guiwushengzhe-prog/gun-mouse/README.md

# 枪型飞鼠 · 第二代工程样机

当前配套交付为 `release/2026-10-18-最终版`。主板已迁移到嘉立创EDA专业版，后续统一在嘉立创中编辑、铺铜、检查和导出。

- 当前主板源工程：[嘉立创最终版](pcb/嘉立创最终版/枪型飞鼠最终版.eprj3)，打开时保留整个同名文件夹。
- 当前打板文件：[最终版上传打板压缩包](release/2026-10-18-最终版/枪型飞鼠_最终版_上传打板.zip)，由嘉立创原生工程导出。
- 当前打印件：[主体底座](release/2026-10-18-最终版/三维打印/主体底座.stl) 和 [摇杆支座](release/2026-10-18-最终版/三维打印/摇杆支座.stl)，各一件。
- 详细步骤：[下单与装配说明](release/2026-10-18-最终版/下单与装配说明.md)。原生工程、制板文件和打印件一并保存在最终交付目录。

下面保留早期第二代样机的设计说明；其中旧源文件和旧下单链接不再代表当前交付。

ESP32-S3 SuperMini、手焊载板和一件开放固定底座。使用手头的 SS-01GL 金属摆杆作左键，右键直接按微动本体，摇杆使用原生杆并保留中键。手指接触摆杆上的绝缘铜箔时启用体感移动，松开即停止。

第二代修正 SW1 的整组非对称孔位，保持摇杆轴心；增加直接焊在载板上的电源拨动开关，电池两根线也直接焊载板。取消塑料扳机、外置复位弹簧、调节螺丝、摇杆帽、外壳摇杆限位和粗握把。握持形状先用纸壳试，不额外打印握把。

| 目录 | 当前交付 |
|---|---|
| [pcb/](pcb/README.md) | 第二代载板：52×82 毫米、1.6 毫米厚、双面、全直插手焊；制板包、源工程、物料与接线表、1:1 套孔图、[三维预览](pcb/3d/gun-mouse-gen2.obj) |
| [shell/](shell/README.md) | 一件开放固定底座，电池与模块允许外露；手头右键帽原尺寸保留为可选件 |
| [firmware/](firmware/README.md) | 原固件与已编译镜像，鼠标按键、触摸许可和体感逻辑不变 |

## 下单与装配

1. 先将 [1:1 装配图](pcb/carrier-assembly-map-1to1.pdf) 按实际尺寸打印，用手头 SW1 从标示的安装面套孔。此次修正依据原厂孔图与第一代实物反馈，尚未进行第二代实物插装。
2. 上传 [第二代嘉立创制板包](pcb/gun-mouse-supermini-carrier-JLC-Gerber.zip)。常规 FR-4、双面、1.6 毫米、1 盎司铜；只做裸板，不做贴片装配。板框有缺口，以文件轮廓为准。
3. 只需新增打印 [开放底座](shell/stl/engineering_mount.stl)，毫米、100% 比例。手头旧小件不用重新打印；右键帽可留作后续手感试验。
4. 按 [载板说明](pcb/README.md) 焊元件与模块线，电池开关置关后通过 USB 烧录并检查，再固定到底座。SS-01GL 的公共端、常开端仍用两根软线接载板。
5. 金属摆杆上依次贴薄绝缘胶带、铜箔、表面绝缘胶带。铜箔只连接触摸焊盘，导线不牵拉摆杆；贴好后实测触摸和回弹。电池、模块固定及供电限制见 [底座装配说明](shell/README.md)。

## 版本与验收范围

当前目录只列第二代交付，第一代保存在 Git 提交 `9e3d071` 中。电路设计检查、名义几何检查与实物试装、通电验收分别记录，不能用软件检查代替摇杆实物插装、触摸灵敏度、充电和握持验收。
