guiwushengzhe-prog/gun-mouse/器件资料/README.md

# 器件资料索引

整理日期：2026-10-05。用户提供的两个资料包已完整解压，根目录原压缩包保留。

## 保存位置

| 目录 | 内容 |
| --- | --- |
| `原始资料/YD-ESP32-S3资料` | ESP32-S3 资料包原始目录，包含尺寸图、电路图、介绍和下载工具 |
| `原始资料/GY-601N1` | 模块说明、电路图、多个芯片手册及示例代码，保留包内原目录 |
| `参考图纸/ESP32-S3` | 公制及英制尺寸图、V1.4 电路图、三张厂家介绍/照片 |
| `参考图纸/GY-601N1` | 模块说明书、电路图及本版 LSM6DSV16X 芯片手册 |

原始解压资料共 564 个文件，约 118.5 百万字节。压缩包和原始解压目录留在本机，常用图纸、此索引、来源清单和设计配置纳入 Git（版本控制系统）。`资料来源.json` 记录原包及参考副本的 SHA-256（文件内容校验值），便于辨别来源和后续变更。整理只读取资料，未运行包中下载工具或向设备写入。

## 查尺寸先看这些文件

| 文件 | 可直接采用的资料尺寸 | 当前边界 |
| --- | --- | --- |
| `参考图纸/ESP32-S3/ESP32-S3-公制尺寸图.pdf`，第1页 | 主板57.15×27.94毫米；含伸出天线总长63.39毫米；排针行距25.40毫米 | 未给高度、独立安装孔或完整修订号；与手上板版本待匹配 |
| `参考图纸/ESP32-S3/ESP32-S3-英制尺寸图.pdf`，第1页 | 与公制图换算一致 | 英制标注不能当毫米直接读；孔径仍未给出 |
| `参考图纸/ESP32-S3/YD-ESP32-S3-电路图-V1.4.pdf` | 供电、接口及各元件连接 | 不能用电路符号位置推导机械位置；旧尺寸图局部封装与V1.4有差异 |
| `参考图纸/GY-601N1/GY-601N1-模块说明书.pdf`，第1～2页 | 标称17.8×20.6×2.8毫米；整板3～5V；模式与引脚 | 没有机械孔位和焊好排针后的总高；200次/秒描述板上角度输出 |
| `参考图纸/GY-601N1/GY-601N1-电路图.png` | 稳压及多个传感器版本的接口 | 不是尺寸图，不能从图上推算孔或板边 |
| `参考图纸/GY-601N1/LSM6DSV16X-芯片手册.pdf` | 当前惯性芯片参数与封装 | 芯片尺寸不等于整板尺寸；包内其他传感器不是本版选型 |

正式建模轴方向已确认：X 向前、Y 向左、Z 向上，单位毫米；原点在整体布局时统一确定。名义尺寸和实物测量分开保存。未知整板高度、接线、插头及孔位不补写猜测数据。

普通 PS2 摇杆、TTP223 模块、700mAh 电池、充电升压板没有仅凭这些名称就能套用的统一整件尺寸；芯片、针距和插口标准不能代替整件资料。SS-01GL 则有完整型号的原厂轮廓图，可以按图做名义候选件，最终支架仍须匹配实物后缀。

当前低成本触摸原型采用 SS-01GL、铜箔电极和 ESP32-S3 内置电容触摸，省去 TTP223；机械左键与触摸是独立输入。本轮内部图先按小打印帽内贴铜箔探索，制造结构尚未冻结。详细来源、待测项和方案判断见 `../docs/器件参数与待实测清单.md`。
