guiwushengzhe-prog/gun-mouse/deliverables/经济型单板自焊版/README.md

# 枪型飞鼠：单板经济型，扳机开关自焊

这是本轮推荐询价版本，替代相邻的 `经济型工厂代焊版`。相对那一版有六处改动：

1. **取消扳机小板，只做一款主板**，省掉第二款的多款板费。扳机开关 SS-01GL 改为你自购，焊两根线后装在打印支架上，支架插进原小板卡槽。
2. **充电灯 LED1/R4 恢复安装。** 充电状态输出只接这颗灯，主控读不到；两套只多约 1.2 元。
3. **充电电阻 R3 改为 5.1k**，与 R1/R2 同料，少一种物料；充电电流从约 176mA 提到约 235mA，700mAh 电池充满从约 4 小时缩短到约 3 小时。首件要测充电温度，见下文。
4. **USB 静电保护 U4 不装。** 免换料的 SRV05-4 国内库存不够，不为它多花 20 元。板上 D+、D− 原本就有铜线把 U4 的 1–6、3–4 脚连通，不装时 USB 充电和下载照常；代价是 USB 口没有静电保护，插线前先摸一下金属物体放掉身上的静电。以后想加，把原设计的 USBLC6-2SC6（C7519）焊到同一位置即可。
5. **扳机调节触点改用市售 M2×10 内六角圆柱头螺钉**（原 M2 外六角螺栓电商难买），用 1.5 毫米内六角扳手调节。扳机的螺钉头槽和导孔已相应修改。全机螺丝统一为 M2×10、M2×20 两种杯头内六角。
6. **三个 PH2.0 插座 J3/J4/J5 不装**，电池、扳机开关、触摸电极的线直接焊到原焊盘上。三个座是同一种扩展料，全部不装才能省掉一种 20 元的换料费。网购电池一般自带两根裸线，直接焊比另接 PH 插头省事，也不会遇到插头正负极与板子相反的问题。

主板铜线、过孔、焊盘和外框与之前的单主板研究版 v2 逐层一致，没有改布线。固件未改。

规则检查和三维配合检查属于文件验证；开关动作、打印公差、模块通信、充电温升和蓝牙效果还要靠首件验证。经济型能否接单、实际价格，以新订单匹配和审核结果为准。

## 上传这三个文件

只用本目录 `制板文件` 中的文件新建订单，不要套用旧订单的生产稿：

1. `gun-mouse-economy-single-v4-Gerber.zip`：制板文件，只有主板一款。
2. `gun-mouse-economy-single-v4-BOM.csv`：物料清单，每套 19 组、36 个工厂安装器件。
3. `gun-mouse-economy-single-v4-坐标文件.csv`：对应安装位置与角度。

两个 CSV 沿用设计软件输出的 UTF-16 制表符格式，直接上传，不要用表格软件重新保存。

| 网页项目 | 怎么填 |
| --- | --- |
| PCB | 2 层、1.6 毫米、普通 FR-4、绿油白字、普通铜厚与表面处理 |
| 款数/拼板 | **单款单板**，铣外形及内部过线槽，**不要 V 割**，不要加扳机小板 |
| 焊接数量 | 其他数量：2 套（此前页面显示最低 2），其余光板随单发货 |
| 焊接层 | 只贴顶层 |
| 应用行业 | 消费电子 |
| 产品类型 | 选经济型；若经济型不可选，不付款、不生产，先按提示查具体器件或工艺原因 |
| 生产时间 | 普通交期，不加急 |
| 确认 DFM | 可保留 3 元可制造性确认 |
| 个性化服务 | 无；不买整盘，不加喷涂、灌胶或程序烧录 |

匹配物料时重点看两处：

- **LED1** 会提示"封装与 0603 不符"：BOM 里的 `LED-SMD_L1.6-W0.8` 就是 1.6×0.8 毫米，即 0603，确认即可；颜色选红色。
- **R3** 应与 R1、R2 同为 5.1kΩ / C25905，三个位号合成一行。

可粘贴到订单中的备注：

> 本单为单款主板，铣外形及内部过线槽，不做V割，不含扳机小板。申请经济型、只焊顶层，按物料和坐标安装每套36个器件。U1、R10、R11、R12、C7、C8、J3、J4、J5、U4不装。J1/J2排母、SW1摇杆、SW2右键及USB1固定脚完整焊接。扳机开关、陀螺仪模块、电池和触摸线由用户自行焊接。如经济型不能接，请注明具体器件或工艺原因，并列出费用明细。

## 费用怎么变

和你此前两套标准型报价逐项对比。本版一栏按 2026-10-07 下单页实际报价（删除 U4 前元件费 41.75、加工费 147.2）减去 U4：

| 报价项目 | 原报价，元 | 本版，元 | 说明 |
| --- | ---: | ---: | --- |
| 工程费 | 150 | 50 | 经济型工程费 |
| 拼板费 | 150 | 0 | 只剩一款主板 |
| 换料费 | 168 | 60 | 原为标准型 8 元/种 × 21 种贴片料；经济型基础库免费，只剩 USB1、U3、SW3 三种扩展料各 20 元；U2 实际免换料 |
| 钢网费 | 50 | 0 | 经济型不收 |
| X 光检查 | 20 | 0 | 原 U1 已不装，实际报价没有这一项 |
| 包装费 | 3.07 | 0 | 经济型不收 |
| 贴片焊盘费 | 2.8 | 1.88 | |
| 插装焊盘费 | 12.8 | 12.2 | 穿孔焊点 0.1 元/点，每套 61 点；扳机开关改自焊，少 6 个焊点 |
| 插装工程费 | 20 | 20 | 有穿孔插件就每单收一次 |
| 确认 DFM | 3 | 3 | |
| **加工费小计** | **579.67** | **147.08** | |
| 元件费 | 172.54 | 约 41 | 实际 41.75，删 U4 后略降 |
| **合计** | **752.21** | **约 188** | 工程费、拼板费、换料费三项从 468 降到 110；另有可选的氮气焊接 5.2 元，不需要 |

以上只是 SMT 订单。光板费在先下的 PCB 订单里另算。

插装焊接工程费和插装焊盘费是给穿孔插件收的：开发板两排 22 针排座、摇杆、右键，以及 Type-C 座的 4 个固定脚。要省这 32.2 元，只能这些全部自己焊、自己买料，对新手不划算，所以保留。

下单前按公开经济型规则做的推算明细（加工费与实际报价一致，元件费实际更低）：

| 项目 | 推算，元 |
| --- | ---: |
| 器件：原两套 172.54 − U1 41.86 − 原 SW4 62.60 − R10/R11 0.33 − J6 2.91 − J3～J5 8.72 | 56.12 |
| 工程费 | 50 |
| 普通扩展贴片料上料：USB1、U3、SW3 三种 × 20 | 60 |
| 插件工程费 | 20 |
| 插件焊点 61 个/套 × 2 × 0.1 | 12.20 |
| 贴片焊点 94 个/套 × 2 × 0.01 | 1.88 |
| 可制造性确认 | 3 |
| 多款板费 | 单款，0 |
| **合计** | **约 203** |

另需自购：SS-01GL 两只约 5～9 元，M2 杯头内六角螺丝与螺母约 10～20 元，细导线一卷。不再需要 PH2.0 线。光板、打印、运费、可能的 X 光检查另计。

和工厂代焊小板版（恢复充电灯后约 314～364 元）比，本版约少 **100～155 元**。主要来自多款板费 50～100 元；J3～J5 和 U4 不装省换料费 40 元和座子约 9 元；另有开关代焊约 9 元、J6 约 3 元；扣掉自购开关约 5～9 元。明细见 `检查报告/费用推算-单板自焊.json`。

下单页实际换料费 60 元，说明 U2（TP4056）免换料。

## 充电电流 235mA 的首件检查

TP4056 是线性充电，芯片发热约等于（5V − 电池电压）× 电流。5.1k 时，电池 3.3V 约 0.40W、3.8V 约 0.28W；6.8k 时分别约 0.30W 和 0.21W。700mAh 电池按 235mA 充约 0.34C，在常规 0.5C 以内。

需要注意的是，主板没有铺铜，充电芯片离电池约 2 毫米，电池温度检测也没有接。所以首件必须按下面的方法测一次温度：

1. 用电量较低的电池（3.5V 左右），合好外壳，插 USB 充电。
2. 充 20～30 分钟后，测电池外表面和充电芯片附近外壳的温度。
3. 电池表面不超过 40℃ 即可正常使用。超过 40℃ 时停止充电，把 R3 换回 6.8k（0402 电阻），或在外壳打开、通风良好的情况下充电。

## 外壳和到手装配

`打印文件` 中的 STL 用于打印，STEP 用于改尺寸。要用本目录的 **左半壳-单板自焊、右半壳-单板自焊、扳机-经济型、扳机开关支架-SS01GL**，以及 GY 模块压框、右键帽、触摸面盖、摇杆帽和三片设定片。不要用工厂代焊版的左右壳：那两件的卡槽前移了 1.9 毫米，插不进支架。

建议用 PETG，0.4 毫米喷嘴、0.2 毫米层高。支架卡板面朝下打印，4 圈壁，凸台附近实心。半壳约 180×139 毫米，平台至少 200×150 毫米。设定片打印后量厚度，误差控制在 ±0.05 毫米以内。

要另备的螺丝已统一成同一种：**M2 杯头内六角（GB70.1 / DIN912）**，只要两种长度，可以在同一家一次买齐（下表是每套用量）：

| 规格 | 每套数量 | 用在哪 |
| --- | ---: | --- |
| M2×10 杯头内六角 | 3 | 扳机调节触点 1、GY 模块压框 2 |
| M2×20 杯头内六角 | 9 | 合壳 7、开关支架 2 |
| M2 六角螺母 | 2 | 开关支架 |
| 1.5 毫米内六角扳手 | 1 | 以上螺丝通用 |

选头径不大于 4 毫米、头厚不大于 2 毫米的，304 不锈钢或碳钢均可。外壳和压框上的螺丝孔是 Ø1.7 导孔，M2 机牙螺丝直接拧进去自攻：第一次会比较紧，拧到贴合、不晃即可，不要用力过猛，以免把塑料螺纹拧滑。

其他要另备：

- 扳机：SS-01GL 1 只；压缩弹簧 1 根（外径 4、线径 0.3、自由长 15 毫米，可搜"压缩弹簧 外径4 线径0.3 长15"）；铜箔胶带一小块（贴在扳机前面的凹槽里做触摸电极）。
- 导线：细硅胶线一卷（外径不大于 0.6 毫米，例如 30AWG，约 1 米）。GY 模块 4 根加 1 根短接线、扳机开关 2 根、触摸电极 1 根，都用这一卷。
- 电池：3.7V 锂电池，**带保护板**，自带两根线即可，不需要 PH 插头。
- 辅料：热缩管、细扎带、绝缘胶带少量。

电池连保护板和线头须小于 31×52.5×8.4 毫米的仓体并留间隙。扳机弹簧工作长度约 13.1～9.0 毫米，压到底不能并圈顶死。

主板上要焊的都在主板放进外壳**之前**焊好，焊接时开发板不插，USB 不插，电源开关 SW3 拨到关。

1. 焊扳机开关：两根细导线焊到 SS-01GL 的 COM 和 NO，NC 不接。用螺钉把开关固定在支架上，注意摆杆自由端朝支架底部。详细步骤和示意图见 `扳机装配与调整.md`。
2. 焊 GY 模块：模块四根线和一根地址短接线，接法见下表和 `GY模块适配说明`。
3. 焊扳机开关线到 **J4**：J4 不装插座，留下两个长条焊盘，两根线各焊一个，不分正负。线长要够，调螺钉时支架还要能提起来。
4. 焊触摸电极线到 **J5**：J5 的两个焊盘是同一个信号，焊任意一个即可。
5. 最后焊电池到 **J3**，按下面的"焊电池"步骤做。
6. 右壳内依次装电池、支架、弹簧、扳机、主板。电池线从主板的电池过线槽穿过。
7. 合壳前按 `扳机装配与调整.md` 用 0.8/1.0/1.2 毫米设定片调整触点。
8. 取出设定片，装右键帽、模块压框、左壳、摇杆帽，合壳后再查一次：按到底导通、松开复位。

**焊电池（J3）**。锂电池两根线一旦碰在一起就会短路，所以每一步只处理一根线：

1. 先分清 J3 的正负极：万用表打到导通档，两个长条焊盘里，和 USB 口金属外壳导通（会响）的是**负极**，另一个是**正极**。用记号笔在板上标出来。
2. 电池通常红线为正、黑线为负。用万用表直流电压档再确认一次：红表笔接红线、黑表笔接黑线时，读数应为正的 3～4.2V。
3. 先给 J3 的两个焊盘各上一点锡。
4. 电池线要剪短时，**一次只剪一根**，不要用剪刀同时剪两根。剪好的线头先用胶带包住，焊哪根再拆哪根。
5. 先焊负极线：剥 2 毫米、上锡，贴在负极焊盘上，烙铁加热 2～3 秒焊好。再用同样方法焊正极线。烙铁不要在焊盘上停太久，以免焊盘翘起。
6. 焊好后电池线用扎带或一点热熔胶固定在过线槽附近，不要让线拉扯焊盘。
7. 把电源开关拨到开：插上开发板后，开发板电源灯应亮。

| 主板 J1 背面通孔 | 模块芯片接口 | 含义 |
| --- | --- | --- |
| 1 脚 | 1 脚 VCC | 3.3V |
| 22 脚 | 2 脚 GND | 地 |
| 15 脚 | 3 脚 SCL | 时钟，IO9 |
| 12 脚 | 4 脚 SDA | 数据，IO8 |
| — | 5 脚 SA0 短接 2 脚 GND | 地址 0x6A |
| — | PS 模式脚悬空；CS 保持模块原上拉 | 使用芯片直接接口 |

模块自带总线上拉和本地滤波，所以主板 U1、R10、R11、R12、C7、C8 都不装，也不需要补焊。

## 使用逻辑保持原样

固件未改：

- 手指轻贴扳机启用体感移动，不触发点击。扣扳机为左键按下，扣住保持，松开释放。
- 松开机械扳机但手指仍贴着时，体感继续；手指离开后体感停止并清除积压。
- 侧键是右键，摇杆按下是中键，推摇杆移动光标，幅度越大越快。摇杆和体感位移相加。
- 插拔充电线不会自动暂停鼠标操作。
- 插 USB 充电时，充电灯亮表示正在充电，灯灭表示已充满。
- U4 没装，USB 口没有静电保护：插线前先摸一下金属物体，干燥季节尤其注意。

首次使用：

1. 单独给开发板烧录 `固件/gun_mouse.ino.merged.bin`，Windows 用原烧录工具写到地址 0x0。
2. 把开发板插回主板。上电时手指离开触摸面、摇杆回中，放稳约 3 秒自动校准。
3. 电脑蓝牙添加 **GunMouse EVT-A**。
4. 方向、速度或触摸门限需要调时，用串口命令 `log`、`jdir/jsave`、`invx/invy`、`sens`、`tp/tr`。

开发板插在主板上时，不要同时从开发板自己的 USB 口供电。

## 已核对和仍需首件确认

`检查报告` 中保存了以下核对结果：

- **电路板**：U1、R10、R11、R12、C7、C8、J3、J4、J5、U4 不装；原理图与电路板的器件身份、通道关联、不装属性、料号逐件一致；46 个器件的引脚网络与正式板逐脚一致；规则检查 0 项；Gerber 与单主板 v2 逐层图形一致。
- **扳机与外壳**：支架、开关、螺钉、尾线与左右壳及主板无实体干涉；扳机全行程和调节螺钉全调节范围无碰撞；支架合壳后六向限位。
- **左壳**：与已通过 GY 模块适配检查的左壳为同一实体。
- **固件**：与原工程样逐文件一致。

文件核对不能代替实物验收。首件重点确认：

- 开关动作和复位、支架入槽与打印配合；
- 模块通信和方向、触摸门限；
- USB 插拔、**充电温度（R3 已改 5.1k）**、蓝牙效果。

主板原有的 USB 长走线、无铺铜、电池温度检测未接等限制仍然存在。
