guiwushengzhe-prog/gun-mouse/deliverables/pcb-shell-v1/README.md

# 枪型飞鼠 PCB 与外壳 V1：交付说明

日期：2026-10-05；装配分工补充：2026-10-06。设计说明和改动理由见 `docs/PCB与外壳-V1.md`；全部尺寸与网络来自 `config/pcb-shell-v1.json`。采购与工厂询价使用 `docs/工厂装配与交付要求-V1.md`，里面逐项覆盖本版 48 个板上器件和板外组件。

本交付用于首轮打样，以完整装配和尽量少手工焊接为目标。文件检查不能保证首轮打印一次装配成功，也不代表可直接量产；开发板、电池、打印公差、扳机动作和工厂装配范围仍需核对。原设计保留在 `claude/pcb-shell-v1`；本轮收尾在独立分支 `codex/pcb-shell-finish`，以基线 `dff2043` 保留原成果。

2026-10-06 预审已确认当前扳机/右键的固定行程缺少覆盖全公差的保证，USB 数据线也需重新布局。下单前先按 `docs/设计预审与优化决策-V1.md` 关闭这些设计问题，不能只因以下软件检查通过就认为整机方案已定稿。局部改件候选单独保存，没有覆盖本目录原六件打印包。

## 目录

| 位置 | 内容 |
| --- | --- |
| `制板文件/gun-mouse-v1-Gerber.zip` | 嘉立创下单用 Gerber（主板与扳机小板拼在一起，邮票孔连接） |
| `制板文件/gun-mouse-v1-BOM.csv` | 贴片/插件器件清单（含立创编号） |
| `制板文件/gun-mouse-v1-坐标文件.csv` | 贴片坐标（CPL） |
| `制板文件/gun-mouse-v1-网表.enet` | 网表（连接关系） |
| `打印文件/STL/` | 6 个打印件，已按推荐打印姿态摆好 |
| `打印文件/STEP/` | 同样 6 个零件的实体文件（整机坐标） |
| `整机装配/枪型飞鼠整机装配.step.zip` | 整机装配实体（解压后约 100MB）：外壳、机构件、主板（含器件模型）、扳机小板、开发板与电池参考体 |
| `检查报告.md` | 规则检查、校验值、干涉与限位检查（自动生成） |
| `验证记录/` | 收尾时的规则检查、网表核对、实体网格、原设计比较和文件校验记录 |
| `预览图/` | 离屏渲染的检查图 |
| 仓库 `pcb/gun-mouse-v1/` | 嘉立创专业版工程（PCB 与同网表原理图），可直接打开 |

## 一、要打印的零件（6 件）

| 零件 | 文件 | 摆放 | 说明 |
| --- | --- | --- | --- |
| 左半壳 | `左半壳.stl` | 外表面朝下 | 摇杆开口、右键开口、压板螺柱 |
| 右半壳 | `右半壳.stl` | 外表面朝下 | 主板螺柱与沉头孔、电池仓、扳机小板卡槽、扳机滑道 |
| 扳机 | `扳机.stl` | 侧面朝下 | 滑杆后部有弹簧孔，前面有铜箔凹槽 |
| 扳机触摸面盖 | `扳机触摸面盖.stl` | 平躺 | 0.9 毫米薄片，盖在铜箔外面 |
| 右键帽 | `右键帽.stl` | 帽面朝下 | 翻边悬垂 1.4 毫米，一般无需支撑 |
| 摇杆帽 | `摇杆帽.stl` | 帽面朝下 | 双削边孔（Ø4.2、对边 3.2，匹配 Ø4/对边 3.0 的轴）竖直朝上，尺寸更准 |

建议 PLA 或 PETG，0.4 毫米喷嘴，层高 0.2，3 圈壁，填充 20%。两半壳打印尺寸约 180×139 毫米，需要 ≥ 200×150 的打印平台。半壳边缘是半径 6 的圆角，贴床的那几层略有悬垂，一般不加支撑也能打印；底部 Type-C 口和开关槽在竖直壁上，顶边是几毫米的小桥接。摇杆帽孔偏紧或偏松时，改 `config/pcb-shell-v1.json` 里的 `joystick.knob.d_hole_clearance` 后重新生成，只需重打帽子。

## 二、要购买的东西

### 1. 嘉立创（PCB + 贴片 + 插件）

- 上传 `gun-mouse-v1-Gerber.zip`：2 层、1.6 毫米、1oz（每平方英尺一盎司铜）、绿油白字。当前文件含主板和扳机小板，两款电路用两处邮票孔拼在一起；如制作 5 个现有拼板，可得到 5 套主板与小板。实际焊接套数另行选择。按工厂确认填写拼板与款数，不能因为连成一块就省报第二款。[嘉立创制造工艺要求](https://www.jlc.com/portal/1/serviceGuide)明确按不同电路、板形等计算款数。
- 选 SMT（表面贴装）及所需插件焊接，全部器件安装在顶层，上传 BOM（物料清单）与坐标文件。现有清单为 24 组物料、48 个器件；可贴库存、基础库/扩展库分类及缺料情况以本次匹配结果为准。请工厂先确认异形拼板的工艺边、定位和焊接工艺，未经确认不把这些文件视为已可下单。
- 本版不铺铜：地线和电源线都用导线连通（电源与地 0.3 毫米，信号 0.15 毫米），嘉立创规则检查无间距和连通错误。若在界面里打开工程后想加铺铜，可自行添加并重铺，再重新导出 Gerber。
- 向工厂确认 J1、J2（22P 排母）、SW1（摇杆）、SW2（右键 D2FC）、SW4（扳机 SS-01GL13，在扳机小板上）的 64 个通孔焊接位置，以及 USB1 的 12 个贴片焊盘和 4 个有铜槽孔固定脚。SW3（电源拨动开关 MSK12C02-HB）也必须装好：现库的 3 个电气焊盘与 4 个外壳固定焊盘均为顶层贴片，不能因封装名称含 `TH` 就误当直插或漏掉固定焊盘。全部 48 个器件及固定脚均由工厂确认承接、完成后，才按免焊装配准备。
- 同时询价分板、毛刺处理和分套包装，优先收取已分开的主板与扳机小板，避免自己掰板、磨板边。官方有[分板出货服务](https://www.jlc.com/portal/q7i40512.html)，本版邮票孔及去毛刺能否一起承接仍须确认；预制线束、触摸电极、烧录及整机装配也需要单独询价，不能视为普通贴片订单已包含。
- 如果某个器件缺货：先要求工厂返回缺料位号、可供型号及差异。排母须核对针距、22P 位置、8.5 毫米高度、外形、插针匹配及孔径；不能只凭针距和高度任意替换。U1 暂不贴、改接 GY-601N1 是非免焊的临时调试分支（见第七节），不能把少贴的板当作完整交付。摇杆 RKJXV1224005 已被原厂列为新设计不推荐型号，首样保留，批量前需确认供应与替代方案，不能直接换普通 PS2 模块。[Alps 原厂产品页](https://tech.alpsalpine.com/e/products/detail/RKJXV1224005/)

### 2. 淘宝 / 京东

| 物品 | 数量 | 用途 |
| --- | --- | --- |
| 3.7V 700mAh 锂电池，603048 型，带保护板和 PH2.0 插头 | 1 | 电池参考；连保护板、线头实际尺寸需核对。8×31×52.5 毫米是占位上限，31 毫米宽电池与 31 毫米仓名义上没有侧向间隙，实际选型要留侧向余量；8 毫米厚度仅余约 0.4 毫米，不能另加 1～2 毫米泡棉 |
| PH2.0 2P 双头端子线，10 厘米为首样备选 | 1 | 扳机小板 J6 ↔ 主板 J4；两根线只接机械开关，同向或反向均可。实际长度须结合走线确认，不能把该结论用于电池线 |
| PH2.0 2P 单头触摸线，优先购买预制铜箔电极线组件 | 1 | 扳机铜箔 ↔ 主板 J5；10 厘米为首样备选，最终线长、线径、铜箔尺寸和端接位置须确认；J5 两脚都是触摸信号，闲置线端须绝缘 |
| M2×20 盘头自攻螺丝（PA2×20） | 7（建议买 20） | 合壳并夹紧主板 |
| 压缩弹簧：外径 4、线径 0.3、自由长 15 毫米为首样参考 | 1 | 扳机复位；需供应商确认工作长度约 13.1/9.0 毫米时的载荷及并圈高度（弹簧压实后的高度），首件确认后购买同规格成品；圈数、材料和刚度尚未确定 |
| 导电铜箔胶带，宽 5～10 毫米 | 1 卷 | 扳机触摸电极 |
| EVA 双面泡棉胶，厚 1～2 毫米 | 少量 | 仅用于约 6 毫米厚电池的固定，核对装配总厚度不超过 8.4 毫米；不用在触摸面盖下 |
| 薄胶层或薄型双面胶 | 少量 | 固定触摸面盖；铜箔、胶层及线头叠层需核对，面盖以外余量约 0.15 毫米 |

已有、继续使用：YD-ESP32-S3 开发板（焊好排针）。原 DZYJ 摇杆模块、GY-601N1、SS-01GL 单件、充电升压板本版都不再需要，可留作备件。

## 三、要焊接的东西

- 工厂确认并完成全部 48 个器件、SW3 的固定焊盘及 USB1 混合封装的焊接，且已采购带插头的电池和预制触摸线时，到手只需插接和机械装配；工厂未承接的部分必须提前写入交付差异，不能发货后才让用户补焊。
- 不选插件服务时，J1/J2 排母（共 44 点）、SW1 摇杆（14 点）、SW2（3 点）、SW4（3 点）合计 64 点需另行焊接；USB1 另有 4 个通孔固定脚需确认。SW3 是 7 个顶层贴片焊盘，不计入上述 64 点；贴片订单也必须覆盖它全部的信号与固定焊盘。优先让工厂完成，不把这些焊接作为用户默认任务。
- 电池若只有裸线：需要压接 PH2.0 端子或焊一个插头，所以建议直接买带插头的电池。
- 触摸电极优先请线束供应商或装配方预制，与扳机和面盖一起试装；端接须有可靠导通和导线固定。裸线夹在两层铜箔之间仅保留为首样实验接法，不作为成品交付工艺；普通线头或焊点可能超过面盖下约 0.15 毫米余量，若移到上沿导线槽仍放不下，需要局部改设计。

## 四、装配顺序

1. 收取已焊好、已分板、已处理毛刺的主板和扳机小板，各一件；核对器件和接口。未购买分板服务时，由承接该工序的装配方按已确认方式处理，避免让新手直接掰已焊器件的板。
2. 先单独上电试板：开发板插到 J1/J2 排母上，天线朝板外；用 Type-C 线连底部 USB1；核对 SW3 开关位置。底部 USB 已按下载接口布线，仍须验证对应固件、烧录步骤和实际 USB 通信；板上有接口不等于已经有可用固件。若购买烧录服务，请在出货记录中注明版本和测试结果。
3. 电池供应商按 J3 的 1 脚 +（丝印 BAT+）、2 脚 - 提供线束并标注极性；插接前用万用表复核。反极性的线束优先换成正确预制件，不让用户默认剪线或挑端子改线。
4. 右半壳平放（内侧朝上）：
   1. 测量电池含保护板、线头的实际长宽厚度，再选固定材料：电池仓宽 31 毫米，电池不能以占位上限作零间隙硬塞。仓深 8.4 毫米，约 6 毫米厚电池可配 1～2 毫米泡棉；接近 8 毫米厚时只剩约 0.4 毫米，不能另加该厚泡棉。放进电池仓，插头一端朝上，从电池仓上方缺口引出；
   2. 扳机小板（元件面朝前，SS-01GL13 杠杆朝扳机方向）顺着两条卡槽插到底；
   3. 弹簧放进扳机滑杆后部的孔里，扳机从外向内放入右半壳的窗口，使滑杆落在导轨上；
   4. 主板元件面朝上放到螺柱上，电池线从主板过线槽穿到正面，插 J3；开发板插上。
5. 接线：PH2.0 双头线连接扳机小板 J6 和主板 J4；预制触摸电极线接 J5，沿滑杆顶面的线槽走。约 5 毫米活动余量只是首样起点，须覆盖扳机全行程，不能拉动电极端接或夹在滑道、壳缝、螺柱中。
6. 优先安装已预装电极与触摸面盖的扳机组件；自行做首样时，铜箔贴在凹槽里，以薄胶层固定面盖。面盖以外叠层余量约 0.15 毫米，要将铜箔、胶层及端接一起试装，不使用 1～2 毫米泡棉。放不下时反馈并调整局部结构，不能强压合盖。
7. 右键帽从左半壳内侧插入开口。
8. 合上左半壳，从右侧拧入 7 颗 M2×20 自攻螺丝；不要拧得太紧，以免螺柱滑丝。
9. 装摇杆帽：对准轴上的削边，从外面压到底。
10. 功能检查：逐项确认扳机触点是否实际闭合、是否由外壳硬限位承受按压、松手是否能回弹；再检查摇杆连续摆动与按下中键、右键动作。当前扳机限位不能保证所有公差下都触发，见第七节；未闭合时停止按压并反馈实测，不强压微动补行程。最终固件下还需检查触摸启停、左键独立释放、蓝牙配对及 IMU（惯性传感器）输出；这些产品功能不由普通贴片或裸板通断检查自动保证。

## 五、引脚（给固件）

| 引脚 | 功能 |
| --- | --- |
| IO4 / IO5 | 摇杆 X / Y（ADC1） |
| IO6 | 摇杆按下（中键，低有效） |
| IO15 | 右键（低有效，3.3k 上拉） |
| IO16 | 扳机机械左键（低有效，2.2k 上拉） |
| IO14 | 扳机铜箔电容触摸（TOUCH14） |
| IO8 / IO9 | I2C SDA / SCL：LSM6DSV16X，地址 0x6A |
| IO10 / IO11 | LSM6DSV16X INT1 / INT2 |
| IO1 | 电池电压 ÷2 |
| IO2 | USB 插入检测（VBUS ÷2；校准后模拟采样，不依赖数字高电平） |
| IO19 / IO20 | 原生 USB D- / D+（底部 Type-C） |

## 六、检查结果

见同目录 `检查报告.md`（脚本自动生成）：嘉立创设计规则检查结果、导出文件校验值、各打印件尺寸、整机干涉检查和限位反向验证。

本轮已修复原理图短引线方向、器件唯一编号及同步属性问题。配置、软件编译原理图和导出 PCB 网表的 48 个器件、160 个已连接引脚及采购身份核对一致；现场嘉立创最终设计规则检查为 0 条错误。详细证据见交付目录 `验证记录/` 与自动生成检查报告。

以上是文件和模型层面的检查。首件 PCB 上电、充电与 USB 通信，实体装配、开关动作、打印配合及握持体验尚需实物验收。

## 七、已知限制

- 工程已有可由软件编译、与 PCB 核对一致的原理图。原开发会话曾遇到原生自动布线挂起和覆铜计算失败；后续兼容入口、覆铜及极短线写回验证见 `docs/正式PCB与外壳程序验证结果.md` 和 `docs/自动布线写回修复结果.md`。专用自动布线接口仍有边界，但不影响保留本目录已完整连通的正式方案；原生自动布线试验的六个漏接没有带入交付。本版保留原无覆铜设计，后续修改电路时须重新同步、核对并导出。
- 惯性芯片轴向：芯片在主板上平放，芯片 Z 轴指向整机左侧（+Y）；X/Y 与整机轴的对应和正负号请在固件首次运行时静置和转动标定。
- GY-601N1 备用接法：嘉立创缺 LSM6DSV16XTR 时，可以不贴 U1，把 GY-601N1 的 VCC、GND、SCL、SDA 用细线焊到 R11/R10 的 3.3V 与信号端、C7 的接地端（需要手工焊接，仅作临时调试）。
- 扳机几何：静止触点距小板面 17.0 毫米，硬限位处 12.9 毫米，行程 4.1 毫米；微动动作位置范围为 12.8～14.4 毫米。晚动作个体可能差 0.1 毫米，早动作个体又超过原厂最小保证余行程，因此不能只加 0.1 毫米当修复。右键固定推杆也存在同类公差边界。具体可调整触点/柔顺传力方案待选定，当前原件保留作比较，见预审决策文件。
- 摇杆帽当前为双削边孔（圆孔径 Ø4.2 毫米、对边距 3.2 毫米），对应 Ø4/对边距 3.0 毫米的轴；打印配合尚需实测，不能保证现有设置一次打印就合适。
- 天线、触摸灵敏度、扳机手感、握持舒适度和重心都需要实物测试；整机模型的干涉检查不能代替这些测试。
- 进一步预审和局部结构候选见 `docs/设计预审与优化决策-V1.md`；摇杆背部支撑、触摸端接避让等候选不代表已替换本目录的正式打印包，仍需首件验证。
- 正式可烧录固件尚未交付；已生成引脚接口和硬件无关交互参考核心，见 `docs/固件接口与交互契约-V1.md`。USB 插拔没有自动暂停/恢复鼠标规则。使用开发板自身 USB 进行单板烧录前，应从主板排母拔出开发板；只关闭 SW3 不会隔离两路稳压输出。
