guiwushengzhe-prog/gun-mouse/docs/V1-Concept-01-设计输入.md

# 枪型飞鼠 V1-Concept-01：当前设计输入

记录日期：2026-10-05。统一单位：毫米。当前阶段：概念外观及器件参数调查，正式器件清单和制造尺寸未冻结。

## 当前交互

右手单手握持、手枪外形、低功耗蓝牙鼠标。IMU（惯性测量单元，即加速度计和陀螺仪）负责精细瞄准，普通 PS2 五针电位器摇杆负责连续大角度转向，摇杆按下为鼠标中键。

| 食指状态 | 体感移动许可 | 机械左键 |
| --- | --- | --- |
| 未接触扳机 | 关闭 | 由微动开关独立决定 |
| 轻触扳机表面，未按压 | 开启 | 释放 |
| 继续按压，微动闭合 | 开启 | 按下 |
| 松开机械按压，但仍接触 | 开启 | 释放 |
| 完全离开扳机 | 关闭 | 由微动开关独立决定 |

触摸与机械点击是两个独立输入。关闭体感时丢弃待发位移；关闭期间不积累位移，重新接触时不集中发送旧位移。实体左、右、中键和摇杆功能不依赖体感许可。此处描述的是软件目标，尚未编写或验证本项目固件；真实抬指响应包含检测器延时，需实测。

独立右键先放在右手拇指可接触的控制区；鼠标“右键”指功能，不要求装在外壳右侧。用户已说明主要单独点击，不要求持续按住右键并同时推动摇杆。最终位置通过握持测试确定。中指、无名指、小指用于稳定握持。

当前不使用握把触摸区、轨迹球、触摸滑动、实体滚轮或新增功能按键。第一版明确使用已购普通 PS2 模块，不采用购物记录中的 PS4/PS5 摇杆或磁阻摇杆。

## 器件状态

| 器件 | 当前状态 |
| --- | --- |
| 优信 ESP32-S3-N16R8 焊排针开发板 | 已有；本轮原型采用，其内置电容触摸检测连接铜箔 |
| nRF52840 | 未来候选；未确定模块、开发板及封装，本轮不装 |
| 广运 GY-601N1-LSM6DSV16X 模块 | 已有；优先保留，厂家说明书尺寸已取得，安装孔及含排针高度待核对 |
| DZYJ 普通 PS2 五针黑板摇杆 | 已购；本版采用，独立安装座 |
| SS-01GL | 用户当前低成本扳机原型采用此型号；完整后缀及到货状态待核对 |
| SS-01GL111 | 保留的长柄备选；当前原型优先使用 SS-01GL |
| 现有 TTP223 蓝色三针模块 | 用户决定本轮省掉，仅保留已有库存记录 |
| AT42QT1011 | 历史触摸检测备选，未采购，本轮不装 |
| 3.7V、700mAh 锂电池 | 已有；原型测试和占位对象，实体尺寸待测 |
| 现有 Type-C 充放电及 5V 升压模块 | 原型资源；完整型号未知，最终充电与稳压架构待验证 |

不把候选器件写成已采购或最终选定。

## 外形与坐标

探索包络初值：长 180、最大厚 40、高 135 毫米。允许探索范围分别为 160～200、35～50、120～150 毫米，以真实电子器件、握持及装配要求为准。普通壳壁厚先探索 2～2.4 毫米；触摸面独立做多种厚度测试件。以上均不是制造定稿。

用户已于 2026-10-05 确认采用右手坐标系：X 向前、Y 向左、Z 向上。PCB（印制电路板）、所有模块、支架和外壳在正式建模时必须共用这些轴方向及同一原点；原点位置在整体布局时确定。

## 结构约束

1. 左右可拆卸半壳，优先螺丝连接；螺丝柱、孔位和公差在实际工艺及样件确认后确定。
2. 触摸扳机帽、电极和微动固定件独立可维护。外壳机械限位承担过行程力，不能由微动开关承受全部手指压力。
3. 本轮按小打印扳机帽内侧贴铜箔探索，电极随帽移动，短柔性引线经转轴附近活动余量直接连接 ESP32-S3 专用电容触摸通道。不装 TTP223 或其他独立触摸检测板。结构与触摸参数仍需实物验证。
4. 惯性传感器设置独立刚性固定区域，避免直接承担扳机或壳缝的连接应力。其具体位置待结构和振动评估。
5. 普通 PS2 摇杆设置独立安装座；以后通过重做局部支架适配其他型号，不保证直接互换。
6. 电池独立绝缘安装，使用可维护连接，预留必要空间；不焊死在电路板上，不把电池尺寸或固定压力凭空定稿。
7. Type-C 口预留实际插头、线材和插拔空间。效果图表示充电口位置，不承诺新增有线鼠标功能。
8. 主控天线周边空间待准确模块和天线规范确认，避免不合理的电池、金属遮挡；不使用任意统一禁布距离。
9. 不根据照片比例臆造板尺寸、安装孔或焊盘。同名模块尺寸不视为通用。未经实测的区域只作概念布局。

## 2026-10-05：尺寸资料与低成本扳机补充

本节记录前一轮建议；用户后续已决定省掉 TTP223，当前方案见下一节。

用户提供的两个压缩包已完整解压到 `器件资料/原始资料`；常用图纸复制到 `器件资料/参考图纸`，保留原始资料和根目录压缩包。

ESP32-S3 资料图给出主板 57.15×27.94 毫米、含伸出天线总长 63.39 毫米；不把总长全画成主板矩形。GY-601N1 说明书标称 17.8×20.6×2.8 毫米。采用这些资料名义尺寸继续布局，同时把实际板版本、含排针及插头的三维占用、安装孔等未给出的数据留空。尺寸图和 ESP32-S3 V1.4 电路图的局部器件位置不能默认一致。

用户提出 SS-01GL 上贴铜箔检测触摸，优先简单、便宜。当前原型复用 SS-01GL、铜箔和已有 TTP223。可以在金属柄上隔一层绝缘胶带再贴电极；更舒适的结构建议是小打印扳机帽内贴铜箔、帽压微动，随外壳一起打印。两种安装方式的选择尚未回复，不将其冻结为最终结构。

铜箔接现有触摸板确认后的感测节点，触摸板状态输出和微动开关分别接主控。不能把模块三针中的输出脚当成电极端。感测线短、柔软、留回弹余量；跟随触摸而不是每次触摸切换保持状态；原型验证按压全过程和抬指响应。不要求为此先购买新的触摸检测器。

## 2026-10-05：当前内部布局原型

用户决定省掉 TTP223，本轮原型以 ESP32-S3 内置电容触摸连接铜箔。外形方向已基本接受，重点转向内部布局、组件装配及线束。三张图共用同一安装建议，不另加功能按钮。

主控纵向放在上壳，天线朝前端塑料区域并预留净空；普通 PS2 摇杆在握把上部左侧部分内嵌，独立安装座，拇指右键在其下方；惯性模块在手上方的独立刚性托台，避开扳机反力；SS-01GL 位于扳机后，由打印帽推动；电池位于握把中下，充电及供电模块位于底部并支撑插拔力。

外壳、本轮位置和未知高度是布局建议。开发板与惯性模块采用用户资料给出的名义平面尺寸；摇杆和电池若使用其他厂商的同类资料，只能标为参考占位，不能冒充已购实物或通用规范。电源与右键未知部分用规划区域表示。现有精确尺寸清单不被这些规划区域覆盖。

统一布局配置为 `config/internal-layout-v1.json`；原点先取上壳与握把交界附近的概念参考点，未来正式零件共用确定后的基准。摇杆外凸与摆动需要计入整机最大厚度；本轮不声明真实全部装得下或重心验证通过。

## 后续正式建模交付

实测与关键候选确认后，交付参数化建模源代码、左半壳、右半壳、双功能扳机帽、微动固定件、电极结构、摇杆安装座、电路板支撑、电池固定结构；导出各零件及整机 STEP（实体三维交换文件）与各零件 STL（三角网格打印文件），附真实占位尺寸、来源和未确定参数。

本轮交付概念图、参数记录和可重新生成的三维占位参考，不是正式制造零件。图中螺丝、分壳线、微动和结构细节用于说明设计方向，不是已验证零件或孔位；本轮没有独立触摸检测板。
