guiwushengzhe-prog/gun-mouse/docs/嘉立创原生重绘交接_2026-10-18.md

# 嘉立创原生重绘交接（2026-10-18）

用户将实现交给聊天 `01a0cea1-6114-79e1-9294-696f3892ec30`，完成后由发起聊天独立核查。不要再问是否开始，继续完成已经授权的工作。

## 用户真实需求与尚未完成的事项

用户要求这次和以后都用纯嘉立创专业版设计主板，并使用其 EDA 专用优惠券。当前交付包 `release/2026-10-18-最终版/枪型飞鼠_最终版_上传打板.zip` 被平台实际拒绝，错误为 `-27（非EDA设计文件）`。现有工程是其他软件整板导入嘉立创后导出，不能把这种迁移称为满足用券要求。原生后缀、设计规则检查通过均不代表优惠券识别通过。

官方规则允许导入第三方封装库后从头绘制，禁止直接导入其他软件的整板：

- https://www.jlc.com/portal/t7i37578.html
- https://www.jlc.com/portal/server_guide_37593.html （页面更新为2026-09-15）

从空白主板开始，在嘉立创内建立器件、网络、布线和铺铜，保留最终机械接口。禁止改来源标记、修改制造文件的来源信息或把旧整板重新包装以绕过资格检查。用户已在18:25左右回复“已登录”领券所用账号，此后客户端重启过，旧后台会话均已失效。新后台会话仍未读到个人库，需核对当前工作区，不能假定登录失败或再次让用户重复登录。

## 项目与保留项

- 正确项目目录：`F:\项目\枪型飞鼠`。
- 当前分支：`codex/gen2-engineering`；交接前实现基准为 `4471360`。
- 当前正式源（属于整板迁移的参考版本）：`pcb/嘉立创最终版/枪型飞鼠最终版.eprj3`，主板文件 `pcb/嘉立创最终版/pcb/枪型飞鼠最终主板.epcb2`。
- 外壳与支座最终版已经确认，不要为重绘而随意改变孔位、板框、器件净空。用户最高个别焊点4毫米，通常2毫米以内；仅有M2×10、M2×20及M2螺母。
- 保留17个用户修改的 `pcb/GunMouseHandSolder.pretty/*.kicad_mod`、用户修改的 `tools/create_labeled_assembly_preview.py`、用户已暂存的 `shell/第二代完整装配_原版.blend` 及其余场景。只提交自己的文件，不能 `git add .`，不能连带提交已暂存模型。
- 工作记录只追加到 `shell/最终装配版/工作记录.md`。命令行临时Git身份可用Codex/codex@local，不改持久配置，不自动推送。

## 电路与机械核对基准

- 连接约定：`pcb/circuit-netlist.json`。14个有效网络、26个器件/机械孔实例。
- 最终83个孔/焊盘的机械坐标和孔径：`release/2026-10-18-最终版/核对记录/迁移前对照/孔位与布线核对.json` 的“实际孔位核对”。其中71个金属化通孔、12个非金属化孔。
- 板框制造坐标（毫米）：`(5,5),(57,5),(57,87),(20,87),(20,35),(5,35)`；板厚1.6毫米，双层。
- 装配坐标转换为制造坐标：`X=-装配X-3，Y=45-装配Z`；编辑器坐标为密耳（0.0254毫米），Y轴朝上。
- 带器件、孔、网络读回的旧版只读参考：`.logs/嘉立创最终版/最终原生几何与连接.json`。只把它当接口/尺寸参考，不能复制其导线、过孔与铺铜来冒充重绘。
- 最终实物布局与尺寸配置：`release/2026-10-18-最终版/工程源文件/模型基准配置.json`、`tools/final_regular_layout.py`、`tools/preview_layout.py`。
- 重绘过孔数量可改变，不可把原先18个过孔、总101钻孔当成不可变验收条件。固定83个孔位与有效网络才是约束。
- 设计规则沿用：常用线宽0.3毫米、最小0.25毫米，铜间距0.25毫米、铜到板边0.5毫米；过孔常用外径0.7/孔径0.3毫米。不要为获得零报错而放松规则。

## 已验证工具链与未成功尝试

- 嘉立创专业版4.1.66：`E:\各种软件\嘉立创专业版4\lceda-pro.exe`。
- 原生命令行封装：已提交的 `tools/jlc_cli.py`。通过官方扩展接口调用，结果保存在 `.logs/嘉立创最终版`。命令行帮助：`doc api --class-name ... --method-name ...`。关闭本轮会话用 `session close --session <编号> --destroy`，不是 `close`。
- Python：`E:\GunMouseCAD\CadQuery\python.exe`（有numpy、scipy、vtk）。PowerShell原生环境，不依赖其他软件进行PCB编辑/布线/导出。
- 原生公开接口说明：https://prodocs.lceda.cn/storage/texts/api/guide/cli-for-ai.md 。`getAllPinsByPrimitiveId` 读回真实焊盘位置后再布线。先创建过孔，再创建线路。完成后重铺铜、保存、重新打开再次检查。
- `pcb_Document.autoRouting` 在本版本有公开接口，参数字段为 `RoutingNets`（不是示例中的nets）、`layers`、`cornerStyle`、`optimization`、`existingPrimitiveMode` 等。尚未在新板实际测试。
- 已成功从空白客户端建立本地工程 `E:\嘉立创文件\枪型飞鼠纯嘉立创重绘版`，但后续封装库和源码解析失败，**没有成功的新主板，更没有新的布线或制造文件**。
- `lib_LibrariesList.getPersonalLibraryUuid()` 离线时无返回，`getProjectLibraryUuid()` 返回字面量 `project`；`lib_Footprint.create('project',...)` 失败。登录后新会话也暂未读到个人库。下一步应读取 `dmt_Workspace.getCurrentWorkspaceInfo/getAllWorkspacesInfo` 并核对工作区，而不是反复重试同一失败调用。
- 从迁移工程读取封装源码曾等待到超时；自行组装含库文档和新器件的源码，经 `sys_FileManager.setDocumentSource` 返回false，磁盘直接打开也出现默认空白板。**不要把输出文件存在当成载入成功。** 编辑器自己的原样源码通过该接口可以回写，说明应区别文档接口和工程库导入。
- 未提交的失败/候选脚本：`tools/jlc_native_redesign.js`、`tools/prepare_jlc_redesign.py`、`tools/build_jlc_native_placement.py`、`tools/jlc_native_draw_board.js`。
- 未提交的候选目录 `pcb/嘉立创原生重绘版` 和 `outputs/嘉立创原生重绘` 包含格式尝试、空白基准和来源记录，均不是交付件。可以替换或清理自己确认无用的本轮产物，不要清理用户文件。
- `jlc_native_draw_board.js` 是备用逐焊盘原生绘制，尚未执行成功；只有散焊盘而没有器件关联不宜直接当作完整可维护版本交付。优先把真正器件封装建立好。
- 登录后本轮创建的后台会话：`4ea34995-e841-40bc-9b8a-6ee792865c97`；移交时将尝试关闭，若已关闭请重新创建。不要关闭用户主窗口或其他聊天的会话。

## 完成标准与交付

1. 新工程在嘉立创中正常载入，器件和网络可维护，实际重新布线；电路连接与最终孔位核对通过。
2. 嘉立创内设计规则检查无短路、无未连接等实质错误；重铺铜、保存、重开后结果仍一致。正确核对1.6毫米物理叠层。本机4.1.66叠层厚度字段实际以密耳存储，不能直接照网上新文档的单位写。
3. 由嘉立创导出原始制板文件，保留原始包；更新正式可编辑工程、最终上传包、配套说明、文件清单及摘要。现有 `tools/package_jlc_final.py` 对应旧工程名和旧计数，必须据新版本修正，不能盲目执行。
4. 优惠券识别需以平台实际接受为准。如果未完成平台校验，清楚写“本地重绘/检查完成，优惠券资格尚未核验”，不能宣称已解决-27。不要自动付款、正式下单、向客服发送资料。
5. 给出准确路径、原生检查结果、尺寸和网络核对结果、版本提交及遗留事项，并产出 `outputs/嘉立创原生重绘/实现完成说明.md`，供发起聊天独立复核。

发起聊天收到实现完成后，会独立打开工程、复查关键网络/机械尺寸/制造输出及优惠券证据。实现聊天不要以“已生成文件”代替以上验证，也不要要求用户自己完成已授权的设计工作。
