guiwushengzhe-prog/gun-mouse/pcb/electrical-independent-review.md

# 手焊载板电气独立复核

日期：2026-10-07。复核对象为当前 `TENSTAR-style ESP32-S3 SuperMini` 手焊载板版本。

结论：**当前逐焊盘网络定义符合本版功能与电源约定，74 个实际通孔焊盘与配置一致。工程样的实板供电、USB 回馈、触摸与触点可靠性仍需验证；软件规则检查不能证明这些功能已经实测。** 最终制造文件的 DRC 状态见文末。

## 复核范围与来源

只读核对 `carrier-config.json`、生成脚本、KiCad PCB 对象、DRC/构建报告、SuperMini 固件接口及本地厂家资料。除本报告外未改写 PCB、配置或固件。采用 `pcbnew.LoadBoard` 独立读取实际 PCB，将每个 PTH 焊盘的器件引用、脚号、网络、位置、孔尺寸和通孔属性与配置比较；没有把生成脚本的自报结果作为唯一依据。

- 最终配置 SHA256：`730ba00d1d0590381b81cf3021c8e8dff3583758a3b714f3035dd419f2aa9f00`。
- 最终实际板 SHA256：`8516f2156d765da2e32b3538fc794eba1a2137169497c32cad32380091ad6bb0`。
- 厂家来源：本地 Alps 图纸（`datasheets/alps-rkjxv1224005-dimensions.gif`）；`datasheets/Omron-D2FC-datasheet.pdf`；GY-601N1 模块说明书/电路图（`datasheets/GY-601N1/`）；`supermini/nologo-s3-schematic.png` 与 TENSTAR 商品针脚图。
- NOLOGO 图是同型家族参考，**不是已取得的 TENSTAR 采购批次受控原理图**；库脚号与参考图不能代替实际采购器件的通断、极性及型号检查。

## 网络与元件检查

检查得到 25 个应装器件组：摇杆 1、右键微动 1、焊线端子组 8、THT 电阻 8、电容 7。配置共有 74 个 PTH 焊盘、16 个非空网络；实际 PCB 74 个 PTH 焊盘，网络、孔位、孔尺寸和属性全部一致，无缺失或额外 PTH 焊盘。安装/定位 NPTH 不计入该 PTH 数量。

|部件|核对结果|
|---|---|
|Alps RKJXV1224005|1=GND、2=JOY_X、3=3V3；4=3V3、5=JOY_Y、6=GND；7–10=GND；a/c=JOY_SW、b/d=GND，符合原库网络与脚位定义。两模拟轴方向由固件校准决定。|
|D2FC-F-7N(20M)|库 1=COM→GND、2=NO→BTN_R、3空网。**官方 D2FC 为 SPST-NO，第三脚是 Dummy terminal（无功能固定脚），不是 NC。** 厂家要求不接第三脚到电路；当前空网正确，仍可焊在独立空网盘上以固定。|
|外置 SS-01GL13|J_TRIG 1=GND→COM、2=TRIG→NO，开关 NC 不接。实际开关需用万用表确认释放断开、按下导通。|
|GY-601N1|J_GY 1=3V3、2=GND、3=SCL、4=SDA，接模块 H2 芯片接口。模块原图已含 SA0 接地、CS 10k 上拉、SDA/SCL 各 2.2k 上拉；载板未重复添加 I²C 上拉。PS 保持默认悬空，不能误接 MCU 接口 RC/DT。|
|按钮上拉与滤波|R_JOY/R_RIGHT/R_TRIG 均为 3.3k，接 3V3→对应按键；C_JOY_SW/C_RIGHT/C_TRIG 各 100nF 到地。闭合电流约 1mA，RC 约 0.33ms；软件去抖仍有必要。|
|摇杆滤波|C_JOY_X/C_JOY_Y 各 100nF 到 GND，模拟电位器两端使用 3V3/GND，不接共享 5V。|
|触摸|J_TOUCH 1=TOUCH_ELECTRODE→R_TOUCH 510Ω→TOUCH→J_MCU 10。TOUCH 与电极侧均无上拉、下拉或并地电容。J_TOUCH 2 为可选 GND/屏蔽焊点，**不能与同一触摸铜箔相连**。|
|电池测量|BAT_SW→R_BAT_H 100k→VBAT_ADC→R_BAT_L 100k→GND；C_BAT 100nF 并在 ADC 对地。|
|供电轨测量|VBUS_SHARED→R_RAIL_H 100k→VBUS_DET→R_RAIL_L 100k→GND；C_RAIL 100nF 并在 ADC 对地。不是数字 USB 检测。|

官方 D2FC 的最低适用负载参考为 5V DC / 1mA。本版 3.3V、约 1mA 只能确认设计的触点电流，不能据此宣称已经满足厂家微负载寿命参考；工程样应检查重复点击、放置后的接触与释放稳定性，不把 20M 型号数字当成本电路已验证寿命。

## MCU 电气角色

|功能|GPIO|电气角色|
|---|---|---|
|JOY_X / JOY_Y|1 / 2|ADC1 模拟输入，最高衰减档；输入端不启用内部拉电阻。|
|JOY_SW / BTN_R|4 / 12|机械低有效输入，可保留内部上拉作未连接载板时的备援。|
|TRIG|8|机械低有效输入及 RTC 深睡唤醒；GPIO8 支持该用途。|
|SDA / SCL|5 / 6|I²C 双向开漏；总线由 GY 模块上拉到模块内部 3.3V。|
|TOUCH|7|ESP32-S3 触摸通道；不作数字按钮输入，不启用上/下拉。|
|VBAT_ADC / VBUS_DET|9 / 10|ADC1，分别读取开关后电池节点与共享供电轨的二分之一电压。|

全部功能 GPIO 不重复。配置保留 GPIO3、43、44，未占用原生 USB GPIO19/20，也未占用启动配置 GPIO0/3/45/46。参考 SuperMini 中 GPIO3 已接板载共享 VBUS 分压，不应作为独立空闲 GPIO。固件头文件与配置对应；代码只对三个机械按键开 `INPUT_PULLUP`，四 ADC 使用 `ADC_11db`；原生 USB CDC 编译条件避免物理 UART0 占用。没有把原 YD 或 XIAO 固件引脚套用到 SuperMini。

## 电源约定与实物边界

电池正极从 J_BAT 1/BAT_RAW，经 J_SWITCH 两焊点接外置 SPST，再从 BAT_SW 到 J_MODULE_BAT 1/模块专属 B+；负极接 GND/B−。BAT_RAW 未直接连接 ADC，电池分压在隔离开关后；该网络能够避免关掉电池、同时拔 USB 后，未隔离的电池继续经该分压向 MCU 注入电流。**不可把 BAT_SW 改接模块 5V 脚。**

开关 OFF 同时断开电池充电和放电；插 USB 时控制器仍能运行。完全断电需 OFF 并拔 USB。OFF+USB 时 BAT_SW/B+ 是空载充电器 BAT 端，可能约 4.2V，不是实际电池端电压；固件及说明已明确这点。

两组 100k/100k 分压具有 50k 等效源阻抗、100nF 电容，时间常数均为 **5ms**，约 25ms 后达到通常可用的稳定程度。定时唤醒的 50ms 等待及多次平均足够覆盖这个 RC，但仍应实板比较万用表与校准 ADC。4.2V 电池对应 2.1V ADC，5.25V USB轨对应 2.625V ADC；正常单节/USB范围内不会把 5V直接送进 MCU。ADC 内部拉电阻必须保持关闭。

参考 SuperMini 电池经 BAT60B 二极管连接共享 VBUS，再经 ME6217 3.3V LDO。板上没有把 USB-C VBUS 与电池供电的共享轨作反向隔离，也没有电芯放电保护 IC。因而有以下实际限制：

1. 连接电脑前关电池；电池 ON 充电只使用已通电的外部 USB 电源；该外电源断电或关闭前也应先关电池。这个使用条件不能写成硬件已经消除 USB 回馈。若需要任意插拔/掉电都无回馈，仍需硬件反向隔离设计。
2. 使用带过充、过放、过流保护的成品 1S 电池。BOOST 保持开放，100mA 是参考卖家默认档，实际芯片及电阻批次需测充电电流和终止行为；没有证明某个未知批次就是精确 100mA。
3. 电池 3.6V、持续 30秒的深睡阈值是二极管+LDO 的初始供电余量约定，不是电池保护阈值，不能保证 BLE 峰值电流下始终有足够 3V3。需测满电、中等电量、接近低压阈值时的 3V3 与复位情况。
4. 共享 VBUS 在电池模式也有电压。GPIO10 分压 ADC 的 4.5V进入/4.3V退出，仅推断外部5V；USB线路压降、ADC误差或不同板型可能影响判断。不能宣称这是 USB物理插入、充电中或充满检测。
5. 铜箔绝缘、线束固定与短触摸线仍有必要。510Ω 串阻不是完整 ESD 防护，未做整机静电或供电切换抗误触实测；载板暴露允许被握持时，仍应避免手直接接触电池/电源焊点。

上述引脚和器件库网络检查不代替实物验收。到货后在无电情况下确认 B+/B−、5V/USB VBUS、二极管方向和保护电池极性；上电测3V3、分压、充电与关断电流。若与家族图不同，应先修改该批次的接线/电源定义，不能仅凭“SuperMini”商品名直接套用。

## DRC 状态

最终只读复核读取 `drc-report.json` 时间为 `2026-10-07T04:51:31+0000`：**0 violations、0 unconnected items**。此前 J_GY pad2 顶层 GND 热焊盘孤岛已由明确接地支路和局部实连接修复。最终 `build-report.json` 的配置/PCB SHA256 与本报告独立计算值一致；最终 PCB 的 74 个 PTH 焊盘再次逐个比较，仍为 0 网络/位置/钻孔/属性差异，且固件引脚头文件与最终配置的功能 GPIO 完全一致。PCB 为 52×82mm、两层、全 THT；构建报告包括定位/安装孔的总盘数为 80。

没有 KiCad 原理图，因此 DRC 的空 `schematic_parity` 不是原理图/PCB ERC 或网表一致性检查通过。本报告给出的逐 PTH 焊盘比较能确认配置与 PCB 对象一致；配置自身的电气正确性由上述来源和功能约定独立核对。
