guiwushengzhe-prog/gun-mouse/docs/工程样A阶段-复审结论与改动.md

# 工程样 A 阶段：复审结论与改动

日期：2026-10-06。针对 `docs/Astra审核提示词-制造与装配.md` 的四项决策给出结论，并按"先做工程样、拿数据后一次改板"的路线落实下单前改动。原始资料：欧姆龙 SS（B032-E1-14）、D2SW、D2FC（B152-E1-02）规格书与《基本开关正确使用》，TP4056、RT9080 原厂手册，YD-ESP32-S3 V1.4 电路图，Alps 官网与立创页面（价格库存为当日快照）。

## 路线

现板电路核对过的部分（电源、USB、排针与开发板电路图）没有接错。需要改板的几项都属于可靠性余量，不阻碍工程样功能；按钮公差只涉及打印件。所以先用现板（只改 R3、R5 阻值）加改过的打印件做工程样，实测后合并成一次改板，避免没有数据就改板、打样后再改一轮。

本项目由个人下单，只能使用嘉立创常规贴片加插件流程，不依赖任何特殊工艺要求；需要逐台做的扳机设定，由用户组装时完成。

## 一、按钮

**扳机（SS-01GL13）**

- 欧姆龙参数：OP 10.7±0.8（以安装孔中心为基准），OT ≥1.2，FP ≤15.5，OF ≤0.49 N。常开用法要求压入额定 OT 的 70%–100%（0.84–1.2），且不得超过总行程位置。
- 规格书注明未注公差为 ±0.4。本设计让壳体底面坐在小板上，基准与原厂不同，再叠加打印和装配，最坏约 ±2 mm，窗口却只有 0.36 mm。所以只能在实物上设定；先台架测开关再分档选尖端盖不住这个叠加，柔顺传力则每次都会把杠杆推到底。
- 采用的做法：触点改为 M2 外六角螺栓的头部，在右半壳上用 1.0 mm 设定片定位，转螺栓到开关刚接通，再用 0.8/1.2 mm 片复查。螺纹在塑料里自锁，不用胶。调节范围为 −1.5～+2.0 mm。
- 硬限位块整块归右半壳，左半壳让开 0.3 mm，保证合壳后设定结果不变。按压力经滑杆下段后端面传到右半壳，螺栓只承受开关反力。
- 型号核对：按欧姆龙型号规则，"SS-01GL13"是焊片端子版（PCB 端子版带 D 后缀），立创页面却标 PC Pin，到货要核对。立创当日现货只有 60 只。若出现助焊剂造成的接触不良，可换成密封型 D2SW-01L3D：原厂允许浸焊，动作位相同，但 OT ≥1.0、机械寿命较低，而且立创无货。

**右键（D2FC-F-7N(20M)）**

- 参数：OP 6.9±0.2，OT ≥0.2，FP ≤7.35。70%–100%OT 的窗口只有 0.06 mm，小于 0.4 mm 的 OP 公差，任何固定或可调硬限位都不可能对全部个体落进窗口。
- 帽沿落到壳面是独立硬限位，按压力经帽沿传给外壳。帽杆静止端面 7.30（原值 7.47 取自三维模型，高于原厂 FP 上限），帽沿行程 0.80，限位处 6.50：比三维模型的开关外壳顶面 6.45 高 0.05，不压到外壳；比 OP 下限 6.7 低 0.2，所有个体都能触发。
- 剩余风险：推杆内部总行程较短的个体，可能在帽沿落壳前先被压到底，此时按压力仍会进入开关。首件用卡尺量推杆按到底时距板的高度，高于 6.50 的话改用带金属弹簧的限力帽。
- SW2 背后加 3 根支撑柱，避开插件脚、过孔和底层走线；它只减少电路板弯曲，不能代替上面的限位。
- 首件再做寿命试验确认。

## 二、电源

- **最该先处理的是热，不是检测分压。** TP4056、RT9080、D1、Q1 和它们的电容全部在电池投影内，离电池约 2 mm，板上没有铺铜。TP4056 要到结温约 145 °C 才降流，而且 TEMP 接地，电池温度检测是关闭的。工程样把 R3 改为 6.8k：电流约 176 mA，芯片功耗从 0.47–0.65 W 降到约 0.23–0.32 W。
- **拔 USB 的切换瞬间有掉电风险。** 拔下后 VSYS 先走 Q1 体二极管，约 VBAT−0.7 V，直到 VBUS 经 R5 放电。工程样把 R5 改为 10k，缩短这段时间；首件实测是否复位。
- **关机时检测分压的注入电流列为待验证。** 按电路估算，关机后电池分压耗电约 2 µA；关机但插着 USB 充电时，IO2 经 50 kΩ 向未供电的主控注入约 40 µA，RT9080 关断时的 80 Ω 主动放电会把 3V3 钳在地附近。乐鑫手册没有给出未供电引脚允许的注入电流，所以不能据此判定安全。首件在关机充电时测 IO2 与 3V3 电压；改板时把 VBUS 检测改为 1M/1M 加 100 nF 或加串阻，把注入降到几 µA。
- **开发板自身 USB 不加硬件。** RT9080 的绝对最大额定要求 VOUT−VIN ≤ +0.3 V，保持"开发板插在主板上时不用它自己的 USB"的流程即可。
- **改板时做**：
  - 充电与稳压电路移到握把前下方的非电池区（约 600 mm²），铺铜并打热过孔。
  - Q1 并联肖特基。
  - TEMP 接 NTC。
  - RT9080 EN 加下拉（原厂要求不可悬空）。
  - VBUS 检测改为 1M/1M 加 100 nF（或加串阻），降低关机注入电流。
  - 只有当首件数据不达标时，才换用 BQ2407x 类路径管理充电芯片（立创快照：BQ24075RGTR $0.56 起，BQ24074RGTR $1.20 起）。

## 三、USB、地、散热铜、天线

- **现板走线实测**：两线中只有约 43 mm 真正成对，约 50 mm 两线相距超过 3 mm，D− 绕过 U2，整对线被底层 17 个网络跨越 42 次。150 mm 已接近这种拓扑的最短长度（约 145 mm），所以要解决的是成对和连续地参考。
- **保留底口下载，固件以后再加 Wi-Fi OTA 作第二通道。** 工程样先直接测现板能否稳定下载，但现板结果不作为改板依据。
- **改板规则**：
  - 底层整面铺地，只在 X≥52 和摇杆禁布区留空。
  - USB 在顶层紧耦合成对，两侧共面地并打过孔，不换层，不被跨越。
  - 走廊沿握把前缘 X≈−30 上行。
  - 按乐鑫要求做 90 Ω ±10% 差分阻抗：改板前向板厂取得两层板的实际叠层参数（介质厚度、介电常数、铜厚），按带参考地的共面差分线计算线宽和线距；两层板做不到这个阻抗时再评估板厚或层数。
- **天线**：模组天线在开发板前端伸出的 X 60–66.24，主板到 X 60.5 结束。C5、C6 是 J1 电源脚的去耦电容，位于模组屏蔽体下方，应保留。改板时 X≥52 两层都不铺铜，首件对比信号强度。
- **触摸**：保留 GPIO14，改板时加 510 Ω 串阻并预留低电容 ESD 焊位。

## 四、摇杆

- RKJXV1224005 的状态是"为现有设计继续生产，不用于新设计"。同系列的 RKJXV122400R 是推荐新设计的标准品：10 kΩ、±23°、中按 7.4 N、方向寿命 200 万次、中按寿命 50 万次、带杆高 18.95 mm 都一致，外形 18.2×21.7 mm（原为 17.8×21.3 mm）。立创 C918854 当日约 5,000 只现货。
- 网页安装孔图上，电位器孔、金属脚孔、定位孔两者一致。中按开关 a–d：400R 标为 Ø1.2、横距 6.5；现封装是 Ø1.6、横距 7.0。改板时用两份正式规格书核对，做成两种都能装的封装。
- 继续直焊，不做独立摇杆组件。Alps 建议收货后 6 个月内用完，按批次采购。

## 本分支落实的内容

- `config/evt-a.json`：全部参数与理由。
- `scripts/evt_a/`：打印件生成与自检、下单文件生成、示意图。
- `deliverables/evt-a/`：下单文件、打印文件、几何检查、示意图和组装说明。

`config/pcb-shell-v1.json` 与 EDA 工程仍是正式基线（R3=3.3k、R5=100k），以免破坏已有校验链；改板时把 `config/evt-a.json` 的物料差异合并进去。
