guiwushengzhe-prog/gun-mouse/pcb/嘉立创最终复绘/打开说明.md

# 当前主板工程

打开同目录的“枪型飞鼠最终原生复绘.eprj2”，选择“枪型飞鼠最终主板”。PCB1及初始原理图是嘉立创新建工程的空白占位，不是要制造的主板。

本次从空白主板建立83个独立原生焊盘和孔，依据最终机械位置和电气网络重新布线、铺铜。没有导入旧整板、旧走线或旧覆铜；临时封装库样本已删除。当前是按焊盘及网络维护的板图，没有关联器件实例和配套原理图。

核对输入目录保留官方工程备份、原始制板压缩包、实际主板预览，以及导出和保存重开的完整读回状态。运行“tools/package_jlc_rebuilt.py”执行孔位、网络、叠层、官方备份和交付完整性核对后更新交付包。运行前应确保新变更已经重新导出并更新核对输入，不能拿历史读回记录代替新板验证。

正式交付在“release/2026-10-18-最终版”。优惠券能否使用由用户自行到平台确认，本工程没有平台通过记录。
