guiwushengzhe-prog/gun-mouse/deliverables/经济型审核候选/生产资料复审说明.txt

本订单尚未生产，希望调整为经济型部分贴装，请先修改生产资料并重新审核。

1. 原始制造文件是主板与扳机小板的邮票孔连接，没有设计 V 割。当前下单页面提示“PCB V 割生产，暂不支持经济型”。请核对工厂生产稿里 V 割的位置和用途，将工艺改为经济型可接的无 V 割单板或邮票孔方式。若需要生产边，请采用经济型可接方式，不添加 V 割。
2. 保持原线路、孔位和装入外壳后的两块板形不变。生产稿调整后，请更新本 PCB 订单的经济型资格。
3. 只让工厂安装主板元件。扳机小板 SW4 与 J6 均不安装，小板仅制光板；客户自行焊开关及线端。
4. 主板 U1、R10、R11 均不安装，客户使用现有同芯片惯性模块补装。不安装位置不印锡膏，其他元件按新的物料与坐标清单装焊。
5. 其余器件只贴顶层，数量两片，普通交期。请核对剩余器件是否全部支持经济型；如有不支持的器件，请列出具体位号和原因。
6. 请按只有主板装焊重新核算多款/拼板费用；光板仍为两款，不要求虚报制板款数。请同时确认剩余器件是否要求射线检查及 U2/R3 的免换料资格。
7. 请提供复审后的生产稿和报价，客户核对后再决定生产。

本说明为已准备的复审文字，尚未由助手发给供应商，也不表示订单已获经济型资格。
