guiwushengzhe-prog/gun-mouse/release/2026-10-18-最终版/电路板/嘉立创原生重绘/打开说明.txt

当前工程：枪型飞鼠最终原生复绘.eprj2
官方工程备份：枪型飞鼠_最终原生复绘.epro2
在嘉立创专业版打开后选择“枪型飞鼠最终主板”；PCB1和原理图是软件新建工程的空白占位。
本次为原生焊盘及网络板图重绘，没有关联器件实例及配套原理图。
优惠券是否可用，由用户自行到平台确认，本交付未核验平台结果。
