guiwushengzhe-prog/gun-mouse/pcb/README.md

# PCB 模块装配预览

当前主板唯一维护源为 [嘉立创最终版/枪型飞鼠最终版.eprj3](嘉立创最终版/枪型飞鼠最终版.eprj3)。后续统一使用嘉立创EDA专业版，不再用本目录下的旧源板重新生成主板。工程索引和同目录的 `pcb` 子文件夹必须一起保留。

当前制板包为 `../release/2026-10-18-最终版/枪型飞鼠_最终版_上传打板.zip`，已切换为嘉立创原生导出。孔位、网络和外形与最终打印件逐项核对。下文是迁移前设计过程的历史说明，其中的旧位置、统计和源文件路径不作为当前制造依据。

当前手焊小元件已从15颗精简到8颗：保留 `R_TRIG、R_TOUCH、R_BAT_H、R_BAT_L、C_TRIG、C_BAT、C_JOY_X、C_JOY_Y`。保留电量显示；取消低电量自动休眠、外部供电识别及其3颗元件，摇杆按下和右键改用芯片内部上拉及软件消抖，省去对应4颗元件。8颗元件改为每行一颗、左右交错，通孔1.1毫米、铜焊盘2.6毫米，每颗两孔均拉开至10.16毫米；模块排针间距保持。8颗之间最小孔中心距约6.17毫米、铜盘边缘间隙约3.57毫米；与邻近开关等其他焊盘最小铜边间隙约3.19毫米。物料清单、源板和铜层三维模型已同步。

完整装配模型和源板现已同步：摇杆在+Y拇指面，开发板、陀螺仪及其他板上元件在−Y面；摇杆帽仍朝+Z。真实孔号随模块实体旋转，摇杆五针由原竖排改为横排，整机X坐标从小到大依次为接地、3.3伏、横轴、纵轴、按下；五孔Z坐标均为5毫米。配置中的 `model_reference_pads` 仅供装配模型构造原始实体，`pads` 才是实际制板坐标，不能再次翻转它们。

另增 `SW1_ALT` 直排针备用位，与现装弯排针摇杆二选一，完整装配中没有装第二个摇杆。备用五孔均在整机Z=8.5毫米，X从小到大为−41.58、−39.04、−36.5、−33.96、−31.42毫米，电气顺序为按下、纵轴、横轴、3.3伏、接地；换成直排针时须按这个顺序插装。四个M2固定孔中心为近侧（−46.25，10.9）、（−26.75，10.9）及远侧（−46.25，37.3）、（−26.75，37.3）毫米，形成19.5×26.4毫米孔阵列。每排左孔直径2.4毫米，右孔为3.6×2.4毫米横向长孔；远侧两孔当前兼作弯针底座的主板穿板固定，M2×10螺钉头在+Y，螺母嵌入−Y打印支座，未来直针换装时改作摇杆另外两角固定。远侧孔的+Y螺钉头下设半径2.3毫米禁铜区，右侧同时覆盖长孔横向调整余量。现有全部焊孔、四个主板安装孔和八颗小元件位置均保持。

孔距19.5×26.4毫米取自DZYJ商品尺寸图，优先于冲突的手量数值，尚未实测该实物孔距；图中没有标排针到近侧固定孔中心线的距离，因此该段采用用户补充的约2.4毫米。旧模型1毫米为估算，不作为厂家尺寸。商品图注明手工测量误差0.5～1毫米，备用长孔提供横向调整余量。以后复核现有实际布线并重导同名文件，可用KiCad的Python运行 `tools/generate_gen2_pcb.py --validate-existing`。

## 当前文件

- 源板：gun-mouse-supermini-carrier.kicad_pcb；物料清单：BOM.csv。
- 裸板三维模型：3d/gun-mouse-gen2.obj，与同目录材质文件配套使用。完整装配模型见 ../shell/README.md。
- 板材为玻璃纤维环氧板，52×82毫米外接尺寸，保留原缺口；板厚1.6毫米、双面铜层。四个M2安装孔直径2.4毫米。
- 当前模块排针孔距保留：SuperMini两排各9孔、GY左8右6孔，排针脚距2.54毫米。SuperMini两排间距15.24毫米仍为暂定值。

## 保留的小元件

| 位号 | 数值与用途 |
|---|---|
| R_TRIG | 3.3千欧，扳机上拉 |
| R_TOUCH | 510欧，触摸电极串联 |
| R_BAT_H、R_BAT_L | 各100千欧，电池电压减半采样 |
| C_TRIG | 100纳法，扳机滤波 |
| C_BAT | 100纳法，电池采样滤波 |
| C_JOY_X、C_JOY_Y | 各100纳法，摇杆两轴滤波 |

电阻本体不超过6.4×2.6毫米；陶瓷电容本体宽不超过6毫米、厚2毫米、焊后高7毫米。可沿用原元件，将引脚向外成形到10.16毫米孔距；电容在离本体一小段距离处弯腿，不能从根部硬掰。模块自带排针间距不改。焊后剪脚伸出板面不超过1毫米。

## 接线与电源

沿用现有SS金属扳机，两根线连接公共端与常开端；右键使用原微动，摇杆保留原生帽。铜箔触摸电极经R_TOUCH连接，铜箔与金属摆杆绝缘。

电池正极接J_BAT，经SS12D10 G5拨动开关后接SuperMini专用B+；负极共地接专用B−。拨动开关相邻脚距4.7毫米，使用1.8毫米孔和3毫米焊盘。电池仍采用带保护板的602060单节锂电池，按20×80×8毫米外形空间试装。

本版保留电压估算电量，取消低电自动休眠及外部供电识别。充电或电池开关关闭而USB供电时，B+节点读数可能偏高，不能作为充满判断。

原有SuperMini供电路径限制继续适用：接电脑前关闭电池开关；电池开关打开时充电使用已通电的USB电源，关闭外部电源前先关闭电池开关。完全断电需要关闭电池开关并拔下USB。

实际双面网络为311段铜线、9个过孔；仅为远侧右长孔局部调整原3段摇杆按下信号与地线，其余实际走线保持。同名KiCad制造压缩包、接线表和检测报告已重新导出。新增备用孔后，实际共有72个金属化焊孔和8个非金属固定孔，制造包中镀铜孔与非金属孔分别导出。带本次实际封装的导出环境检查为0错误、0警告、0未连接；保留的仓库旧封装库与新板上封装不同，本机原工程可能提示库版本不一致或备用封装尚未入库。未覆盖已有封装库，也未更新E盘旧嘉立创原生工程或其旧制造包。尺寸暂定、模块供电、实际焊接及功能仍需样机确认。
