guiwushengzhe-prog/gun-mouse/deliverables/经济型工厂代焊版/README.md

# 枪型飞鼠：便宜扳机开关，由工厂采购并焊好

这是本轮推荐询价版本，**只接受经济型，不能按经济型接单就不生产，不转标准型。** 扳机开关从 SS-01GL13 / C3822088 换为 SS-01GL / C2896769，仍交给嘉立创采购和焊接，不要求你自己买开关或焊开关。主板与扳机小板保留，取消自动 V 割设置；新左右壳、扳机及卡板槽按直摆杆动作位置适配。陀螺仪复用已有的 GY-601N1-LSM6DSV16X 模块；U1/R10/R11/R12/C7/C8及充电灯LED1、限流电阻R4共八件不装，都无需用户补焊。充电功能保留，外部充电灯取消。

本版用于重新匹配和询价。规则检查和三维配合检查属于文件验证；实际开关动作、打印公差、模块通信、供电温升和蓝牙效果还需要首件验证。经济型是否可接这块异形邮票孔拼板、C2896769 的实际代焊供货价，要以新订单匹配与审核结果确认。

经济型公开工艺允许单面贴片及插件、邮票孔拼板，保留扳机小板不代表必然只能标准型。本版已关闭V割设置、只安装顶层器件；仍需国内本次审核全部待装物料，尤其潮敏、温度和特殊结构限制，不能凭海外平台的经济型标签判断国内能接。若任何器件或工艺导致经济型不可选，本包只能用于继续查明原因，不能按标准型付款生产。

## 上传这三个文件

只用本目录 `制板文件` 中的文件重新建立订单，不要套用旧订单的生产稿：

1. `gun-mouse-economy-factory-v3-Gerber.zip`：制板生产文件。
2. `gun-mouse-economy-factory-v3-BOM.csv`：物料清单，含便宜开关，每套 21 组、40 个工厂安装器件。
3. `gun-mouse-economy-factory-v3-坐标文件.csv`：对应工厂安装位置与角度。

两个 CSV（表格文本文件）沿用设计软件输出的 UTF-16 制表符格式，直接上传，不用重新保存。

| 网页项目 | 怎么填 |
| --- | --- |
| PCB（印刷电路板） | 2 层、1.6 毫米厚、普通 FR-4 玻纤板、绿油白字、普通铜厚与表面处理 |
| 款数/拼板 | 如实填写主板和扳机小板两款，按文件邮票孔连接，铣切外形，**不要 V 割** |
| 焊接数量 | 其他数量：2 套；此前页面显示最低 2。其余光板随单发货 |
| 焊接层 | 只贴顶层 |
| 应用行业 | 消费电子 |
| 产品类型 | 只选经济型；若不支持，不付款、不生产，也不改选标准型；按提示核对具体器件/工艺原因 |
| 生产时间 | 普通交期，不加急 |
| 确认 DFM | 可保留 3 元可制造性确认 |
| 确认钢网 | 不需要额外人工确认；不等于取消生产所需钢网 |
| 个性化服务 | 保持无额外要求；不买整盘，不加喷涂、灌胶或程序烧录 |

匹配清单时，重点查看 **SW4**：应为 **SS-01GL、C2896769**，不是 SS-01GL13 / C3822088。封装沿用已核对的三焊片槽，软件库封装名称中可能仍保留旧型号字样；采购看 C2896769 和 SS-01GL，不能因为封装名称旧就换回贵料号。直摆杆的三维机构按新原厂图核对，不能仅看原库旧三维模型判断行程。

如果 C2896769 显示缺料、不能代焊或价格仍高，先保留报价并看具体原因，不自动改为让用户自购，也不直接换另一种柄型。新的廉价型号和原报价贵型号不是相同商品，商城参考价不能当作 SMT（工厂元件安装与焊接）的保证成交价。

可粘贴到订单中的备注：

> 本单仅接受经济型、只焊顶层，不能按经济型接单则不生产，不改标准型。保留主板及扳机小板两款，按文件邮票孔拼接，铣外形，不做V割。按物料和坐标安装每套40个器件。SW4为SS-01GL/C2896769，请由工厂采购并完成三焊片焊接，不使用旧SS-01GL13/C3822088。U1、R10、R11、R12、C7、C8、LED1、R4不装，相应位置不开钢网、不涂锡膏。J1/J2排母、SW1摇杆、SW2右键、J6小板接头、USB1固定脚完整焊接。请说明经济型不支持时的具体器件/工艺原因，并列明多款拼板费、各收费物料种类与开关实际单价。

## 改了哪些，预计省在哪

| 原报价项目 | 本版处理 |
| --- | --- |
| SS-01GL13 31.30 元/只，2 只 62.60 元 | 改 SS-01GL / C2896769，工厂采购和焊好 |
| 裸陀螺芯片 U1 20.93 元/只 | 不安装，使用已有同芯片模块；同时不装 R10/R11/R12/C7/C8 |
| 标准型工程费 150 元、钢网费 50 元 | 申请经济型；官方经济型说明工程费50元、不收钢网费 |
| 标准型拼板费 150 元 | 保留两款板，如获经济型按其多款规则重新计费，**不能宣称已免掉拼板费** |

C2896769 在立创商城查到约 **4.24 元/只参考价**。这是商城页面参考价，尚未取得当前订单的代焊结算价。SS-01GL 也是适合微小电流信号的 0.1A 系列，采用直摆杆；不是只凭“5A型号便宜”就替换。它的脚距、焊片宽厚、安装孔和动作位置已按原厂图对照。

你之前两套标准型总价为 **752.21 元**。按公开经济型规则和旧报价拆分，工厂加工目标约 **240～290 元**，另加匹配后的器件费与包装。**如果**开关代焊单价接近商城4.24元、剩余器件价格及免换料资格不变，则两套部分代焊总额试算约 **315～370 元**。光板、外壳打印、运费和其他工艺收费另计。这是条件试算，不是已获得的系统报价；以 `检查报告/费用推算-工厂代焊.json` 的条件明细和新网页报价为准。

此前“单独主板、开关自买自焊”的方案只保留为研究备选；其约252元试算不能用于本工厂焊好扳机版本。

### 按总成本决定保留哪些零件

扳机小板只负责固定开关，使开关摆杆朝向扳机触点；它没有处理器或重复的陀螺仪。J4是主板的扳机接头、J6是小板接头，两根成品线传递开关通断。当前保留这三个部件，让工厂把开关焊稳，装配时只插线。单纯不装接头不会取消第二款电路的拼板费，还会留下需要焊线的连接；将两款结构改成一款需要另做机构与走线，不能靠清单留空实现。

六件留空分别是：U1原裸传感器；R10/R11原总线上拉；R12原芯片模式选择上拉；C7/C8原芯片局部滤波电容。已有模块具备对应电路。保留主板C4/C5/C6及其他电源、按键、摇杆和检测滤波；本次没有更改供电或操作逻辑。R12/C7/C8所属物料组仍用于其他位置，因此少装三件不会减少整组上料费，材料最低采购量也可能使实付不减少。

原设计只有一个充电灯LED1，其配套限流电阻是R4。两件已直接留空，不需要跳线或补焊；它们仅接充电状态输出，不在充电功率通路内。少两种独立物料，按旧两套备料约少1.14元器件费；目标经济型下它们属于基础库，原本免换料费，所以这次删灯不再减少换料费。充电、触摸、扳机、右键和摇杆逻辑保留，取消的是外部充电指示。

换料费按物料种类收，不按安装颗数收。J3/J4/J5/J6四个接头同为C295747，只算一种物料；R12/C7/C8留空也不消除10k和100nF物料组。按此前匹配分类，经济型仍需重点核对五种普通扩展贴片物料：USB1、U3、U4、SW3和J3～J6；U2及R3此前显示免换料费，新单需确认仍有该资格。官方正常收费口径为经济型基础库免换料费、普通扩展库20元/种；不能将21组总物料直接乘20元，也不能把少装几颗说成少几种换料费。

电源开关SW3、稳压U3、充电U2、供电切换Q1/D1和USB静电保护U4保留。它们承担正常开关机、充电、供电或接口保护。降价优先看能否经济型接单、实际拼板费和收费扩展物料的替换条件；当前没有为省一组费擅自去掉USB静电保护。

参考：[SS-01GL 商城料号](https://item.szlcsc.com/3139927.html)、[欧姆龙 SS 原厂规格书](https://components.omron.com/eu-en/system/files/2024-11/datasheet_pdf/B032-E1.pdf)、[经济型产品说明](https://www.jlc.com/portal/server_guide_30669.html)、[工艺及收费规则](https://www.jlc.com/portal/server_guide_4025.html)、[换料费按物料种类计费说明](https://m.jlc.com/portal/server_guide_38538.html)。

## 外壳和到手装配

`打印文件` 中同名 STL（三角网格打印文件）用于打印，STEP（三维实体交换文件）用于改尺寸。只打印本目录的经济型左右壳和扳机，配本目录右键帽、触摸面盖、摇杆帽、GY模块压框及三厚度扳机设定片。没有要你打印自焊开关支架；扳机开关直接装在工厂焊好的小板上。

建议 PETG（较韧的打印塑料），喷嘴0.4毫米、层高0.2毫米；GY压框4圈壁、壳上压框螺柱附近实心。半壳约180×139毫米，平台至少200×150毫米。设定片打印后量厚度，误差在±0.05毫米以内。

要另备：PA2×20合壳螺丝7颗、PA2×10模块压框螺丝2颗、M2×10外六角螺栓1颗作扳机触点；PH2.0 2P双头成品线1根连接J4与J6，触摸电极线1根、细绝缘线4根加SA0短接线1根，细扎带少量。已有开发板和陀螺模块继续用。电池连保护板/线头须小于31×52.5×8.4毫米仓体并留间隙；扳机弹簧工作长约13.1～9.0毫米，压到底不能并圈顶死。

1. 开关、电阻、摇杆、排母及接口由工厂焊好。收到后将扳机小板沿连接处分离，插入本版左右壳的对应卡槽。若不想自己分板，可在报价时要求分板去毛刺并询其价格。
2. 小板J6与主板J4用成品双头线连接；这是COM（公共端）和NO（常开端）的两线通断，NC（常闭端）未连接。两根机械开关线交换不影响闭合逻辑；电池线不能套用这个结论。
3. 你自己接的是已有GY模块的四线与一根地址短线，不是开关。模块元件面朝整机左侧，与主板元件面同向；模块长边沿枪前后，1脚在枪前下角。支架不依赖未知安装孔，压框箭头朝枪前。
4. 用J1背面大通孔焊盘接线，焊接前拔掉电池、USB及开发板。具体方向见 `GY模块适配说明/GY模块朝向与接线.png`，线沿排母背面向后汇合，再从主板下缘绕到模块，不压滑轨或壳缝。

| 主板J1 | 模块芯片接口 | 含义 |
| --- | --- | --- |
| 1脚 | 1脚VCC | 3.3V |
| 22脚 | 2脚GND | 地 |
| 15脚 | 3脚SCL | 时钟，IO9 |
| 12脚 | 4脚SDA | 数据，IO8 |
| — | 5脚SA0短接2脚GND | 地址0x6A |
| — | PS模式脚悬空；CS保持模块原上拉 | 使用芯片直接接口 |

模块外形按17.8×20.6毫米，板厚支持0.8～1.6毫米，正面排针突出≤6毫米、背面≤4毫米，焊点包络直径≤2毫米；不用杜邦插头。超出支架尺寸时先调支架，不强压合壳。四根线外径每根≤0.6毫米，线束包络≤1.6毫米。使用模块板自身上拉及滤波，所以主板U1/R10/R11/R12/C7/C8均不装。

5. 右壳内装电池、焊好的小板、弹簧、扳机、主板，接触摸线和扳机线。主板J3的1脚BAT+是正极、2脚是地，接电池前量极性。铜箔在扳机薄触摸盖下面，不垫厚泡棉。
6. 合壳前断电并拔开J4连接线，在扳机小板的开关两端用万用表导通档和1.0毫米设定片调整触点：由完全松开开始压到设定片，触点从浅调到刚导通；重新用0.8毫米片应导通、1.2毫米片应断开，撤片后完全松开应断开。若用程序观察触发，则正常连接J4并供电，不同时用导通档测量。具体允许调整范围、测量基准和装配图见 `扳机装配与调整.md`。这是人工校准范围，不能无限向外退出螺栓。
7. 抽出片，接回J4，装右键帽、模块压框、左壳、摇杆帽，合壳后复查按到底导通、松开复位。小板与主板的连接线、外壳及真实焊点都应留出线束余量。

## 使用逻辑保持原样

固件未改。手指轻贴扳机启用体感移动，不触发点击；扣扳机是左键按下，扣住保持，松开释放。松开机械扳机但手指仍贴着时体感继续；手指离开后体感停止并清除积压。侧键是右键，摇杆按下是中键，推摇杆是光标移动，幅度越大越快；摇杆和体感位移相加，充电插拔不自动暂停鼠标操作。

首次使用先单独给开发板烧本目录 `固件/gun_mouse.ino.merged.bin`，再插主板；上电时手指离开触摸面、摇杆回中，放稳约3秒自动校准，电脑蓝牙添加 **GunMouse EVT-A**。模块必须按芯片接口及指定轴向安装，不用模块处理器输出的角度模式。

正常闲置不自动睡眠；低电量且无USB时按原程序休眠。首次可通过串口 `log` 看状态，`jdir/jsave` 标定摇杆，`invx/invy` 调体感方向，`sens 数值` 调速度，`tp/tr` 调触摸门限，设置保存在开发板。

Windows烧录使用原工具，把合并程序写到地址0x0并选择实际开发板端口。开发板插在主板上时不要同时从开发板自己的USB口供电；底部接口的实际下载可靠性仍需首件验证。

## 已核对和仍需首件确认

`检查报告` 保存原理图与PCB、铜线及过孔、元件清单和坐标、开关焊片与机构、模块支架及固件文件的核对结果。本版保持主板原走线、过孔、五个安装孔和内部过线槽，原理图与电路板采购属性同步，没有靠关闭规则放过不一致。

文件层核对不能代替实物验收。首件重点确认开关真实动作和复位、打印配合、模块通信/方向、触摸门限、USB插拔、充电温度与蓝牙效果。原工程样已把充电电阻改为6.8k，约176毫安；本轮沿用该值及R5的10k。原主板USB长线和没有电池温度检测的限制仍在，软件规则通过不表示温升或底口下载已实测通过。
