guiwushengzhe-prog/gun-mouse/deliverables/经济型改版/README.md

# 枪型飞鼠：自焊开关备选方案（本轮不采用）

用户已明确改为由嘉立创采购并焊好便宜开关。本目录只保留此前自焊方案的研究记录，不是本次推荐下单包；请使用相邻的 `经济型工厂代焊版`。以下关于自购开关、单独主板和 250～280 元的试算不适用于工厂焊好扳机的推荐版。

这套文件用于重新下单试价：只生产一款主板，扳机改用自购的欧姆龙 **SS-01GL 直摆杆微动开关**，陀螺仪使用你已有的 **GY-601N1-LSM6DSV16X 模块**。工厂继续焊主板上其余 43 个器件，包括排母、摇杆、右键、充电、供电和接口。新开关有专用打印支架；左壳增加模块定位和压框，右壳与扳机按新开关重新适配。

本版已完成文件和模型核对，用于首件打样。实际打印、开关动作、模块通信、充电温度和无线效果尚未实物验证；“经济型”是否开放及最终价格以新订单审核为准。不要拿旧的主板加扳机小板拼板订单配这套清单。

## 重新下单用哪三个文件

只上传本目录 `制板文件` 中这三个文件：

1. `gun-mouse-economy-v2-Gerber.zip`：制板生产文件，只有主板。
2. `gun-mouse-economy-v2-BOM.csv`：物料清单，每板 22 组、43 个工厂安装器件。
3. `gun-mouse-economy-v2-坐标文件.csv`：对应 43 个器件的位置和角度。

两个 CSV（表格文本文件）沿用设计软件导出的 UTF-16、制表符格式；直接上传，不必用表格软件重新保存。

重新建立 PCB（印刷电路板）订单，选择：2 层、1.6 毫米厚、普通 FR-4 玻纤板、单款单板、绿色阻焊、白色文字、每平方英尺一盎司铜、普通表面处理。外框和内部电池过线槽按文件铣切，**不要 V 割，不要再加扳机小板**。外框约 11.93×13.43 厘米，不要沿用原订单加过工艺边后的 13.43×12.93 厘米来改图。加工方若需要生产工艺边，按实际贴装工艺审核，不手动缩放文件。

接着下 SMT（元件贴装和焊接）订单，按这几处填写：

| 网页项目 | 本版选择 |
| --- | --- |
| 关联 PCB | 新的 `gun-mouse-economy-v2` 订单 |
| 贴片数量 | 其他数量：2 片；这是此前网页显示的最小数量 |
| 剩余光板 | 光板随单发货 |
| 焊接层 | 只贴顶层 |
| 应用行业 | 消费电子 |
| 产品类型 | 经济型；若仍不可选，看提示的具体原因，不直接用旧标准型报价付款 |
| 生产时间 | 普通交期，不加急 |
| 确认 DFM | 可保留 3 元的可制造性确认，便于首件复核 |
| 确认钢网 | 不需要额外人工确认；这不是取消焊接所需钢网 |
| 个性化服务 | 保持无额外要求；不加整盘采购、喷涂、灌胶或烧录服务 |

建议把下面的备注随新订单提交，由你在网页里粘贴：

> 本单为单款独立主板，铣外形及内部过线槽，不做 V 割，不含扳机小板。申请经济型、只焊顶层。按所附物料和坐标安装每板 43 个器件，U1、R10、R11 不装，其焊盘不得开钢网或涂锡膏；SW4、J6 已从新 PCB 删除。J1/J2 排母、SW1 摇杆、SW2 右键及 USB1 固定脚请完整焊接。陀螺仪模块和扳机开关由用户板外安装。如经济型不能接，请注明具体器件或工艺原因，并列出费用明细。

本版不需要分离扳机小板。工厂采用合拼生产仍可能按其规则增加生产边或治具；软件显示可选经济型和审核确认，比静态文件判断更直接。

## 为什么这次能降价

你此前的两片标准型报价是 **752.21 元**，其中元件 172.54 元、加工 579.67 元；拼板费 150 元、工程费 150 元、钢网费 50 元、换料费 168 元是主要费用。

| 改动 | 对费用的影响 |
| --- | --- |
| 删除扳机小板、连接桥和邮票孔，变成单独主板 | 去掉原来的多款拼板原因，争取免去 150 元拼板费 |
| 不贴 U1 裸芯片，复用已有模块；R10/R11 不贴 | 两板少买约 41.86 元裸芯片及原两路上拉；也去掉裸芯片的射线检查需求 |
| 扳机 SS-01GL 自购、装在打印支架上，删除 J6 | 不再支付原报价两只开关 62.60 元及小板接头费 |
| 申请经济型 | 官方说明经济型工程费 50 元、不收钢网费；具体剩余换料费和插件费看新匹配结果 |

根据当前费用规则，**两片部分装配主板争取约 250～280 元**，这是试算目标，不能当作已取得的系统报价。光板费、外壳打印、自购开关/辅料、运费另计；如果扩展库免换料资格、材料价格或工艺要求变化，实际金额会变化。你只有一块陀螺仪模块，本次可先组一把，第二块部分装配板作备件。

SS-01GL 的立创商城参考价查到约 **4.24 元/只**，商城料号 **C2896769**；这是页面参考价，结算价和运费另看。原 SMT 页面给 SS-01GL13 的单价是 31.30 元，二者不是同一杠杆型号。你截图中同型号 SS-01GL13 的两只实付合计 4 元，也说明零售渠道价格可以低得多；截图不能核实其供货质量，原 SMT 的具体采购定价原因未公开，不能把差价都归因于镀金触点。

SS-01GL 属于适合微小电流信号的同系列 0.1A 型，动作高度和杠杆几何已按原厂图更新支架与扳机。不要只看“5A 更便宜”就换普通功率开关；不要购买无柄、滚轮或带 `D` 后缀的插板脚型号来配本支架。

参考：[开关商城页](https://item.szlcsc.com/3139927.html)、[欧姆龙 SS 原厂规格书](https://components.omron.com/eu-en/system/files/2024-11/datasheet_pdf/B032-E1.pdf)、[嘉立创经济型说明](https://www.jlc.com/portal/server_guide_30669.html)、[加工收费与工艺说明](https://www.jlc.com/portal/server_guide_4025.html)。

## 要打印和自购什么

`打印文件` 中的 STL（三角网格打印文件）已按打印姿态摆好；同名 STEP（三维实体交换文件）供改尺寸。不要混用旧版左右壳和旧版扳机。

| 零件 | 数量 | 本版用途 |
| --- | --- | --- |
| 左半壳-经济型、右半壳-经济型、扳机-经济型 | 各 1 | 已适配模块和新开关 |
| 扳机开关支架-SS01GL、GY模块压框 | 各 1 | 不用胶粘固定开关和陀螺仪 |
| 右键帽、扳机触摸面盖、摇杆帽 | 各 1 | 沿用工程样相应零件 |
| 扳机设定片 0.8、1.0、1.2 毫米 | 各 1 | 组装时设定触发点，测后保存作检具 |

建议壳体和支架用 PETG（较韧的打印塑料），0.4 毫米喷嘴、0.2 毫米层高。模块压框 4 圈壁、螺柱附近实心；大半壳平台至少约 200×150 毫米。设定片打印后量实际厚度，误差控制在 ±0.05 毫米。

| 自购/已有物品 | 数量 | 要点 |
| --- | --- | --- |
| 欧姆龙 SS-01GL，焊片脚、直摆杆 | 1；可另买 1 备用 | 本版扳机开关 |
| M2×16 螺栓、M2 螺母和平垫圈 | 各 2 | 夹住开关；不把微动塑料本体压变形 |
| M2×10 外六角螺栓 | 1 | 扳机的可调触点，六角对边 4 毫米 |
| PA2×10 盘头自攻螺丝 | 2 | GY 压框，轻拧固定即可 |
| PA2×20 盘头自攻螺丝 | 7 | 合壳夹主板 |
| PH2.0 2P 单头端子线 | 1 | 插 J4，裸线焊开关；先以 10 厘米作首样长度 |
| 细绝缘线 | 4 根及 1 根短接线 | 模块外径每根不大于 0.6 毫米，四线束包络不大于 1.6 毫米 |
| 热缩管、细扎带 | 少量 | 绝缘开关焊片，固定线束 |
| 已有 GY-601N1-LSM6DSV16X、YD-ESP32-S3 开发板 | 各 1 | 复用；开发板排针与 22P 排母匹配 |
| 带保护板和正确 PH2.0 极性的 3.7V 电池 | 1 | 含保护板/线头需小于仓体 31×52.5×8.4 毫米并留装配间隙 |
| 扳机弹簧、触摸电极线及薄面盖胶 | 各 1 | 沿用工程样装配；弹簧工作长度约 13.1～9.0 毫米，避免压实后顶死 |

## 开关和模块怎样接

所有焊接在拔出电池、断开 USB、开发板未插入主板时完成。你需要焊的是开关两根线、模块四根线与一根短接线；不需要手焊裸陀螺芯片或 0402 小器件。若触摸电极尚未预制，另做其线端连接。

开关只用 **COM（公共端）和 NO（常开端）**：接到主板 J4 的两根线。J4 的 1 脚是扳机信号、2 脚是地；机械开关两根线互换不影响通断。NC（常闭端）不接，焊片包绝缘。先用万用表确认：放开时断开，压杠杆时导通。按开关端子标注识别，不能把“中间脚”一律当公共端。

模块必须接其“芯片接口”，使用下表，不能接成模块处理器输出模式：

| 主板 J1 焊盘 | 模块端 | 功能 |
| --- | --- | --- |
| 1 脚 | 1 脚 VCC | 3.3V 供电 |
| 22 脚 | 2 脚 GND | 地 |
| 15 脚 | 3 脚 SCL | 时钟，接开发板 IO9 |
| 12 脚 | 4 脚 SDA | 数据，接开发板 IO8 |
| — | 模块 5 脚 SA0 短接模块 2 脚 GND | 固定地址 0x6A |
| — | PS 模式脚悬空，6 脚 CS 保持模块原上拉 | 直接使用芯片接口 |

线焊在 J1 **背面的较大通孔焊盘**，不要塞入排母插孔。J1 从 1 脚朝 22 脚数，1 脚在枪前端天线一侧；先数脚并量地线，不凭照片猜方向。GY 模块自身已有数据和时钟上拉，所以主板 R10/R11 留空。

模块芯片元件面朝整机左侧，与主板元件面同向；长边沿枪前后，模块 1 脚在枪的前下角。先在壳外焊好线，再夹入左壳定位轨，压框箭头指向枪前，用两颗 PA2×10 螺丝轻拧固定。不能让模块在壳内晃动。支架按模块 17.8×20.6 毫米外形、板厚 0.8～1.6 毫米设计；正面排针突出不超过 6 毫米、背面不超过 4 毫米，不加杜邦插头。实物超出这些范围需调整支架，不能强压合壳。

四线先在主板背面沿排母下方向后汇合，再从板下缘绕到模块；开关线和触摸线沿各自槽走，给扳机保留活动余量。看 `装配说明图` 的位置图，不把线束压在滑轨、壳缝或螺柱上。

## 装配和首次使用

1. 单独给开发板烧入本目录 `固件/gun_mouse.ino.merged.bin`，再拔下开发板准备装配。它是原工程样的同一份程序，本轮未改固件。
2. 焊好模块和开关线。把 SS-01GL 用两颗螺栓装到专用支架，直摆杆朝扳机；支架滑入原小板位置的卡槽。开关底面、两个安装孔和杠杆端点按支架定位，不能换方向装。
3. 右壳内放电池、支架、弹簧和扳机，主板放到五个定位孔，插好 J4 和触摸线 J5；铜箔位于扳机触摸面盖下面。
4. **合壳前设定扳机触点**：先拔掉 J4，万用表蜂鸣档跨接开关两线。把 1.0 毫米设定片夹在滑杆后端与弹簧座之间，压住扳机；从浅到深调 M2 触点，刚导通即停止。松开后重新压 0.8 毫米片应导通，重新压 1.2 毫米片应断开。每次由完全松开开始，避免开关回差影响判断。具体螺栓边界及测量位置见 `扳机装配与调整.md`。
5. 抽出设定片，确认没有片时扳机按到底导通、放开断开、能回弹，再插回 J4。装右键帽、模块左壳，布好线并合壳，装摇杆帽。合壳后复查一次触发和复位。
6. 插电池前核对 J3 的 1 脚 BAT+ 是正极、2 脚是负极。电池端子线不同店家可能相反，不能只看插头可插就接。
7. 开电源，手指离开扳机、摇杆回中，把飞鼠放稳约 3 秒完成启动校准。电脑蓝牙添加 **GunMouse EVT-A**，然后即可按下表使用。

| 手上的动作 | 鼠标动作 |
| --- | --- |
| 手指轻贴扳机，不压机械开关 | 启用体感移动，不点击 |
| 摸着扳机转枪、抬头低头 | 光标随转动移动 |
| 扣下扳机 / 一直扣住 / 松开 | 左键按下 / 保持按下 / 释放 |
| 松开机械扳机，手指仍轻贴 | 左键释放，体感仍启用 |
| 手指离开触摸面 | 体感停止，清除积压位移 |
| 侧面右键帽 | 右键 |
| 按摇杆 | 中键 |
| 推摇杆 | 移动光标，偏得越多速度越快 |
| 同时推摇杆和转枪 | 两路位移相加 |
| 插拔充电线 | 不自动暂停鼠标操作 |

正常闲置不自动睡眠；低电量且未插 USB 时会按原程序进入休眠。首次确认方向、触摸门限和速度可通过串口设置保存：`log` 看状态，`jdir` 标定摇杆方向，`jsave` 保存范围，`invx/invy` 反转体感方向，`sens 数值` 调速度，`tp/tr` 调触摸门限。

程序烧录路径和原文件校验在 `固件/固件文件校验.json`。Windows 上用原来的烧录工具把合并文件写到地址 `0x0`，先选实际开发板端口；底部充电口兼有下载布线，但其实际下载可靠性尚未验收。开发板插在主板上时，不同时连接开发板自己的 USB 电源口。

## 本次核对到什么程度

`检查报告` 保存设计软件规则、主板生产文件、物料和坐标、开关机构、模块固定和固件校验的结果。主板保留全部原有走线、过孔、五个安装孔和内部过线槽；新外框仅去掉扳机小板及其连接内容。未通过关闭规则来制造“零错误”。

打印件实体和网格检查、规定尺寸内的模块/排针/线束包络、开关支架与调整行程、主板及开发板的静态避让，属于文件层验证。首件仍需确认打印误差、螺栓设定后的真实动作和复位、GY 通信及三轴方向、触摸灵敏度、USB 插拔、充电温度与蓝牙距离。这一轮降本没有重新设计原主板的 USB 长线或增加电池温度检测，所以不能把规则检查通过当作这些问题已实测通过。
