guiwushengzhe-prog/gun-mouse/docs/工作记录.md

# 工作记录

## 2026-10-04：工具选择与环境检查

- 用户要求先选择能全程通过程序配合工作的软件，再安装；不用拖拽界面设计。
- 用户指定项目和工作树都放在 `F:\项目\枪型飞鼠`，软件在 `E:\各种软件` 下新建目录安装。
- 初始项目目录为空，尚未建立版本库。
- 本机已有嘉立创专业版，程序属性与安装记录均为 `3.2.149`，目录为 `E:\各种软件\lceda-pro`。
- 官方文档要求客户端至少 `4.1.60` 才有本地命令行桥接。自动布线的具体接口备注要求 `4.1.66` 或 `3.2.150`。新版安装包实际版本与接口能力须现场验证。
- Miniforge 和 CadQuery 尚未发现安装。官方推荐独立环境，不修改已有 Python 的注册关系。
- 嘉立创官方命令行文档：https://prodocs.easyeda.com/cn/api/guide/cli.html
- CadQuery 官方安装说明：https://cadquery.readthedocs.io/en/stable/installation.html
- Miniforge 官方发行页：https://github.com/conda-forge/miniforge/releases/latest
- GitHub 的发行接口本次返回共享出口请求额度已用完；下载应使用官方发行页面或固定版本地址。

## 2026-10-04：安装完成与真实板壳联动

- 官方实时下载页列出 4.1.60；同一官方域名的 4.1.66 安装包实际可下载。下载后程序属性确认为 4.1.66，数字签名有效，签发给深圳嘉立创科技集团股份有限公司。
- 4.1.66 官方下载：https://image.lceda.cn/files/lceda-pro-windows-x64-4.1.66.exe 。完整安装包 SHA-256 为 `5129b41cf0b0736dc46a4e52d2089b92fa511764ae1e128126a41541dbd62b12`。普通单连接约需 40 分钟，改用服务器支持的分段下载后完成，并与官方存储返回的校验值核对。
- 新版安装至 `E:\各种软件\嘉立创专业版4`，退出码 0，不需重启。原 `E:\各种软件\lceda-pro` 的 3.2.149 程序保留。
- Miniforge 26.7.2-0 下载与官方校验通过；安装器明确拒绝非英文路径。建立 `E:\GunMouseCAD` 到 `E:\各种软件\枪型飞鼠设计工具` 的永久目录联接后，安装成功，退出码 0。
- 用户随后允许 E 盘英文目录，并表示如果取消联接还需额外处理则不用管。本次保留已经在使用的联接，不迁移、不重装。
- CadQuery 2.8.0 与 Python 3.12.14 独立安装在 `E:\GunMouseCAD\CadQuery`，退出码 0。物理文件在 `E:\各种软件\枪型飞鼠设计工具\CadQuery`。可直接运行环境内的 Python，不需改全局环境变量。
- mamba 2.9 曾把索引中存在的 Python、pip、CadQuery 都判定为不存在。改用 conda 的传统解析器和完整官方索引后成功安装。精确环境清单记录 212 个软件包，已放入版本管理。
- CadQuery 实体建模、穿孔、体积核对、实体格式导出并重新导入、三角网格导出均通过。
- 嘉立创本地诊断确认连接、版本匹配与结果通道均有效，实际编辑器版本为 4.1.66。原理图器件、导线、板框、焊盘、自动布线、设计规则和三维导出接口均存在。
- 在 F 盘工作树中通过空工程索引与程序接口创建了独立工具验证工程。程序生成一块配置为 40×24×1.6 毫米的矩形板与四个孔，保存后核对磁盘文件。板框图元为 1、孔图元为 4，示例裸板设计规则检查通过。
- 嘉立创二维图元接口使用密耳（千分之一英寸）和向下的 Y 轴；共享配置是毫米与向上的机械 Y 轴，脚本显式换算。
- 嘉立创导出裸板实体文件 36,117 字节，CadQuery 实际导入后四孔核对通过，装配与外壳导出完成，板壳交集体积为 0。
- 裸板实测为 39.97467994936×23.97464794929×1.600028244856 毫米。四孔中心约（±16.00003302006，±8.00001524003）毫米，孔径 2.40000508001 毫米。导出与配置的尺寸差满足 0.05 毫米公差；模型原点一致，没有搬移或旋转。
- 实际板与按实测尺寸重建实体的对称差体积为 0。与理想配置实体的对称差体积为 2.62147 立方毫米，记录在几何报告中，没有隐去导出精度差。
- 首次启动常驻编辑器时，后台进程会继承标准输出管道，使宿主等待。命令封装改用临时文件重定向后避免这种等待；冷启动脚本还须等待工程加载完成再读当前工程。
- 关闭窗口后，嘉立创的窗口列表仍保留状态为 `closed` 的记录。收尾判断必须只统计 `alive`；只关闭本脚本创建的窗口，避免影响用户其他窗口。
- 此阶段只验收工具与几何联动。真实飞鼠硬件方案、枪形外观、元件空间、布线质量、握持手感与生产均尚未验收。
- 自动联动脚本的完整冷启动实测通过，退出码 0：诊断→后台打开示例→等待工程和板信息就绪→导出真实板→生成外壳和装配→核对孔位与碰撞→关闭自建窗口→停止自建后台服务。收尾进程检查未发现本次测试遗留的嘉立创进程。

## 2026-10-04：可长期复用的原生三维查看

- 用户希望图形化查看现有成果，并关心以后是否每次都要制作预览。选择嘉立创内置板预览与 CadQuery 配套 CQ-editor 完整装配窗口，日常使用不需重新制作展示页面。
- 官方说明嘉立创的“视图→3D预览”能查看板与已绑定模型的器件，“3D外壳预览”针对自身绘制的外壳；未找到把外部 CadQuery 枪形外壳直接导入完整装配的官方支持说明，不能以元件三维模型导入代替此能力。
- CQ-editor 的官方 conda 包要求 CadQuery 的开发版，与已固定的 2.8.0 不兼容。仅做预演后，选择独立 `E:\GunMouseCAD\CQEditor` 环境，复制已有已验证核心并安装界面依赖，不改变原建模环境。
- 查看器固定官方 master 提交 `fd215727b25424df9b69987ece94767b8b327f0f`，版本 `0.8.dev0`，源码保存在 `E:\GunMouseCAD\CQEditorSource`。新增 21 个依赖的精确版本纳入 `config/cq-editor-gui-requirements.txt`。首次依赖清单漏了源码需要的 requests，实际导入失败后补齐，并完成全量依赖核对。
- 依赖检查、组件导入和命令帮助均通过。两个环境核心均为 Python 3.12.14、CadQuery 2.8.0、几何内核 7.9.3.1，核心构建号相同，原 Python 文件 SHA-256 未改变。安装证据位于项目根 `.logs/cadquery-cq-editor-setup.json` 与 `cadquery-cq-editor-core-audit.json`。
- `view_assembly.py` 直接导入实际裸板和外壳实体，分别赋予中文对象名称；绿色板、不透明，蓝色外壳约 65% 透明，原始装配坐标保留。可分别隐藏。
- `open_preview.py` 打开原生软件窗口，提供中文刷新与视角按钮、启动即显示和自动刷新。完成报告需晚于两份模型，读取前后核对文件状态，检查报告与实体完整性后复制到进程私有快照，避免读到半写出的板壳。显示成功后才记录刷新状态，加载失败可重试。
- 原生窗口实测通过，实际显示两个中文对象，自动退出检查退出码 0。随后在窗口开启时实际重新生成外壳与装配，模型有效、交集体积仍为 0；窗口显示次数从 1 增为 2，自动刷新通过，查看证据为 `outputs/toolchain-demo/preview-state.json`。
- `setup_preview_shortcut.ps1` 创建项目根的“查看板和外壳”快捷方式；入口源码纳入 Git，机器相关快捷方式排除提交。
- 静态预览通过已有 CadQuery、VTK 和图片库从实际模型离屏绘制，没有截图用户桌面；显示装配及独立外壳四柱贯穿孔。图位于 `outputs/toolchain-demo/assembly-preview.png`，可以在会话中直接展示。
- 本阶段模型仍是矩形板和开口盒的工具联动示例，不代表正式枪形飞鼠电路、外观、手感、强度或制造验收。

## 2026-10-05：V1-Concept-01、触摸扳机与器件资料

- 用户提供新规范及相关购物截图，并明确本版采用普通 PS2 五针摇杆；较早的握把触摸方案被替换为食指扳机触摸启停，继续按压机械左键。左键与体感许可为独立输入，不使用轨迹球及新增功能键。
- 在项目内部 `concepts-v1` 工作树和 `codex/concepts-v1` 分支继续工作。主目录已有 `pcb/toolchain-demo/panel/Panel1.epan2` 的用户修改，保留，不纳入本次提交。
- 旧三张握把触摸概念图保留于 `concepts/v1`，标明不用于当前方案。新版两种外观与触摸扳机原理图放入 `concepts/v2`，全部取消握把触摸区。
- 查到原厂芯片、模组、微动及触摸检测参数，但不能将芯片或另一厂家的同名板尺寸当作实际整板尺寸。DZYJ 摇杆、广运惯性模块、优信开发板、现有触摸板、电池及电源模块占位尺寸继续留空。
- 订单只写 SS-01GL，截图为打包中；规范的 SS-01GL111 为不同长柄型号。分别记录 14.5/22.6 毫米杆长及 0.49/0.39 牛顿最大动作力，不混写采购状态，不生成最终支架孔。
- TTP223 仅作实验；AT42QT1011 为未采购候选。没有把扫描间隔当作抬指响应，也没有承诺触摸立即无延时释放。移动电极、固定检测板及短柔性引线是待实测的建议结构。
- 用户输入的向前、向右、向上实际组成左手系，与“右手坐标系”称谓冲突。已提出将 Y 改为向左的建议并询问，确认前不创建正式装配坐标。配置保存待确认状态和空原点。
- 第二张外观初稿出现了错误方向的厚度标注及未要求的有线鼠标文字，已通过图像编辑删除，保存修正版本；探索包络仅作文字目标，不作为比例加工图。
- 三张图、设计输入、原厂来源及未确定尺寸记录纳入版本管理。本阶段未创建最终 PCB 焊盘、安装孔、参数化制造零件或打印文件，也未写设备固件。

## 2026-10-05：用户资料包、坐标确认与低成本触摸方案

- 用户明确接受 X 向前、Y 向左、Z 向上的右手坐标系。更新当前设计输入和配置，保留原坐标提议为历史；装配原点由整体布局统一选择。
- 用户提供 `ESP32-S3资料.rar` 和 `GY-601N1_1.rar`，授权解压到项目合适位置。使用本机已安装的 7-Zip 完整解压到 `器件资料/原始资料`，共564个文件、118,525,141字节，保留原包和原目录。包内其他芯片示例保留，但不采用为本版器件。
- 常用公制/英制尺寸图、开发板电路图、厂家介绍、GY模块说明及LSM6DSV16X手册复制到 `器件资料/参考图纸`，共9份。参考图纸、索引和来源校验纳入版本管理；原包、原始解压全量和临时文档解析文件留在本机，避免将软件及编译产物重复纳入仓库。
- 使用已有本机 Python 3.13 文档读取库和原生文档工具，无新增安装。读取文字后实际查看完整尺寸页与GY说明书前两页，没有依据照片像素推算尺寸。未运行包中烧录程序、示例或设备写入。
- ESP32-S3公制图主板57.15×27.94毫米，含伸出天线总长63.39毫米，两排针中心距25.40毫米、每排22针；2.54毫米节距由53.34毫米首末中心距推算。未给厚度、总高或独立安装孔。旧尺寸图与V1.4电路的局部元件并不一致，记录版本待匹配，不把伸出天线画成主板矩形。
- 广运GY-601N1说明书V1.0给出模块17.8×20.6×2.8毫米、整板3～5V，随包电路图显示3.3V稳压。200次/秒是板上角度输出描述，不是LSM6DSV16X本身采样上限。排针总高、安装孔和尺寸轴映射仍待核对。
- 查规范后区分：SS-01GL可依据对应原厂轮廓图；普通PS2摇杆整板、TTP223模块、电池及充电升压板没有由泛称就能确定的统一整件尺寸。插口、芯片封装及针距不能代替模块外形。没有为找图纸擅自换购用户器件。
- 用户提出SS-01GL上贴铜箔检测触摸，要求简单便宜。当前低成本原型复用该开关、铜箔和现有TTP223；铜箔接确认后的感测节点，触摸输出和机械点击独立。建议隔绝缘层贴金属柄，或以小打印帽内贴铜箔再压微动。已询问两种安装方式，未回复前不冻结位置，仍可完成独立的资料整理。
- 工作期间保留用户对 `pcb/toolchain-demo/panel/Panel1.epan2` 的修改，不将其暂存或提交。
- 进一步确认S3具有专用电容触摸通道，可作为省去TTP223模块的对比路线；普通数字输入不能替代触摸配置。旧官方stable路径已迁移，采用当前可打开的 `cap_touch_sens.html` 中文文档；该路线未选针、未实现、未做实物延时验证。

## 2026-10-05：省去触摸板与内部布局原型

- 用户决定省去TTP223，并授权按可查到的资料继续内部原型图。本轮主控固定为已有ESP32-S3，铜箔接其专用电容触摸输入，SS-01GL机械点击独立输入；TTP223、AT42QT1011、nRF52840均不装入本轮。历史采购与候选记录保留并明确当前使用状态。
- 建立项目内`internal-layout-v1`工作树、`codex/internal-layout-v1`分支。主目录的`pcb/toolchain-demo/panel/Panel1.epan2`是既有用户改动，继续保留，不纳入提交。
- 上壳纵向安排主控，天线向前；左上后侧部分内嵌普通PS2摇杆，右键位于其下方。惯性模块设独立刚性固定区，微动在扳机后方，电池中下握把绝缘安装，充电与供电空间留在底部。开发板维护口与底部电池充电口分别说明。
- 本轮图采用打印扳机帽内侧铜箔的结构建议，与金属杠杆绝缘；柔性触摸线留活动余量和固定点，机械限位由壳体承担。帽形、杠杆行程及触摸稳定性尚未实物验证，不把建议作为已定的加工尺寸。
- 主板平面、天线延伸和惯性模块名义轮廓使用用户资料，微动用欧姆龙对应图。普通PS2与700mAh电池没有凭型号泛称就能得到的统一尺寸，引用Joy-IT、DNK具体同类产品仅作参考区；电源板、右键和未知高度是设计预留体积，不是实测。
- 配置`config/internal-layout-v1.json`共用X向前、Y向左、Z向上。新增程序化占位参考生成脚本，导出两张参考图、彩色实体交换文件及规划盒报告。重新导入有效；盒检查不是实物碰撞验收，没有创建最终安装孔、焊盘或打印零件。
- 壳体40毫米的探索厚度下，摇杆参考区使规划总宽达到49毫米；实际杆帽、摆动与安装座仍需核对。微动与扳机帽盒少量重叠是概念按压关系，不声称机械结构已经验证。
- 用户反馈摇杆较大。查到17.5×17.4×12毫米迷你双轴裸件和19×19×9毫米PSP式裸件，但均无按下开关。只留作后续换装对照，本版不替换现有PS2，也不根据海外零售页承诺国内价格及供货。
- 图像生成输入保留于`concepts/v3/生成说明.json`。本轮交付内部透视、分解安装及触摸/线束三张解释图，取消独立触摸检测板；图形用于结构讨论，与参数化占位文件分别保存。
- 图形复核修正了重复摇杆示意、错误的天线净空长度标注和电池插口，并统一惯性模块位于主控下方；进一步将未知板孔固定改为夹边托架，明确分解图中央为支撑骨架、外壳仍只有左右两片。修正使用内置图像编辑工具，保留原图与修改输入，不按效果图制造孔位。

## 2026-10-05：PCB 与外壳 V1

- 用户要求在独立分支 `claude/pcb-shell-v1`、工作树 `.worktrees/pcb-shell-v1` 中完成主板与参数化外壳，优先插接和工厂贴装，以首轮打印可完整装配为目标；随后说明要求只作参考，可做合理决策，并确认立创、淘宝、京东能买到的器件都可以用。主目录 `pcb/toolchain-demo/panel/Panel1.epan2` 的既有修改保留未动。
- 读取开发板公制尺寸图与 V1.4 电路图（J1-21 的 5Vin 经二极管进入板上 5V，板载稳压 CJ6107A33），GY-601N1 说明书第 10 页模块尺寸图与电路图（SA0/SDx/SCx 接地、CS 10k 上拉）。
- DZYJ 摇杆没有任何尺寸资料，改用立创 Alps RKJXV1224005（C146170，原厂图 5KJXV05/KJXV14005：摆角 23°、Ø4 削边轴、板面到轴顶 18.95～19.65）；惯性模块改为主板贴装同型号 LSM6DSV16XTR；未知充电板改为 TP4056 + AO3401A 负载共享 + RT9080-33。理由见 `docs/PCB与外壳-V1.md`。
- 用嘉立创接口按立创编号读取器件、放入探测工程，导出 STEP 后用 CadQuery 统计各器件三维外廓，结果保存为 `config/pcb-parts-geometry.json`。下载并阅读了 SS 系列、D2FC、MSK12C02-HB 规格书：SS-01GL13 是模拟滚轮杠杆焊片版（1=COM 2=NO 3=NC），按压方向垂直于安装板，因而做竖立的扳机小板；SS-01 与 D2FC 为微负载触点，上拉改为 2.2k/3.3k。
- 嘉立创专业版 4.1.66 在后台会话中：`pcb_Document.importChanges` 返回 true 但不导入；`sch_Netlist.getNetlist` 超时；`pcb_Document.autoRouting` 一直挂起且板上无任何走线（进程空闲，确认后关闭会话）。改为：接口放置器件 → 直接改写 `.epcb2` 中 `PAD_NET` 记录写入网络（编辑器自动重载，接口逐一核对）→ 本仓库 `route_grid.py` 网格布线 → 写回嘉立创 → 嘉立创规则检查复核。
- 布局与板框由 CadQuery 从外壳轮廓内缩计算。曾因平面布尔合并未统一面而丢失扳机小板和底部下探块，改为拉成薄实体做布尔后取顶面，已修正并复查。
- 布线器经三次修改：焊盘禁布余量过大导致 Type-C 0.5 毫米间距焊盘无法进入；统一线宽模型下惯性芯片 0.5 毫米间距扇出失败；改为按线宽分类的局部精确膨胀模型（信号 0.15、电源 0.3、间距 0.13），并为惯性芯片电源脚加预连线、CS 改 10k 上拉；电池/USB 分压电阻移到握把内以减少粗线上行。
- 后台会话中覆铜填充无法重建，改为地网络与其他网络一样用导线连通，不铺铜。写回走线时发现导线须在过孔之后创建才会与过孔连通（在探测工程中用 6 组小实验验证）；走线参数超过命令行长度后改为分批写入。
- 最终结果：48 个器件、28 个网络全部连通，导线 564 段、过孔 95 个，电源与地 0.3 毫米；嘉立创规则检查间距与连通错误为 0，仅剩网表关联提示（后台无法从原理图导入，原理图由同一网表生成，唯一编号已对齐）。导出 Gerber、BOM、坐标文件、网表。
- 外壳：两半壳、扳机、扳机触摸面盖、右键帽、摇杆帽 6 个打印件；与嘉立创导出的主板三维模型（含器件）整机装配，干涉检查仅剩设计内的微动杠杆预压与贴合面接触；扳机硬限位、复位限位、摇杆 24° 开口限位、右键帽沿限位的反向验证均成立。摇杆轴按三维模型切片确认为 Ø4 双削边（对边 3.0）。
- 交付件位于 `deliverables/pcb-shell-v1`，检查结果由 `scripts/pcb_shell_v1/report.py` 自动生成 `检查报告.md`。整机装配 STEP 约 100MB，以压缩包形式提交。

## 2026-10-05：保持原设计的副本收尾

- 找到原成果分支 `claude/pcb-shell-v1`，位于项目 `.worktrees/pcb-shell-v1`。收到用户“另建副本提交”的新指令前，已在原分支完成原样保存提交 `dff2043`；没有改动其设计文件。随后在 `.worktrees/pcb-shell-finish` 建立 `codex/pcb-shell-finish`，复制未纳入版本控制的报告与装配参考文件，所有后续修改及提交只在副本中进行，主目录与原工作区不再写入。
- 保留原 AI 的器件、供电、板形、元件位置、全部走线、触摸扳机及滑动机构。配置与器件几何清单逐字节不变；与 `dff2043` 比较，电路板只增加通道关联属性和软件保存元数据，其余记录完全一致。比较脚本为 `verify_design_baseline.py`，记录为 `验证记录/design-baseline-report.json`。
- 修正此前工作记录中的网表结论：并非仅缺少导入关联。原理图引脚朝向被反向解释，短引线跨过阻容两端，产生 33 组冲突网络；修正原理图生成脚本后，补齐新建原理图器件的唯一编号，恢复既有 PCB 的器件名称、阻容值和采购属性，不改变电路板网络。
- 官方原理图制造网表导出接口实际成功，不再使用此前超时的旧网表读取接口。保存文件的实际引脚、软件编译原理图、PCB 焊盘及导出网表逐项核对，48 个器件与 160 个已连接引脚一致，空网络及器件身份也无差异。
- 软件规则检查还比较通道编号与板层偏好。通过官方器件修改接口补原理图的板层偏好、PCB 的通道编号，先验证一个器件，再同步其余器件；没有传递器件位置、旋转、实际板层、封装或网络修改。最终现场规则检查为 0 项错误，没有关闭或豁免检查规则。
- Windows 命令行约 32KB 限制原先通过分批写入绕过。现改进 `eda_cli.py`：较长代码和参数写入副本内载荷文件，再经官方文件接口读取执行。6 项本地检查通过，64,000 字符参数现场完整送达，实际命令长度由 64,329 降至 602。没有改软件全局访问权限；具体证据与使用限制见长参数修复说明。
- 没有重新运行已挂起的原生自动布线，也没有改变不铺铜方案。保留原有网格布线器和完整地线连接；原生自动布线等待原因、覆铜计算内部异常仍未根治，不能宣称原生接口已恢复。
- 灯孔与左右分壳面精确相切使左壳 STL 出现非流形边。仅把灯孔切刀半径增加 0.01 毫米，两半壳共少去材料 0.12153373 立方毫米，其余四打印件体积不变；名义尺寸配置及机构行程未动。清除两半壳共 8 个严格零面积三角面，保留所有非零表面，并将清理纳入导出脚本。
- 六件实体有效，六件打印网格均为单连通体，开放边、非流形边、零面积面全为 0。按到底、两种摇杆轴高及限位核对完成；杠杆和右键柱塞正交集为静态模型接触，千分之几立方毫米贴合薄层单独说明，没有将它们写成精确零交集。刷新预览和整机压缩包，压缩内容与当前实体校验值一致。
- 修正交付说明：USB1 混合贴片/插装也需工厂确认；触摸盖叠层余量约 0.15 毫米，应使用薄胶而非厚泡棉；8.4 毫米电池仓对 8 毫米最大电池只剩 0.4 余量；摇杆帽为 Ø4.2/对边距 3.2 的双削边孔。
- 保留原扳机 4.1 毫米行程，明确其对动作高度下限个体可能差 0.1 毫米，另一公差端的动作后余行程也不能仅凭模型保证。首件开关、电池、开发板、打印配合、线束、触摸、电源及无线尚需实物验收；没有为宣称一次打印到位而擅自改机构，不能将文件收尾称为制造定稿。

## 2026-10-05 原生布线与覆铜独立试验

- 用户授权继续尝试原生自动布线、覆铜问题并配合界面操作，同时要求原成果保留。先提交收尾副本 `2031276`，再创建 `.worktrees/eda-recovery`、分支 `codex/eda-recovery`；本轮只新增隔离小板、探针、证据和说明。
- 用户已登录。专用自动布线调用等待 12 秒仍未返回；安装代码中缺少该方法的接收注册。软件菜单使用另一条路径和本地算法，不能继续把等待归因于未登录或云服务。
- 通过官方文档列出的窗口兼容入口启动本地算法，可见和无窗口会话均产生两条路线。但默认迭代展示把工程设为只读：保存返回 false，磁盘线路仍为零，覆铜创建也会被拒绝；计数和规则检查不足以证明已经保存。
- 只在自有小板捕获原生路线，关闭自有会话再重开原板，通过公共直线接口写回相同坐标、线宽、网络。保存成功，磁盘两条线路；完整重开后连接仍成立且规则检查零错误。适配目前严格限于四焊盘、两条直线、零过孔，原专用接口没有修复。
- 用户卡在可见迭代界面并要求重开；已只关闭并重开对应测试会话，保留磁盘备份和路线快照，没有停止公共后台。用户截图证实本机按钮文案为“确认”，此前按教程称“应用”不准确。
- 覆铜矩形测试坐标最初误判：原生 R 编码从起点向负 Y 展开，旧范围未覆盖地焊盘。改为明确的闭合四角后，纯公开接口成功生成一个铜面和八条热焊线，保存成功、规则检查零错误；全新空白工程首次创建也成功。旧日志保留，更正旧空结果不能用作算法失效证据。
- 最终铜层导出包含真实区域；完整关闭重开后两组连接、九条填充路径和零规则错误保持。原 AI 分支和交付副本均干净；主目录原有拼板变更的 SHA-256 仍为 `068167543DE1B5C10C2AEFEDF00B49D6281639F30212BC978F0C30A630D6762B`。结论、版本风险、适用范围及校验值见 `docs/接口修复试验结果.md`。

## 2026-10-05 将工具验证接到正式PCB与外壳

- 用户指出目的应为程序自动设计并联动实际电路板与外壳，而非仅修小板调用。创建 `.worktrees/formal-validation`、分支 `codex/formal-validation`，复制四个用途明确的正式工程副本，新工程归属编号独立，原AI工作树、收尾工作树及主目录原拼板变更保留。
- 正式软件检查实际48器件、160已连接焊盘、575段直线、95过孔，网络与线宽符合原配置，规则检查零错误。更正原报告564段的旧数量；原理图与电路板实际导出网表的器件、网络及身份一致。
- 元件焊盘在独立焊盘接口中重复返回，父元件字段可能缺失；不能用局部编号误判冲突或宣称433条快照记录都是物理焊盘。独立工程还改变内嵌库归属，只有资源完整身份相等且明确绑定源目标时才映射；真实元件资源身份是对象，不符合接口类型文件中的字符串假设。
- 原575段线、95过孔通过公开接口写回，保存及完整重开后全部几何/属性一致，规则检查零错误。新增无界面的程序复核入口也实际通过；重复打开相同工程时曾遇活动文档未切换，关闭本轮自有重复会话后恢复，没有关闭用户其他工程。
- 正式主板顶底GND覆铜纯接口成功，完整重开保留186填充路径、规则检查零错误。板框返回的闭合起点和绕向不同，规范化等价顶点后严格核对；光绘实几何确认原线/孔/盘及电池线槽保持，新铜不盖槽，但天线边界接触且无余量。
- 原生自动布线在实际板生成500段线、37过孔，遵守电源0.3/信号0.15毫米规则，仍有U1六个未连接引脚。公开接口写回缺失3条极短桥段，回读497线，不是重复或合并，拒绝判等价。脚本未调用显式保存，但关闭自有会话后软件实际存盘497线37孔，因此失败副本必须隔离并标明用途。没有将它替代原合格路线，也没有宣称全部原生接口修复。
- 官方文件写盘返回路径错误对象，修正不能用真值判断它；改用原生生成+分块取回，实际确认约29.6MB电路板实体、铜层和原理图网表等文件落盘。取回数据不改变原生算法或导出内容。
- CadQuery读取新电路板并沿原坐标变换核对主板、小板及原装配，生成四张关系图。五安装孔、44针、USB、扳机到底及八个摇杆离散摆动状态检查完成；板厚的微小导出差、左壳贴合薄层交集量化保留。C5/C6进入原参数天线范围及扳机全公差−0.1毫米作为设计反馈，实物/全行程/打印和无线验收未完成。
- 本轮原设计配置、器件几何及已有交付文件未改。实际结果、复现命令和边界见 `docs/正式PCB与外壳程序验证结果.md`；证据与查看页面位于 `evidence/formal-validation`。

## 2026-10-05 修复自动布线结果写回，准备制造与装配审核

- 用户授权修复极短线写回，并要求 Astra 审核更易落地、收到后少焊接、将来容易批量生产的优化方向。新建 `.worktrees/route-writeback-fix`、分支 `codex/route-writeback-fix`，从 `fce65d9` 开始；原AI、收尾和前轮正式验证工作区不修改。
- 源码与三条真实短线实验确认：连接刷新删除小于0.1密耳（0.00254毫米）的独立导线；直接创建和先长后改短都会丢。公开锁定/保留参数不能稳定保护新建导线。改用同端点、网络、铜层、线宽、锁定的单段折线，不扩大或补长铜线。
- 完整板暴露第二个厂商接口缺陷：折线getAll过滤元数据后仍按旧数组索引取路径，得到短线编号却配板框路径。改为无参数读全部后本地筛层。第一次按创建编号复核也暴露连接刷新可替换编号；最终逐段证明属性/几何相同后更新13处编号映射，没有放行缺段或多段。
- 本机原生文件按0.0001密耳量化坐标和线宽；仅采用半个量化单位的几何容差。原生500段写回、保存重开及实际制造铜层逐段核对均通过，497条普通线加3单段折线、37过孔。原正式575段/95过孔回归通过、软件规则零错误；第二版含折线快照再次回写仍完全一致，制造500段匹配。原生算法原有U1六个漏接仍保留，不将工具成功冒充电路合格。
- 新入口 `verify_route_writeback.py` 自动新建隔离副本、写回、重开核对、软件检查和制造铜层核对。标签目录已存在则拒绝覆盖，只关闭自行创建的会话，原板校验值变化直接报错；诊断副本不可直接下单。只有本机当前48器件两铜层设计经过验证，圆弧及多段折线明确拒绝。
- 保留四次失败诊断和最终三组证据，共26文件，校验值清单在 `evidence/route-writeback-fix/manifest.json`。报告为 `docs/自动布线写回修复结果.md`，旧正式验证报告追加最新状态，不覆盖历史结论。
- Astra 提示词为 `docs/Astra审核提示词-制造与装配.md`，先只读审核原正式基线；重点工厂完成全部直插焊接（含SW3清单遗漏）、预装触摸电极、独立摇杆、插接线束、机构公差、天线、电源、烧录/检查和首件到批量的最小改动。没有使用Astra模型或启动额外审核，没有改变器件与外壳设计。
- 收尾检查确认原AI与收尾工作树仍干净、主目录原拼板校验值保持。前轮仍打开的正式基线工程索引由软件回填了原理图和PCB版本/时间元数据，PCB文件本身与前轮提交完全相同；保留该索引变更，不复位或关闭用户窗口。26份证据校验值全部匹配，三组规则错误分别为原有6、0、原有6。
- Git对新增证据路径禁用换行转换，保留实际导出的原始字节，避免后续检出使校验值失效。提交使用已有Codex署名，只对单次命令指定，不更改用户全局Git配置。
- 2026-10-06跨日收尾：新增属性后普通暂存仍复用了先前转换换行的索引，首个提交中证据字节与清单不符。重新按当前属性暂存本轮证据后，直接读取Git索引逐份核对26个文件的长度及校验值全部通过，以后续修正提交为交付版本。实际软件验证结果不变。

## 2026-10-06：合并正式维护版本，补充 Astra 审核要求

- 用户明确要求合并，并说明试验板的六处漏接不用补。确认正式维护工作区 `.worktrees/pcb-shell-finish` 位于 `codex/pcb-shell-finish` 且干净，从 `2031276` 快进合并到工具修复提交 `9aced8b`；快进只将目标分支移到已有后续提交，没有冲突或改写提交历史。
- 合并前核对原正式电路工程 `pcb/gun-mouse-v1`、两份正式配置、外壳脚本及交付目录与修复分支没有差异。合并的是已验证的工具、独立试验记录和说明，正式设计继续沿用收尾方案；未补试验漏接，也未把试验板改为正式板。
- 原 AI 分支 `claude/pcb-shell-v1` 保持在 `dff2043`、工作区干净。主目录保持在 `2917d96`，原拼板修改的校验值仍为 `068167543DE1B5C10C2AEFEDF00B49D6281639F30212BC978F0C30A630D6762B`；没有写入这些工作区。
- Astra 提示词入口改到正式维护工作区，并补充固件与首次使用、工厂分板去毛刺、机构受力、续航与发热、装壳前工厂检查及最少用户步骤。另要求锁定实际审核版本、列出最小关键实测清单，允许提出有依据的改方案但只读建议，不直接实施。只读辅助审核与现有文件检查提供补充依据，本轮没有启动 Astra 模型。
- 本轮仅合并已有验证结果并修改审核提示词与工作记录，不重跑已通过的软件和模型检查；最终通过版本差异、原工作区状态和校验值确认保护范围。

## 2026-10-06：先完成实质设计预审，再缩小 Astra 审核范围

- 用户要求先完成能够确信的分析与优化，再把难以确定的设计选择交给 Astra。本轮在正式维护工作区 `codex/pcb-shell-finish` 从 `e4325bf` 开始；并行只读核对电气、机构与制造责任。没有启动 Astra 模型、没有向工厂发消息或下单。
- 纠正此前记录和提示词对 SW3 的分类：真实封装为 7 个顶层无孔贴片焊盘，不是直插开关。逐项对应 48 个器件，42 个贴片、5 个纯通孔、1 个混合 USB；纯通孔 64 个焊接位置，加 USB 的 4 个通孔固定脚，共 68 个。要求工厂完整焊接、分板去毛刺、按套包装，并确认电池极性、成品线束、电极预装、烧录与校准的承接范围，避免默认用户手焊和修整。
- 核对原厂资料后确认：开发板厂家允许 3.3V 排针供电；惯性芯片模式 1 接法和电池负载共享拓扑合理。纠正“同芯片固件直接相同”“达到约 1mA 即满足 3.3V 微动最低负载”“稳压器关断电流就是整机待机电流”等未经完整验证的表述。正式配置仅校正三处文字，网络、器件、布局和几何数值没有变化。
- 查清扳机与右键固定行程不能仅凭原厂最小保证余行程覆盖全部动作公差。扳机保证条件要求最终高度同时不小于 13.2、不大于 12.8 毫米，无交集；因此不把加 0.1 毫米叫完整修复。提出保留壳体硬限位、由工厂在真实总成上设定并固定驱动触点的路线，候选余行程 0.95±0.1；调节机制、完整误差预算和真实寿命尚未定稿。
- 已生成两处独立局部打印候选：右半壳在摇杆背面增直径 5 毫米支撑柱；扳机在电极上沿增局部 1.0 毫米深端接腔。原六件打印包不覆盖，外形与按钮硬限位不重设计。两个候选均为有效单实体，打印网格单连通、开放边/非流形边/零面积面均为零。右壳仅增加约 280.19 立方毫米，扳机仅减少约 17.30 立方毫米；与保存的 209 实体主板装配进行支撑柱局部检查，没有正体积干涉。实际打印高度、接头和受力寿命仍需样件。
- 从正式布线快照重算 USB：正线约 149.85 毫米、无过孔，负线约 155.26 毫米、两过孔；有长段不成对且缺连续参考地。提出优先两层板保留底口下载、成对重排并结合散热铜/天线净空的方案；底口仅充电是维护代价较大的备选，没有擅自改正式板。完成充电输入与线性稳压损耗的情景核算，不把假设电流、容量利用率当续航和温升实测。
- 从实际网络与厂家排针生成正式引脚头文件，写入触摸仅控制体感、缓存清除、按键/摇杆独立、重连释放的硬件无关参考核心。Windows 原生编译与关键逻辑检查通过，包含 USB 模拟检测迟滞门限；独立只读复核没有发现实质错误。真实采样、校准、按键边沿保存和蓝牙发送仍待集成，不宣称完整可烧录固件已完成。
- 用户先讨论充电时停用，随后明确撤销；临时加入的限制已从参考核心移除。新增检查证明 USB 检测变化不自动暂停/恢复体感、摇杆或实体按键，文档和 Astra 提示词同步记明；不以限制操作来绕过电源设计。
- 电池最大占位宽度与仓宽相同，名义侧隙为零；修正采购边界。弹簧静止/到底安装长约 13.1/9.0 毫米，缺刚度、圈数、材质和压实高度时不猜载荷、不让用户逐根剪短。真实打印配合、线束、电池尺寸和弹簧参数交给供应商或首件测量。
- 结果见 `docs/设计预审与优化决策-V1.md`、`docs/工厂装配与交付要求-V1.md`、`docs/固件接口与交互契约-V1.md`。Astra 提示词收敛到按钮公差机构、电源最小架构、USB/地/散热/天线共同布局、批量摇杆供货与安装四项。原正式板与原打印件保持，当前候选不构成可直接下单的完整定稿。
- 用户明确授权“这一次工作做完后执行关机，不需再次确认”。本轮完成文件保存、检查和 Git 提交后执行系统关机，不在任务中途关机。

## 2026-10-06：经济型部分贴装与同型号采购降本候选

- 用户授权争取经济型，允许自行焊接部分贵件；确认仍持有 GY-601N1-LSM6DSV16X 模块。保留触摸、扳机、右键、摇杆全部操作逻辑。
- 在 codex/economy-assembly-20261006 独立工作树准备候选，原铜层、坐标和固件不变。工厂清单留空 U1/R10/R11/SW4/J6，22 组、43 个元件每套；开关保留 SS-01GL13 同型号，自购自焊；小板只制光板，用单头成品线接公共端与常开端。
- 生成脚本核对位号分区、数量、坐标全字段一致、顶层和原制造文件哈希；原导出实际为带字节顺序标记的 UTF-16 制表符文件，最初按 UTF-8 解析失败，已改为识别字节顺序标记并保持原格式，不忽略或替换乱码。
- 原文件没有 V 割专层，含 20 个 0.6 毫米邮票孔；工厂生产稿的 V 割位置未取得，复审说明仅准备，尚未发给供应商。经济型资格与只贴主板的多款费用尚未获批准。
- 模块可通过 J1 背面大通孔电源/地/数据/时钟接线，模块地址脚接地、模式脚悬空；固定托架和芯片轴向未实物核对，不称原打印件直接适配。
- 两片部分装配板加用户图示两只开关条件试算约 260～360 元，非系统新报价，光板、外壳、自购运费、可能射线费等另计。用户仅确认一块模块，第二块主板作备件，不宣称两把完成品。
- 用户询问能否操作 Chrome：当前没有浏览器控制工具或有效页面连接，本机未发现 Chrome 调试参数和监听口，不能声称已点击或修改其网页。
- 新工作树未配置提交身份，首次提交被 Git 拒绝；本次使用一次性的 Codex 本地工具身份提交，不修改用户全局或共享仓库身份设置。

## 2026-10-07：便宜扳机开关工厂代焊版及新外壳交付

- 用户允许更改电路板和外壳，要求换掉高报价 SS-01GL13，并明确便宜型号应由嘉立创采购焊接。纠正将“可以自己焊部分元件”误用为默认自购扳机的方案：推荐版保留扳机小板与 J6，SW4 改为 SS-01GL/C2896769，工厂采购并焊好。此前单主板自焊支架仅作为不推荐的研究备选，不复用其约252元试算。
- 仍在独立工作树 economy-assembly-20261006、分支 codex/economy-assembly-20261006 工作。新原生工程 gun-mouse-economy-factory-v3 从原正式板复制，关闭自动 V 割设置，不改原铜线、过孔、器件坐标、五安装孔和过线槽；主板与扳机小板两款邮票孔连接如实保留。经济型是否承接异形两款拼板仍需新订单审核，未声称已经获批或免除拼板费。
- 用户已有 GY-601N1-LSM6DSV16X 模块：U1/R10/R11 不装，复用模块的芯片直接接口、地址0x6A和自身上拉。主板 IO8/IO9 保持原数据/时钟脚。新增左壳板边定位轨和独立压框，模块芯片面朝整机左侧，保持程序轴向；用户仅需连接已有模块，扳机用工厂焊好的小板及成品线。
- 按欧姆龙 SS 系列原厂尺寸图核对焊片、脚距、本体及动作位置。SS-01GL 三焊片能穿原槽孔；两侧小板槽和内肋前移1.9毫米，扳机触点轴下移3.52毫米。旧 +2毫米螺栓调整端点按到底会撞塑料本体，改人工校准范围 -1.5～+1.2毫米，保留右壳独立硬止挡。提供0.8/1.0/1.2毫米设定片，明确螺栓没有物理止退结构。
- 工厂版共23组、45个安装器件每套，三个不装位号在原生属性、物料与坐标中一致。575条铜线、95个过孔、204个引脚网络和48个原生元件的几何与原版一致，重新原生导出规则检查0项。原始顶层锡膏文件仍有三个不装器件的18个图形，订单备注要求按不装清单不开钢网口、不涂锡膏，没有宣称原始锡膏层已删除它们。
- 核对实际保存的壳、小板、连接器和原主板实体；扳机连续4.1毫米行程及螺栓全部调节量、六角全转角包络检查通过。新左壳实际实体差分未删去 GY 支撑，新增材料与模块、压框和规定线束交集为0。新打印件均单连通、无开边或非流形边。开关模型依据原厂名义尺寸，尚无实际打印、首件装配、供电温升、模块通信或蓝牙体验验收。
- 原固件五份源码及四份二进制逐文件校验保持相同；轻触只启用体感、扣扳机左键、侧键右键、摇杆中键和光标移动、摇杆与体感相加及充电插拔不暂停逻辑均未改。未烧录用户硬件。
- 原两套标准型报价752.21元。条件推算加工约238.24～288.24元；仅假设新开关代焊价等于商城曾查到的4.24元参考价时，器件加加工约314.47～364.47元，仍需另算未确定的工艺、包装、光板、运费和打印。没有得到新版实际代焊报价，C2896769库存/代焊承接也待匹配；用户只有一个旧模块，因此当前一套完整样机加一套电路备用。
- 原生工具注意项：打开工程使用 --path，误用 --project 会建空工程；关闭自行创建的会话使用 session close --destroy。PCB采购编号需单独 modify，和其他属性同次修改会被覆盖；原理图采购字段在 otherProperty 内。新原生文件保留LF，不能通过默认Windows文本写入造成CRLF后使工程解析失效。已关闭本轮三个自建无界面会话，不关闭用户网页或其他工程。
- 推荐交付目录为 deliverables/经济型工厂代焊版，包含新版制板文件、物料、坐标、十件打印模型、固件、说明与证据。保存原生导出及逐文件校验清单，交付和原生文件在 Git 中禁用换行转换，暂存后核对实际索引字节。没有下单付款、没有向供应商发消息，Chrome尚无可用控制连接。

## 2026-10-07：按整机总成本补查可以完全不装的器件

- 从本机实际引脚网络复核：R12仅给原U1的IMU_CS上拉；C7/C8是原U1局部电源滤波，与供电铜线并联。已有GY模块自带片选上拉和本地滤波，因此这三件也可完全不装，无需用户补焊或替代接线；主板其余供电与滤波保留。原生原理图及PCB不加入物料属性、重新导出的安装清单统一为六件不装，最终每套42个器件、23物料组。
- R12/C7/C8同组仍被其他位置使用，不会因少装三件消除整组上料费；最低采购量也可能使材料实付不变。条件加工估算仅减少两套共12个贴片焊点，不能把零件数量下降说成大额降价。
- 扳机小板用于转向并固定微动开关，J4/J6用于成品插接线连接。保留能减少装配焊接；只不装接头不会免掉两款拼板费。LED1/R4可直接留空但原两套器件费仅约1.14元并失去充电灯，推荐保留。电源开关、充电、稳压、供电切换和静电保护也保留，避免把删元件数量置于总装便利、供电稳定与原操作功能之上。
- 本轮只调整三项不安装属性及交付说明，未改铜线、外壳或固件。规则与生产资料重新导出核对，完整交付包随后重新生成；所有费用仍以新订单实际匹配为准。

### 同日继续：按收费物料种类精简，限定仅经济型

- 纠正前段仅按充电灯材料费决定保留的口径：原板只有一颗LED1，其限流电阻R4是另一个独立物料组。标准型基础库与扩展库正常各8元/种，经济型基础库免费、普通扩展库20元/种；不能因行内未显示金额就认为标准型基础库免费。规则来源为嘉立创官方 `https://m.jlc.com/portal/server_guide_38538.html`，2026-10-07重新查阅。
- LED1/R4仅处于充电状态输出支路，不在充电功率路径内，追加为不安装件；无需补焊或跳线，取消外部充电提示，充电和各控制逻辑保留。总共八件留空，工厂清单21组、40件每套。只按经济型核算时，删灯只少旧报价约1.144元备料及两套四个焊点，不能宣称再省16元经济型换料费。
- 接单条件更新为仅接受经济型，不能以经济型接单则不生产、不转标准型。两款邮票孔拼板和C2896769的实际承接资格尚未获新订单确认，不将文件通过检查写成工厂已接受。J3～J6共用C295747，只是一种物料；五种普通扩展贴片料及U2/R3免换料资格须以新订单明细核对。
- 原生接口修改器件属性会更新记录ticket，编译原理图自动通道编号因此改变，首次规则检查出现一条原理图/电路板网表关联不一致。两侧48件的唯一身份和所有引脚网络一致；通过官方接口按最新编译原理图同步电路板通道关联，保留完整其他属性并单独恢复采购字段，再重新检查为0项。没有关闭规则、没有导入改变铜线的布局变更。追加保存新原理图网表并逐件核对身份、通道、采购料号、不装属性和引脚网络。
- 官方工艺表接受单板、邮票孔拼板及单面贴片加插件，因此两款和保留扳机小板并非经济型必拒项。官方公开经济型限制仍包括潮敏、特殊焊接温度和沉板/夹板结构，剩余物料必须通过国内本次订单审核；海外经济型标签不作为国内接单证据。生产文件、48个器件位置和原铜网核对通过，物料21组/40件，重新汇总完整包；未得到经济型实际新报价，也未生产或下单。

## 2026-10-07：取消扳机小板，改单板自焊开关；恢复充电灯，R3/U4 降本

- 复审 1045fe1：U1/R10/R11/R12/C7/C8 不装在电路上成立（R12 只接 IMU_CS，IMU_CS 只到 U1；C7/C8 为 U1 局部去耦）。删除 LED1/R4 不成立：CHRG 只接 LED1，主控无充电状态输入，固件只在未插 USB 时上报电量；经济型下两件为基础库，删除仅省两套约1.2元，且 v1 外壳专设1.6毫米透光孔。本版恢复 LED1/R4。
- 用户确认这次去掉扳机小板以省多款板费。扳机开关需与扳机直线运动方向垂直安装，不能直接贴到主板平面上，所以采用此前研究过的打印支架：支架卡板进入原小板槽位（不移槽），2毫米托条把开关底面垫到与工厂版相同的 X=-17.1，扳机、调节螺栓和设定片沿用。用户焊 COM/NO 两根线，PH2.0 单头线插 J4。
- 新原生工程 gun-mouse-economy-single-v4 从单主板 v2 复制，只改属性：R12/C7/C8 不装；R3 改用 R1 的 5.1k 采购属性（与 R1/R2 合为一行）；U4 改为 SRV05-4/C7420376（R+O 宏嘉诚，JLC 海外库优选扩展）。核对 SRV05-4 规格书：1/3/4/6 为 I/O、2 地、5 VCC，VRWM 5V、VBR≥6V、1pF，焊盘尺寸与板上 SOT-23-6 一致；从原生铜线确认 U4 的 1–6、3–4 脚之间已有铜线直连，四路独立通道替换不会断开 D+/D−。U3、USB1、SW3、J3–J5 在 JLC 库中查无同封装基础/优选替代，保留。
- 自建无界面会话写入属性后同步 44 个通道关联，规则检查 0 项，导出后关闭自建会话。物料 21 组/每套 40 件；46 器件身份、通道、不装属性、料号与原理图一致，引脚网络与正式板 v1 逐脚一致；Gerber 各层按光圈定义解析后与 v2 图形完全一致，钻孔一致。
- R3=5.1k 约 235mA：TP4056 在 3.3V/3.8V 电池时约 0.40/0.28W（6.8k 为 0.30/0.21W），700mAh 约 0.34C。板上无铺铜、芯片距电池约2毫米且无电池测温，README 写入首件充电测温方法和超 40℃ 的退回办法。
- 支架原研究参数有两处问题：焊片窗与出线口之间 0.4 毫米细桥挡住尾线；焊片窗 3.8 毫米对 3.2 毫米焊片过窄，焊点难以穿过。只在 scripts/economy_holder.py 内覆盖为连通、4.6 毫米，不改工厂版共享配置。支架、开关、M2 螺钉螺母、外径1.0毫米尾线与左右壳、主板零干涉；扳机全行程与螺栓 -1.5～+1.2 毫米全范围零干涉；支架合壳六向限位；硬止挡与设定片检查通过。开关两安装孔近乎对称，说明和示意图强调摆杆自由端朝出线口。
- 左壳与已通过 GY 适配检查的不移槽左壳为同一实体（双向差集 0）。固件未改。条件费用推算两块部分装配主板约 232～252 元，比工厂代焊小板版（恢复充电灯后约 314～364 元）约少 50～125 元，以新订单报价为准。没有下单、付款或对外发送任何内容。
- 按用户报价截图拆三大项：原标准型工程费150、拼板费150（主板+扳机小板两款）、换料费168（标准型8元/种×21种贴片料，插件料不计）共468元；本版经济型工程费50、单款无拼板费、换料费80～100（基础库免，余USB1/U3/SW3/J3–J5四种扩展各20元，U4国内不免时再加20），三项约130～150元。钢网50、包装3.07在经济型不收；原U1不装后X光费可能免除，以新报价为准。
- 用户反馈 M2 外六角螺栓电商难买，可买到 M3 外六角和 M2×10 内六角。M3 外六角头外接圆约6.35毫米，会碰右壳硬止挡、弹簧座和设定片，故改用 M2×10 内六角圆柱头螺钉（ISO 4762/DIN 912）：头径3.8毫米小于原六角外接圆4.62毫米，原避让都够；头高2.0毫米比原1.4毫米高，扳机头槽内端由X=0.9加深到1.7、导孔由11.2加长到11.8，加长段外1毫米壁实体检查通过，最大退出时螺钉尖不到孔底，调节范围仍为-1.5～+1.2毫米。修改只在 scripts/economy_holder.py 内覆盖，不改 config/evt-a.json。调节时提起开关支架用1.5毫米内六角扳手转，或用尖嘴钳从侧面开口夹圆柱头。
- 用户希望少买几种螺丝。全机统一为 M2 杯头内六角（GB70.1/DIN912）两种长度：M2×10 每套3颗（扳机调节1、GY压框2，原压框为PA2×10自攻），M2×20 每套9颗（合壳7，原为PA2×20自攻；开关支架2，原为M2×16），另 M2 螺母2颗、1.5毫米扳手一把。外壳与压框导孔均为 Ø1.7，与扳机 M2 机牙自攻导孔相同，打印件不改。scripts/check_unified_screws.py 按头径4.0、头厚2.1保守核对：合壳杯头全部落在 Ø4.4 沉孔内、头顶低于外表面约3.8～3.9毫米；GY压框在0.8/1.6毫米板厚下螺丝头不碰左壳、开发板、主板元件和±20度摇杆帽；支架 M2×20 加长段不碰壳体、主板、尾线和扳机全行程，螺尖距壳2.2毫米。economy_holder.py 主检查也改按 M2×20 杯头建模重跑。
- 用户为新手，要求"麻烦就不省"。评估剩余扩展料：SW3（MSK12C02 贴片侧拨，0.6毫米焊盘、1.5毫米脚距，需对准外壳拨杆槽）对新手麻烦，保留工厂焊；若要省只能改板换插件开关并改外壳，为20元不改。USB1、U3 在 JLC 库中查无基础/优选替代，保留。J3/J4/J5 同为 C295747，三者全不装才免一种换料费；焊盘为 1.0×3.8 毫米长条，直接焊线难度低于已有的 GY 模块接线，且网购电池多为两根裸线，直接焊可免 PH 插头正负极与板子相反的风险，故设为不装。原生属性写入、通道同步后规则检查0项，物料20组/每套37件。README 写入电池逐线焊接、用 USB 外壳导通判定负极、线束固定的步骤；扳机开关两线直接焊 J4，设定时在开关焊片上测导通。导线统一为一卷外径≤0.6毫米细线。条件推算两块部分装配主板约203～223元。
- 下单页实际报价：元件费41.75、加工费147.2（工程50、贴片焊盘2、插装焊盘12.2、插装工程20、换料60、DFM 3），与推算加工费一致，无X光与钢网费；个性化服务5.2为可选氮气焊接。SMT与PCB光板为两张订单，光板费另计。U4 的 SRV05-4 国内库存仅2个，C20615829、C85364 用户查得库存不足；在嘉立创公开元件页查得 C558418 为扩展库、库存0，继续查询时出现滑动验证码，停止查询。用户决定不装 U4：板上1–6、3–4脚有铜线直连，不装不影响USB充电与下载，失去USB口静电保护；属性恢复原USBLC6-2SC6/C7519以便以后补焊。规则检查0项，物料19组/每套36件，加工费推算147.08。
