guiwushengzhe-prog/gun-mouse/docs/正式PCB与外壳程序验证结果.md

# 2026-10-05 正式PCB与外壳程序验证结果

修复工具的目的，是建立“统一参数 → 电路板设计与检查 → 实际三维电路板导出 → 外壳装配核对 → 制板和打印文件”的程序流程，使后续修改能同时反馈到电路板和外壳。不能以小板成功推断正式工程或全部软件功能已成功。

本轮使用嘉立创专业版4.1.66及CadQuery三维建模工具，工作树为 `F:\项目\枪型飞鼠\.worktrees\formal-validation`，分支为 `codex/formal-validation`。原AI分支 `claude/pcb-shell-v1` 的 `dff2043`、收尾分支 `codex/pcb-shell-finish` 的 `2031276` 均保持干净。主目录原有拼板文件校验值仍为 `068167543DE1B5C10C2AEFEDF00B49D6281639F30212BC978F0C30A630D6762B`。

## 已在真实工程验证

| 环节 | 结果 |
| --- | --- |
| 原正式板读取 | 48器件、160已连接焊盘、575段铜层直线、95过孔；网络及线宽符合原配置，规则检查零错误 |
| 原理图与电路板网表 | 实际调用软件编译并导出，器件编号、封装、采购身份和160个引脚网络一致 |
| 原路线公开接口写回 | 全部过孔先建、再建直线；保存后完整关闭重开，575段线、95过孔的几何、网络、线宽、锁定及过孔属性与来源一致；规则检查零错误 |
| 主板原生双面覆铜 | 两铜层共186条填充路径；保存、完整重开及光绘导出通过；原器件、路线、过孔、含过线槽的板框保持一致 |
| 制板铜层实际几何 | 新增铜不覆盖电池过线槽；原焊盘、过孔和走线绘图记录未改变。新增铜接触X=52边界，间距为零，不能称有天线余量 |
| 实际三维电路板与原外壳 | 已重新导出带真实器件模型的电路板，按原坐标拆分主板和扳机小板，并核对原装配、五个安装孔、排母针位及USB开口；生成四张关系图 |

接口返回的433条焊盘快照记录包含元件焊盘在两个读取接口中的重复，不能说成433个物理焊盘。软件实测575段路线更正了旧布线报告中的564段；没有为了匹配旧数量删除路线。

## 仍未跑通的原生自动布线

自动布线算法仍由嘉立创原生执行，启动改用官方窗口菜单兼容入口；覆铜及图元读写使用公开程序接口。专用自动布线接口的接收缺口未修改，菜单名称也存在版本兼容边界，不能称全部软件功能都可调用。

正式板原生算法生成500段线、37过孔，实际采用电源约0.300227毫米、信号约0.149860毫米线宽，符合本轮设置。但惯性芯片U1仍有6个未连接引脚：3V3的5、8脚，以及GND的1、2、3、6脚。

捕获该原生结果并重开自有试验会话后，公开直线接口写回只读到497段线。缺失3条极短桥段：3V3约0.000180毫米，SCL两条各约0.002155毫米。离线无向几何比较确认不是重复线，也不是相邻线合并。可能存在极短线过滤，但原因尚未证明，不能将其写成等价成功或无功能影响。

脚本因此报错且未调用显式保存。不过关闭自有会话后，软件实际已把497段线、37过孔写入试验副本。失败隔离依靠独立工程，不依靠“没调用保存”。该副本附有明确诊断用途说明，未替代原交付。

## 外壳核对与设计反馈

六打印件的实体模型均有效，打印网格均单连通、封闭，无非流形边或零面积三角。保存电路板的48器件位置符合配置，44排母针位最大误差约0.00000330毫米；USB前端约8.94×3.20毫米，位于9.4×3.7毫米开口内。

新导出板与冻结装配的严格体积比较并非全同：板厚相差约0.000022555毫米，平面边界及面积相同的量化结果解释了板体体积差。新主板与左壳有0.005947971立方毫米交集，厚度仅0.000050800毫米，属于名义贴合处的微小导出差；没有把它伪称成精确零交集。右壳、电池没有交集，小板与两半壳没有交集。

扳机按到底不碰壳，但原4.1毫米行程在微动开关极端公差下可能少0.1毫米触发行程。摇杆两档轴高各检查四个轴向±20°，八个状态不碰壳；这不能代替连续运动、按下行程及实际弹簧的检查。

原C5/C6分别位于X=57、54毫米，已有焊盘及11条顶层线路进入当前定义的X≥52区域。它是原设计的铺铜限制参数，不是已验证的完整天线净空。应结合实物开发板天线及无线测试回头确认这一布局，不能仅凭本轮新铜面不越界宣布无线性能合格。

电池最厚8毫米时只有0.4毫米固定材料空间；触摸铜箔与胶层余量约0.15毫米；开发板高度、插头包胶、线束、实际重心与打印公差仍需实测。原器件选型、名义尺寸、孔位与机构保持，没有为宣称一次打印成功更改原设计。

## 可继续使用的程序入口

从本工作树运行，`validate_saved.py` 会先只读查询活动会话。已有一个同名工程就复用，尚未打开就自行打开指定副本；只关闭自己创建的会话。同名多个会话会明确停止，不自动关闭任何窗口。本次确实遇到重复打开时活动文档归属未切换，程序入口因此补上复用流程。

```powershell
Set-Location 'F:\项目\枪型飞鼠\.worktrees\formal-validation'
$env:PYTHONUTF8='1'
& 'E:\GunMouseCAD\Miniforge3\python.exe' scripts\formal_validation\validate_saved.py gun-mouse-formal-roundtrip
```

其他入口：`runtime.py` 调用原生导出并实际取回文件；`snapshot_routes.js`/`apply_routes.js`读取和写回两铜层直线、过孔；`formal_router_rules.js`设置独立试验线宽；`formal_pour.js`创建主板双面地铜；`audit_assembly_interfaces.py`/`compare_export_and_render.py`核对原装配及实际新导出板并生成关系图。它们都有工程用途限制，不是通用任意工程改写工具。

三维审查与渲染使用 `E:\GunMouseCAD\CadQuery\python.exe`。光绘几何审查实际使用 `C:\Python313\python.exe scripts\formal_validation\audit_copper_gerber.py`，依赖已安装的几何计算库和绘图库；本轮未记录其精确版本，不把目录名当作版本证据。

本轮也发现官方直接存盘接口会返回 `{error:'路径不允许'}`，其值不能当作成功布尔值。导出入口改为严格判断 `===true`；路径受限时将原生生成的文件分块取回，本地校验长度与校验值后存盘。算法和导出内容没有由自制算法代替。

主要记录和四张图集中在 `evidence/formal-validation`，可打开其中的 `查看结果.html`。约29.6MB的新电路板实体模型留在 `outputs/formal-validation/baseline-pcb-with-parts.step`，不重复提交大文件；它的SHA-256为 `32f1c17ce42f627991ed1dd63ff8bdd7291a04da056506165f18ca9021318158`。

下一步设计反馈应优先确认天线附近布局与扳机公差，再考虑是否修改局部零件；本次结果是软件、文件和名义模型验证，不是实物制造验收。

## 2026-10-05 后续：极短线写回已修复

后续在独立 `codex/route-writeback-fix` 分支查明0.1密耳以下独立导线的自动清理，以及折线按层读取的路径索引错误。采用公开单段折线保存短连接、无参数读全部再筛层和逐段几何核对后，完整保存重开保持500段、37过孔，全部500段实际制造铜层匹配；新格式再次回写也通过。原正式板575段、95过孔的复测仍为零规则错误且几何完全一致。上文关于497段和短线丢失是修复前状态，最新结果见《自动布线写回修复结果》。原生算法的六个漏接仍然存在，专用启动接口未改，原交付设计和外壳保持原样。
