guiwushengzhe-prog/gun-mouse/docs/自动布线写回修复结果.md

# 2026-10-05 自动布线写回修复结果

已修复本机嘉立创专业版 4.1.66 的极短线写回丢失问题：采用公开折线接口保存短连接，完整保存重开及实际制造铜层核对通过。原 AI 的正式板和外壳设计未改。修复分支为 `codex/route-writeback-fix`，工作树为 `F:\项目\枪型飞鼠\.worktrees\route-writeback-fix`。

本轮只修程序读写流程，不替换嘉立创自动布线算法，不重画原电路板，也不修补算法结果原有的六个漏接。那些漏接仍需另行处理，自动布线试验板不能直接下单。

## 实际验证

| 验证对象 | 保存重开 | 制造铜层核对 | 软件规则检查 |
| --- | --- | --- | --- |
| 原生算法的旧格式快照 | 497条普通线＋3条单段折线，共500段；37个过孔 | 全部500段一一匹配，三条短连接实际存在 | 仍为U1原有6个电源/地漏接，没有新增错误 |
| 原正式板的旧格式快照 | 575段普通线、95个过孔；几何及属性完全一致 | 全部575段一一匹配 | 零错误 |
| 修复后含折线的新格式快照再次写回 | 仍为500段、37个过孔；几何及属性完全一致 | 全部500段一一匹配 | 仍为上述6个漏接 |

核对包括每段的端点、网络、图层、线宽与锁定属性，以及过孔坐标、尺寸、类型、规则和阻焊属性，不只比较数量。元件和焊盘写入前必须匹配，重开后再次核对160个引脚网络。接口返回的433条焊盘快照含重复读取记录，不代表433个物理焊盘。

## 根因及修法

1. 软件连接刷新会删除长度小于0.1密耳的独立导线，即约0.00254毫米。三条丢失线正好全部低于此门槛。直接创建后马上回读已不存在，先创建较长线再改短同样被删除。
2. 将短段用公开接口创建为单段折线，保持相同端点、网络、铜层、线宽和锁定属性。软件把它作为完整路径保存，不受独立短导线清理影响。快照增加第二版格式，将普通线与单段折线统一展开为实际线段后核对；旧格式仍支持。多段折线、曲线和圆弧不在本轮支持范围，遇到会明确拒绝。
3. 另发现厂商折线“按图层读取全部对象”接口的索引错误：元数据筛选后，路径却仍从筛选前数组按原位置取，导致短线编号搭配板框路径。改为无参数读全部对象，再在本地筛层；没有修改厂商安装文件。
4. 连接刷新可能重新分配导线编号。本轮13段确实换了编号，已逐段证明几何及网络属性匹配后更新映射；不能把编号变化或数量相同直接当成成功。

软件内部长度单位为密耳，1密耳等于0.0254毫米。原生文件以0.0001密耳量化坐标和线宽，核对仅允许半个量化单位加浮点余量，即0.000051密耳；本轮最大偏差约0.00000127毫米。网络、层、锁定与类型等属性保持严格相同。原正式板回写和新格式再次回写的最大偏差均为零。

制造铜层采用毫米坐标、五位小数，即0.00001毫米的格式分辨率；与源快照核对容许原生文件和制造格式的合计量化误差。全部500段匹配，三条短段的圆形线宽描画命令和约0.15/0.3毫米实际线宽都存在。这里“短”说的是连接被切分后的线段长度，不是极细线宽；这些段是整体铜图形的一部分，软件清理门槛不能当作工厂制造极限。

## 程序入口

从本工作树运行以下命令，会新建一个独立工程副本，写回、保存、关闭重开、核对全部线路与属性、运行软件检查、导出并核对制造铜层。已有同名输出目录会拒绝覆盖，重新运行应换一个标签。只关闭自行创建的会话，不关闭用户原有窗口。

```powershell
Set-Location 'F:\项目\枪型飞鼠\.worktrees\route-writeback-fix'
$env:PYTHONUTF8='1'
& 'E:\GunMouseCAD\Miniforge3\python.exe' scripts\formal_validation\verify_route_writeback.py evidence\formal-validation\native-routes.json --label native-new-check
```

这是当前48器件、两铜层正式设计的隔离验证入口，不是任意工程的通用改写工具。写回通过与电路设计合格分别记录；报告的“可以制造”标志固定为否，不能仅因软件规则通过就批准制造。输出目录 `outputs/route-writeback-fix` 中的副本都有诊断说明。

## 证据及保护

26个证据文件及校验值位于 `evidence/route-writeback-fix/manifest.json`，包括实际创建/回读、保存重开、软件规则检查、原生制造压缩包和逐段几何核对。失败的四次诊断记录也保留；它们分别暴露编号变化、折线路径读取错误、坐标量化问题，不代表最后的修复状态。

源电路板 SHA-256 仍为 `8d538cc85073aae0a9ad1b6faade6a6fb19591e9a2f63300c848f39ded3f4faa`。程序将原板校验值变化视为失败，不会只记录警告后宣布成功。

本机 PCB 程序文件校验值为 `a2cde99d2872ac6f8d80212b8c1fcd644ed1c64b0b6514060dd82a7331a45d13`，接口文件校验值为 `455a96bbeb7222884b1bcd4e89bed9d02450b97e4673dc110098574477cb96d2`。源码根因定位：短线清理字符偏移10113277、折线筛选路径错配11273122。这些为当前版本的字符位置，版本升级后须重新验证。

先前《正式PCB与外壳程序验证结果》及旧试验板说明中“497段、短线丢失”描述的是修复前状态，本报告记录本轮新状态。原生专用自动布线入口缺少接收器的问题未修改，启动仍依靠先前的菜单兼容入口；不能称厂商全部接口已经修好。

## 交给 Astra 的工作

独立设计审核提示词已保存为 `docs/Astra审核提示词-制造与装配.md`。重点是收到后少焊接、少理线、容易装壳，同时考虑工厂全装配、预装触摸扳机、独立摇杆组件、成品线束、装配防错、烧录与功能检查，以及首件和批量方案的成本取舍。审核原正式设计，不把自动布线试验副本当作制造方案；先提建议，不修改原 AI 工作区。
