guiwushengzhe-prog/gun-mouse/pcb/嘉立创最终复绘/实现完成说明.md

# 最终主板重绘交付

用户要将原最终版主板用嘉立创重新设计，自己到平台验证优惠券。当前成果不是此前的整板导入版本；现工程从嘉立创空白主板创建83个原生焊盘和孔，按原最终版的机械位置和电气约定重新计算路径，通过嘉立创原生接口绘制走线和过孔，再由软件铺铜、检查、保存和导出。

## 当前文件

- 编辑源：`F:\项目\枪型飞鼠\pcb\嘉立创最终复绘\枪型飞鼠最终原生复绘.eprj2`。
- 正式制板包：`F:\项目\枪型飞鼠\release\2026-10-18-最终版\枪型飞鼠_最终版_上传打板.zip`。
- 交付工程：`F:\项目\枪型飞鼠\release\2026-10-18-最终版\电路板\嘉立创原生重绘`，含单文件工程及官方工程备份。
- 全套文件：`F:\项目\枪型飞鼠\release\枪型飞鼠_最终版_完整文件.zip`。

在嘉立创专业版打开工程后，选择“枪型飞鼠最终主板”。默认PCB1和初始原理图是软件新建工程的空白占位。

## 核对结果

- 嘉立创专业版4.1.66保存后重新打开：设计规则检查0错误、0未连接。
- 83个焊盘及固定孔与最终机械基准逐一对应；14个网络、55个连接引脚与电气约定一致。
- 71个金属化焊孔、12个非金属化孔和原板框匹配；制造孔位或孔径最大数值差0.00126毫米，来自毫英寸数值舍入。
- 当前835段原生走线、32个过孔；双面地线铺铜由嘉立创计算。过孔属于新布线，不要求保持原18个过孔。
- 板外形52×82毫米、双层、名义板厚1.6毫米、双面铜厚约35微米。
- 原始制造压缩包完整保留，交付上传包与软件原包的文件校验值完全相同。
- 官方工程备份的主板焊盘、走线、过孔、有效铺铜区与保存重开读回状态一致。已删除铺铜区的历史缓存只存在于官方备份历史记录，未计入当前有效铜区。
- 两件STL（打印模型文件）沿用原最终版，文件校验值不变。

这是按独立原生焊盘及网络维护的板图，没有关联器件实例和配套原理图。软件库关联接口在本机版本不稳定，最终使用公开原生焊盘接口完成实际板图；不将独立焊盘误报为已关联器件。没有导入旧整板、旧走线或旧覆铜。临时封装样本已从工程移除，剩余库文档不参与当前板图制造。

## 维护与证据

`tools/jlc_rebuild_final.js`记录原生创建、焊盘、规则、禁布区、走线、铺铜和导出流程；`tools/plan_jlc_native_routes.py`及三个补连脚本记录独立路径规划。`核对输入`保留新板焊盘基准、最终新走线路径、官方制造包、工程备份、原生预览、导出状态和保存重开状态。

`tools/package_jlc_rebuilt.py`先核对这些数据与原最终机械基准、网络约定及打印件校验值，再更新交付包。后续修改设计后，需要重新读取软件状态、保存重开和重新导出，不能复用本次检查记录代替新验证。

旧整板迁移交付归档于`release/2026-10-18-最终版/电路板/迁移前对照/旧整板迁移版`。原其他聊天的候选工程、未提交封装和装配场景保留，不作为本次当前编辑源。

优惠券能否使用由用户自行到平台确认，本次没有平台优惠资格通过记录。上述核对属于软件设计和制造文件核对，未进行实物试装或通电。
