guiwushengzhe-prog/gun-mouse/pcb/嘉立创最终版/维护说明.md

# 枪型飞鼠嘉立创原生工程

打开本目录的“枪型飞鼠最终版.eprj3”。它是嘉立创专业版的文件夹工程索引，同目录的“pcb”子文件夹存放实际板文件，复制或备份时要保留整个目录。

本次以已配套外壳的最终布局为迁移基准，经软件导入后，在嘉立创中同步设计规则、重建双面铺铜、补齐物理叠层，并重新打开核对保存结果。后续直接在这个原生工程上编辑，不再回到迁移前的软件源文件生成主板。

板外形52×82毫米、双层、标称板厚1.6毫米、双面35微米铜。原生软件检查无设计规则错误、无未连接；全部83个焊盘及固定孔的孔位和网络已比对，制造文件包含89个金属化孔和12个非金属孔，合计101孔，其中6个为槽孔。

使用优惠券时，从原生工程进入嘉立创软件内的PCB下单入口。下单板厚、铜厚与裸板手焊设置按最终交付目录的说明选择。

原生制板压缩包只保留七个制造层及两份钻孔文件。软件另外导出的过孔专用钻孔表与金属化总钻孔表重复，不重复提交。

装配查看模型继续用于已核对的孔位和结构空间；当前铜面以嘉立创工程重新铺铜的结果为准。软件检查及文件核对不代替实物试装、焊接和通电。
