guiwushengzhe-prog/gun-mouse/shell/长方条正式预览/工作记录.md

# 长方条正式预览工作记录

## 2026-10-18

用户认可长方条布局，提出主板焊点通常在2毫米内、个别可达4毫米。先按主板4.5毫米净空检查，发现仅加深凹腔会削掉摇杆竖螺丝约半边承力座；因此保留两处完整承力柱，并把右键、扳机接线孔挪到支座下方。

电源开关第三脚虽为空网，但如果也焊高，会接近摇杆螺母；开关整体再上移4毫米。惯性小板位置保留，实体间仍有2.5毫米间隙。

摇杆小板五针槽若按4.5毫米深挖，会把主板固定孔上方壁削薄到0.5毫米。结合用户先前说明小板脚已焊好且很短，改留3毫米净空；孔上方保有2毫米厚壁。槽底与内侧凹腔相连，消除原本可能残留的0.2毫米薄层。

主体/支座单体、66处主板焊点高度包络及四处螺丝工具入口已核对。PCB（主板）以既有KiCad工具链同步布线，不覆盖旧交付；本机SSH别名不可连时才复用已有WSL环境。

用户补充要求完整装配与两个单独壳件的多角度截图，并从整体评估重排。已生成19张实际模型截图、4张总览以及独立标注“未实施”的分区草案，并逐组查看。新增正反面132个主板焊点包络检查，发现电池正极背焊点与H5柱侧面的少量交叠，将柱侧面收平0.2毫米后解除。扩展到10处工具入口、按键螺母入口、名义摇杆运动包络和USB插头通道，均无结构阻挡。两件网格封闭，导线与主体及线间均无交叠。

主板新接点丝印由0.6毫米增至0.8毫米，消除两条字高提示；最终规则检查0错误、0未连接，余22条外部封装库未配置提示。实际板三维、完整装配、几何记录和截图已按此同步。

整体检查发现：局部支座孔后方没有直接通到主体的柱，部分摇杆力经主板传递；内移3.2毫米只解决横向板边投影，轴心到主板面的18.67毫米距离未缩短。建议后续将八颗小元件排到机械安装带外，并在局部孔后方建立第二个主体支柱。建议只形成图示与坐标草案，未替换正式预览或旧交付。
