guiwushengzhe-prog/gun-mouse/shell/长方条正式预览/整体检视与重排建议.md

# 正式预览的整体检视与重排建议

2026-10-18。以本目录完整装配模型、已布线主板和两个壳件为依据。

当前长方条方案已完成正式装配预览，静态几何没有发现实体干涉。整体上仍有值得改进的受力和分区问题；建议下一轮先确定机械安装区，再调整小元件布局，之后简化支座。下面的重排建议没有替换本目录模型。

## 已完成的检查

| 检查对象 | 结果 | 证据范围 |
| --- | --- | --- |
| 完整装配 | 141组实体，包含实际主板铜层、器件、9根软线及五金 | 名义装配外形；不是实物扫描 |
| 主体与摇杆支座 | 各为一个有效实体，单件三角网格封闭 | 均与其他已建模零件没有大于0.001立方毫米的交叠 |
| 主板焊点 | 66处焊孔的正反两面，共132个高度包络，无结构或五金交叠 | 4毫米高度加0.5毫米余量；同时给横向留余量，未验证所有相邻器件间任意形状的大锡团 |
| 原生摇杆小板五处短脚 | 3毫米包络没有结构或五金交叠 | 用户先前说明这些脚已焊好且较短；不能把这项说成任意4毫米小板焊点都兼容 |
| 螺丝工具入口 | 10处名义直径1.8毫米工具通道无阻挡 | 不代表任何粗手柄工具都能伸入 |
| 螺母入口 | 共用螺母及四处按键螺母的侧向入口无结构遮挡 | 支座另一个主板背面螺母应在主体合装前预放 |
| 摇杆与接口 | 名义摇杆运动包络和USB（通用串行接口）插头通道无其他实体干涉 | 未验证手掌、手指尺寸和实际操作手感 |
| 主板孔位与布线 | 8组孔位与装配坐标一致，0规则错误、0未连接 | 22条提示来自本机没有配置相应外部封装库；本版未进行实物通电 |

几何记录见“模型核对.json”，主板记录见“pcb/孔位与布线核对.json”。

## 多角度查看的发现

已生成并逐组查看19张模型截图：完整装配6张；两壳件与真实主板2张；隐藏主体的上部装配1张；主体单件4张；摇杆支座单件4张；透明检视和分解图各1张。4张总览图便于对照，网页图册可以打开单张原图。

1. 长方条外观已经规整。内侧的两根竖向承力柱、横向固定柱和深凹腔仍然有作用，不能因为看着复杂就全部拉平填满。填满会重新挡住高焊点；直接挖掉则会削弱螺丝承压面。
2. 两颗扳机电阻焊点仍在支座投影内，当前依靠4.5毫米净空解决。右键和扳机接线孔已挪出主要覆盖区，但仍是已有布局下的局部处理。
3. 两个横向支座固定点中，共用点穿到主体，另一个局部点只夹住主板。该局部点位于装配坐标(-36.5,-4)，螺母后方至主体护板之间没有直接支柱。因此摇杆受力仍有一部分要由主板传递，截图中没有穿模不能证明板不会弯。
4. 本次内移3.2毫米解决的是板边投影。摇杆轴心到主板操作面的名义距离仍为18.67毫米，悬伸没有随这次平移减少。小板最靠外的一边只比主板边界内收约0.4毫米，商品尺寸误差可能大于这个余量，不能承诺实物投影完全落在边界内。
5. 电池托约83毫米长，托根两侧的连续筋与主体过渡比删除几个窗口更值得关注。保留绑带功能孔和连续侧梁；目前没有实测承载力，不能断言承压合格。

## 推荐的整体调整

优先保留摇杆当前朝向、按键可操作方向和电池区域，以免改变已接受的使用方式。在此基础上做两项配套调整：

**一、给摇杆留独立机械安装带。** 在当前长方条所在区域保留无元件、无高焊点的安装带。将八颗电阻、电容继续按每行一颗、左右交错的方式排在下方。分区草案采用3.5毫米行距和交错两组横向孔位，保留原来的10.16毫米两脚间距；具体坐标在“多角度检视/分区建议坐标_未实施.json”。这里只检查了空间分区，没有布线，也没有把所有元件本体与新后柱逐一装配验证。

**二、把局部固定点接到主体。** 在(-36.5,-4)后方增加通到主体的固定柱，并把该点改成现有M2×20穿过主体、主板和支座的固定方式。长方条两处横向孔仍在同一直线上，两个模块原生孔保持原孔距。这个方案让摇杆的受力更直接传入主体；它需要同时移动当前电阻并核对长螺丝、内螺母座和导线，不能只在当前模型里直接加一根柱子。

完成这两项后，支座可改用规则腹板与螺丝柱组织内侧。外侧继续保持厚长方条和小圆角；不用为每个焊点单独挖碎小槽。主板背面保留约定的焊接净空。

## 其他路线与代价

| 路线 | 能改善什么 | 需要接受的变化 |
| --- | --- | --- |
| 保留当前朝向，机械带与小元件分区，并补第二个主体固定柱 | 减少焊点覆盖、让孔位规整、改善受力路径；推荐先做 | 小元件和受影响铜线需重排，主体多一个柱；仍可使用两件打印壳和已有螺丝规格 |
| 缩短摇杆离主板的悬伸 | 从源头减小同等手指作用力带来的弯矩 | 受原弯排针与模块外形限制，需实测或更改接线方式，不能只平移塑料件 |
| 摇杆小板改为平贴主板 | 支撑可能更简单，厚度方向的布局可重组 | 轴向和拇指操作方向会改变，备用孔也不代表当前帽体、握持与所有器件均已验证 |
| 把所有槽填满、把两个壳件合成一件 | 表面可能更整齐 | 可能挡焊点、螺母或限制已焊模块装入；目前两件结构更方便分步装配和焊接检修 |

## 关于打印和强度的纠正

“拐角少、全做直线就一定更强、更好打印”并不成立。需要同时考虑完整受力路径、孔边剩余厚度、打印层方向、悬空面和支撑去除。接近打印底面的圆角可能形成难打印的悬空，局部倒角反而更合适；外露手接触边和受力根部则可以保留合适圆角。打印方向和拆件也会影响支撑量。参考[Prusa建模指南](https://help.prusa3d.com/article/modeling-with-3d-printing-in-mind_164135)与[支撑说明](https://help.prusa3d.com/article/support-material_1698)。

当前主体的平整外侧可作为打印摆放的起点；独立支座应比较大平面朝下时的凹腔和横向孔支撑需求。还没有针对实际打印服务的材料、设备和摆放完成切片，因此不声称免支撑或强度已通过。

本目录为已同步主板的正式预览。右侧分区草案是后续建议，尚未用于主板制造文件或打印交付。旧交付目录保持原样。
