guiwushengzhe-prog/gun-mouse/shell/长方条正式预览/方案说明.txt

长方条支座正式预览
2026-10-18；承接 f29b667 长方条布局方案。

摇杆与小板沿主板平面内移3.2毫米。支座保持连续、齐平的厚长方条，边缘小圆角。四处螺丝分成两组：原生摇杆孔保持19.5毫米孔距，支座连接主板的两孔在同一直线上，间距14.5毫米。

手焊空间：用户说明主板焊点通常不超过2毫米，个别最高4毫米。本版按主板表面以上4毫米、再加0.5毫米高度余量核对塑料与五金。支座内侧采用共用凹腔，两处摇杆螺丝的承力柱和主板固定柱完整保留。
摇杆小板原有已焊短脚另留3毫米净空；不把所有模块出厂焊点一律当成4毫米高。
共用螺丝头外侧壁增至1.5毫米，杆孔旁的内壁增至1.2毫米。普通M2螺母从侧面装入。

为减少支座覆盖，右键两接线孔改在支座下方，竖列间距2.54毫米；扳机两接线孔下移3毫米；电源开关再上移4毫米，避免空脚附近的高焊点靠到摇杆螺母，开关壳与惯性模块小板之间仍有2.5毫米间隙。
对应孔位、铜线、禁铜区、导线和焊点模型同步更新。只使用已有M2×10、M2×20及普通M2螺母。

查看完整装配：第二代完整装配.obj，保留同目录的同名.mtl材质文件。
查看主体或支座：step目录；stl目录的单件采用装配坐标，仅供预览。
主板源文件与实际铜层三维模型：pcb目录。
几何核对记录：模型核对.json。主板规则核对记录在pcb目录。
多角度截图：多角度检视.html，包含19张截图；多角度检视目录另含4张总览。
整体分析：整体检视与重排建议.md。分区草案单独标为“未实施”，不是当前制造文件。

本目录为正式装配预览版本。整机装配模型不能整体打印；尚未完成实物试装、承压及通电。旧“2026-10-18-结构简化版”打板与打印交付保留原样，不与本预览混用。
