guiwushengzhe-prog/gun-mouse/deliverables/经济型审核候选/先读说明.md

# 经济型审核候选：工厂贴主板，用户补装已有模块与扳机开关

日期：2026-10-06。基线：`7725ea4` 工程样 EVT-A。独立分支：`codex/economy-assembly-20261006`。

**这些文件用于重新审核和试算，尚未获工厂批准经济型，不能直接付款生产。** 原程序、铜层、板形和打印文件没有修改。经济型生产稿、模块固定托架及轴向、实物连接仍待确认。

## 这版具体改变什么

| 位号 | 处理 | 原因 |
| --- | --- | --- |
| U1 | 不让工厂装，主板留空 | 改接用户确认仍在手边的 GY-601N1-LSM6DSV16X 模块，芯片型号保持一致 |
| R10、R11 | 不装 | 模块已有两条 2.2 千欧总线上拉，避免与主板 4.7 千欧并联 |
| SW4 | 自购同型号 SS-01GL13，自己焊到原扳机小板 | 同型号淘宝截图两只实付 4 元，工厂当前两只 62.60 元 |
| J6 | 不装 | 用成品 PH2.0 单头线的裸端直接焊到小板开关公共端和常开端，另一头仍插主板 J4 |
| 其他器件 | 保留工厂装焊 | 摇杆、排母、右键由工厂焊，减少用户需要焊的大量引脚 |

原 25 组、每套 48 个元件，候选变为工厂 22 组、每套 43 个元件。J3/J4/J5 同一组保留，J6 只是从该组去掉，不能将整组连接器删除。R5/R12/R15 保留，充电限流 R3 仍为 6.8 千欧。C7/C8 可保留作电源去耦，R12 接未安装 U1 的芯片选择网络，不需要接到模块。

小板仍在光板生产文件内，但不含任何工厂装焊器件。它仍属于第二款制板，不能假称制板款数费已经取消。只贴主板的贴装多款费用能否免除，需工厂按实际装焊范围重算。

## 先解除页面的 V 割限制

V 割是沿直线预切、便于折断电路板的加工方式。用户此前页面明确以该工艺拒绝经济型。

本地工程样压缩包有 15 个制造文件，没有 V 割专层；板框和非金属化钻孔为主板、扳机小板及邮票孔连接桥，共 20 个 0.6 毫米分板孔。审核尺寸由 13.43×11.93 厘米变为 13.43×12.93 厘米，可能增加了生产边，**但本地源文件不能证明工厂生产稿中 V 割的位置或来源**。

先让工厂核对生产稿，将该单调整为经济型可接的无 V 割工艺。使用本目录的 `生产资料复审说明.txt` 提交修改要求。此说明尚未对外发送。

官方说明：经济型支持单板或邮票孔拼板，普通 1.6 毫米双层玻纤板符合板材范围；标准型会自行增加 5 毫米工艺边，经济型原本无工艺边时不默认添加。仍需审核剩余选中器件，不能将“取消 V 割”等同于“已批准经济型”。

来源：[产品类型与经济型限制](https://www.jlc.com/portal/server_guide_30669.html)、[最新工艺与收费](https://www.jlc.com/portal/server_guide_4025.html)、[工艺边添加规则](https://www.jlc.com/portal/server_guide_89.html)。

## 上传和匹配顺序

1. 先完成电路板生产资料复审，确认该单不再带 V 割限制。
2. 物料清单上传 `gun-mouse-economy-candidate-BOM.csv`，坐标上传 `gun-mouse-economy-candidate-坐标文件.csv`。它们沿用原导出的制表符格式及 UTF-16 编码。
3. 数量选其他数量 2，剩余光板随单发货；焊接层选只贴顶层；经济型可选时选经济型；生产时间选普通 3～4 天。
4. 核对不代焊位号 U1/R10/R11/SW4/J6，其他料号与基线一致。不能误删 J3/J4/J5、R5/R12/R15 等同一组仍要安装的位号。
5. 可制造性确认保留用于查看生产稿，其他可选增值服务保持无要求。小板不安装元件、不印锡膏，用户自己加锡焊开关和两根线。
6. 重新查看费用：经济型工程费、钢网费、五种扩展上料、只贴主板是否还收多款费用、优惠料 U2/R3 身份、是否仍有射线费。系统最终报价优先于下列试算。

官方允许只提交需要工厂焊接的元件，并可在匹配页面删除不用代焊的物料：[部分贴装常见问题](https://m.jlc.com/portal/server_guide_19327.html)。不代焊位置不印锡膏：[官方工艺问答](https://m.jlc.com/portal/server_guide_4026.html)。

## 已有模块如何接：只作为接线候选

模块保持直接读取传感器芯片的模式，不改为板上单片机的角度输出。因此不把说明书中的角度输出 200 次/秒当成当前芯片采样上限，也不改交互逻辑。

| 主板排母 J1 大通孔焊点 | 对应信号 | 模块说明书插针 |
| --- | --- | --- |
| 第 1 脚 | 3.3 伏 | 第 1 脚电源 |
| 第 22 脚 | 地 | 第 2 脚地 |
| 第 12 脚 | 数据线，处理器引脚 8 | 第 4 脚芯片数据 |
| 第 15 脚 | 时钟线，处理器引脚 9 | 第 3 脚芯片时钟 |
| 模块本地短接 | 地址选择接地，地址为 `0x6A` | 第 5 脚接第 2 脚 |
| 模块模式脚 | 保持悬空，直接芯片接口 | 模式选择脚悬空 |

模块芯片选择脚已有 10 千欧上拉，数据、时钟已有 2.2 千欧上拉。当前程序轮询读取，不需要连接两条中断线。模式脚接地会切换到板上单片机接口，本方案不能这样接。先按本项目保存的同型号模块说明书和电路图确认插针的 1 脚方向，不依赖照片中“从左往右”的猜测。

接线在排母背面大焊点，开发板从正面插入；不能接到裸芯片的小焊盘。电源线迅速朝后引出，避开天线，焊点绝缘并固定拉力。模块必须有刚性托架，核对芯片轴向；不能随意粘在活动盖上。模块标称 17.8×20.6×2.8 毫米，带插针、焊锡后的高度未实测，**尚无适配它的新打印件**。现有程序与模块芯片接口相符，但尚未在实物上验证连接和枪身轴向。

操作逻辑保留：轻触扳机启用体感、机械扣扳机为左键、拇指按键为右键、摇杆移动鼠标、摇杆按下为中键、摇杆和体感位移相加。若模块方向与原芯片安装方向不同，后续只处理轴向映射，不能私自改变上述动作关系。

## 两块部分装配主板的条件试算

用户只需要先做出一把；工厂页面当前两片起焊，第二块作备件。用户仅确认已有一块模块，所以不把两块部分装配板宣传为两把完成品。

原当前报价：元件 172.54 元，加工 579.67 元，合计 752.21 元。下列只比较装焊和开关，未加光板制造、外壳、物流和其他已有器件。

| 项目 | 试算，元 |
| --- | ---: |
| 材料：172.54−41.86（U1）−62.60（SW4）−0.326（R10/R11）−2.908（J6） | 64.85 |
| 经济型工程 | 50 |
| 五种普通扩展料上料 | 100 |
| 插件工程 | 20 |
| 插件焊盘，61 个/套×2×0.1 | 12.20 |
| 贴片焊盘，118 个/套×2×0.01 | 2.36 |
| 可制造性确认 | 3 |
| 包装沿用原报价作为暂估 | 3.07 |
| 小计，尚未计多款板及可能射线等额外费用 | 255.48 |
| 多款板待核，若只按主板装焊可不收，否则暂保留 50～100 | 0～100 |
| 用户截图同型号两只开关 | 4 |
| **合计条件范围** | **约 260～360** |

五种普通扩展料为 USB1、U3、U4、SW3、J3/J4/J5，按经济型 20 元/种。U2 和 R3 免换料标签继续有效是试算条件；优惠失效时每种可能另增 20 元。材料减少后最低采购量和损耗可能重算。删除 U1 后仍需看是否有其他器件被要求射线检查；不保证该项一定为零。多款费用的解释和仅贴主板如何计价未获工厂确认。

经济型工程 50 元、钢网不收费有公开规则依据；上料优惠依据：[基础库与扩展库规则](https://m.jlc.com/portal/server_guide_38538.html)。此范围是目标试算，**没有在用户订单页面得到新报价**。

## SS-01GL13 和相近件的价格

| 型号 | 价格证据 | 更换边界 |
| --- | --- | --- |
| 欧姆龙 SS-01GL13 | 用户本次工厂订单 31.30 元/只；淘宝截图标价 2.50，两只实付 4 元；国内商城公开参考 23.94，未核数量档 | 本方案优先同型号自购，保留现有杠杆与触点设定 |
| 欧姆龙 SS-01GL | 淘宝截图 2.35；国内商城推荐表参考 4.24，未核数量档 | 直摆杆，动作高度和原件不同，不能直接替换 |
| 欧姆龙 SS-01GL2 | 淘宝截图 3.10；国内商城公开参考 6.72，未核数量档 | 有真实滚轮，高度不同，需要改结构 |
| 星坤 SM5-180UP-1，C2885372 | 国内商城公开参考 1.80，未核数量档 | 弧形柄，尺寸接近，但为 5 安型，低电流信号触点和脚位未核实 |
| 星坤 DM1-16UP-1，C405950 | 国内商城公开参考 0.6212，未核数量档 | 本体明显更小，必须改板和安装结构 |

商城参考价未查到两只采购的数量阶梯，不能当作用户登录后的结算价。来源：[原件](https://item.szlcsc.com/4389762.html)、[直摆杆参考](https://item.szlcsc.com/95179.html)、[滚轮型](https://item.szlcsc.com/7180434.html)、[国产弧形柄](https://item.szlcsc.com/3095864.html)、[国产小本体](https://item.szlcsc.com/393875.html)。

欧姆龙规格中“01”是 0.1 安微小负载型，采用金合金交叉触点；“GL13”是末端弯成圆弧的摆杆。5 安额定电流更大并不证明微小按键信号更适用。原厂规格说明：[欧姆龙当前系列手册](https://components.omron.com/eu-en/system/files/2024-11/datasheet_pdf/B032-E1.pdf)。

规格能解释不同触点和机械型号，**不能解释同一个型号必须卖 31.30 元**。现能确认的是渠道报价不同；进货批次、定价、库存、货况或销售保障是否造成价差，没有商家内部证据，不能定论，也不能凭便宜就认定淘宝为假货。
