guiwushengzhe-prog/gun-mouse/pcb/gun-mouse-formal-route/验证用途说明.md

这是未通过的自动布线诊断副本，不是交付版本。

嘉立创原生算法生成500段线、37个过孔，但惯性芯片仍有6处未连接。公开直线接口写回后少了3段极短线，脚本拒绝认定等价并没有调用显式保存；关闭时软件仍将497段线和37个过孔写入磁盘。

原设计575段线、95个过孔保留在原分支及 gun-mouse-formal-baseline，完整写回与重开验证位于 gun-mouse-formal-roundtrip。双面覆铜对照位于 gun-mouse-formal-copper。
