guiwushengzhe-prog/gun-mouse/deliverables/pcb-shell-v1/检查报告.md

# 检查报告（自动生成）

配置版本：PCB-Shell-V1。由 `scripts/pcb_shell_v1/report.py` 根据各脚本输出生成，请勿手改。
这是文件检查报告；软件检查与模型核对结果分别列出，不代表制造或实物验收完成。

## 电路板

- 拼板外形 119.3 × 134.3 毫米（主板 + 扳机小板），2 层，1.6 毫米。
- 原建板记录：器件 48 个；焊盘网络写入 160/160，原流程进行了编辑器载入核对。
- 布线器记录：28 个网络，未连通列表 无；导线段 564，过孔 95。
- 规则（毫米）：{"grid": 0.1, "signal": 0.15, "power": 0.3, "clearance_track": 0.13, "clearance_pad_via": 0.165, "slot": 0.32, "via": [0.6, 0.3], "edge": 0.3}；电源网络线宽 {"3V3": [0.3], "VSYS": [0.3], "VBUS": [0.3], "VBAT": [0.3], "GND": [0.3]}。
- 本版保留导线连接地网络的设计，没有铺铜；原后台流程未完成覆铜填充，不据此推断所有软件环境均不支持。

### 嘉立创设计规则检查（两层板工艺规则）

读取 `drc-report.json`：软件报告总数 0；逐项解析数 0。

该份软件记录为 0 项错误。

### 网表核对证据

- 离线核对：通过其声明的核对范围；器件 48 个，已配置连线引脚 160 个。
- 证据：`验证记录/netlist-handoff-report.json`（生成输入为同名 outputs 文件）。

| 离线核对项目 | 差异数量 |
| --- | --- |
| 配置与导出 PCB 网表 | 0 |
| 配置与保存的 PCB 焊盘网络 | 0 |
| PCB 与原理图器件唯一编号 | 0 |
| 导出网表唯一编号是否陈旧 | 0 |
| 原理图真实引线与引脚网络 | 0 |
| 同一引线组内冲突网络标记 | 0 |
| 未能核对的镜像器件 | 0 |

离线核对使用保存文件中的符号引脚和导线几何；不代替软件编译网表、设计规则检查或实物电气验收。

- 嘉立创软件编译网表比较：通过其声明的核对范围。
- 编译报告器件 48 个，引脚 160 个；是否完成 PCB 比较：是。
- 证据：`验证记录/schematic-netlist-handoff-report.json`；软件网表生成成功本身不代表与 PCB 一致。
- 软件网表比较差异：0 项。
- 报告范围：核对软件编译原理图与配置、导出电路板的已连接引脚、空网络、器件集合、唯一编号、封装及采购身份；passed 不代表软件全部元数据同步或设计规则检查为零，不代表电气性能验收

### 导出文件

| 文件 | 字节 | SHA-256 |
| --- | --- | --- |
| `制板文件/gun-mouse-v1-Gerber.zip` | 103032 | `9b7b8f5c869aa374b3863cac7eda0633c30185e3ce005cb56dfb697d77c9188f` |
| `制板文件/gun-mouse-v1-BOM.csv` | 4124 | `c868210f1ea83002a37fdeb752aab4dfb3919983b66d7dfd4ace513d8ecbd856` |
| `制板文件/gun-mouse-v1-坐标文件.csv` | 19732 | `231b88c558c9ce0a593e810f6b4215ea20cc2a691154eb469157158b22eb96d8` |
| `制板文件/gun-mouse-v1-网表.enet` | 115123 | `19a182f2054efe3e6c2d3908385ff6960c4b69358d9d8e76340a911381a4b467` |

## 外壳与机构

### 打印件

| 零件 | 打印外形（毫米） | 体积（立方厘米） |
| --- | --- | --- |
| 左半壳 | 180.0 × 139.0 × 21.6 | 57.36 |
| 右半壳 | 180.0 × 139.0 × 18.4 | 56.79 |
| 扳机 | 21.4 × 29.2 × 10.0 | 3.15 |
| 扳机触摸面盖 | 24.4 × 7.3 × 0.9 | 0.16 |
| 右键帽 | 16.8 × 11.8 × 16.2 | 1.12 |
| 摇杆帽 | 16.0 × 16.0 × 14.6 | 0.91 |

扳机行程 4.1 毫米（触点静止 x=-2.0，按到底 x=-6.1）；摇杆开口半径 内 8.18 / 外 9.05 毫米。

### 原模型干涉记录（重叠体积，立方毫米；0 含舍入到零或仅面接触的情况）

| 对象 | 检查对象 | 重叠 |
| --- | --- | --- |
| 扳机(静止) | 左半壳 | 0.0 |
| 扳机(静止) | 右半壳 | 0.0 |
| 扳机(静止) | 扳机小板及器件 | 1.486 |
| 扳机(按到底) | 左半壳 | 0.0 |
| 扳机(按到底) | 右半壳 | 0.0 |
| 扳机(按到底) | 扳机小板及器件 | 8.267 |
| 右键帽(静止) | 左半壳 | 0.0 |
| 右键帽(静止) | 右半壳 | 0.0 |
| 右键帽(静止) | 主板及器件 | 0.0 |
| 右键帽(按到底) | 左半壳 | 0.0 |
| 右键帽(按到底) | 右半壳 | 0.0 |
| 摇杆帽(居中) | 左半壳 | 0.0 |
| 摇杆帽(居中) | 右半壳 | 0.0 |
| 摇杆帽(居中) | 主板及器件 | 0.0 |
| 开发板参考体 | 左半壳 | 0.0 |
| 开发板参考体 | 右半壳 | 0.0 |
| 开发板参考体 | 主板及器件 | 0.004 |
| 电池最大外形 | 左半壳 | 0.0 |
| 电池最大外形 | 右半壳 | 0.0 |
| 电池最大外形 | 主板及器件 | 0.0 |
| 摇杆帽(倾斜20°X1) | 左半壳 | 0.0 |
| 摇杆帽(倾斜20°X1) | 右半壳 | 0.0 |
| 摇杆帽(倾斜20°X-1) | 左半壳 | 0.0 |
| 摇杆帽(倾斜20°X-1) | 右半壳 | 0.0 |
| 摇杆帽(倾斜20°Z1) | 左半壳 | 0.0 |
| 摇杆帽(倾斜20°Z1) | 右半壳 | 0.0 |
| 摇杆帽(倾斜20°Z-1) | 左半壳 | 0.0 |
| 摇杆帽(倾斜20°Z-1) | 右半壳 | 0.0 |
| 主板及器件 | 左半壳 | 0.003 |
| 主板及器件 | 右半壳 | 0.0 |
| 扳机小板及器件 | 左半壳 | 0.0 |
| 扳机小板及器件 | 右半壳 | 0.0 |
| 左右半壳 | 互相 | 0.0 |

微动模型没有随动杠杆和柱塞；按压后的正交集必须按接触对象解释。扳机能否实际触发、微动会否过压不能由该表单独确定。

### 限位反向验证（模型超过设计限位时应与外壳重叠）

| 情况 | 重叠 |
| --- | --- |
| 扳机多压0.5毫米(应>0，硬限位) | 25.69 |
| 扳机向前0.5毫米(应>0，复位限位) | 5.75 |
| 摇杆帽倾斜24°(应>0，开口限位) | 10.138 |
| 右键帽多压0.3毫米(应>0，帽沿限位) | 7.56 |

正交集说明模型设置了对应限位；不代表打印件强度或实际开关余行程已经验收。

### 独立实体与打印网格核对

配置及六件交付文件与核对记录的校验值：一致。
证据：`验证记录/mechanical-handoff-report.json`。实体有效、网格封闭只说明保存文件的几何状态，不代表已经打印装配。

| 零件 | STEP 实体有效 | 实体数 | 网格连通体 | 开放边 | 非流形边 | 零面积面 |
| --- | --- | --- | --- | --- | --- | --- |
| 左半壳 | 是 | 1 | 1 | 0 | 0 | 0 |
| 右半壳 | 是 | 1 | 1 | 0 | 0 | 0 |
| 扳机 | 是 | 1 | 1 | 0 | 0 | 0 |
| 扳机触摸面盖 | 是 | 1 | 1 | 0 | 0 | 0 |
| 右键帽 | 是 | 1 | 1 | 0 | 0 | 0 |
| 摇杆帽 | 是 | 1 | 1 | 0 | 0 | 0 |

仅灯孔切刀径向余量增加0.01毫米；名义孔径1.6、孔轴、机构和配置保持；实切孔径1.62毫米

| 相对原交付实体 | 体积变化（立方毫米） |
| --- | --- |
| 左半壳 | -0.117404480 |
| 右半壳 | -0.004129250 |
| 扳机 | 0.000000000 |
| 扳机触摸面盖 | 0.000000000 |
| 右键帽 | 0.000000000 |
| 摇杆帽 | 0.000000000 |

4 件体积不变：扳机、扳机触摸面盖、右键帽、摇杆帽。

网格清理删除 8 个严格零面积三角面；非零面积面记录保持不变。清理脚本为 `clean_stl_zero_area.py`，它不修改 STEP 实体外形。

### 操作状态的实际接触记录

正交集保留为接触记录，不笼统写作所有实体干涉通过。开关杠杆和柱塞在参考模型中不会随按压变形或移动。

| 操作状态 | 与不随动开关模型的交集（立方毫米） | 接触实体索引 |
| --- | --- | --- |
| 扳机静止与扳机小板 | 1.485511987 | 4 |
| 扳机按到底与扳机小板 | 8.266682052 | 4 |
| 右键帽按到底与主板 | 1.987499049 | 96 |

本次逐实体交集位置对应扳机微动杠杆和右键微动柱塞；扳机未与小板板体、开关壳体或插座出现体积交集。这是已保存模型的接触位置核对，不是实际微动运动和触发点验收。

| 数值贴合薄层 | 交集体积（立方毫米） | Y 向交集厚度（毫米） |
| --- | --- | --- |
| 主板与左壳 | 0.003307072 | 0.000028245 |
| 主板与开发板 | 0.003644483 | 0.000028293 |

主板与左壳约 0.003 立方毫米、开发板与排母约 0.004 立方毫米的正交集对应约 0.000028 毫米厚的导出贴合薄层。它们不是检查得到的零交集；该数值薄层解释也不等于实际装配公差已经验证。

### 摇杆轴高范围核对

| 保存模型操作状态 | 左壳交集 | 右壳交集 |
| --- | --- | --- |
| 轴高18.95，X-1，20度 | 0.000000000 | 0.000000000 |
| 轴高18.95，X+1，20度 | 0.000000000 | 0.000000000 |
| 轴高18.95，Z-1，20度 | 0.000000000 | 0.000000000 |
| 轴高18.95，Z+1，20度 | 0.000000000 | 0.000000000 |
| 轴高19.65，X-1，20度 | 0.000000000 | 0.000000000 |
| 轴高19.65，X+1，20度 | 0.000000000 | 0.000000000 |
| 轴高19.65，Z-1，20度 | 0.000000000 | 0.000000000 |
| 轴高19.65，Z+1，20度 | 0.000000000 | 0.000000000 |

整机压缩包内 STEP 与当前未压缩 STEP 的校验值：一致。

## 实物未验收与尺寸边界

本报告完成的是文件、连接记录及模型核对，不能作为制造定稿或首轮打印必然装好的保证。本轮尚未进行实际打印、完整装配、电气上电、无线、触摸稳定性和真实开关动作验收。

- 扳机触点静止高度 17.0、动作高度 12.8～14.4；所需行程 2.6～4.2，现行行程 4.1。动作高度下限的个体还差 0.1 毫米，不能保证整个动作公差范围触发。
- 按配置引用的 SS 规格，余行程至少 1.2 毫米；动作高度上限的个体到现行限位会再压 1.5 毫米，超过上述保证量。实际触发与剩余可压行程须核对，可能需要局部调整扳机或限位；本轮未擅自改变该机构。
- 触摸盖凹槽比盖厚仅多约 0.15 毫米，铜箔和胶层的叠加厚度要核对。使用薄胶层，不能照原清单给触摸盖贴 1～2 毫米泡棉。
- 电池仓厚 8.4 毫米；最大厚 8.0 的电池只剩 0.4 毫米名义余量。只有较薄电池才可配厚泡棉，电池与垫片总厚还须预留打印误差；保护板、插头和线头也需要实测。
- 开发板厚度 1.6、元件高度 3.5、摇杆转动中心高 7.0 毫米仍为假定或参考。线束弯曲、插拔空间、弹簧和打印收缩未完成实物验收。
