guiwushengzhe-prog/gun-mouse/shell/长方条支座方案/方案说明.txt

长方条摇杆支座方案——仅供布局预览

2026-10-18，基于 4ff7405 版本。

摇杆与小板沿主板平面向内移动 3.2 毫米，小板投影的外侧边收至主板边界内约 0.4 毫米。
独立支座改为连续厚长方条，外包络约 30.75×9.07×12.1 毫米，外缘做 0.5 毫米小圆角。焊点避让留在内侧。
四处螺丝分为两组：摇杆小板的两个原生孔保持 19.5 毫米孔距；支座连接主板的两个孔对齐，中心间距 14.5 毫米。
使用已有的 M2×10、M2×20 螺丝及普通 M2 螺母。共用的 M2×20 改由支座外侧装入，螺母藏在主体柱的侧面入口。

查看整体：第二代完整装配.obj，保留同目录的同名 .mtl 材质文件。
单独查看支座：step/长方条支座_预览.step 或 stl/长方条支座_仅供预览.stl。
主体配合件：step/engineering_mount.step。

本方案已检查支座与主体均为有效单体，以及支座和主体与装配零件的几何交叠。
四处螺丝的直径 1.8 毫米工具通道未发现遮挡；四颗螺丝互相无实体交叠，共用螺母的侧向入口无实体交叠。这些为模型检查，尚未进行实物装配。
这是布局模型，主板只表示孔位，尚未重新布线；不能据此打板，也不要把整机装配模型当打印单件。
原“2026-10-18-结构简化版”交付文件保留原样。本方案确认后，需要再同步主板布线和正式打印文件。
