guiwushengzhe-prog/gun-mouse/concepts/v2/README.md

# V1-Concept-01 新版概念图

生成日期：2026-10-05。用于比较外观和说明交互，不是按真实模块尺寸生成的机械模型。

后续用户已决定省掉 TTP223，改用 S3 内置触摸。这里保留旧图：A/B外形可继续参考，C的独立触摸检测板不再装入当前原型；新版内部布局见 `../v3`。

- `A-圆润短顶罩.png`：沿用旧图的圆润短顶罩，移除握把触摸区，触摸面移到扳机。
- `B-较长顶罩与饱满握把.png`：较长上壳和饱满握把的另一方向；包络文字为探索目标，未验证装配。
- `C-触摸与机械点击分开检测.png`：独立电极、固定检测板、柔性引线、机械微动和壳体限位的原理，以及四种食指状态。

第一版用普通 PS2 五针模块，独立安装座。图中的摇杆帽、孔、螺丝、微动、检测板、转轴、引线和多视图只是概念表达，不代表用户实物型号、尺寸或可直接打印的结构。蓝色只表示触摸面，也不意味着最终需要蓝色材料。

第三张的铜箔位置、柔性连接和硬限位需在正式机械模型中重新落实。现有 TTP223 接外部电极要先检查模块并实测，效果图没有验证电气可行性或抬指停止时间。

`../v1` 的旧握把触摸图仅作历史留存，当前交互以 `../../docs/V1-Concept-01-设计输入.md` 为准。后续正式三维模型仍用已有 CadQuery 程序建模与 CQ-editor 原生查看，不需要为每轮模型重做展示程序。
