guiwushengzhe-prog/gun-mouse/concepts/v3/A-内部布局透视.png

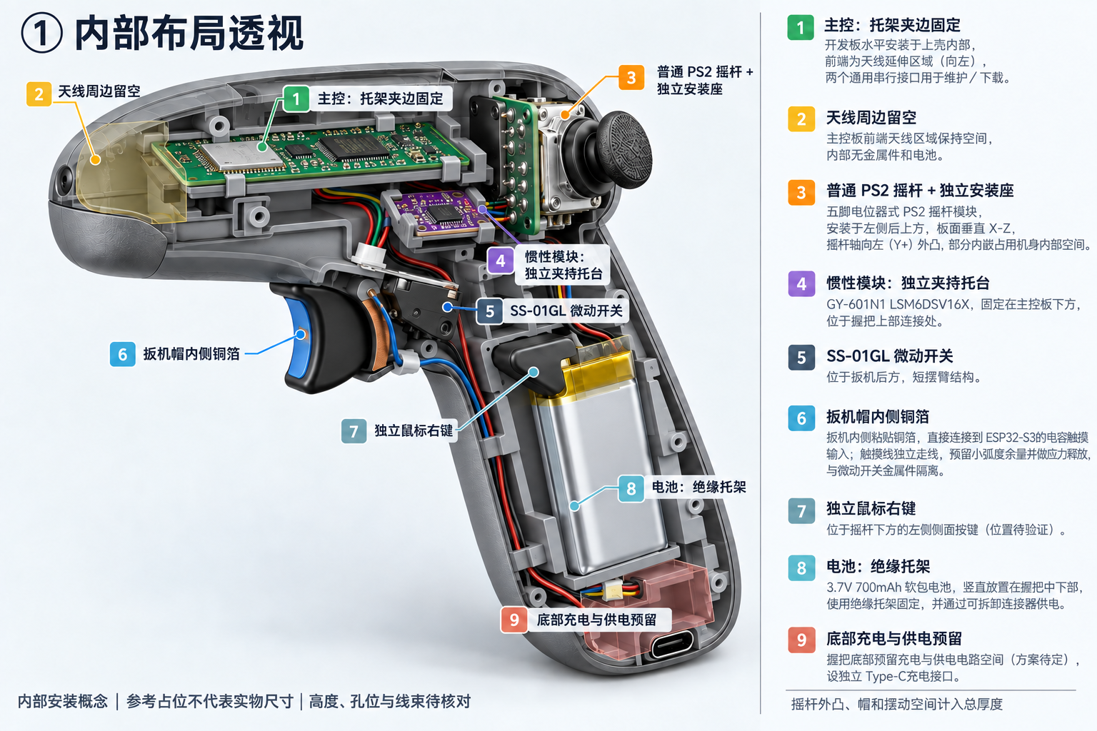
concepts/v3/A-内部布局透视.png
