guiwushengzhe-prog/gun-mouse/concepts/v3/B-分解安装关系.png

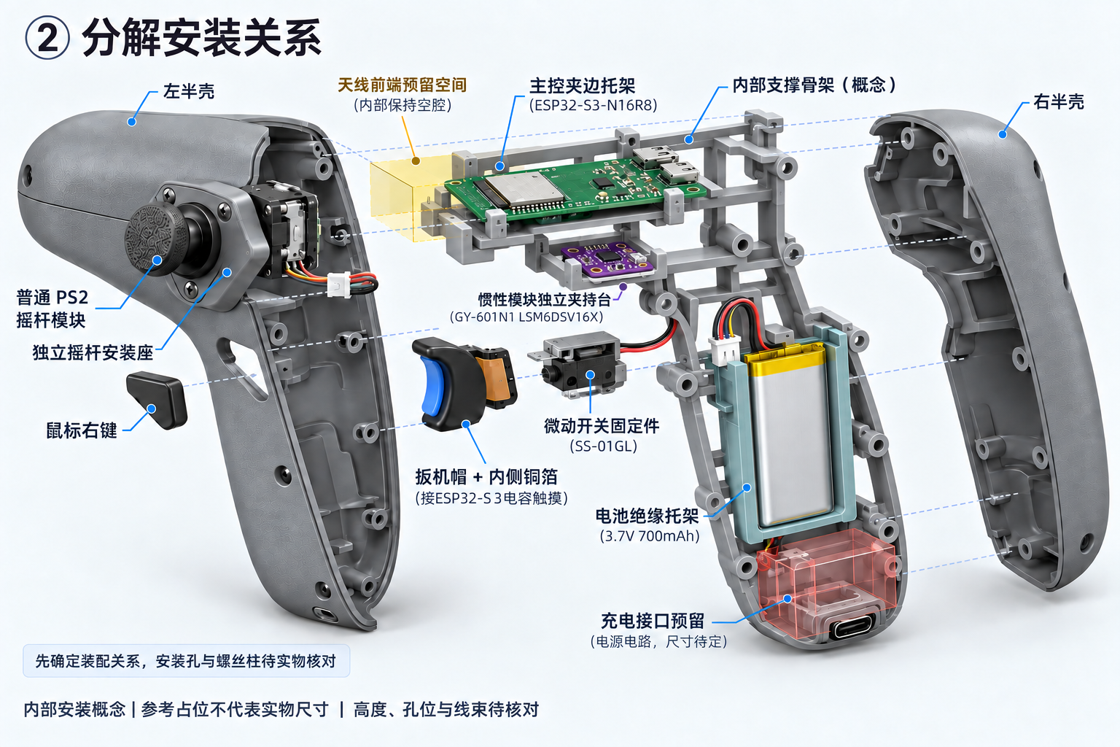
concepts/v3/B-分解安装关系.png
