guiwushengzhe-prog/gun-mouse/concepts/v3/C-触摸扳机与线束.png

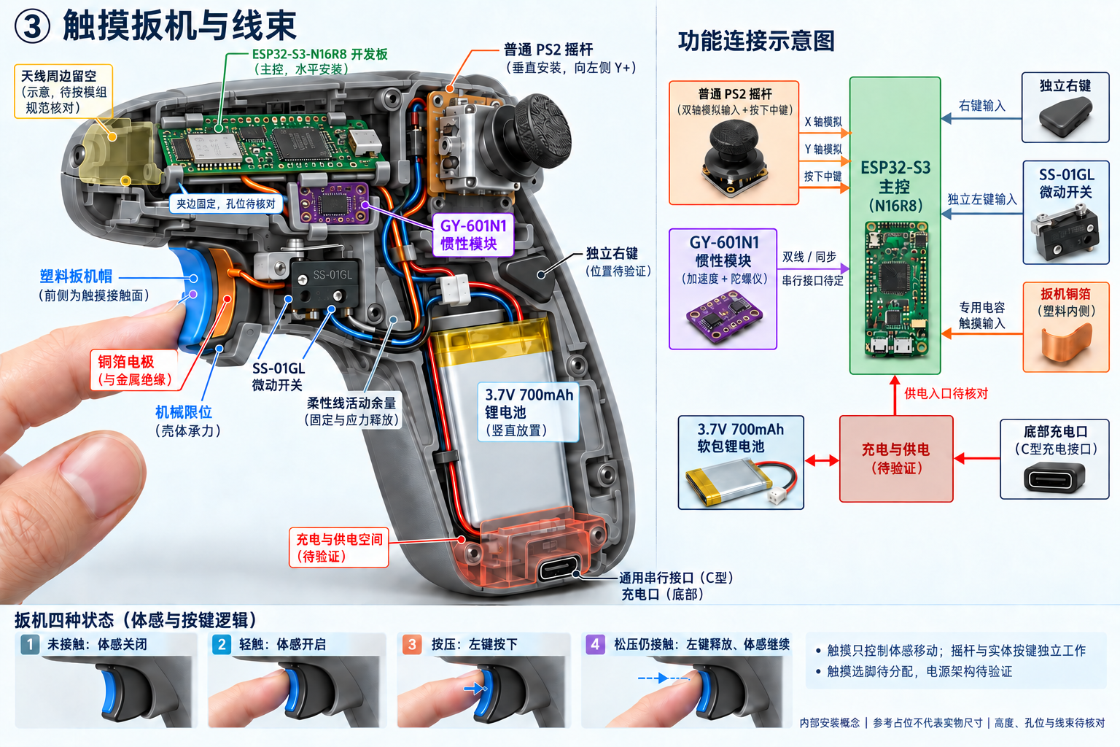
concepts/v3/C-触摸扳机与线束.png
