guiwushengzhe-prog/gun-mouse/concepts/v3/参考-三维占位.png

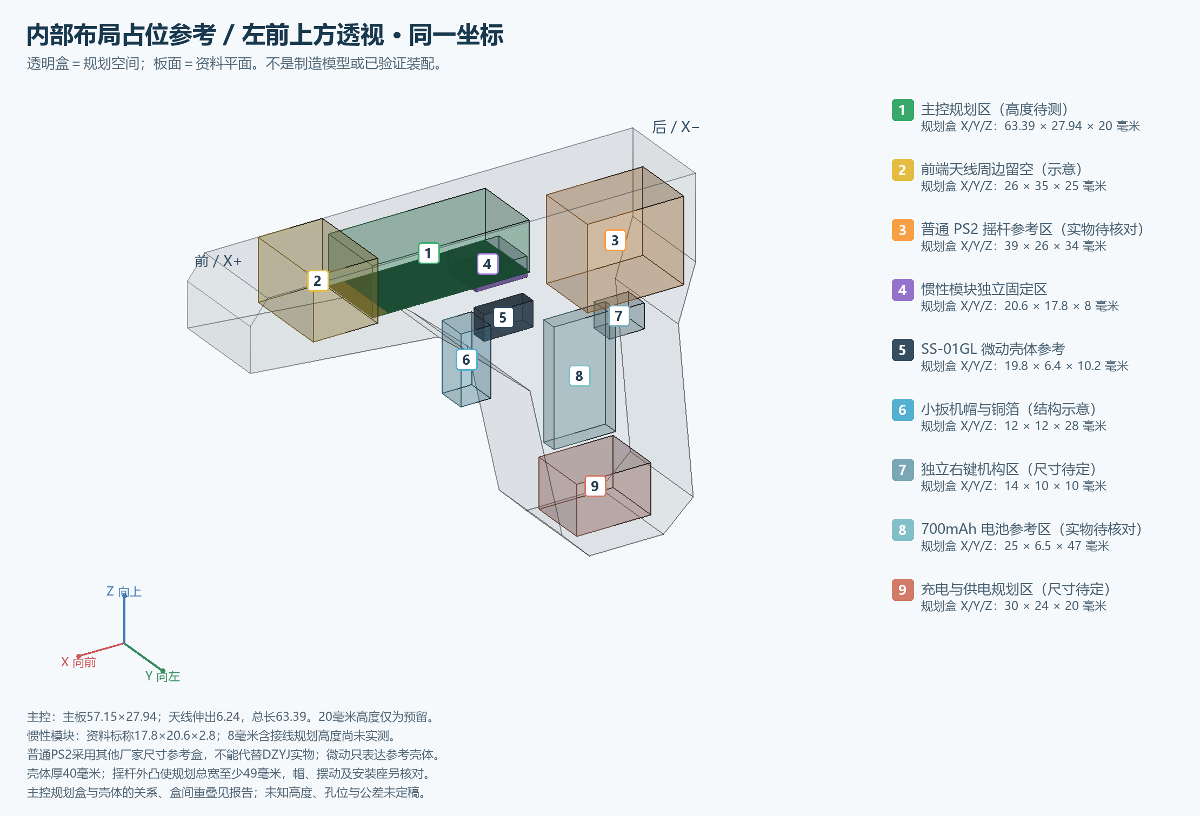
concepts/v3/参考-三维占位.png
