guiwushengzhe-prog/gun-mouse/deliverables/evt-a/预览图/02-扳机尾部螺栓.png

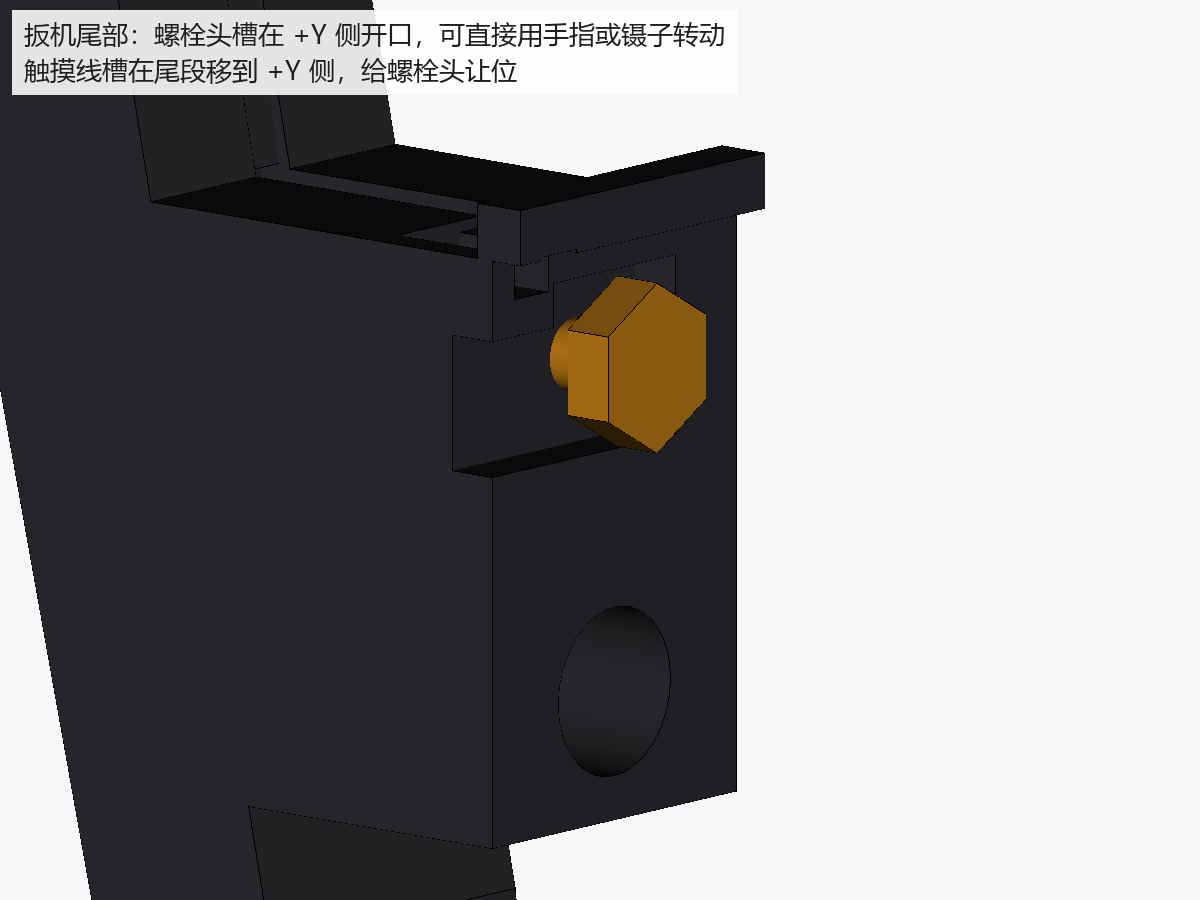
deliverables/evt-a/预览图/02-扳机尾部螺栓.png
