guiwushengzhe-prog/gun-mouse/deliverables/pcb-shell-v1/预览图/01-整机左前视.png

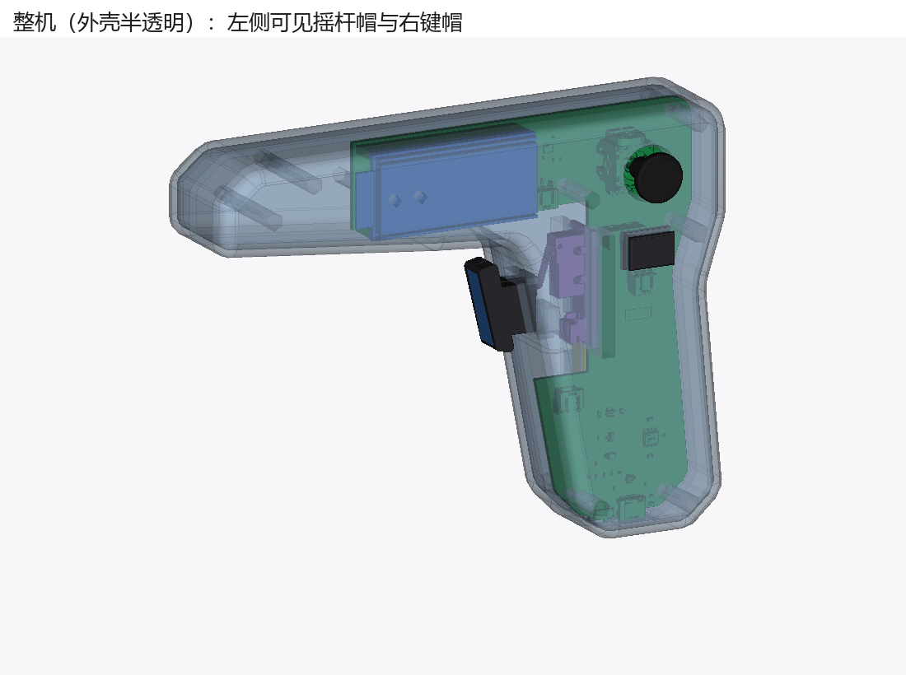
deliverables/pcb-shell-v1/预览图/01-整机左前视.png
