guiwushengzhe-prog/gun-mouse/deliverables/pcb-shell-v1/预览图/02-右半壳内部.png

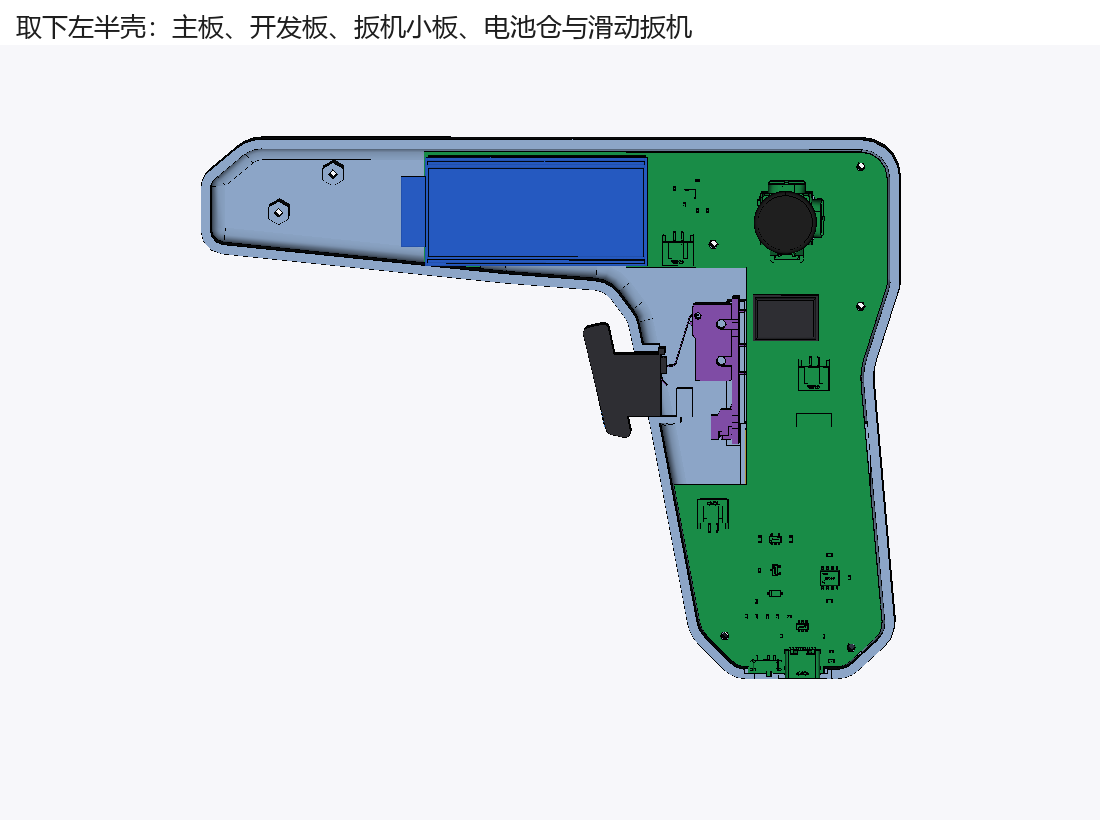
deliverables/pcb-shell-v1/预览图/02-右半壳内部.png
