guiwushengzhe-prog/gun-mouse/deliverables/pcb-shell-v1/预览图/03-右半壳空壳.png

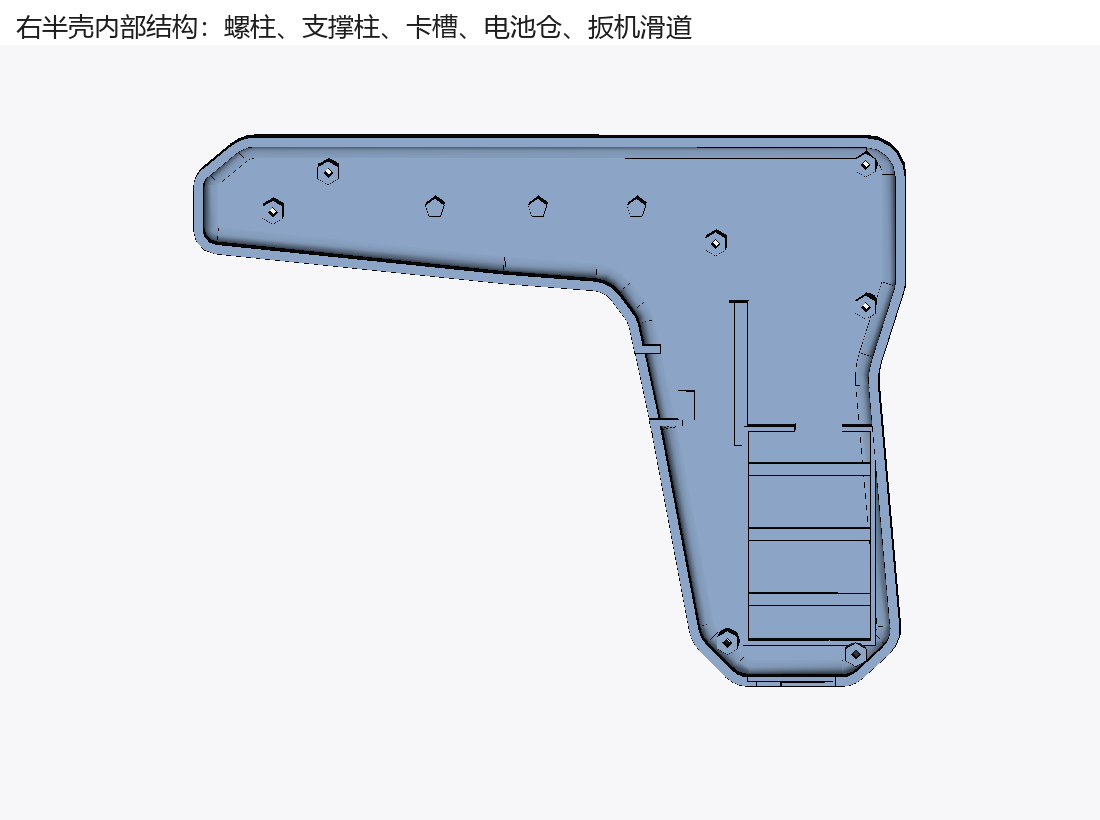
deliverables/pcb-shell-v1/预览图/03-右半壳空壳.png
