guiwushengzhe-prog/gun-mouse/deliverables/pcb-shell-v1/预览图/05-内部器件.png

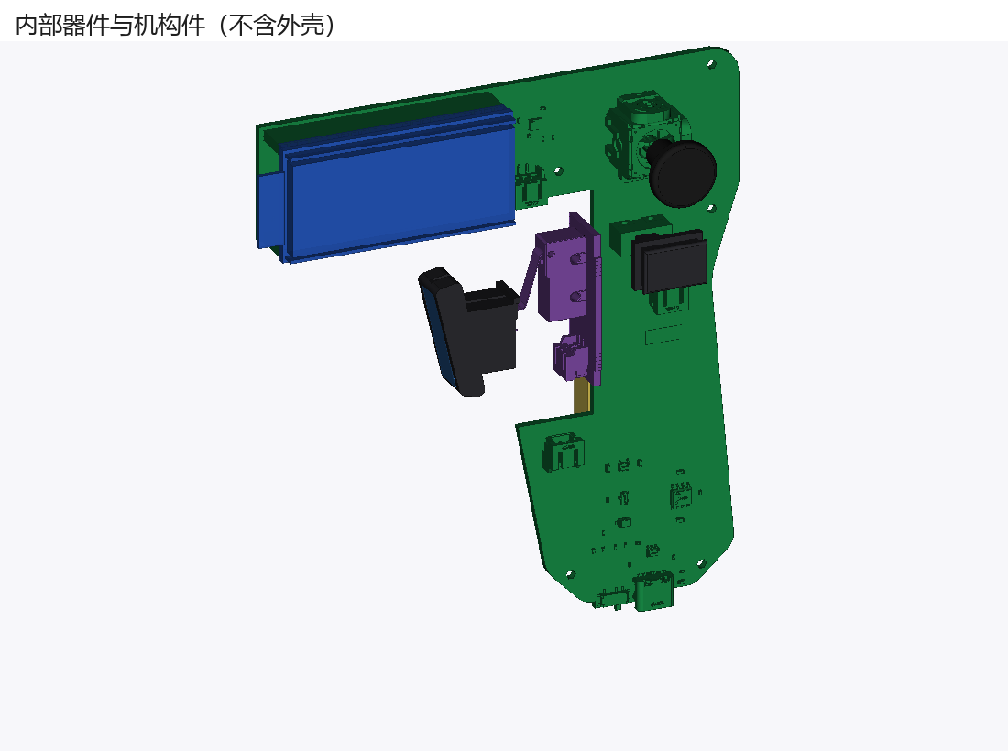
deliverables/pcb-shell-v1/预览图/05-内部器件.png
