guiwushengzhe-prog/gun-mouse/deliverables/pcb-shell-v1/预览图/06-主板布局侧视.png

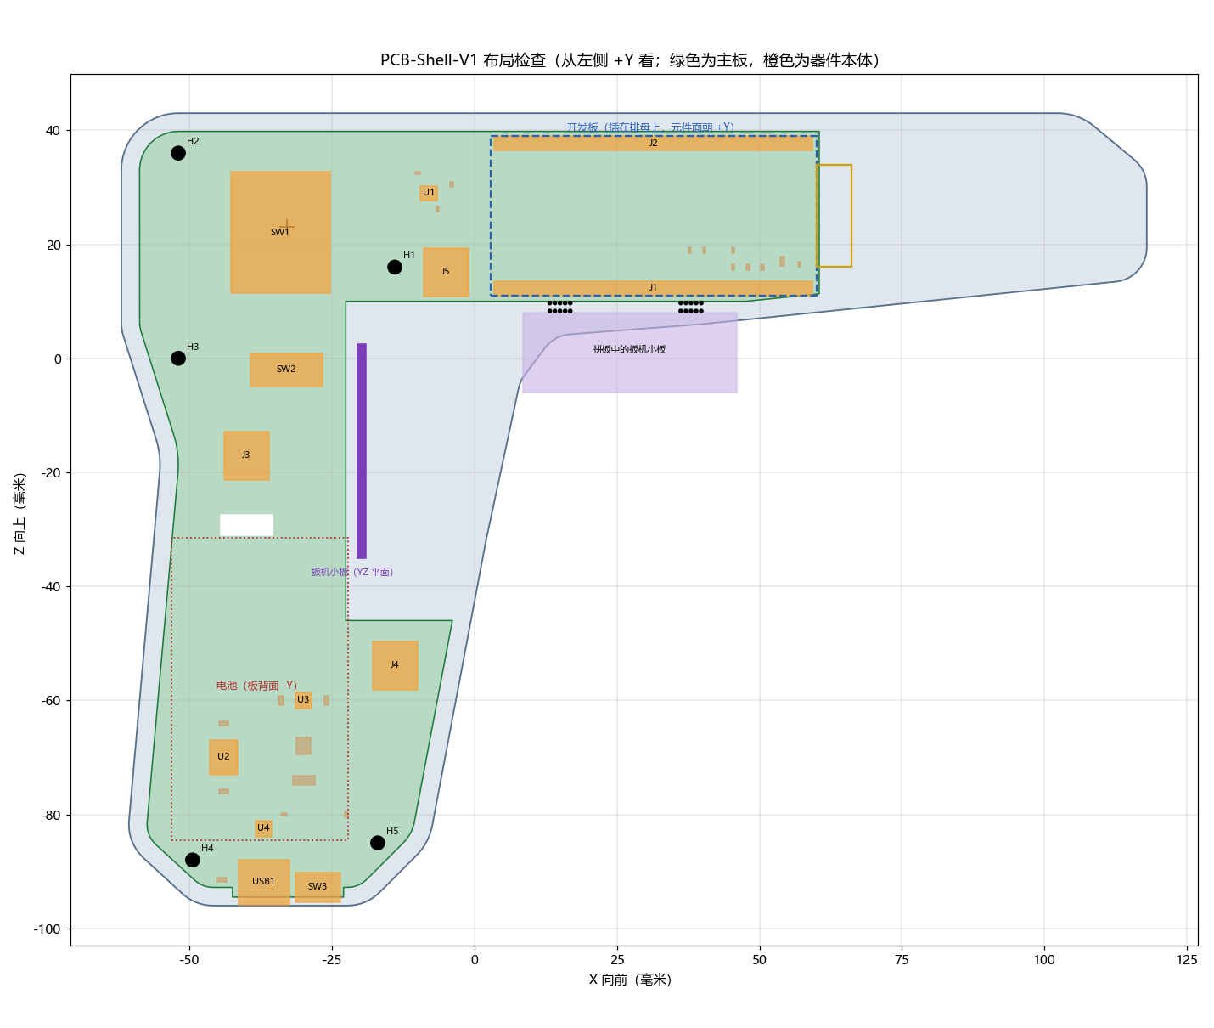
deliverables/pcb-shell-v1/预览图/06-主板布局侧视.png
