guiwushengzhe-prog/gun-mouse/deliverables/pcb-shell-v1/预览图/07-布线检查（元件面视角，红顶层蓝底层）.png

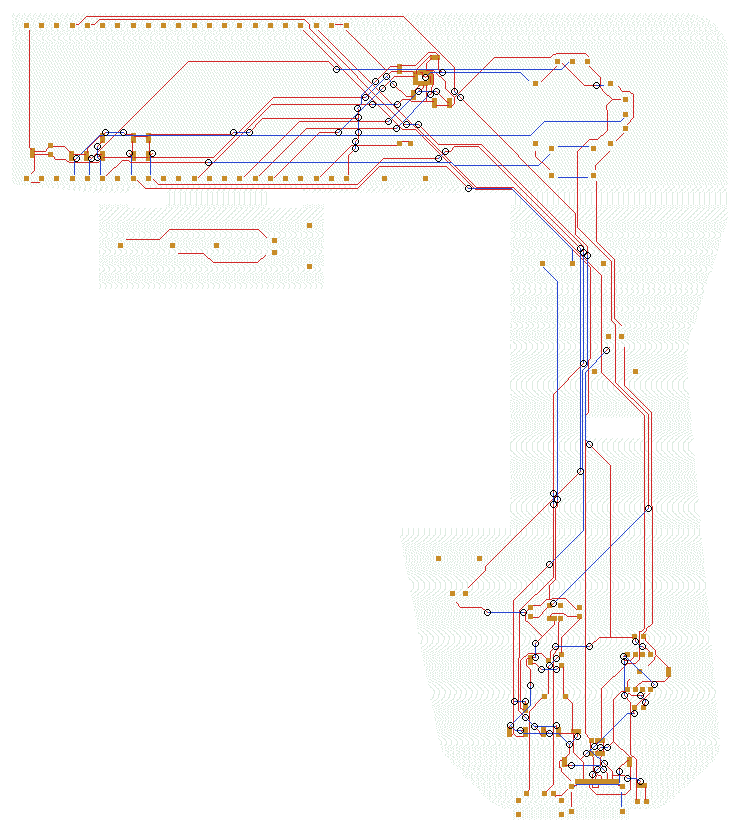
deliverables/pcb-shell-v1/预览图/07-布线检查（元件面视角，红顶层蓝底层）.png
