guiwushengzhe-prog/gun-mouse/deliverables/经济型工厂代焊版/GY模块适配说明/GY模块压框与左壳.png

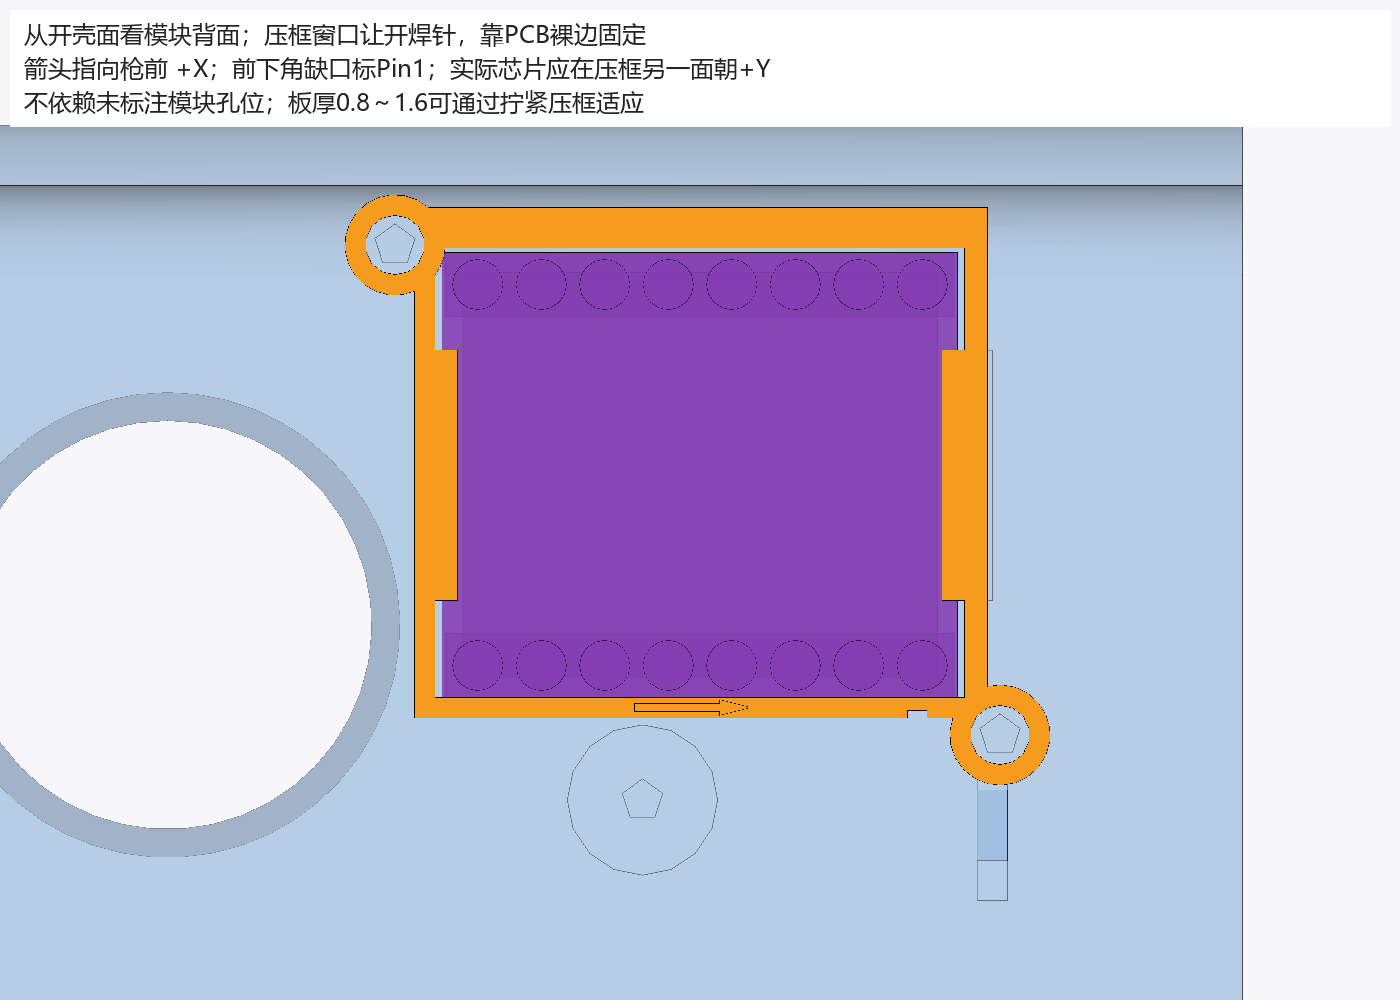
deliverables/经济型工厂代焊版/GY模块适配说明/GY模块压框与左壳.png
