guiwushengzhe-prog/gun-mouse/deliverables/经济型工厂代焊版/GY模块适配说明/GY模块朝向与接线.png

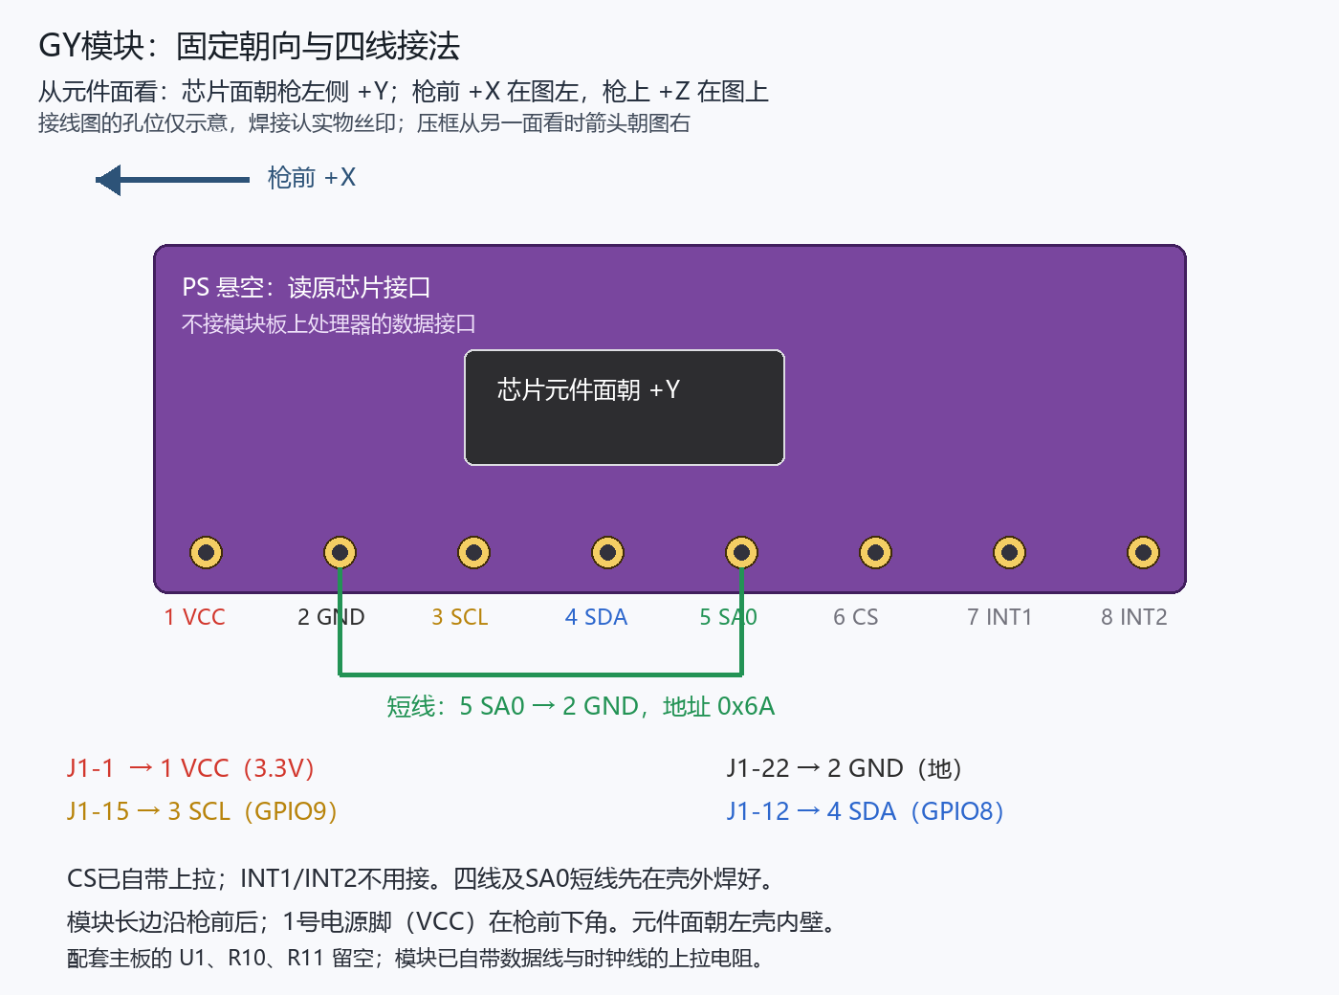
deliverables/经济型工厂代焊版/GY模块适配说明/GY模块朝向与接线.png
