guiwushengzhe-prog/gun-mouse/experiments/30g-onepiece-test-shell/research/supermini/esphome-pinouts.webp

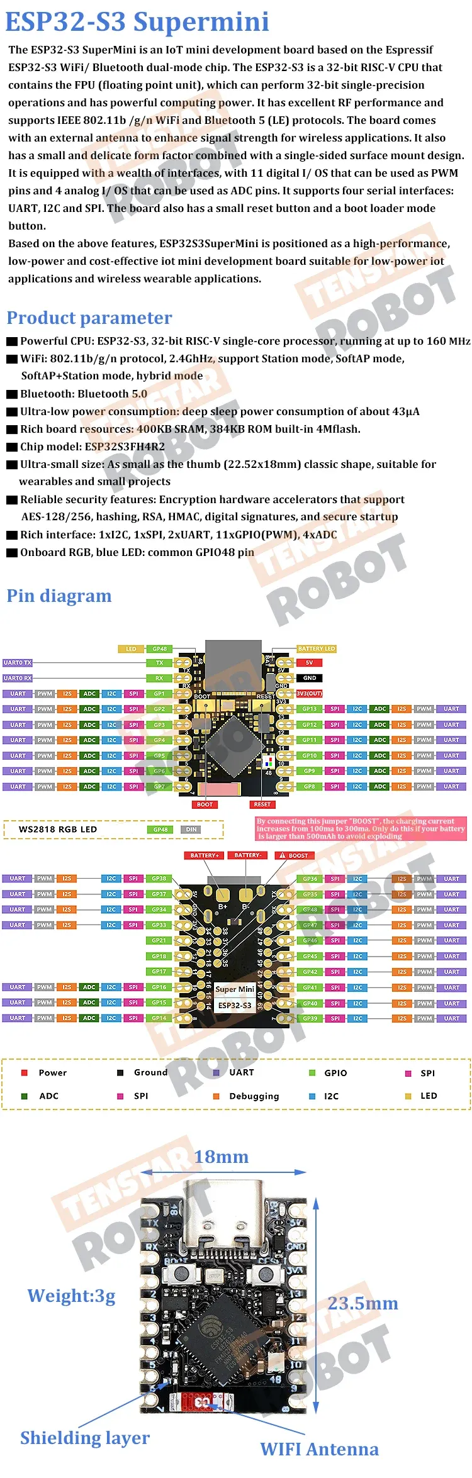
experiments/30g-onepiece-test-shell/research/supermini/esphome-pinouts.webp
