guiwushengzhe-prog/gun-mouse/pcb/carrier-copper-preview.png

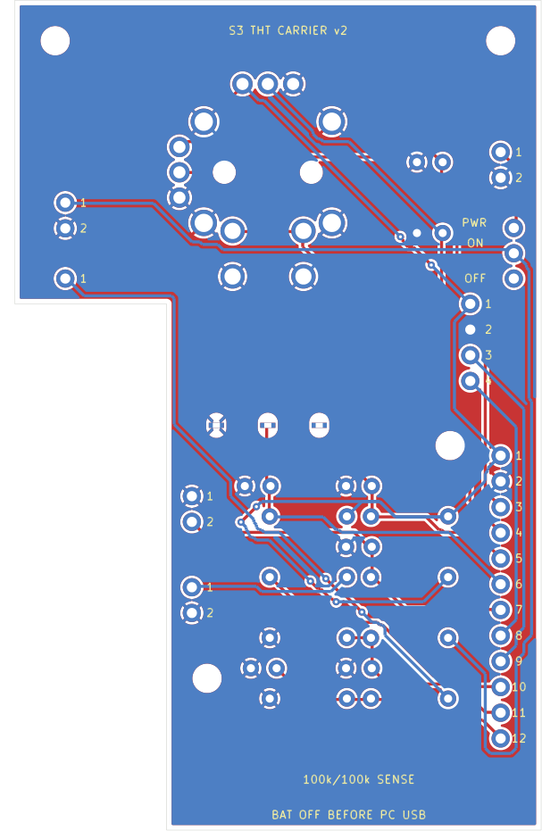
pcb/carrier-copper-preview.png
