guiwushengzhe-prog/gun-mouse/pcb/datasheets/GY-601N1/GY-601N1-电路图.png

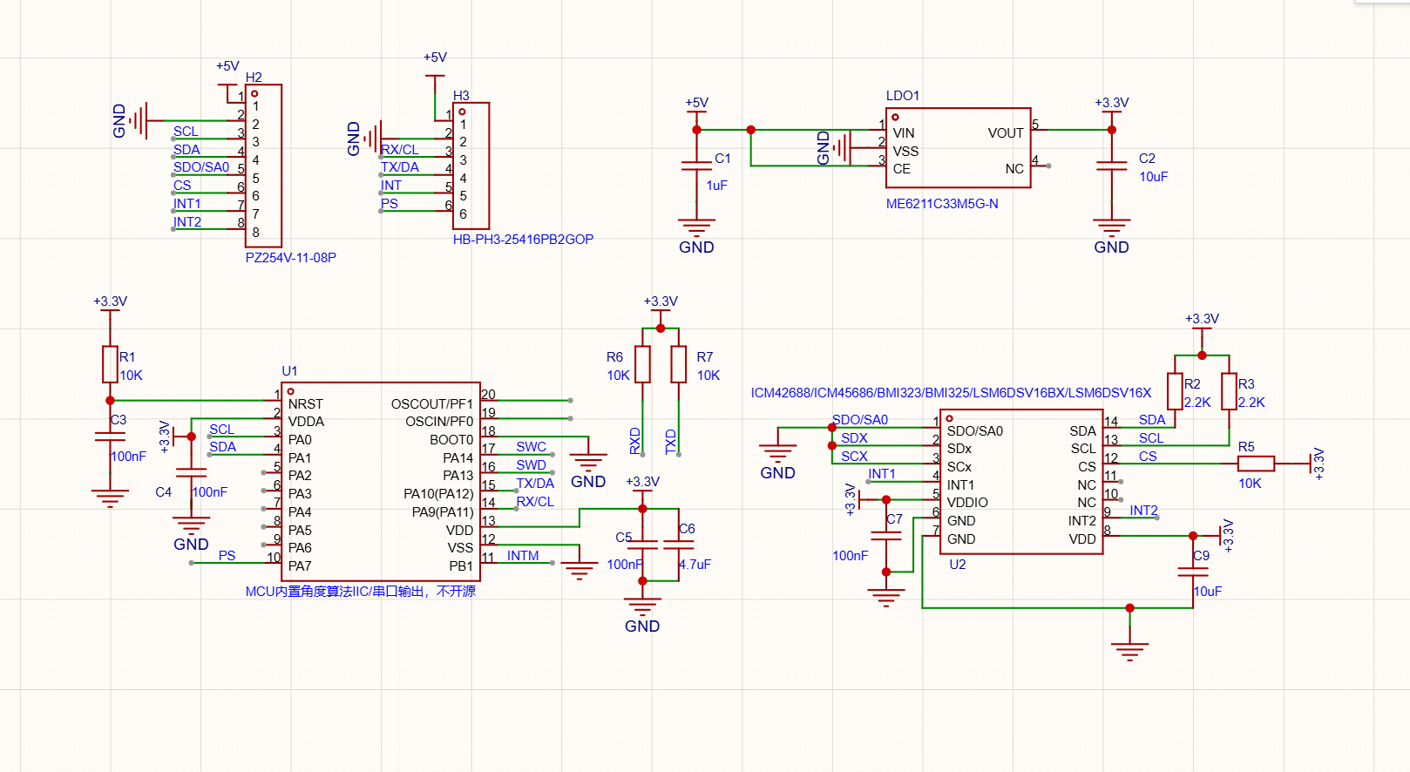
pcb/datasheets/GY-601N1/GY-601N1-电路图.png
