guiwushengzhe-prog/gun-mouse/pcb/supermini/nzn-angled.png

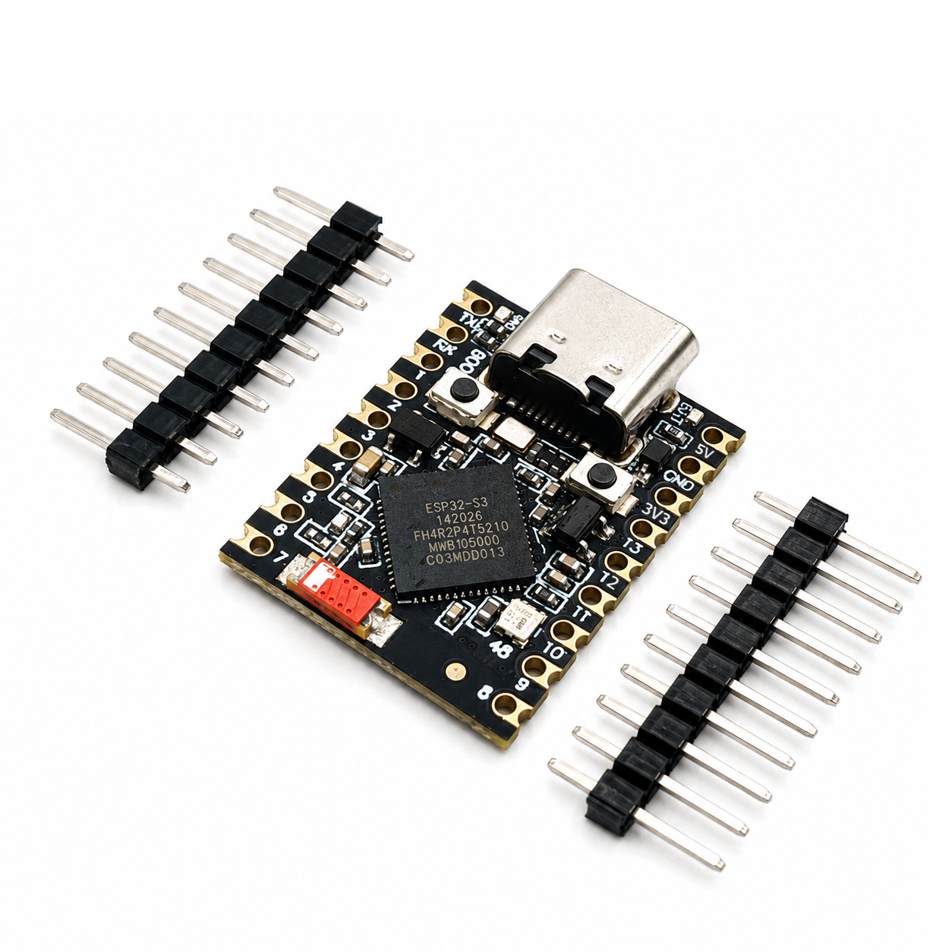
pcb/supermini/nzn-angled.png
