guiwushengzhe-prog/gun-mouse/pcb/supermini/nzn-dimensions.png

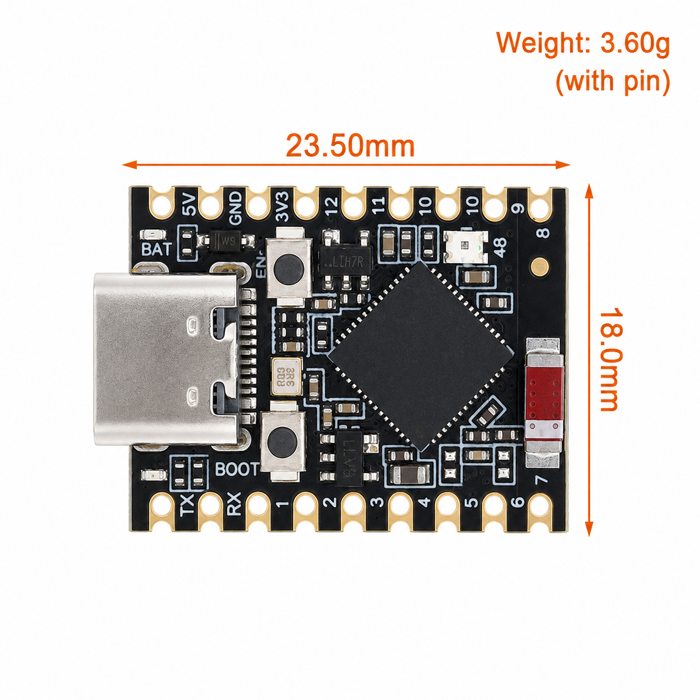
pcb/supermini/nzn-dimensions.png
