guiwushengzhe-prog/gun-mouse/release/2026-10-18-最终版/电路板/嘉立创主板预览.png

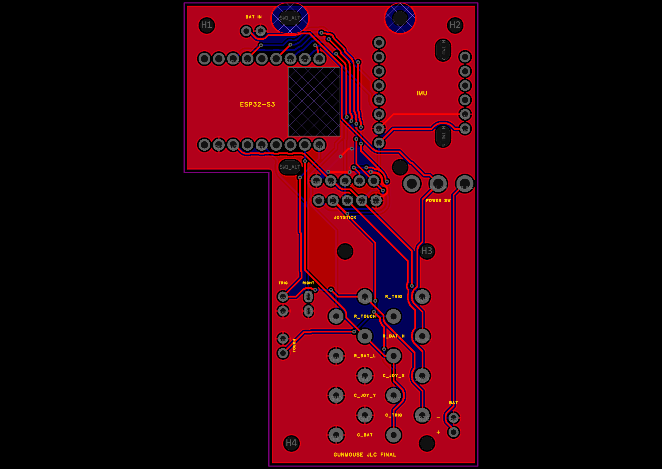
release/2026-10-18-最终版/电路板/嘉立创主板预览.png
