guiwushengzhe-prog/gun-mouse/shell/renders/exploded.png

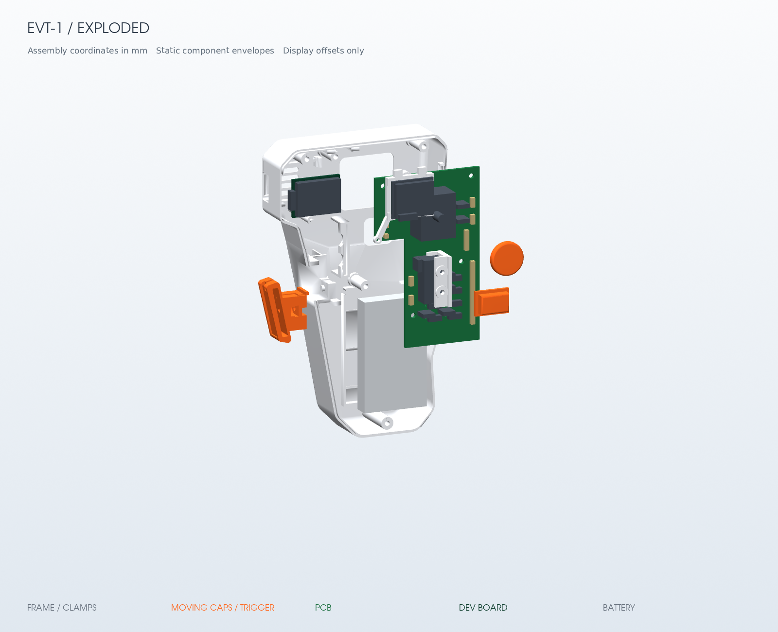
shell/renders/exploded.png
