guiwushengzhe-prog/gun-mouse/shell/renders/outside-left.png

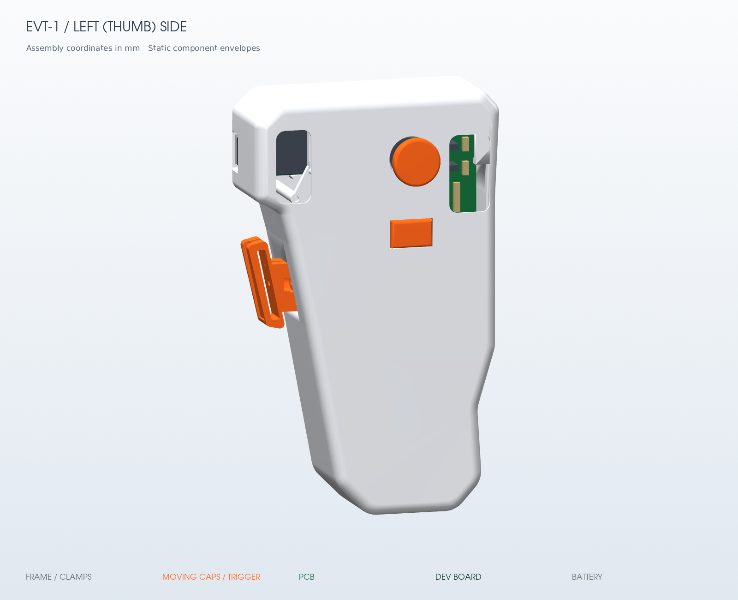
shell/renders/outside-left.png
