guiwushengzhe-prog/gun-mouse/shell/快速结构预览/renders/右键与独立支座.png

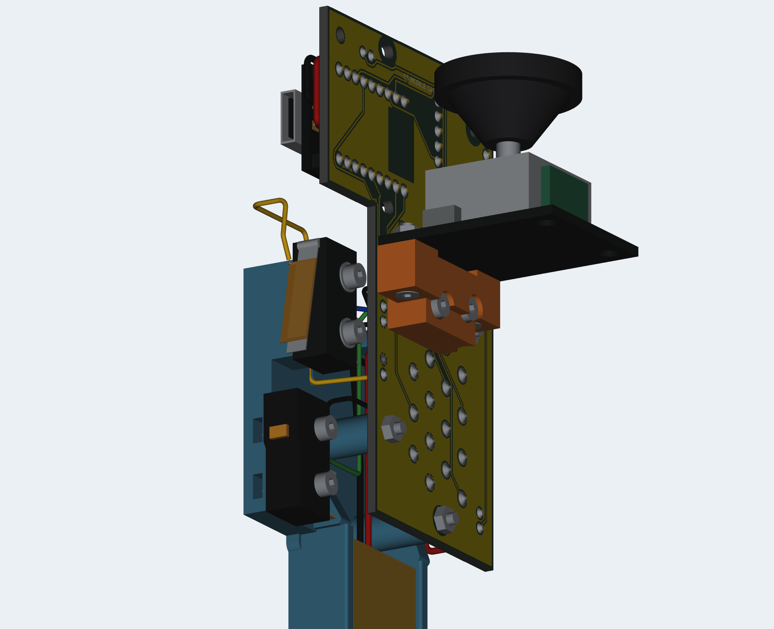
shell/快速结构预览/renders/右键与独立支座.png
