guiwushengzhe-prog/gun-mouse/shell/快速结构预览/renders/摇杆底座优化.png

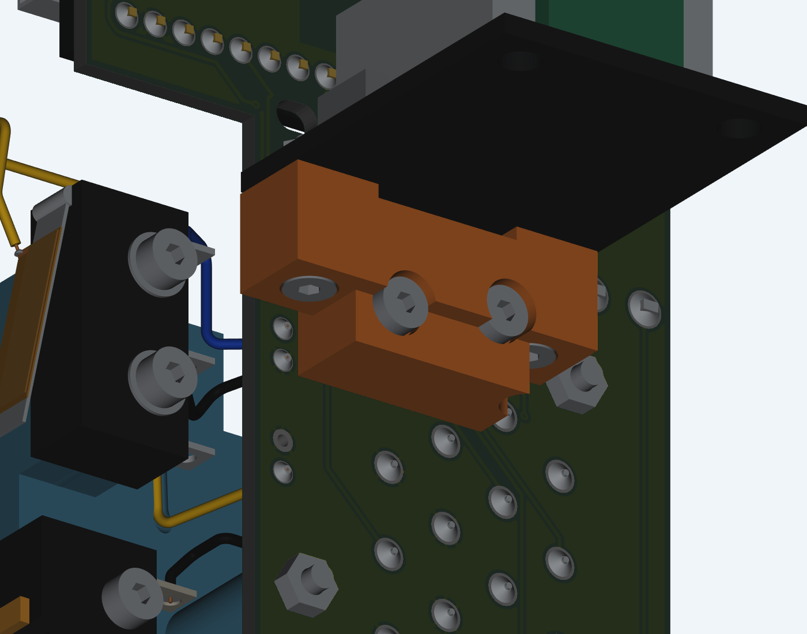
shell/快速结构预览/renders/摇杆底座优化.png
