guiwushengzhe-prog/gun-mouse/shell/快速结构预览/renders/框架整板改版.png

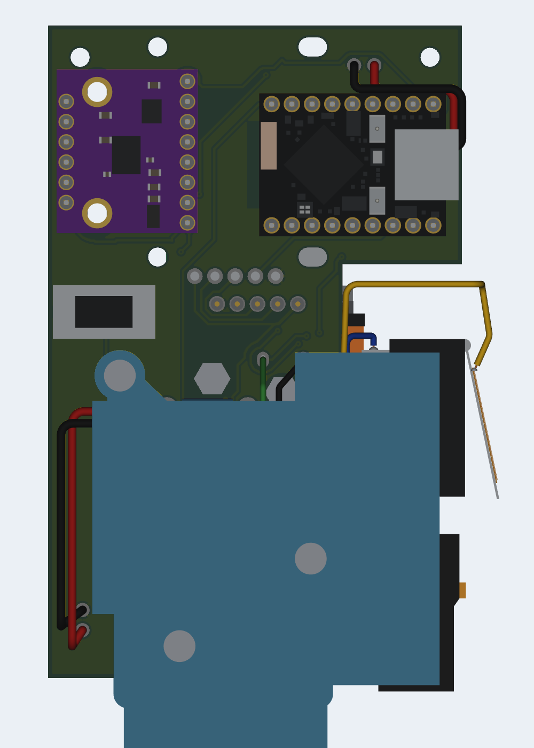
shell/快速结构预览/renders/框架整板改版.png
