guiwushengzhe-prog/gun-mouse/shell/长方条正式预览/多角度检视/07_壳体与主板_操作面.png

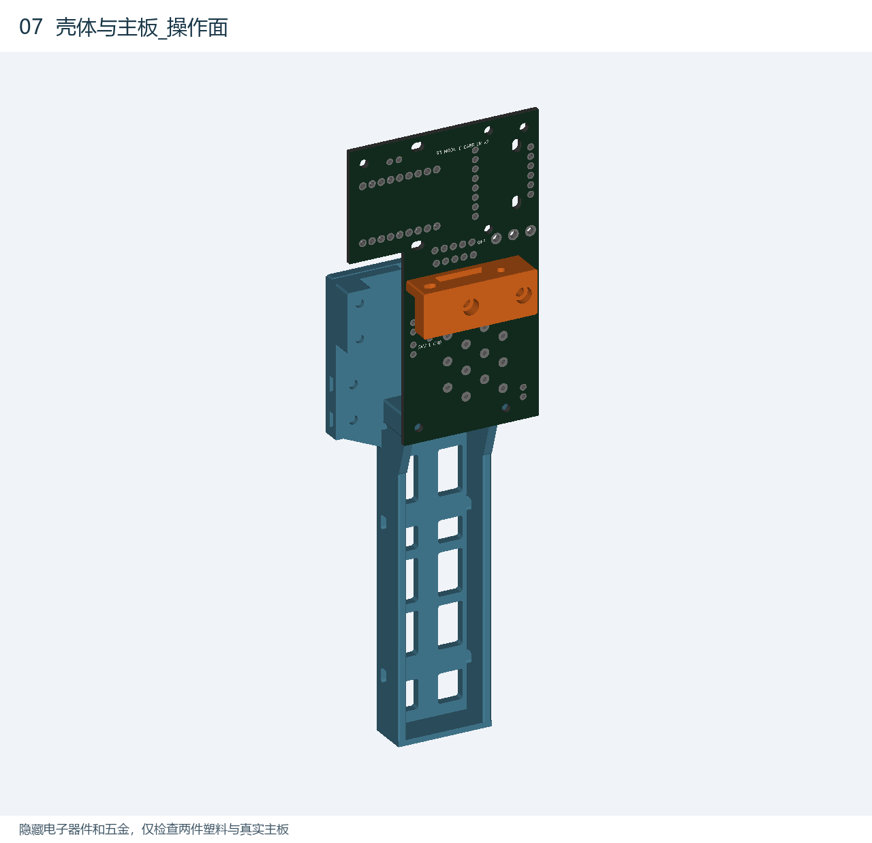
shell/长方条正式预览/多角度检视/07_壳体与主板_操作面.png
