guiwushengzhe-prog/gun-mouse/shell/长方条正式预览/多角度检视/08_壳体与主板_元件面.png

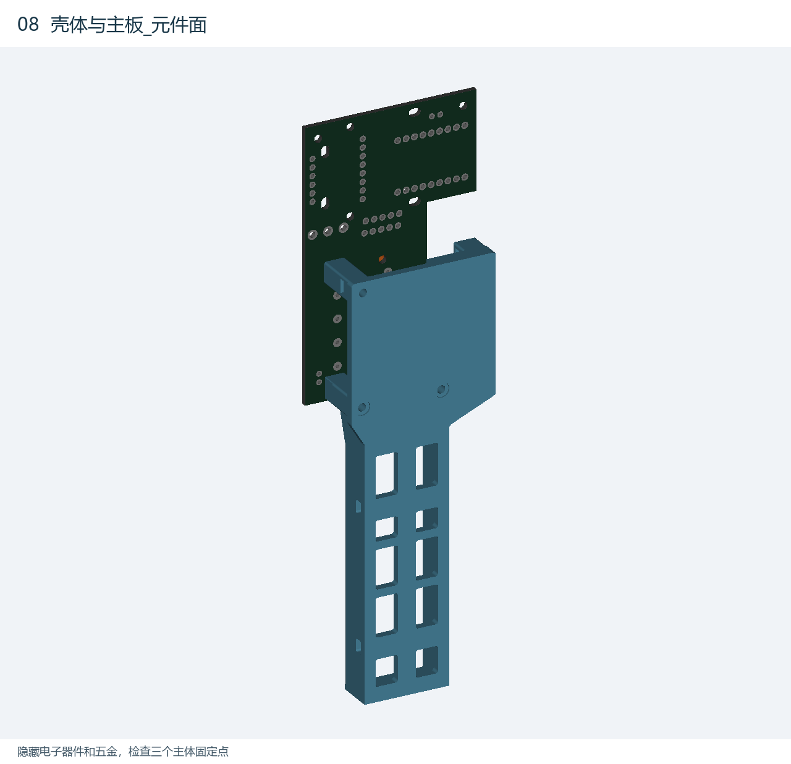
shell/长方条正式预览/多角度检视/08_壳体与主板_元件面.png
