guiwushengzhe-prog/gun-mouse/shell/长方条正式预览/多角度检视/12_主体底座_侧面.png

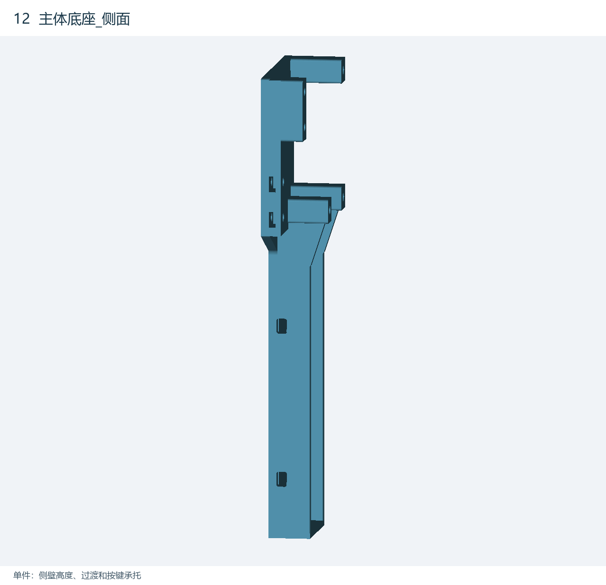
shell/长方条正式预览/多角度检视/12_主体底座_侧面.png
