guiwushengzhe-prog/gun-mouse/shell/长方条正式预览/多角度检视/13_主体底座_内侧正视.png

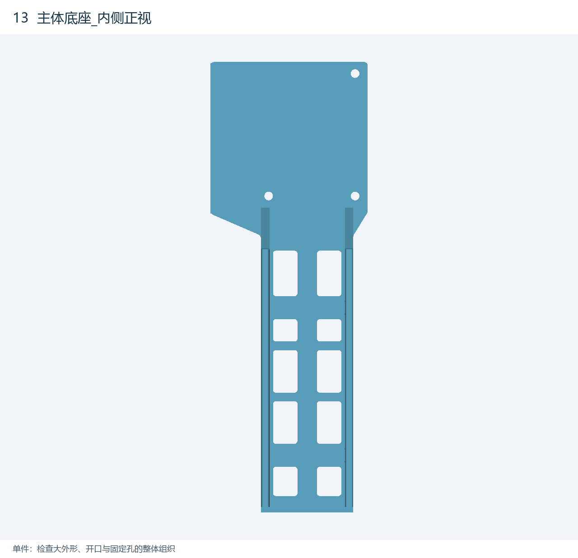
shell/长方条正式预览/多角度检视/13_主体底座_内侧正视.png
