guiwushengzhe-prog/gun-mouse/shell/长方条正式预览/多角度检视/14_摇杆支座_外侧.png

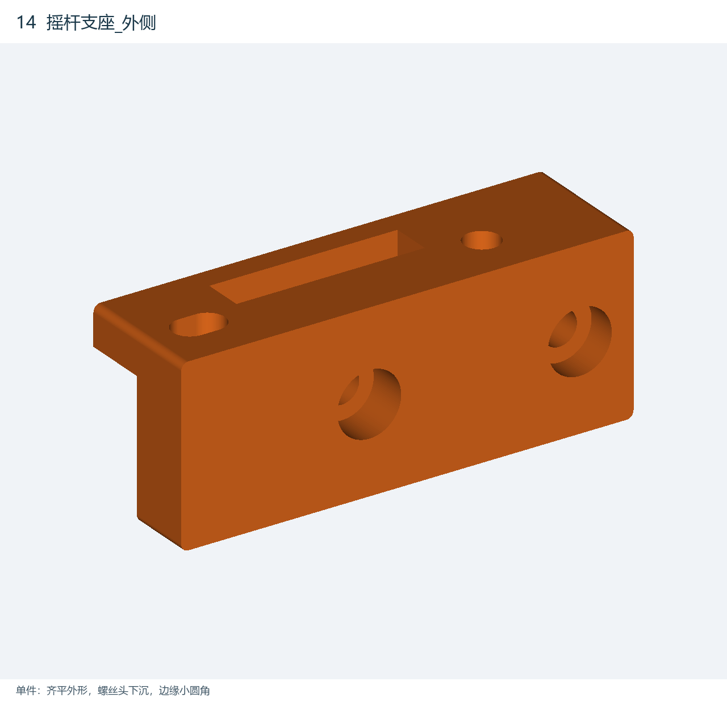
shell/长方条正式预览/多角度检视/14_摇杆支座_外侧.png
