guiwushengzhe-prog/gun-mouse/shell/长方条正式预览/多角度检视/15_摇杆支座_主板内侧.png

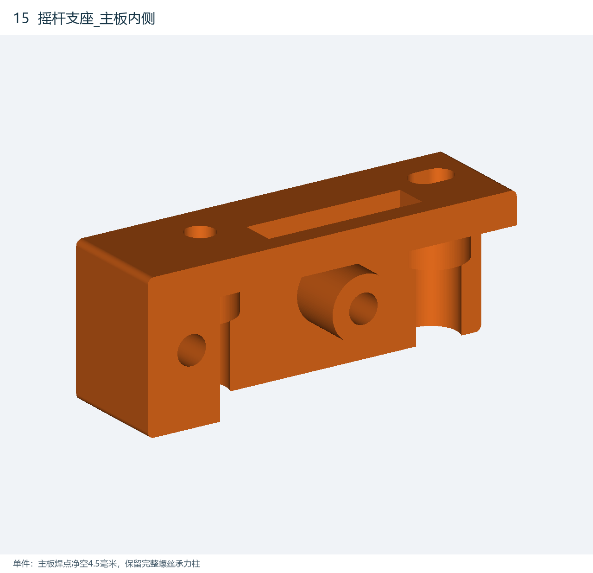
shell/长方条正式预览/多角度检视/15_摇杆支座_主板内侧.png
