guiwushengzhe-prog/gun-mouse/shell/长方条正式预览/多角度检视/16_摇杆支座_底面.png

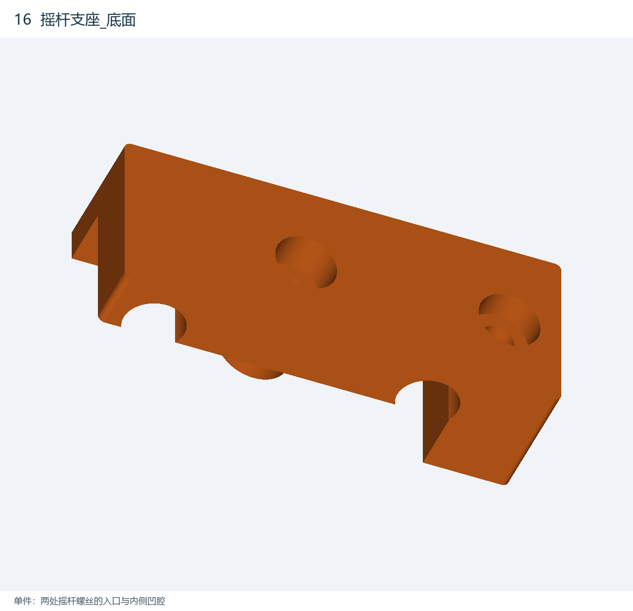
shell/长方条正式预览/多角度检视/16_摇杆支座_底面.png
