guiwushengzhe-prog/gun-mouse/shell/长方条正式预览/多角度检视/17_摇杆支座_端面.png

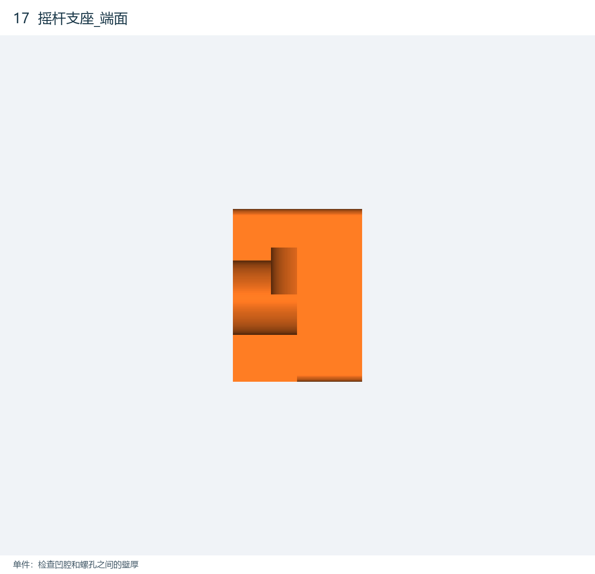
shell/长方条正式预览/多角度检视/17_摇杆支座_端面.png
