guiwushengzhe-prog/gun-mouse/shell/长方条正式预览/多角度检视/18_支座与高焊点_透明检视.png

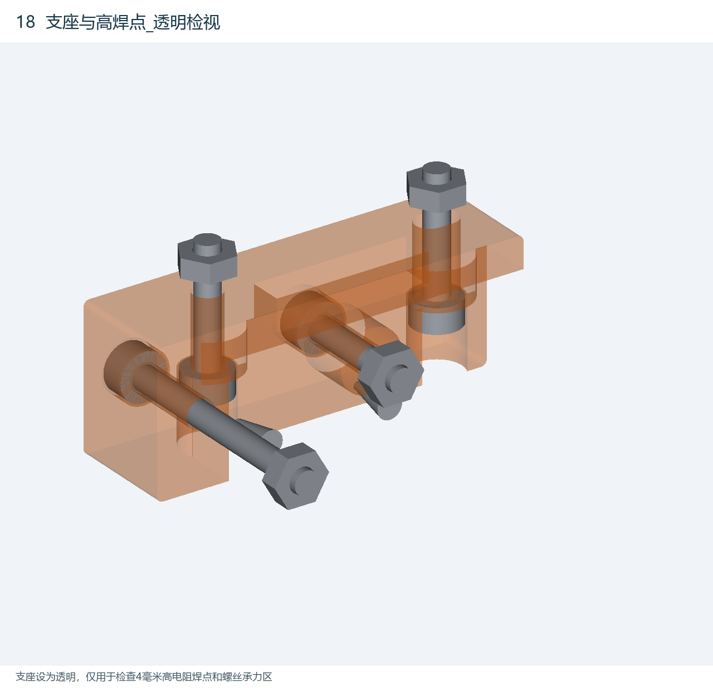
shell/长方条正式预览/多角度检视/18_支座与高焊点_透明检视.png
