guiwushengzhe-prog/gun-mouse/shell/长方条正式预览/多角度检视/19_主板与两壳件_分解图.png

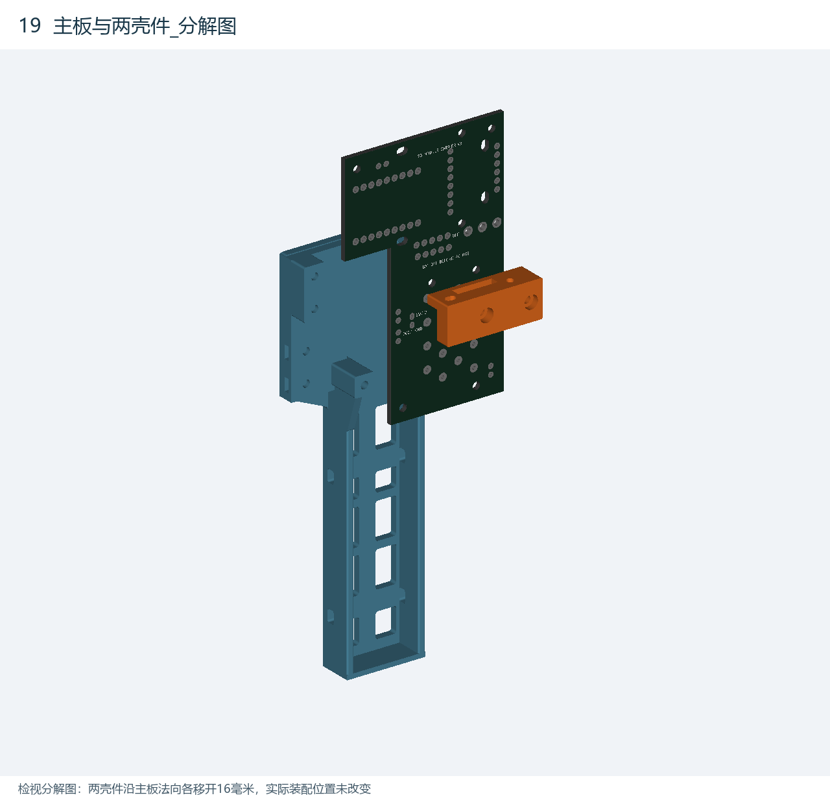
shell/长方条正式预览/多角度检视/19_主板与两壳件_分解图.png
