guiwushengzhe-prog/gun-mouse/shell/长方条正式预览/多角度检视/总览_主板与结构关系.png

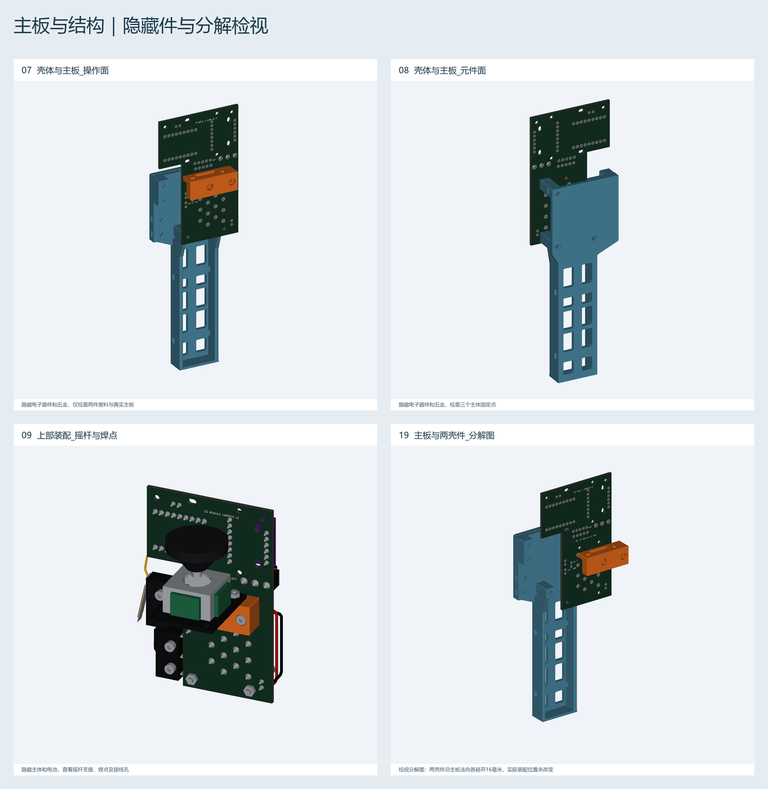
shell/长方条正式预览/多角度检视/总览_主板与结构关系.png
