guiwushengzhe-prog/gun-mouse/shell/长方条正式预览/多角度检视/总览_摇杆支座.png

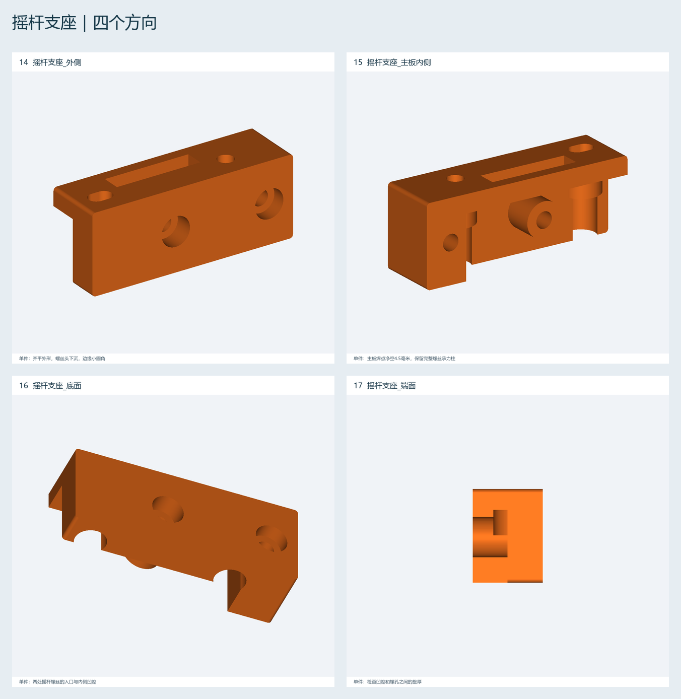
shell/长方条正式预览/多角度检视/总览_摇杆支座.png
