guiwushengzhe-prog/gun-mouse/shell/长方条正式预览/多角度检视/整体分区建议_未实施.png

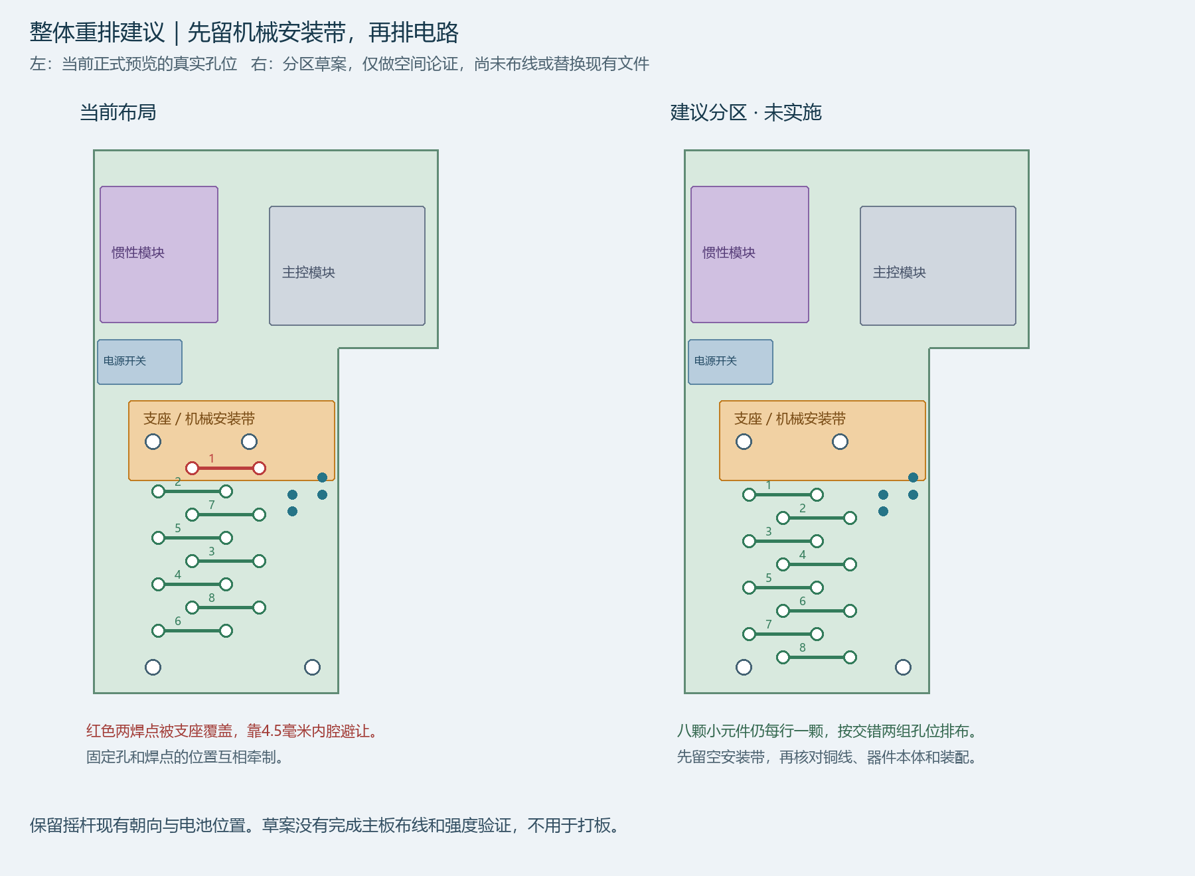
shell/长方条正式预览/多角度检视/整体分区建议_未实施.png
