guiwushengzhe-prog/gun-mouse/器件资料/原始资料/HW-504双轴摇杆模块_DZYJ尺寸图.jpg

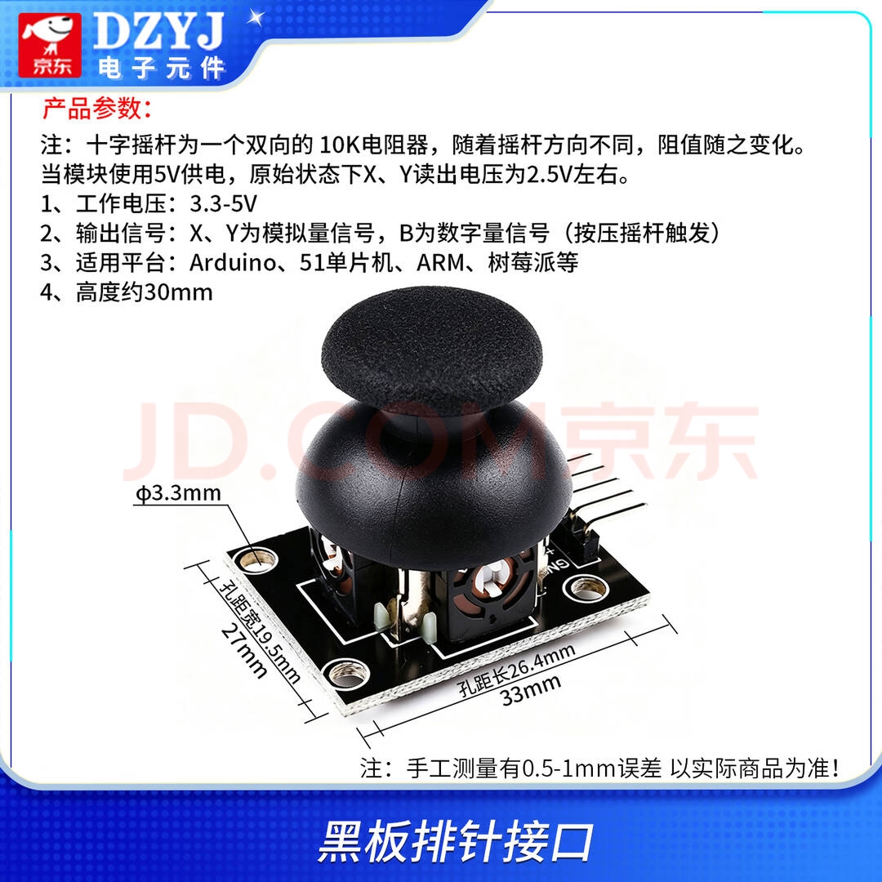
器件资料/原始资料/HW-504双轴摇杆模块_DZYJ尺寸图.jpg
