guiwushengzhe-prog/gun-mouse/docs/器件参数与待实测清单.md

# 器件参数与待实测清单

核查日期：2026-10-05。尺寸单位：毫米。尺寸证据分为：本人实测、对应完整型号的原厂资料、其他厂家同类型参考、未知。本轮没有新增实物测量。

当前原型已按用户要求省去 TTP223，采用 ESP32-S3 内置电容触摸连接铜箔。下文保留库存及历史候选参数，不代表全部装入；当前安装对象以配置中的 `included_in_current_prototype` 为准。内部图使用资料名义尺寸和明确标注的规划空间，不能当作实物尺寸测量。

芯片尺寸、无线模组尺寸、商家整板尺寸分别记录，不能互相代替。用户随后提供两个资料包，现已取得 ESP32-S3 开发板平面尺寸图与 GY-601N1 模块标称尺寸。相关实物版本、含排针和插头的三维占用仍未测量；没有给出的安装孔继续留空。DZYJ 黑板摇杆仍缺本型号尺寸图。

## 普通 PS2 摇杆

本版对象为订单中的“DZYJ 双轴按键摇杆传感器 PS2／黑板排针接口”，不是另一笔 PS4/PS5 订单。该类模块有两路模拟位置输出及按压开关，原型优先在 3.3V 电平体系内核对使用。

[Joy-IT 厂家同类产品](https://www.joy-it.net/en/products/COM-KY023JM)公布其 KY-023 为 34×39×26 毫米；这是它自己的产品，不是 DZYJ 机械证据。其页面供电与输出范围的文字不完全一致，应结合[厂家手册](https://www.joy-it.net/files/files/Produkte/COM-KY023JM/COM-KY023JM_Manual_2024-05-07.pdf)和实物核对。不能将另一厂家尺寸、孔位、电阻值或引脚顺序作为用户板件的已确认参数。

待测：板长宽厚、排针及插头后的总高、两轴中心与板边关系、摇杆帽外形、最大摆动空间、孔径与孔中心、五针丝印及顺序、中心输出与实际电阻值。效果图的安装座只表示可更换结构。

## GY-601N1-LSM6DSV16X

[ST 原厂芯片手册](https://www.st.com/resource/en/datasheet/lsm6dsv16x.pdf)确认六轴惯性传感器、芯片供电 1.71～3.6V、输入输出供电 1.08～3.6V、芯片封装 2.5×3.0×0.83 毫米。该尺寸不是广运模块板外形，供电范围也不能证明商家模块带有可接 5V 的稳压电路。

**用户资料新增证据：**`器件资料/参考图纸/GY-601N1/GY-601N1-模块说明书.pdf` 第1页，版本 V1.0、2025.03.01，列模块标称 **17.8×20.6×2.8 毫米**、整板供电 **3～5V**。这是模块资料，而不是芯片规格；该供电描述得到随包电路图中 3.3V 稳压器的支持。资料未明确 2.8 毫米是否包含全部焊锡及接插件，不把它当成焊好排针后的总高度。

第2页说明默认 PS 悬空为直接芯片读取模式，可使用两线串行总线或串行外围接口；将 PS 接电源或地分别选择板上单片机的串口或两线串行总线模式。第1页标称最快 200 次/秒更新属于板上角度输出描述，不能据此限制 LSM6DSV16X 芯片本身的采样频率。体感原型优先保留直接读取惯性芯片的路径，尚未编写固件。

待测：整板外形、厚度及含针总高、孔位、接线出口、实物轴向、稳压器及电平电路、实际引脚定义。主控与惯性传感器的方向变换以后按共同坐标明确记录。

## ESP32-S3-N16R8 与 nRF52840

此前优信整块焊排针开发板外形未知。[乐鑫无线模组原厂手册](https://www.espressif.com/sites/default/files/documentation/esp32-s3-wroom-1_wroom-1u_datasheet_en.pdf)中 N16R8 表示 16MB 闪存及 8MB 伪静态存储器，ESP32-S3-WROOM-1 模组为 18×25.5×3.1 毫米、模组供电 3.0～3.6V。这不是整块开发板尺寸；实物丝印仍需核对。[乐鑫芯片手册](https://www.espressif.com/sites/default/files/documentation/esp32-s3_datasheet_en.pdf)确认支持低功耗蓝牙，不支持传统蓝牙。

**用户资料新增证据：**`器件资料/参考图纸/ESP32-S3/ESP32-S3-公制尺寸图.pdf` 第1页给出该 YD 开发板主板 **57.15×27.94 毫米**、含天线伸出的整体平面长 **63.39 毫米**，两排针中心距 **25.40 毫米**、每排 **22针**、首末中心距 **53.34 毫米**。相邻针中心距由 53.34÷21 推得 **2.54 毫米**；英制图换算一致。天线伸出约 6.24 毫米，不能将其全作主板矩形。尺寸图没有板厚、器件高、针高、孔径或独立螺丝孔尺寸。

尺寸图未写板修订号，文件日期为 2022-03-04；电路图标题为 YD-ESP32-S3-COREBOARD V1.4、2022-09-23，局部器件已有变化。按提供资料的平面名义尺寸布局，但实物背面板号、模组丝印、每侧22针和双插口布局还需匹配，不把旧图所有元件坐标套到 V1.4。

V1.4 电路图中两个 Type-C 供电入口经二极管接板上 5V，再由稳压器生成 3.3V；一个接口直连主控，另一个经过 CH343P 串口转换器。图中没有锂电池充电电路，不能把开发板插口直接当作内置电池充电器。正式外壳还需给选用接口及插头留空间。

待测优信板：整板长宽、两排针中心距和针高、器件最高点、USB 口伸出、接线与插头占用、实际模块型号及天线端。整板供电口按其电路核对，不能只套用模组供电值。

[Nordic 原厂 nRF52840](https://www.nordicsemi.com/products/nrf52840)支持低功耗蓝牙，有 1MB 闪存和 256KB 内存；不同芯片封装与供电模式不能当作未知开发板的外形或接线条件。目前没有选定模块、开发板或封装，整板占位及孔位均为空。

## 微动：必须区分短柄与长柄

订单变体只有 SS-01GL，截图状态为打包中。正式候选 SS-01GL111 具有不同杠杆，不能据订单认定已购或已收到这个完整型号。

| 原厂规格 | SS-01GL，订单短柄标注 | SS-01GL111，长柄候选 |
| --- | --- | --- |
| 杠杆长度 | 14.5 | 22.6 |
| 最大动作力 | 0.49 牛顿 | 0.39 牛顿 |
| 最小复位力 | 0.06 牛顿 | 0.03 牛顿 |
| 自由位置最大值 | 13.6 | 16.8 |
| 动作位置 | 8.8±0.8 | 8.8±1.5 |
| 动作后行程最小值 | 1.2 | 1.2 |
| 动作与复位位差最大值 | 0.8 | 1.2 |

共同壳体最大 19.8×6.4×10.2；安装孔中心距 9.5±0.1；杠杆厚 0.3。这些不含完整杠杆、端子与导线占用，力和行程指原厂规定受力位置，不等于食指扳机参数。详见 [Omron 原厂 SS 手册第4～5页](https://omronfs.omron.com/en_US/ecb/products/pdf/en-ss.pdf)。

[具体型号页面](https://www.fa.omron.co.jp/product/item/SS-01GL111/)列额定直流 30V、0.1A，最小适用负载参考 5V、1mA；仅凭额定值不能保证 3.3V、微安级弱上拉的触点可靠性。电路设计时需核对低电流输入，而不是给本项目接 30V。机械限位遵循[原厂正确使用说明](https://www.ia.omron.com/product/cautions/28/precautions_for_correct_use.html)。

待测：到货完整丝印、杆长、外壳、端子方向、固定孔、实际按压力与回弹；正式支架孔位在型号和实物核对后确定。

## TTP223 与 AT42QT1011

现有 TTP223 为实验模块，板外形、完整后缀及配置尚未核对。[通泰 TTP223-BA6 原厂手册](https://www.tontek.com.tw/uploads/product/243/TTP223-BA6_V2.1_EN.pdf)给出 2.0～5.5V 供电，可设置直接跟随或翻转保持输出。本项目要跟随触摸，不采用每次触摸切换的保持模式；模块焊桥与芯片选项的关系须检查实物。

手册在 3V 条件下列快速模式 60 毫秒、低功耗模式 220 毫秒响应。它们不能当作实物 3.3V 下保证的抬指停止上限。释放后的约 12 秒指维持快速扫描模式，不是触摸输出保持 12 秒。电极大小、塑料厚度、引线电容与电源稳定性都影响结果；外接电极须检查模块传感端和布局，不能直接接输出脚代替电极。

AT42QT1011 仍是候选。[Microchip 原厂手册](https://ww1.microchip.com/downloads/en/DeviceDoc/40001947A.pdf)确认 1.8～5.5V、没有持续触摸超时。手册最大 100 毫秒响应带有 3V、4.7nF 采样电容、5pF 电极负载条件，未单列松手时间；快速模式典型 1.2 毫秒测量间隔不是完整检测延迟。

候选六脚封装本体标称 2.90×1.60、含引脚宽 2.80、高最大 1.45；八脚封装本体标称 2×2、高最大 0.60。这都是芯片，不是触摸板。每次测量前输出有 15 微秒高阻状态用于健康指示，输入处理需识别，不能将短脉冲直接当作触摸变化。

建议试验随扳机移动的铜箔电极、固定检测板、短柔性引线。这个结构是工程推论；[原厂触摸设计说明](https://ww1.microchip.com/downloads/en/AppNotes/an-kd02_103-touch_secrets.pdf)支持对电极、引线及周边导体影响进行评估，不能据此承诺一个通用最大线长。

待测：TTP223 板长宽总高、丝印与焊桥、外接电极方式；轻触和按压回弹全程的触摸状态；抬指到输出释放时间；邻近开关金属和线材对误触的影响；多种触摸面壁厚样件。铜箔只是感应电极，仍需触摸检测电路。

## 电池、电源与制造

用户给出的现有电池为 3.7V、700mAh，标称能量按两者相乘约 2.59Wh；这不确定实际容量、续航或长宽厚。待测实体含保护板和导线尺寸、插头、极性、保护状态与允许充电参数。电源模块完整型号及整板尺寸未知，待核对充电、升压、保护、边充边用能力及静态耗电。

当前普通壳壁厚 2～2.4 是探索初值，触摸面厚度、公差、打印材质和工艺未冻结。获取对应商家机械图或实测后才能建立真实板件占位；安装孔、焊盘、螺丝柱和最终打印文件随后确定。

## 没有资料的器件：尺寸规范能用到哪里

| 对象 | 可采用的尺寸依据 | 不能据此确定的内容 |
| --- | --- | --- |
| SS-01GL 与长柄备选 | 完整型号对应的 Omron 原厂轮廓图，可作为各自候选件的名义尺寸 | 订单完整后缀、实际安装高度、端子接线余量与手指扳机行程 |
| 普通 PS2 五针模块 | 确定厂家型号后的整板图；针距必须有该板证据 | “PS2”或“五针”不定义通用板边、孔位、杆高和摆动空间 |
| TTP223 三针模块 | 芯片封装有原厂图；完整模块需自身板图 | 六脚芯片封装不能定义三针蓝色模块尺寸 |
| 700mAh 软包电池 | 具体电芯型号及完整电池包尺寸资料 | 同容量不能推算长宽厚；保护板、包覆、接头和导线也占空间 |
| Type-C 充电升压板 | 插头和插座界面有规范；完整板需对应厂家图 | 接口标准不能定义整板外形、元件高、插座在板上的位置 |

例如 [SparkFun 官方五针摇杆转接板](https://www.sparkfun.com/sparkfun-thumb-joystick-breakout.html)有自己的板尺寸和[板图](https://github.com/sparkfun/Thumb_Joystick_Breakout)，它与已购 DZYJ 不是同一件。[Type-C 官方连接器规范](https://www.usb.org/document-library/usb-type-cr-cable-and-connector-specification-release-25)也不提供任意充电升压板的尺寸。本版继续使用已有件，不为获得一张尺寸图而擅自换购其他型号。

有对应器件图就按图的名义尺寸做占位；没有通用整件标准的区域，采用独立安装座的设计方向并保留未知数据，不能伪装成按规范确定的最终尺寸。

## SS-01GL＋铜箔的低成本触摸扳机：前轮建议记录

这个方案可以用于原型：铜箔为感应电极，TTP223 为触摸检测器，SS-01GL 为机械左键。现有物料可复用，不需先购买 AT42QT1011。

铜箔接 TTP223 板上核实后的感测节点（原触摸电极或正确引出点），三针中的状态输出接主控数字输入；微动单独接另一输入。跟随触摸模式满足轻触、按压、松压仍触摸、离开的状态逻辑。模块具体焊桥和引出方式待检查，不能仅根据通用芯片引脚去假定模块走线。

直接贴金属柄时建议隔绝缘层、贴牢电极边缘，并以短细软线留活动余量；这是工程建议，避免把周边金属结构一起当电极或让线材影响回弹。更适合长期握持的建议是小打印帽内贴电极，帽压微动，同时由外壳硬限位限制过行程。铜箔安装方式目前待用户选择。

原厂对电极、引线电容、覆层及机械过行程的依据分别见上方 TTP223 手册和 Omron 正确使用说明。实际需验证轻触能开启、按压回弹全程不丢触摸、离开后及时停止；目前没有实物验收结果。

另一个零件更少的路线是使用 [ESP32-S3 内置电容触摸](https://docs.espressif.com/projects/esp-idf/zh_CN/stable/esp32s3/api-reference/peripherals/cap_touch_sens.html)：铜箔接专用触摸通道，经相应配置、基线和阈值处理检测接触，不需要外接 TTP223。它不是普通数字按钮读取，尚未配置、选针或实测；是否适合移动电极要比较误触、稳定性和抬指延时。该路线依赖 S3 的触摸硬件，不能默认套到尚未确定的 nRF52840 主控。

原型先保留 TTP223 与 S3 内置触摸两条路线，复用已有材料；前者接线和状态读取直观，后者可省去一个检测模块。没有实测前不宣称内置方案一定更快或更稳定，也不为此立即采购新检测芯片。

## 当前内部原型：S3 内置触摸

用户已选定省去 TTP223。本轮原型主控为已有 ESP32-S3，铜箔直接接其专用电容触摸通道，微动为独立数字输入。触摸引脚、基线、阈值和按压误触尚未配置或验证；没有把普通数字读取作为触摸检测。

内部布局中，主控在上壳纵向、天线朝前；普通 PS2 摇杆在左侧独立安装座部分内嵌；惯性模块在手掌上方独立固定；SS-01GL 在扳机后；电池在握把中下，电源在底部。该布局是工程建议，不是已验收的装配。

摇杆参考区沿用 Joy-IT 同类模块34×39×26毫米，电池参考区采用 [DNK LP652545 同容量电池包](https://www.dnkpower.com/wp-content/uploads/2023/11/DNK652545-3.7V-700mAh-Lipo-Battery-Specification.pdf)的47×25×6.5毫米。两者均不是已购实物，也不是通用标准，不据此生成固定孔。电源、右键、扳机帽形状和主控接线高度属于设计预留，其数据不覆盖真实尺寸清单。

摇杆部分嵌入且向左外凸，图中参考区域跨越40毫米壳体厚度；整体厚度必须同时计入外侧座、杆帽与摆动，真实总厚仍待核对。主控天线和触摸走线的布置参照[乐鑫硬件布局指南](https://docs.espressif.com/projects/esp-hardware-design-guidelines/zh_CN/latest/esp32s3/pcb-layout-design.html)，避免将电池、铜箔、其他板和线束挤入天线区域，触摸线与底部升压供电线分开。
