guiwushengzhe-prog/gun-mouse/deliverables/经济型审核候选/gun-mouse-economy-candidate-BOM.csv

No. | Quantity | Comment | Designator | Footprint | Value | Manufacturer Part | Manufacturer | Supplier Part | Supplier
1 | 5 | 10uF | C1,C2,C3,C4,C6 | C0603 | 10uF | CL10A106KP8NNNC | SAMSUNG(三星) | C19702 | LCSC
2 | 10 | 100nF | C5,C7,C8,C9,C10,C11,C12,C13,C14,C15 | C0402 | 100nF | CL05B104KO5NNNC | SAMSUNG(三星) | C1525 | LCSC
3 | 1 | B5819W SL | D1 | SOD-123_L2.7-W1.6-LS3.7-RD-1 |  | B5819W SL | CJ(江苏长电/长晶) | C8598 | LCSC
4 | 2 | XY-PM254-1-22P-Z-8.5 | J1,J2 | HDR-TH_22P-P2.54-V-F |  | XY-PM254-1-22P-Z-8.5 | XYECONN(辛译) | C53200741 | LCSC
5 | 3 | S2B-PH-SM4-TB(LF)(SN) | J3,J4,J5 | CONN-SMD_P2.00_S2B-PH-SM4-TB-LF-SN |  | S2B-PH-SM4-TB(LF)(SN) | JST | C295747 | LCSC
6 | 1 | KT-0603R | LED1 | LED-SMD_L1.6-W0.8-R-RD |  | KT-0603R | KENTO | C2286 | LCSC
7 | 1 | AO3401A | Q1 | SOT-23_L2.9-W1.3-P1.90-LS2.4-BR |  | AO3401A | AOS | C15127 | LCSC
8 | 2 | 5.1kΩ | R1,R2 | R0402 | 5.1kΩ | 0402WGF5101TCE | UNI-ROYAL(厚声) | C25905 | LCSC
9 | 1 | 3.3kΩ | R14 | R0402 | 3.3kΩ | 0402WGF3301TCE | UNI-ROYAL(厚声) | C25890 | LCSC
10 | 1 | 1kΩ | R4 | R0402 | 1kΩ | 0402WGF1001TCE | UNI-ROYAL(厚声) | C11702 | LCSC
11 | 2 | 100kΩ | R8,R9 | R0402 | 100kΩ | 0402WGF1003TCE | UNI-ROYAL(厚声) | C25741 | LCSC
12 | 2 | 1MΩ | R6,R7 | R0402 | 1MΩ | 0402WGF1004TCE | UNI-ROYAL(厚声) | C26083 | LCSC
13 | 3 | 10kΩ | R5,R12,R15 | R0402 | 10kΩ | 0402WGF1002TCE | UNI-ROYAL(厚声) | C25744 | LCSC
14 | 1 | 2.2kΩ | R13 | R0402 | 2.2kΩ | 0402WGF2201TCE | UNI-ROYAL(厚声) | C25879 | LCSC
15 | 1 | RKJXV1224005 | SW1 | SW-TH_RKJXV1224005 |  | RKJXV1224005 | ALPSALPINE(阿尔卑斯阿尔派) | C146170 | LCSC
16 | 1 | D2FC-F-7N(20M) | SW2 | SW-TH_3P-L12.8-W5.8-P5.08_DM3CQF1004L04 |  | D2FC-F-7N(20M) | OMRON(欧姆龙) | C5157566 | LCSC
17 | 1 | MSK12C02-HB | SW3 | SW-TH_MSK12C02-HB-1 |  | MSK12C02-HB | SHOU HAN(首韩) | C431541 | LCSC
18 | 1 | TP4056-42-ESOP8 | U2 | ESOP-8_L4.9-W3.9-P1.27-LS6.0-BL-EP |  | TP4056-42-ESOP8 | TOPPOWER(南京拓微) | C16581 | LCSC
19 | 1 | RT9080-33GJ5 | U3 | TSOT-23-5_L2.9-W1.6-P0.95-LS2.8-BL |  | RT9080-33GJ5 | RICHTEK(立锜) | C841192 | LCSC
20 | 1 | USBLC6-2SC6 | U4 | SOT-23-6_L2.9-W1.6-P0.95-LS2.8-BL |  | USBLC6-2SC6 | ST(意法半导体) | C7519 | LCSC
21 | 1 | TYPE-C-31-M-12 | USB1 | USB-C_SMD-TYPE-C-31-M-12_1 |  | TYPE-C-31-M-12 | 韩国韩荣 | C165948 | LCSC
22 | 1 | 6.8kΩ | R3 | R0402 | 6.8kΩ | 0402WGF6801TCE | UNI-ROYAL(厚声) | C25917 | LCSC
