guiwushengzhe-prog/gun-mouse/experiments/30g-onepiece-test-shell/generated/assembly-original.step

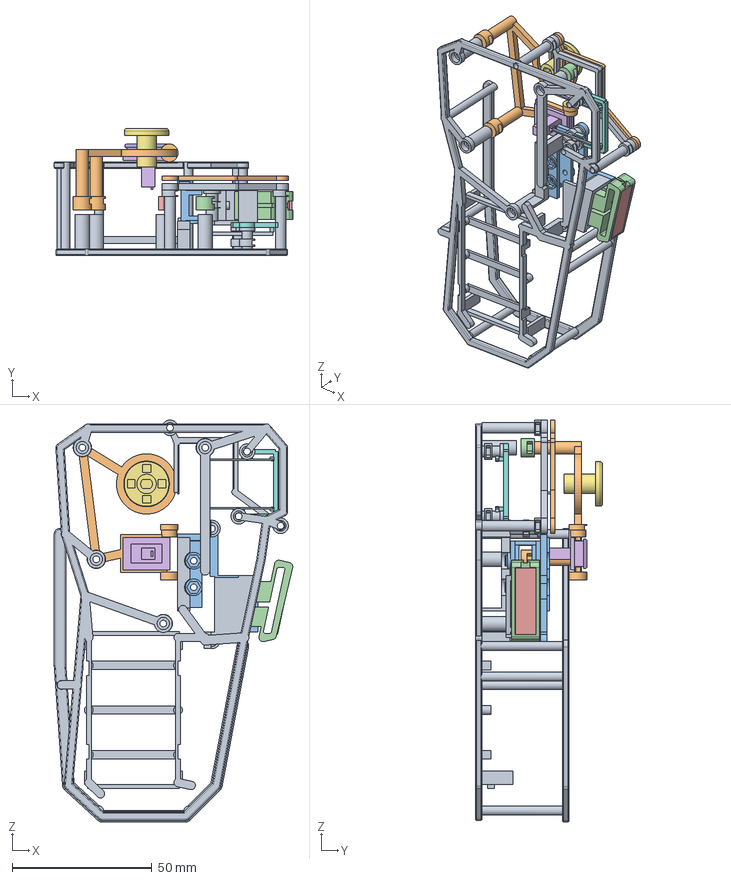
[picture p42: CAD file, 2026-10-07]
experiments/30g-onepiece-test-shell/generated/assembly-original.step
85.5 x 45.6 x 144.0 mm
