guiwushengzhe-prog/gun-mouse/concepts/v3/内部布局占位.step

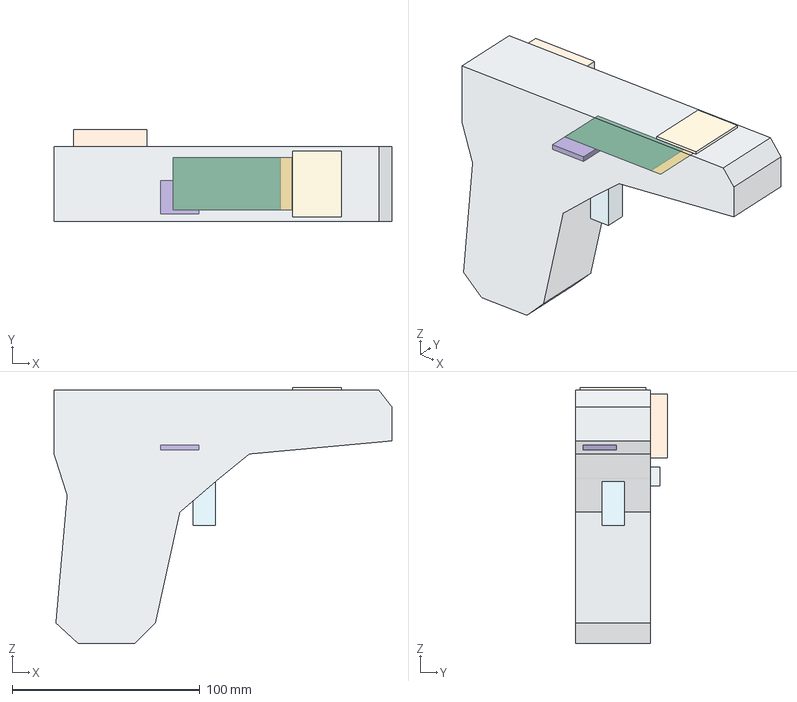
[picture p43: CAD file, 2026-10-05]
concepts/v3/内部布局占位.step
180.0 x 49.0 x 136.5 mm
00_å¤å£³è½®å»è§åä½
01_ä¸»æ§è§ååºï¼é«åº¦å¾ æµï¼
02_ ä¸»æ§ä¸»æ¿èµæå¹³é¢ï¼é¶ååº¦ ï¼
03_ å¤©çº¿ä¼¸åºèµæå¹³é¢ï¼é¶ååº¦ ï¼
04_ åç«¯å¤©çº¿å¨è¾¹çç©ºï¼ç¤ºæï¼
05_æ®é PS2 ææåèåºï¼å®ç©å¾ æ ¸å¯¹ï¼
06_æ¯æ§æ¨¡åç¬ç«åºå®åº
07_ æ¯æ§æ¨¡åèµææ ç§°ä½ï¼ä¸å« æéæ»é«ï¼
08_SS-01GL å¾®å¨å£³ä½åè
09_ å°æ³æºå¸½ä¸éç®ï¼ç»æç¤ºæ ï¼
10_ ç¬ç«å³é®æºæåºï¼å°ºå¯¸å¾ å® ï¼
11_700mAh çµæ± åèåºï¼å®ç©å¾ æ ¸å¯¹ï¼
12_ å çµä¸ä¾çµè§ååºï¼å°ºå¯¸å¾ å®ï¼
