guiwushengzhe-prog/gun-mouse/deliverables/design-precheck/局部打印候选/右半壳-摇杆支撑候选.step

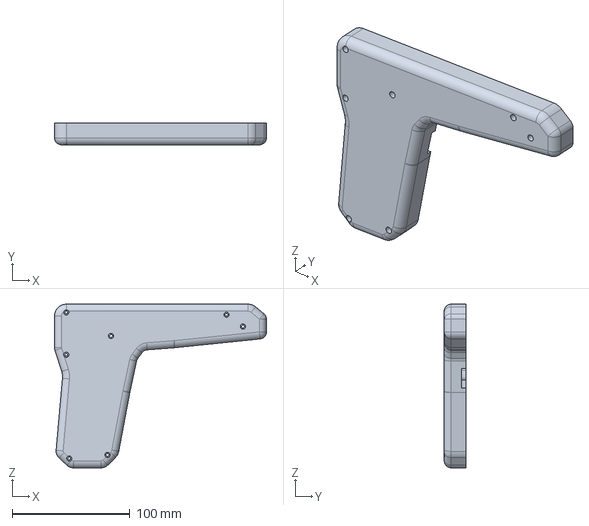
[picture p44: CAD file, 2026-10-05]
deliverables/design-precheck/局部打印候选/右半壳-摇杆支撑候选.step
180.0 x 18.4 x 139.0 mm
