guiwushengzhe-prog/gun-mouse/deliverables/evt-a/打印文件/扳机设定片-1.0mm.step

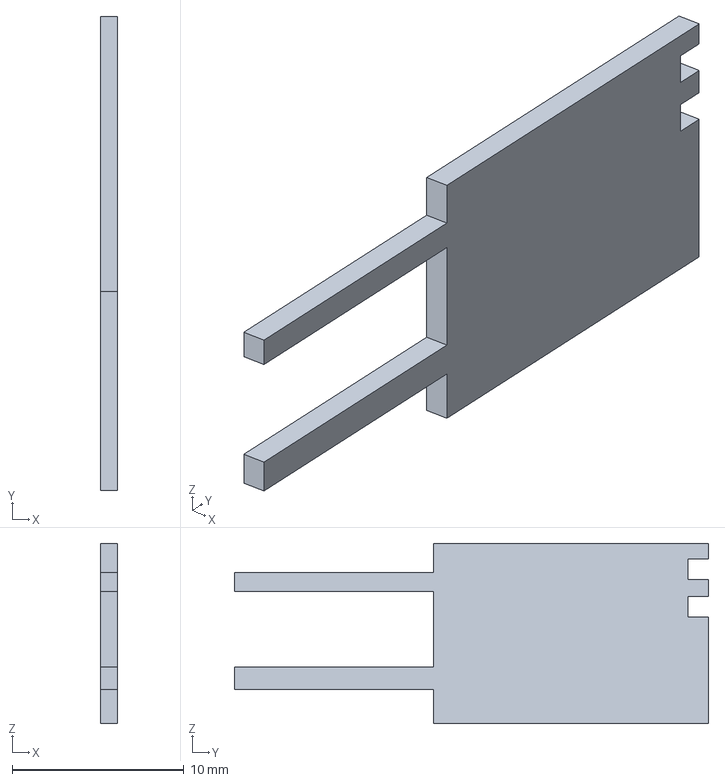
[picture p45: CAD file, 2026-10-06]
deliverables/evt-a/打印文件/扳机设定片-1.0mm.step
1 x 27.6 x 10.5 mm
