guiwushengzhe-prog/gun-mouse/deliverables/pcb-shell-v1/打印文件/STEP/右半壳.step

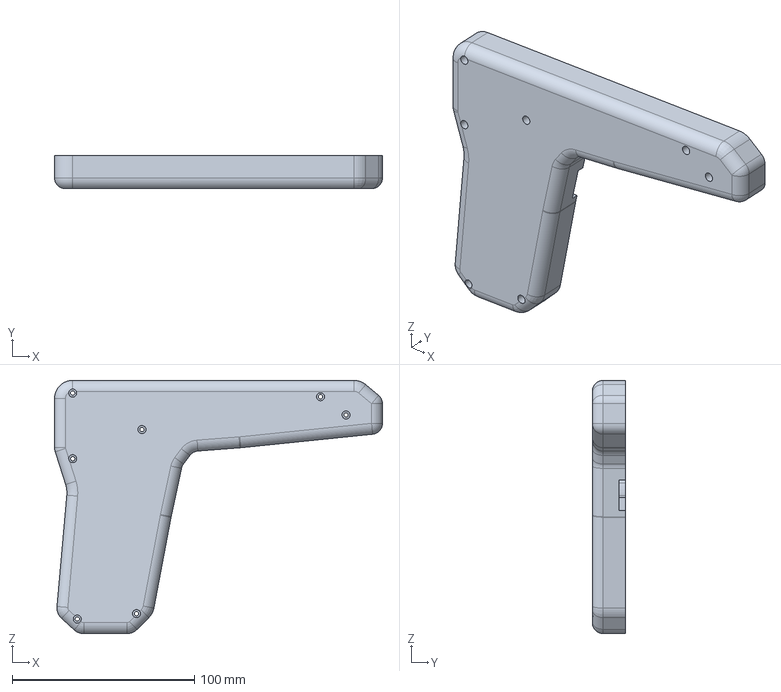
[picture p46: CAD file, 2026-10-05]
deliverables/pcb-shell-v1/打印文件/STEP/右半壳.step
180.0 x 18.4 x 139.0 mm
