guiwushengzhe-prog/gun-mouse/deliverables/经济型单板自焊版/打印文件/左半壳-单板自焊.step

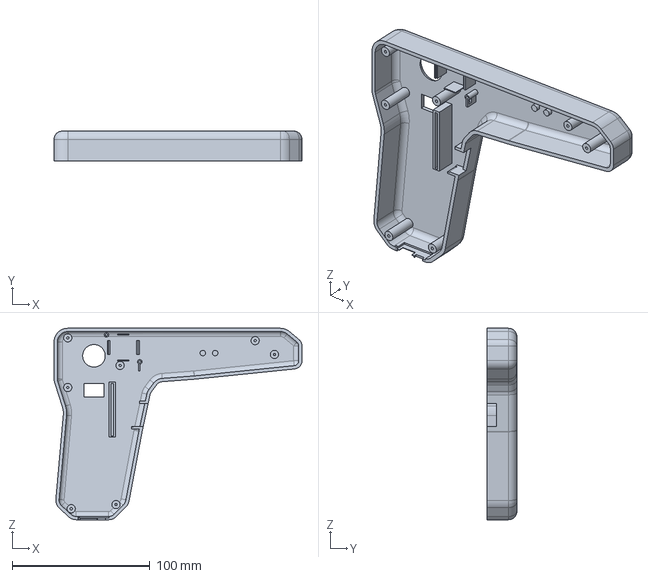
[picture p47: CAD file, 2026-10-06]
deliverables/经济型单板自焊版/打印文件/左半壳-单板自焊.step
180.0 x 21.6 x 139.0 mm
