guiwushengzhe-prog/gun-mouse/deliverables/经济型工厂代焊版/打印文件/扳机设定片-经济型-0.8mm.step

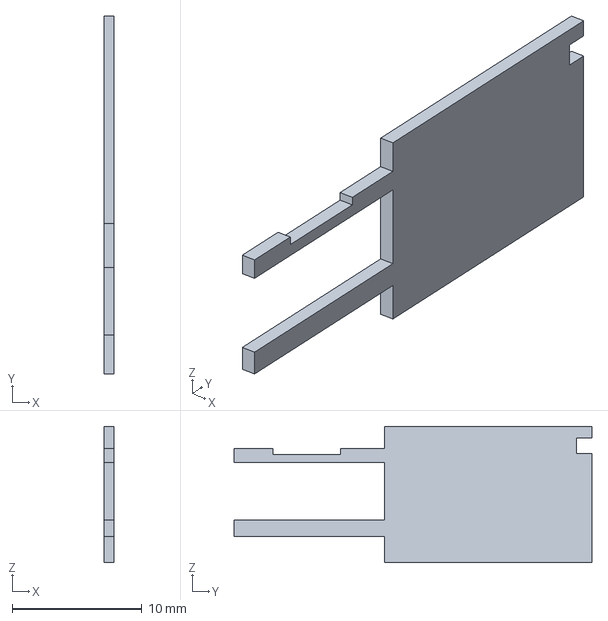
[picture p48: CAD file, 2026-10-06]
deliverables/经济型工厂代焊版/打印文件/扳机设定片-经济型-0.8mm.step
0.8 x 27.6 x 10.5 mm
