guiwushengzhe-prog/gun-mouse/experiments/30g-onepiece-test-shell/generated/trigger.step

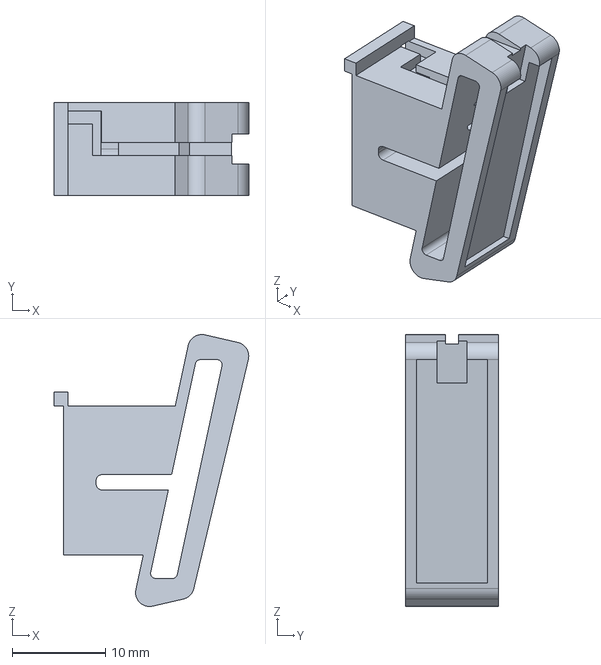
[picture p49: CAD file, 2026-10-07]
experiments/30g-onepiece-test-shell/generated/trigger.step
20.9 x 10.0 x 29.2 mm
