guiwushengzhe-prog/gun-mouse/experiments/30g-onepiece-test-shell/sources/packing-protection/gunmouse-control_bridge-bore-2-guard.step

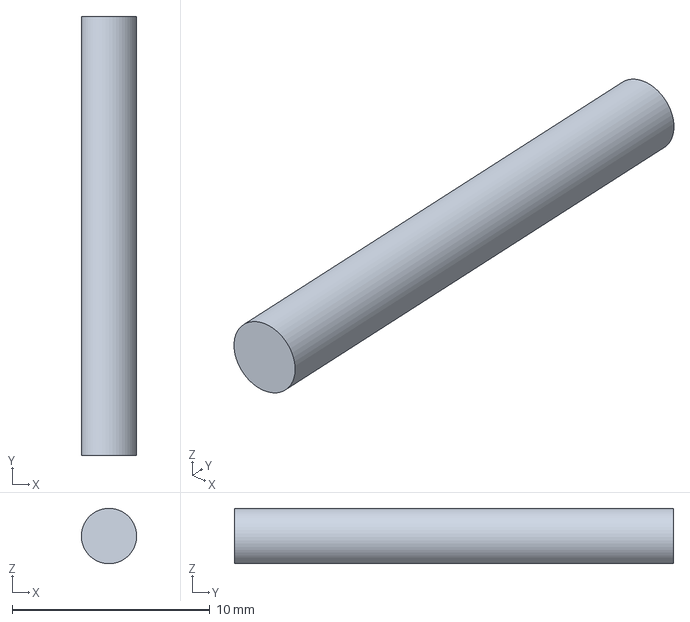
[picture p50: CAD file, 2026-10-07]
experiments/30g-onepiece-test-shell/sources/packing-protection/gunmouse-control_bridge-bore-2-guard.step
2.80 x 22.2 x 2.80 mm
