guiwushengzhe-prog/gun-mouse/experiments/evt1-light-shell/generated/joystick_cap.step

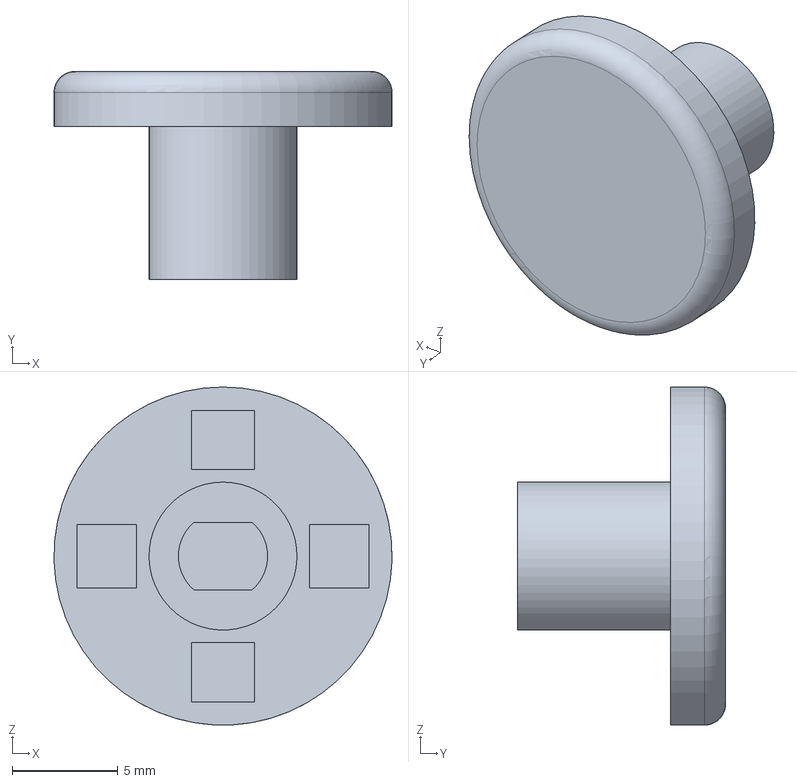
[picture p51: CAD file, 2026-10-07]
experiments/evt1-light-shell/generated/joystick_cap.step
16.0 x 9.85 x 16.0 mm
