guiwushengzhe-prog/gun-mouse/pcb/3d/gun-mouse-gen2.obj

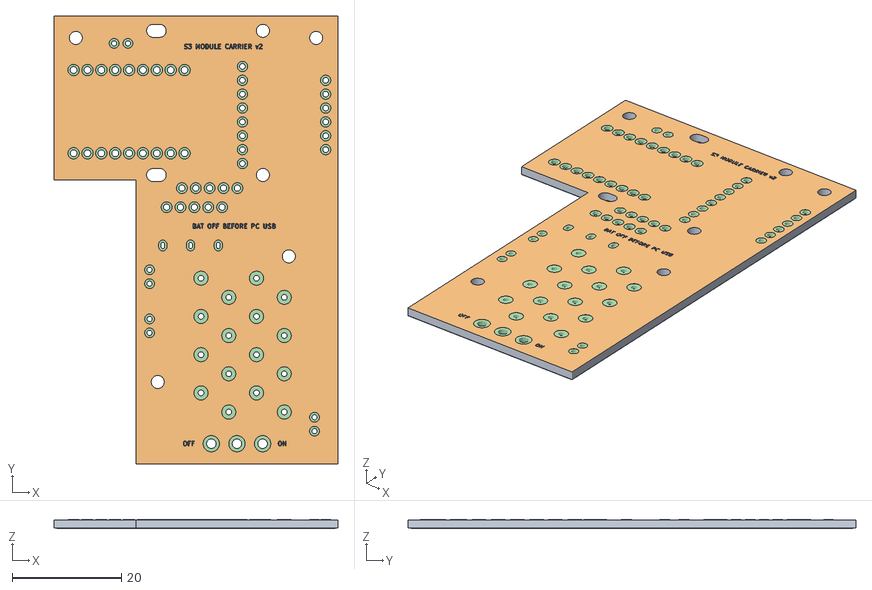
[picture p52: CAD file, 2026-10-17]
pcb/3d/gun-mouse-gen2.obj
52.0 x 82.0 x 1.63
grp1
grp8829
grp12721
grp14777
