guiwushengzhe-prog/gun-mouse/release/2026-10-18-最终版/三维打印/摇杆支座.step

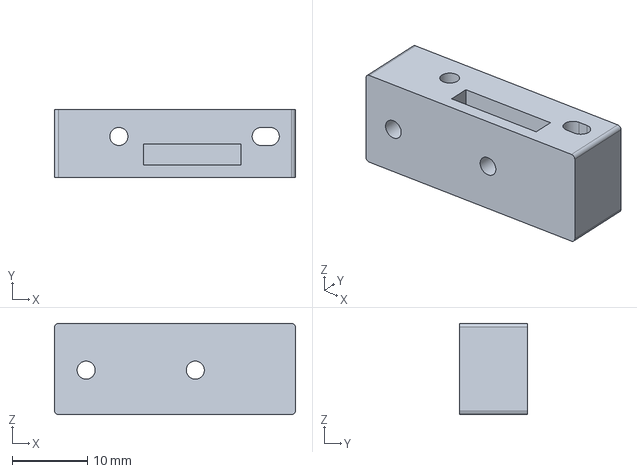
[picture p53: CAD file, 2026-10-18]
release/2026-10-18-最终版/三维打印/摇杆支座.step
32.0 x 9.07 x 12.1 mm
