guiwushengzhe-prog/gun-mouse/release/2026-10-18-结构简化版/三维打印/独立摇杆支座.stl

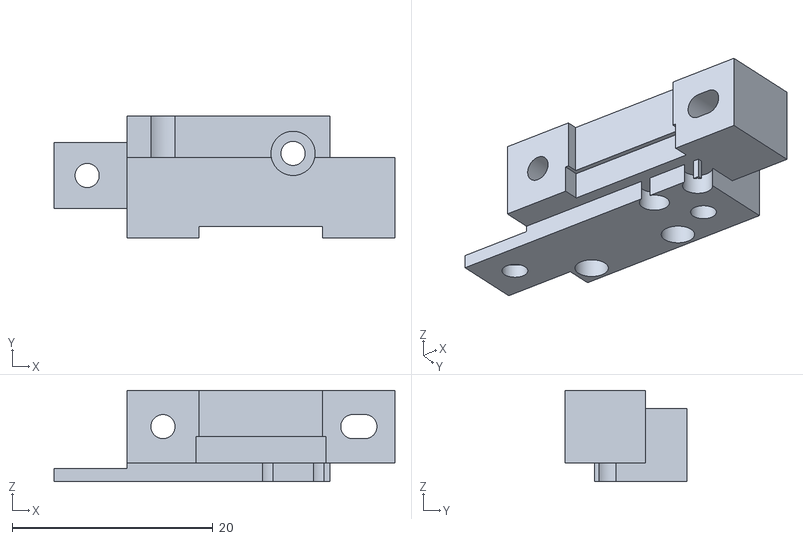
[picture p54: CAD file, 2026-10-18]
release/2026-10-18-结构简化版/三维打印/独立摇杆支座.stl
34.0 x 12.1 x 9.07
