guiwushengzhe-prog/gun-mouse/release/2026-10-18/三维打印/独立摇杆支座.stl

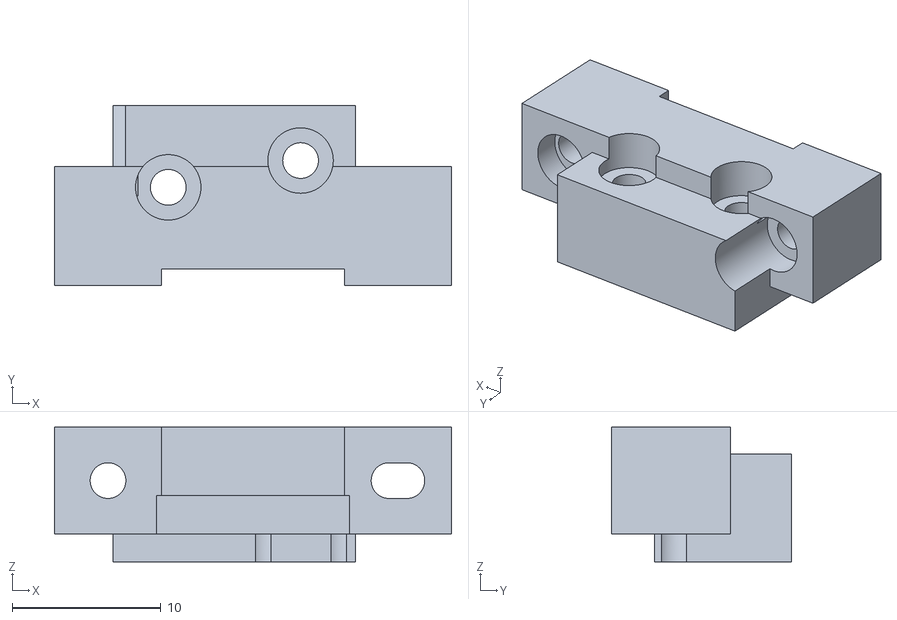
[picture p55: CAD file, 2026-10-18]
release/2026-10-18/三维打印/独立摇杆支座.stl
26.7 x 12.1 x 9.07
