guiwushengzhe-prog/gun-mouse/shell/step/engineering_mount.step

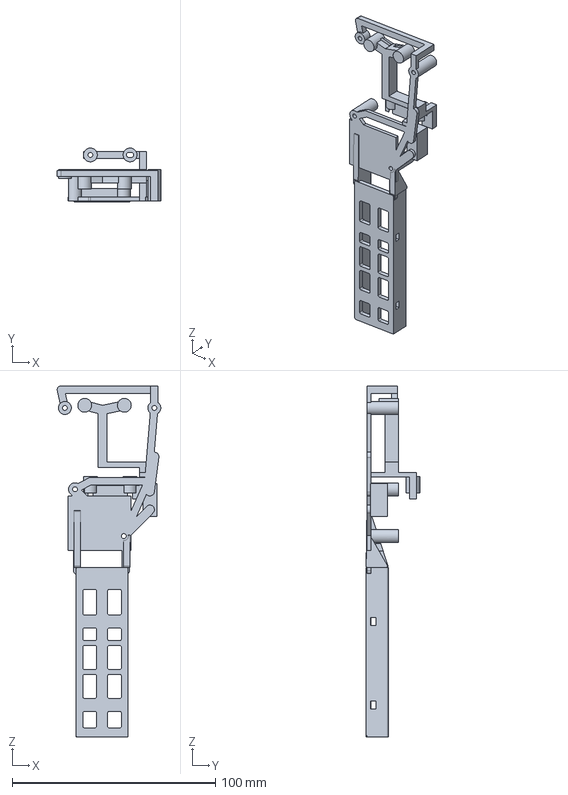
[picture p56: CAD file, 2026-10-17]
shell/step/engineering_mount.step
51.0 x 26.5 x 172.6 mm
