guiwushengzhe-prog/gun-mouse/shell/快速结构预览/pcb/preview-regular-mount.obj

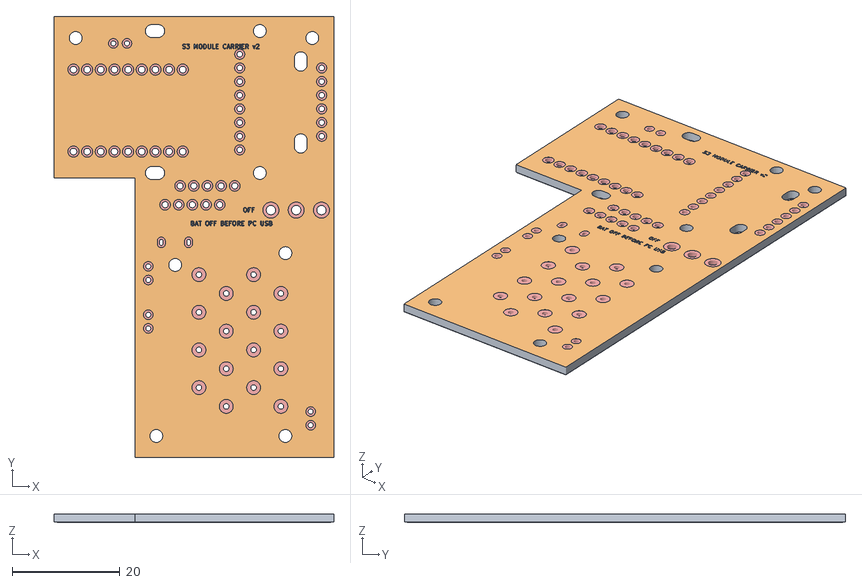
[picture p57: CAD file, 2026-10-18]
shell/快速结构预览/pcb/preview-regular-mount.obj
52.0 x 82.0 x 1.63
grp1
grp8255
grp12295
grp14259
grp64551
