guiwushengzhe-prog/gun-mouse/shell/最终装配版/step/engineering_mount.step

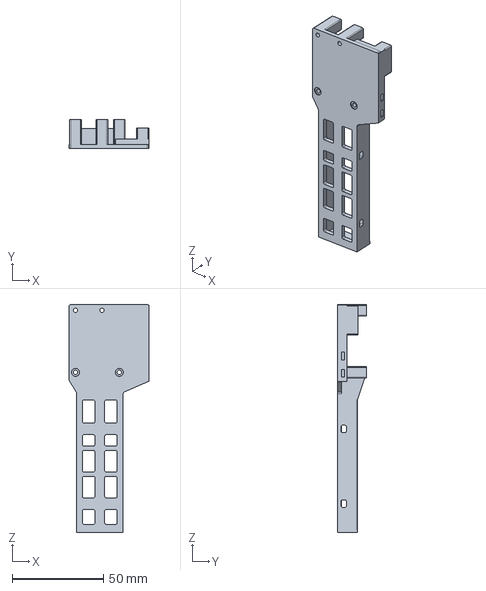
[picture p58: CAD file, 2026-10-18]
shell/最终装配版/step/engineering_mount.step
43.7 x 16.1 x 125.0 mm
