guiwushengzhe-prog/gun-mouse/shell/长方条支座方案/step/长方条支座_预览.step

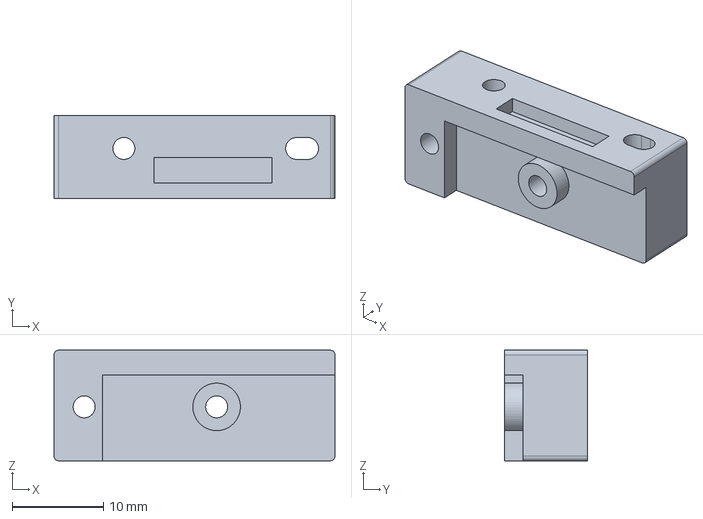
[picture p59: CAD file, 2026-10-18]
shell/长方条支座方案/step/长方条支座_预览.step
30.7 x 9.07 x 12.1 mm
