guiwushengzhe-prog/gun-mouse/shell/长方条正式预览/step/独立摇杆支座.step

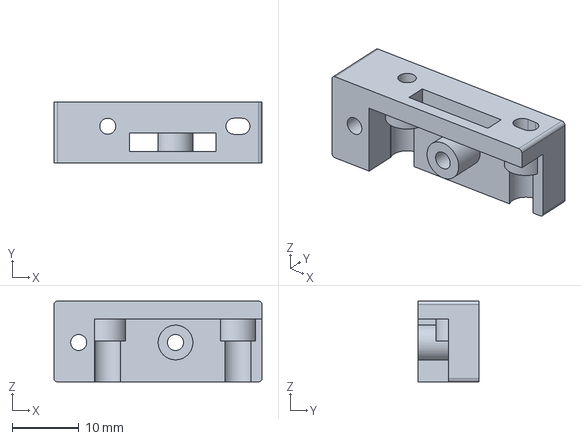
[picture p60: CAD file, 2026-10-18]
shell/长方条正式预览/step/独立摇杆支座.step
31.2 x 9.07 x 12.1 mm
