guiwushengzhe-prog/gun-mouse/deliverables/design-precheck/局部打印候选/扳机-端接避让候选.stl

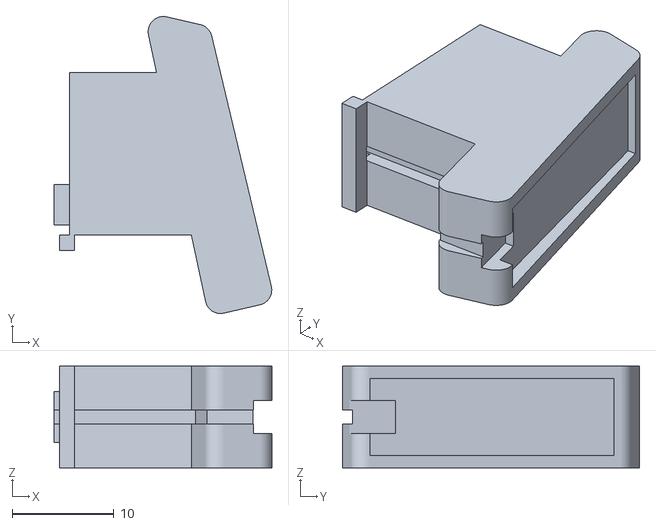
[picture p61: CAD file, 2026-10-05]
deliverables/design-precheck/局部打印候选/扳机-端接避让候选.stl
21.4 x 29.2 x 10.0
