guiwushengzhe-prog/gun-mouse/deliverables/evt-a/打印文件/右键帽-EVT-A.step

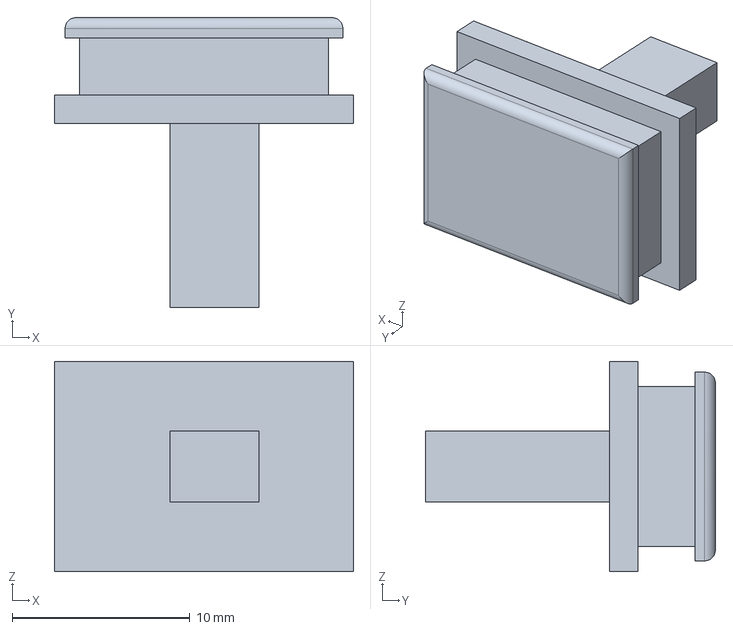
[picture p62: CAD file, 2026-10-06]
deliverables/evt-a/打印文件/右键帽-EVT-A.step
16.8 x 16.3 x 11.8 mm
