guiwushengzhe-prog/gun-mouse/deliverables/经济型单板自焊版/打印文件/右半壳-单板自焊.step

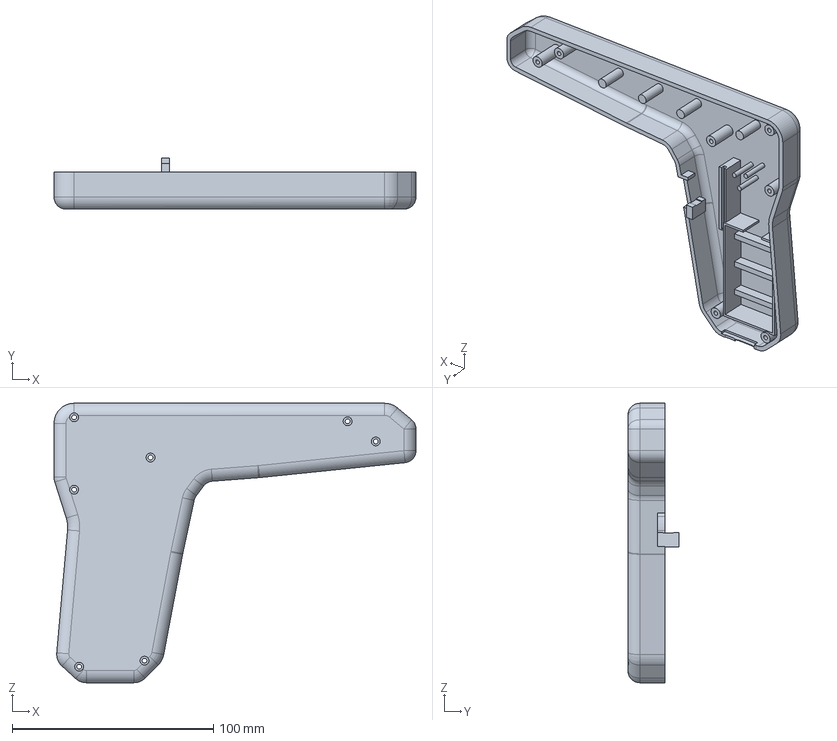
[picture p63: CAD file, 2026-10-06]
deliverables/经济型单板自焊版/打印文件/右半壳-单板自焊.step
180.0 x 25.5 x 139.0 mm
