guiwushengzhe-prog/gun-mouse/deliverables/经济型工厂代焊版/打印文件/扳机-经济型.step

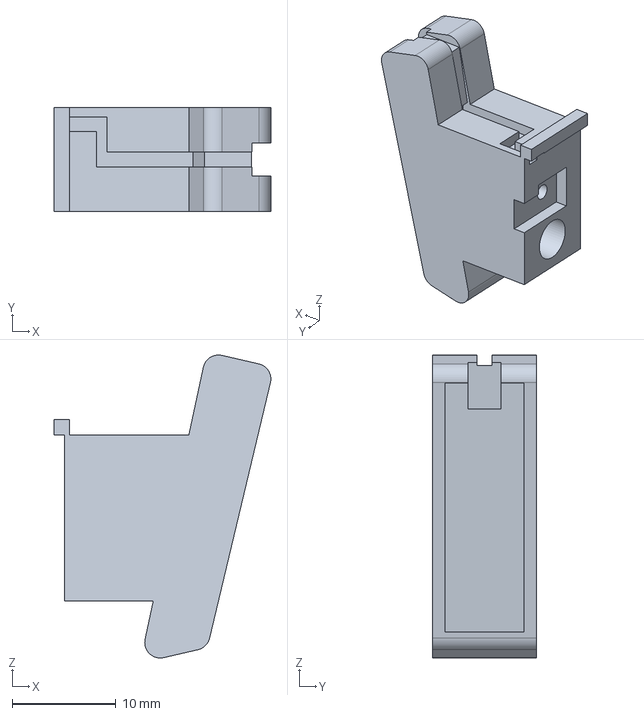
[picture p64: CAD file, 2026-10-06]
deliverables/经济型工厂代焊版/打印文件/扳机-经济型.step
20.9 x 10.0 x 29.2 mm
