guiwushengzhe-prog/gun-mouse/experiments/30g-onepiece-test-shell/generated/pcb_clamp_H1.step

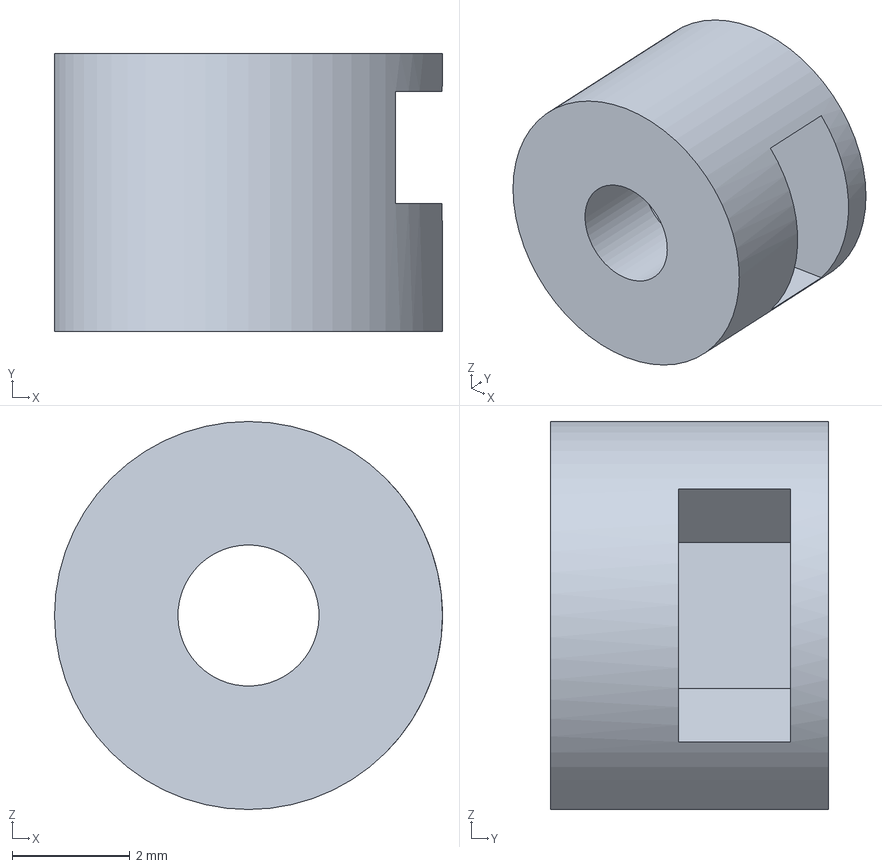
[picture p65: CAD file, 2026-10-07]
experiments/30g-onepiece-test-shell/generated/pcb_clamp_H1.step
6.60 x 4.73 x 6.60 mm
