guiwushengzhe-prog/gun-mouse/experiments/30g-onepiece-test-shell/sources/packing-protection/gunmouse-supermini_clamp-bore-2-guard.step

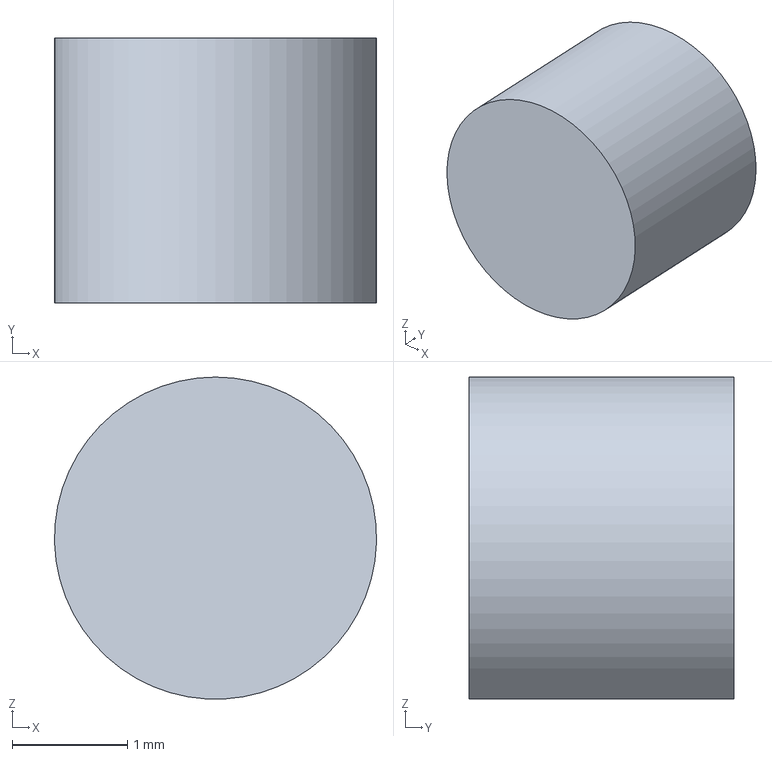
[picture p66: CAD file, 2026-10-07]
experiments/30g-onepiece-test-shell/sources/packing-protection/gunmouse-supermini_clamp-bore-2-guard.step
2.80 x 2.30 x 2.80 mm
