guiwushengzhe-prog/gun-mouse/experiments/evt1-light-shell/generated/trigger.step

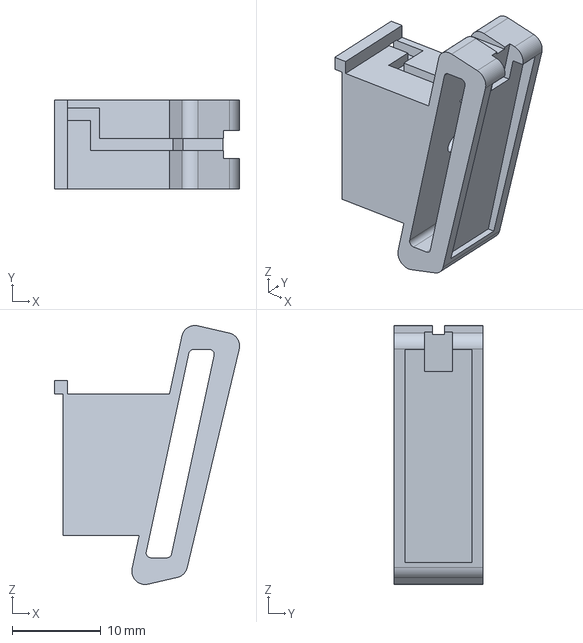
[picture p67: CAD file, 2026-10-07]
experiments/evt1-light-shell/generated/trigger.step
20.9 x 10.0 x 29.2 mm
