guiwushengzhe-prog/gun-mouse/pcb/3d/SuperMini器件外形.step

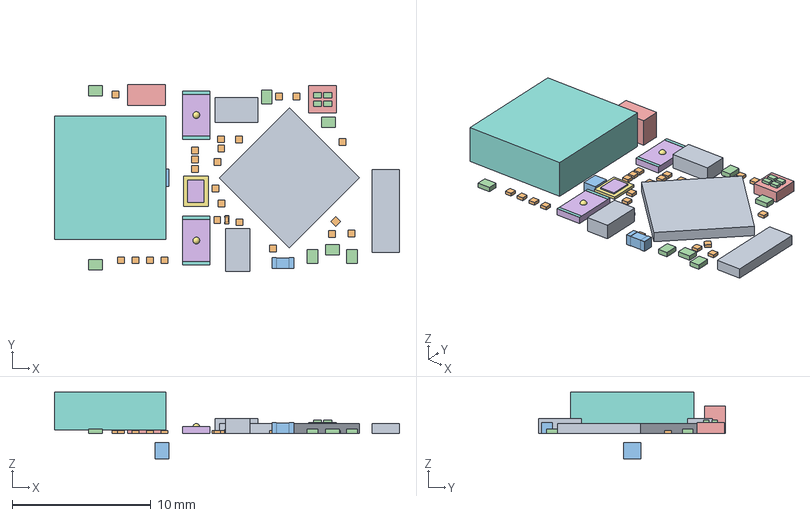
[picture p68: CAD file, 2026-10-16]
pcb/3d/SuperMini器件外形.step
24.9 x 13.5 x 4.82 mm
