guiwushengzhe-prog/gun-mouse/shell/step/right_cap.step

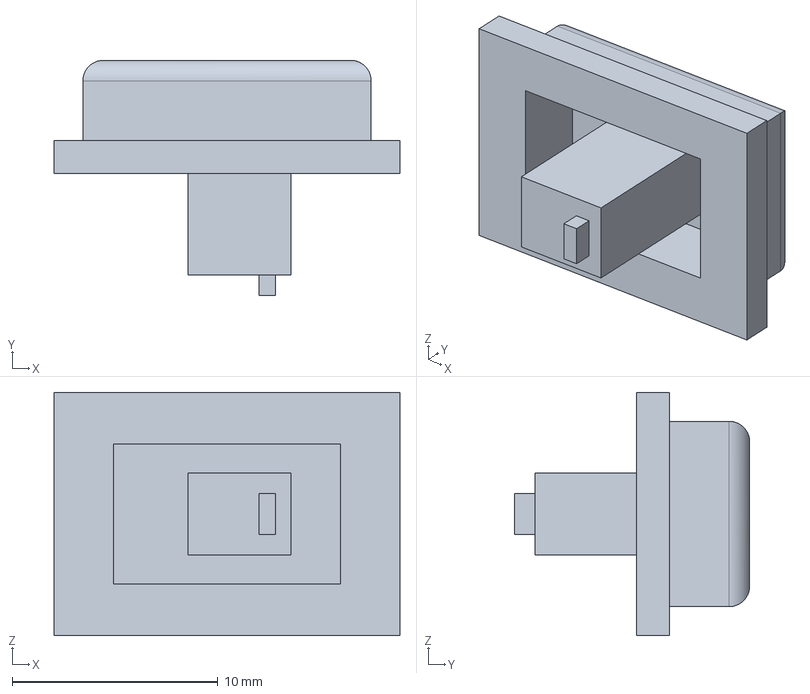
[picture p69: CAD file, 2026-10-12]
shell/step/right_cap.step
16.8 x 11.4 x 11.8 mm
