guiwushengzhe-prog/gun-mouse/deliverables/evt-a/打印文件/左半壳-EVT-A.step

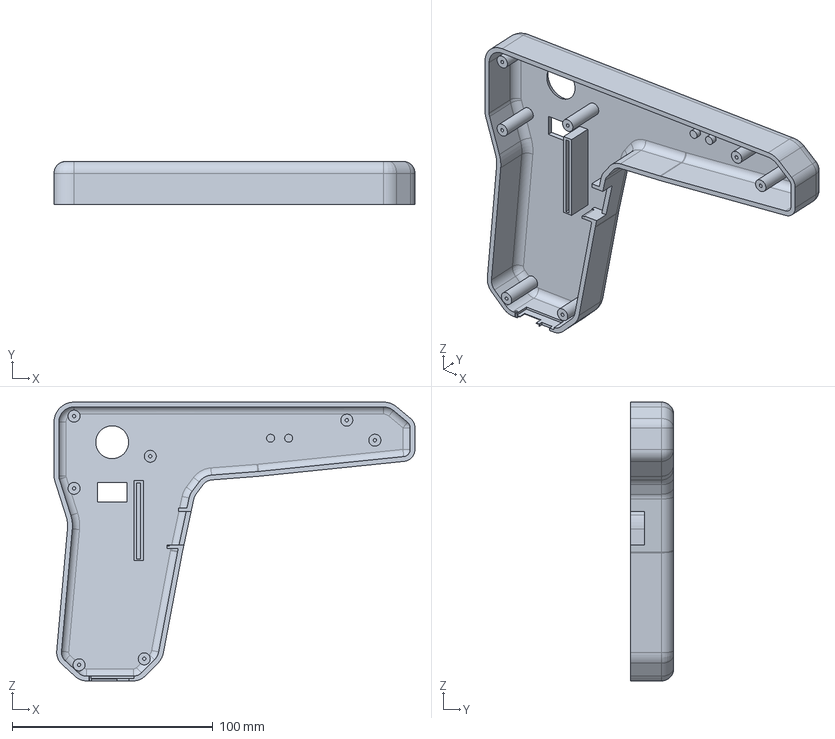
[picture p70: CAD file, 2026-10-06]
deliverables/evt-a/打印文件/左半壳-EVT-A.step
180.0 x 21.6 x 139.0 mm
