guiwushengzhe-prog/gun-mouse/deliverables/经济型单板自焊版/打印文件/扳机开关支架-SS01GL.step

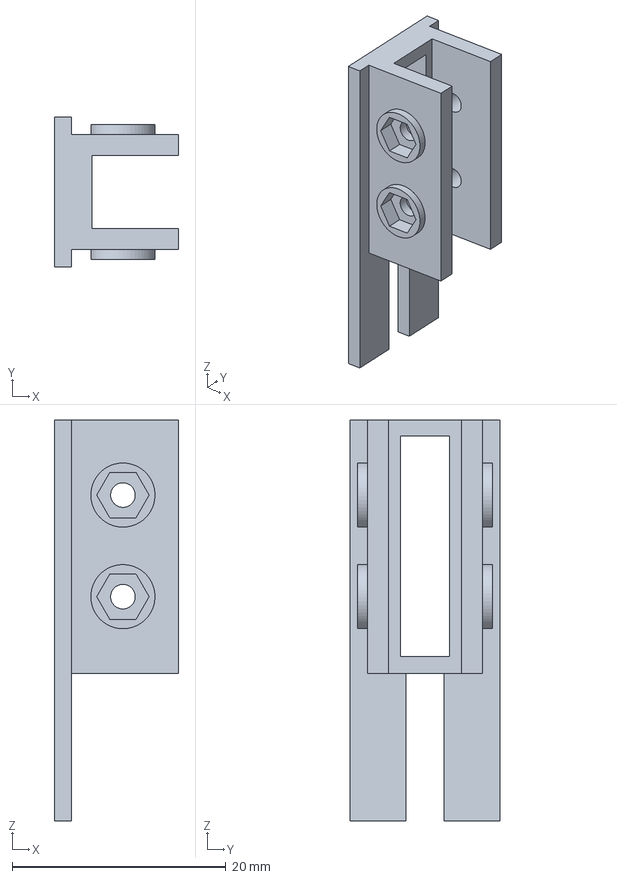
[picture p71: CAD file, 2026-10-06]
deliverables/经济型单板自焊版/打印文件/扳机开关支架-SS01GL.step
11.6 x 14.0 x 37.5 mm
