guiwushengzhe-prog/gun-mouse/experiments/30g-onepiece-test-shell/sources/packing-protection/gunmouse-imu_clamp-bore-2-guard.step

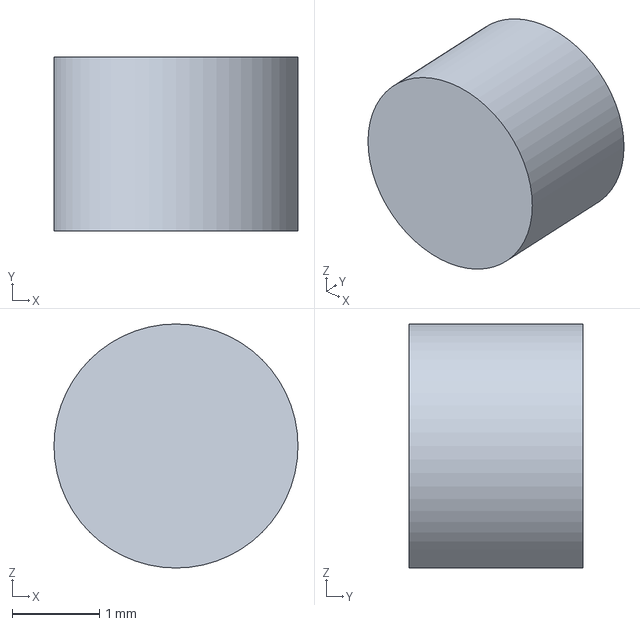
[picture p73: CAD file, 2026-10-07]
experiments/30g-onepiece-test-shell/sources/packing-protection/gunmouse-imu_clamp-bore-2-guard.step
2.80 x 2.00 x 2.80 mm
