guiwushengzhe-prog/gun-mouse/experiments/evt1-light-shell/generated/switch_holder.step

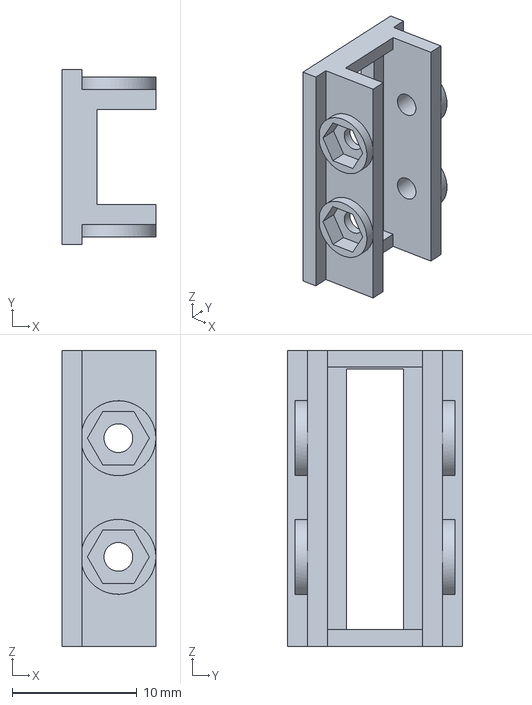
[picture p74: CAD file, 2026-10-07]
experiments/evt1-light-shell/generated/switch_holder.step
7.50 x 14.0 x 23.7 mm
