guiwushengzhe-prog/gun-mouse/shell/step/imu_cradle.step

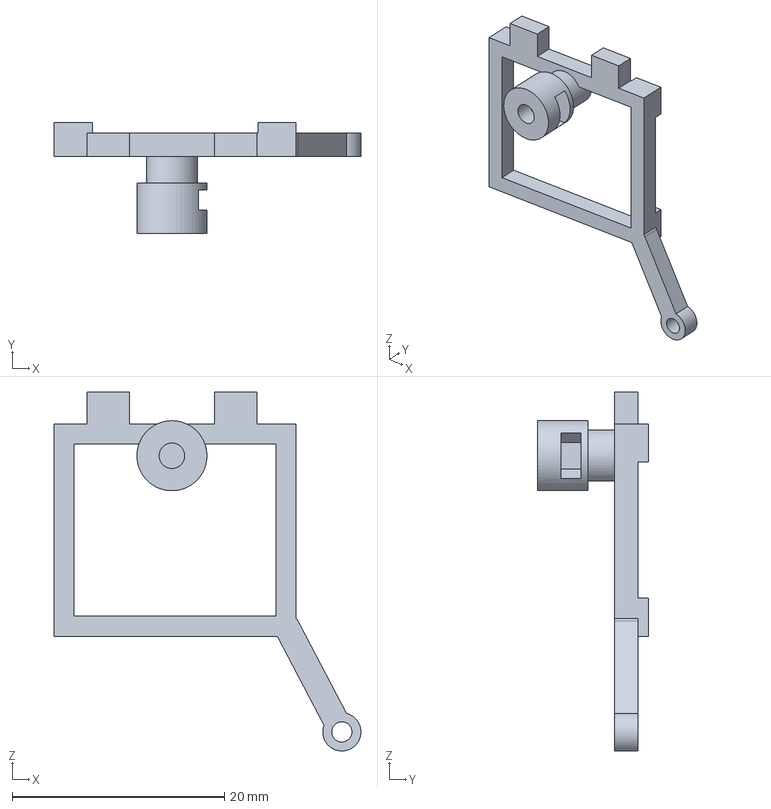
[picture p75: CAD file, 2026-10-12]
shell/step/imu_cradle.step
28.9 x 10.4 x 33.8 mm
