guiwushengzhe-prog/gun-mouse/shell/stl/shell_right.stl

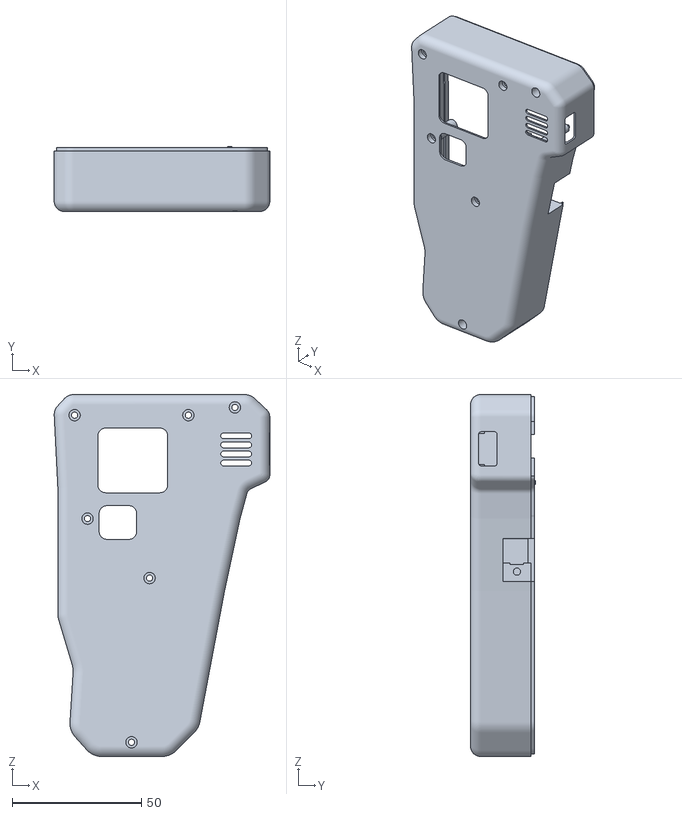
[picture p76: CAD file, 2026-10-12]
shell/stl/shell_right.stl
83.4 x 25.2 x 140.0
