guiwushengzhe-prog/gun-mouse/shell/快速结构预览/stl/独立摇杆支座_预览.stl

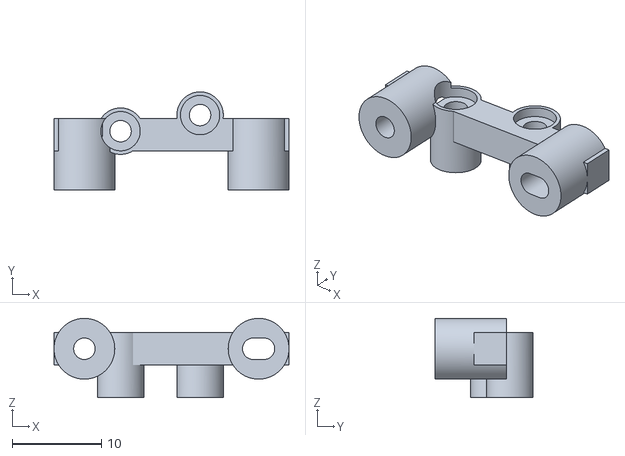
[picture p77: CAD file, 2026-10-17]
shell/快速结构预览/stl/独立摇杆支座_预览.stl
26.3 x 11.0 x 8.87
