guiwushengzhe-prog/gun-mouse/shell/最终装配版/stl/主体底座_装配坐标.stl

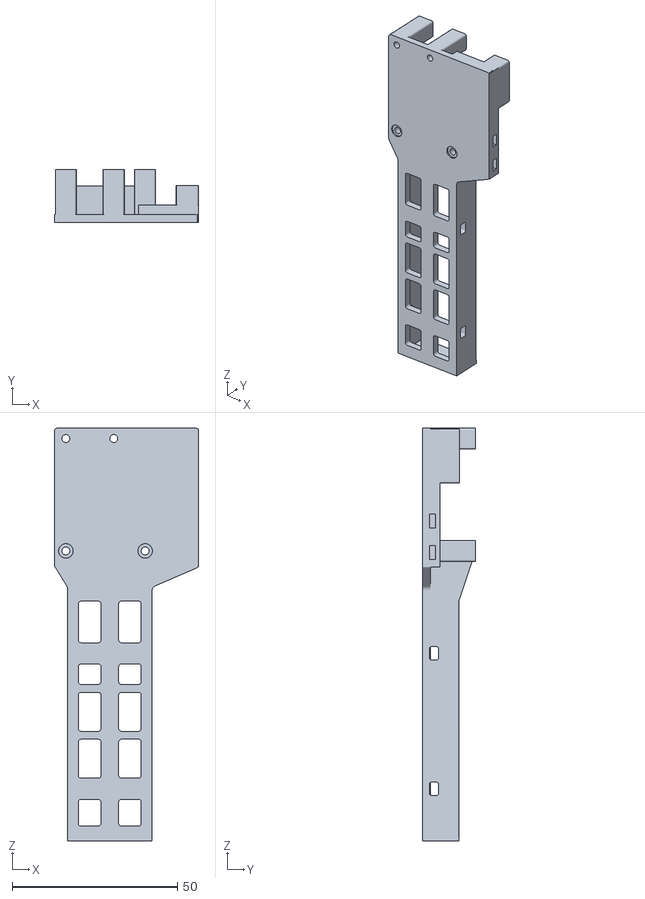
[picture p78: CAD file, 2026-10-18]
shell/最终装配版/stl/主体底座_装配坐标.stl
43.7 x 16.1 x 125.0
