guiwushengzhe-prog/gun-mouse/deliverables/pcb-shell-v1/打印文件/STEP/扳机触摸面盖.step

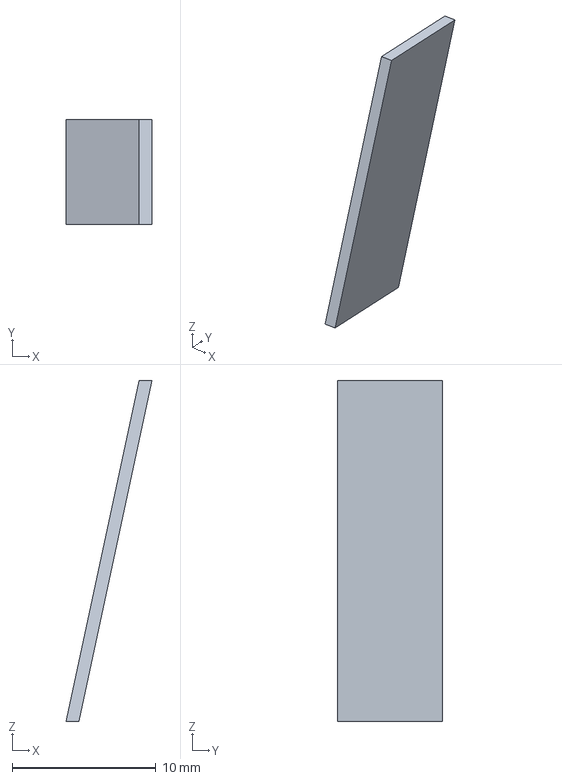
[picture p79: CAD file, 2026-10-05]
deliverables/pcb-shell-v1/打印文件/STEP/扳机触摸面盖.step
5.98 x 7.30 x 23.7 mm
