guiwushengzhe-prog/gun-mouse/deliverables/经济型工厂代焊版/打印文件/扳机触摸面盖.stl

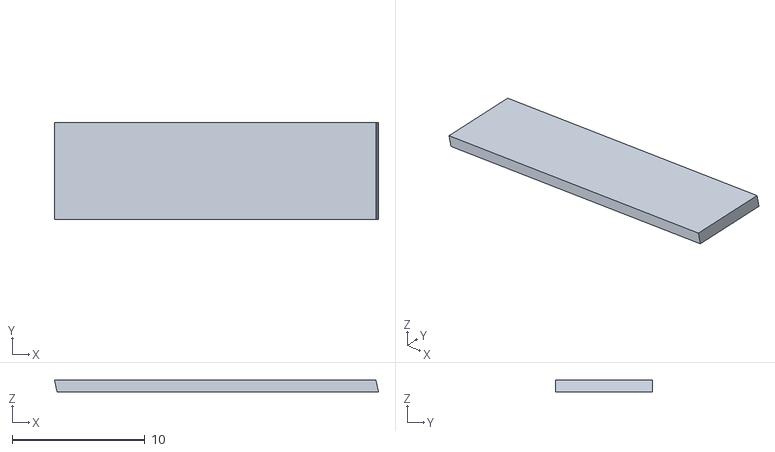
[picture p80: CAD file, 2026-10-06]
deliverables/经济型工厂代焊版/打印文件/扳机触摸面盖.stl
24.4 x 7.30 x 0.88
