guiwushengzhe-prog/gun-mouse/experiments/30g-onepiece-test-shell/generated/imu_cradle.step

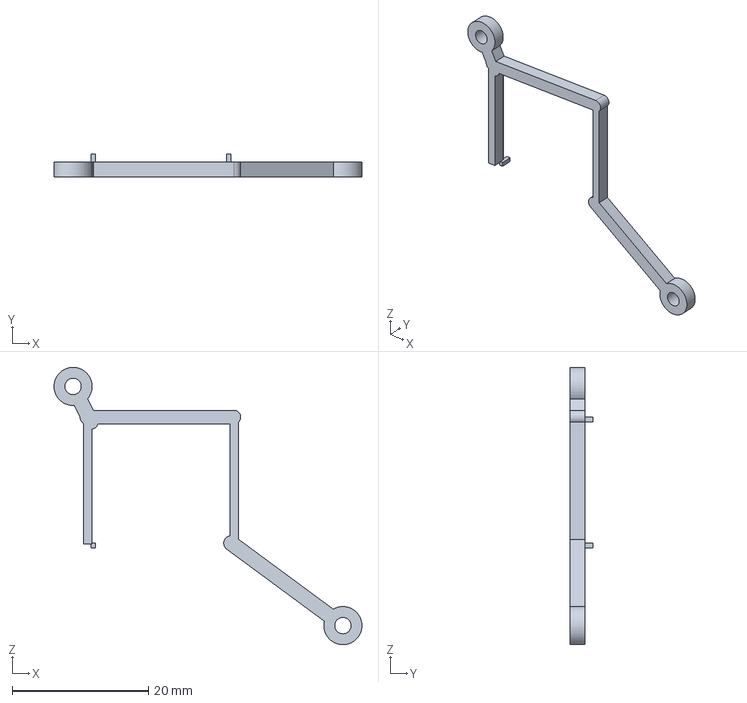
[picture p81: CAD file, 2026-10-07]
experiments/30g-onepiece-test-shell/generated/imu_cradle.step
45.2 x 3.40 x 40.7 mm
