guiwushengzhe-prog/gun-mouse/experiments/evt1-light-shell/generated/shell_left.step

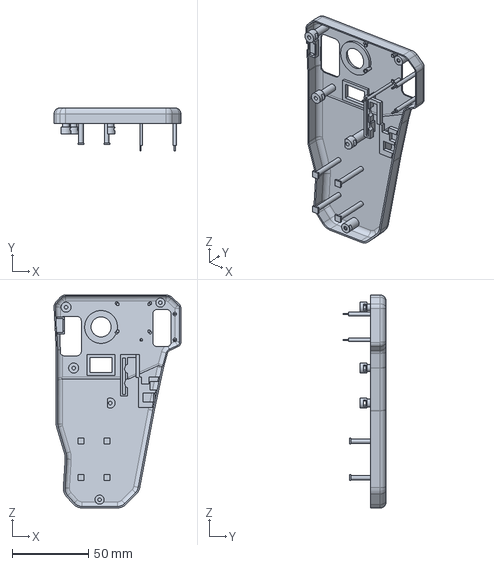
[picture p82: CAD file, 2026-10-07]
experiments/evt1-light-shell/generated/shell_left.step
83.4 x 28.5 x 140.0 mm
