guiwushengzhe-prog/gun-mouse/experiments/30g-onepiece-test-shell/generated/right_cap.step

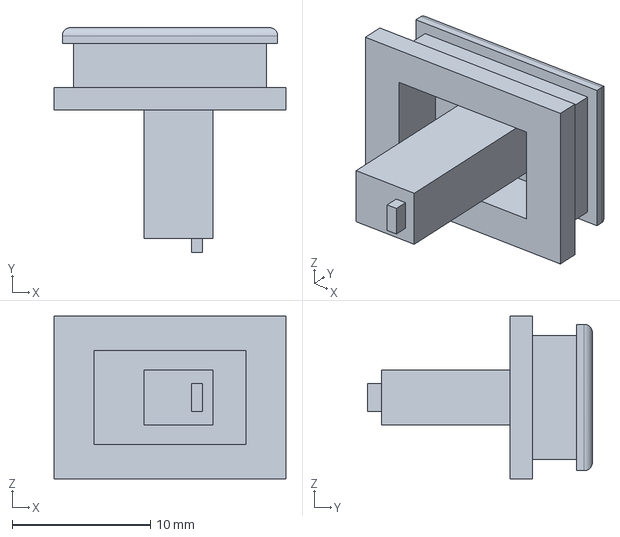
[picture p83: CAD file, 2026-10-07]
experiments/30g-onepiece-test-shell/generated/right_cap.step
16.8 x 16.3 x 11.8 mm
