guiwushengzhe-prog/gun-mouse/experiments/30g-onepiece-test-shell/sources/packing-protection/gunmouse-imu_cradle-bore-1-guard.step

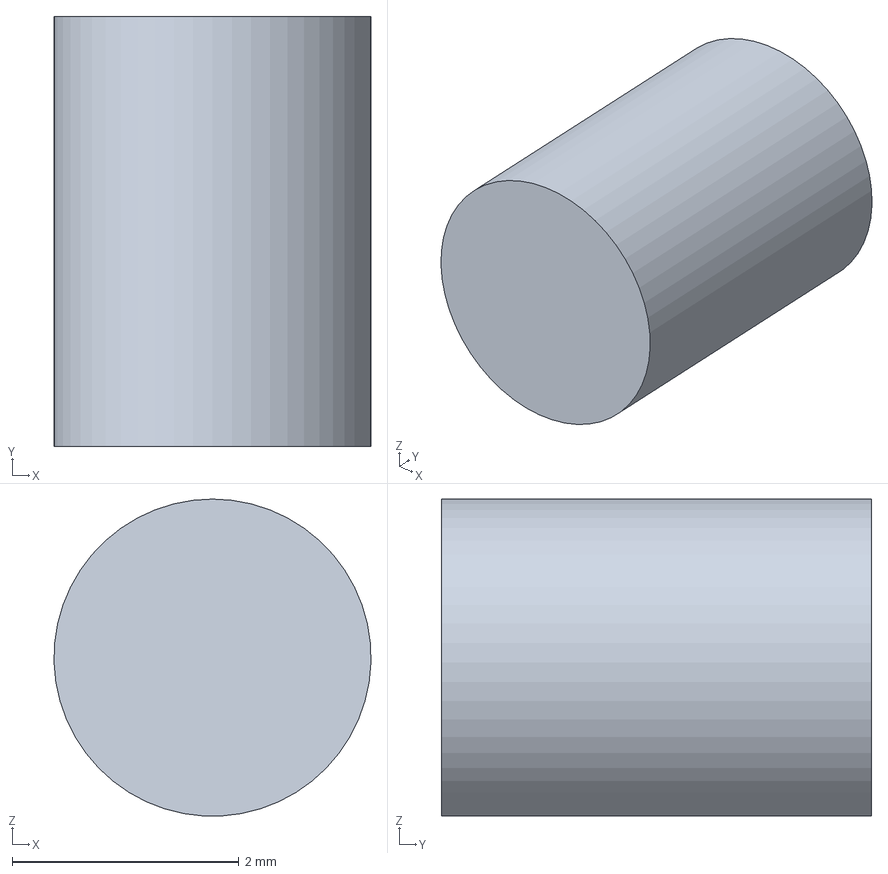
[picture p84: CAD file, 2026-10-07]
experiments/30g-onepiece-test-shell/sources/packing-protection/gunmouse-imu_cradle-bore-1-guard.step
2.80 x 3.80 x 2.80 mm
