guiwushengzhe-prog/gun-mouse/experiments/evt1-light-shell/generated/touch_cover.step

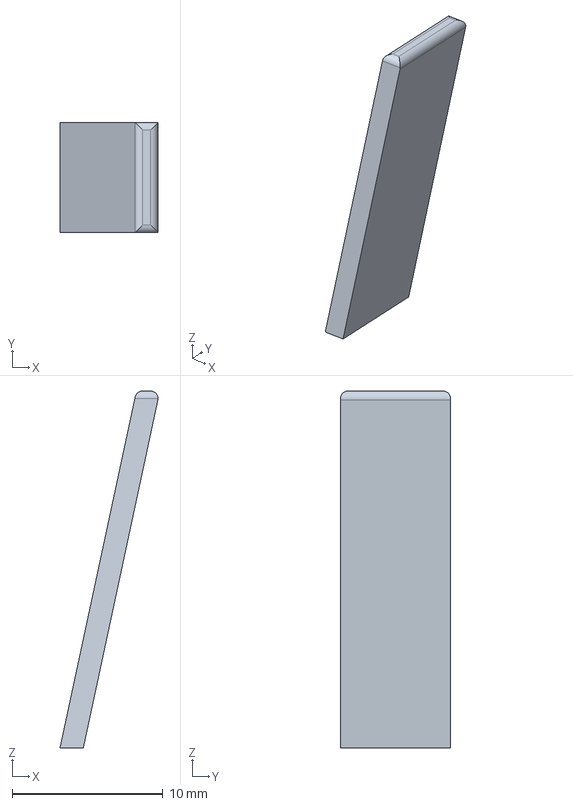
[picture p85: CAD file, 2026-10-07]
experiments/evt1-light-shell/generated/touch_cover.step
6.51 x 7.30 x 23.7 mm
