guiwushengzhe-prog/gun-mouse/deliverables/pcb-shell-v1/打印文件/STEP/摇杆帽.step

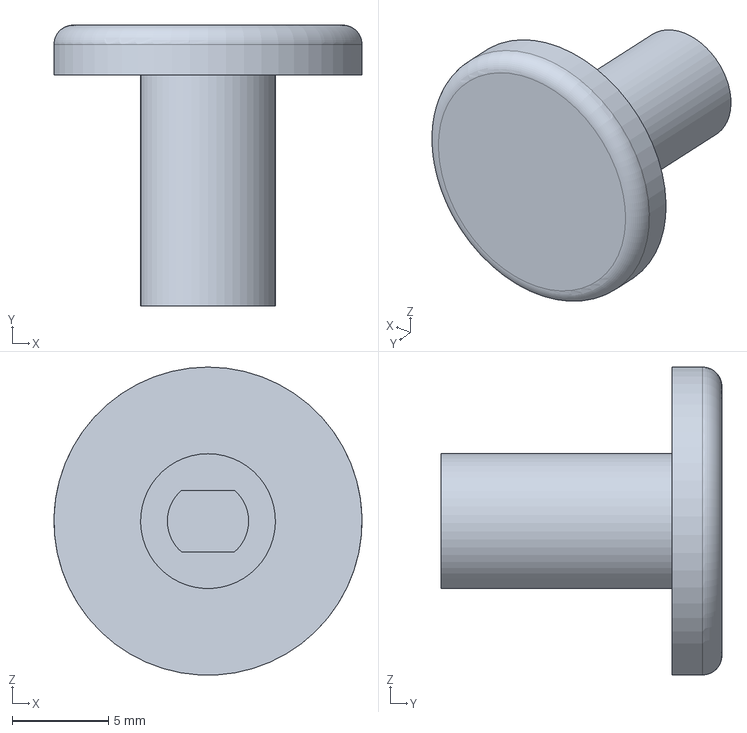
[picture p86: CAD file, 2026-10-05]
deliverables/pcb-shell-v1/打印文件/STEP/摇杆帽.step
16.0 x 14.6 x 16.0 mm
