guiwushengzhe-prog/gun-mouse/experiments/30g-onepiece-test-shell/generated/joystick_cap.step

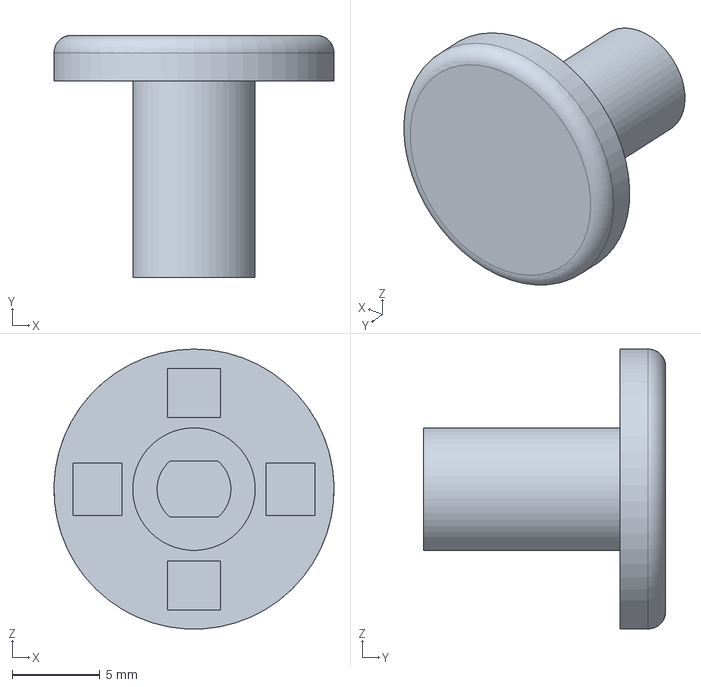
[picture p87: CAD file, 2026-10-07]
experiments/30g-onepiece-test-shell/generated/joystick_cap.step
16.0 x 13.9 x 16.0 mm
