guiwushengzhe-prog/gun-mouse/experiments/30g-onepiece-test-shell/sources/packing-protection/gunmouse-pcb_clamp_H4-bore-1-guard.step

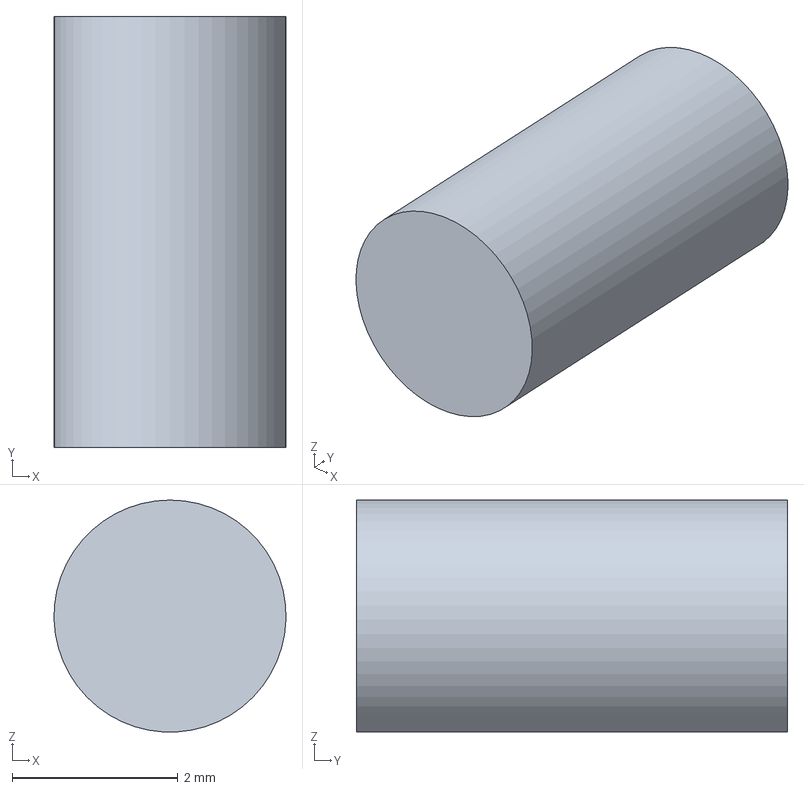
[picture p88: CAD file, 2026-10-07]
experiments/30g-onepiece-test-shell/sources/packing-protection/gunmouse-pcb_clamp_H4-bore-1-guard.step
2.80 x 5.20 x 2.80 mm
