guiwushengzhe-prog/gun-mouse/deliverables/经济型工厂代焊版/打印文件/GY模块压框.stl

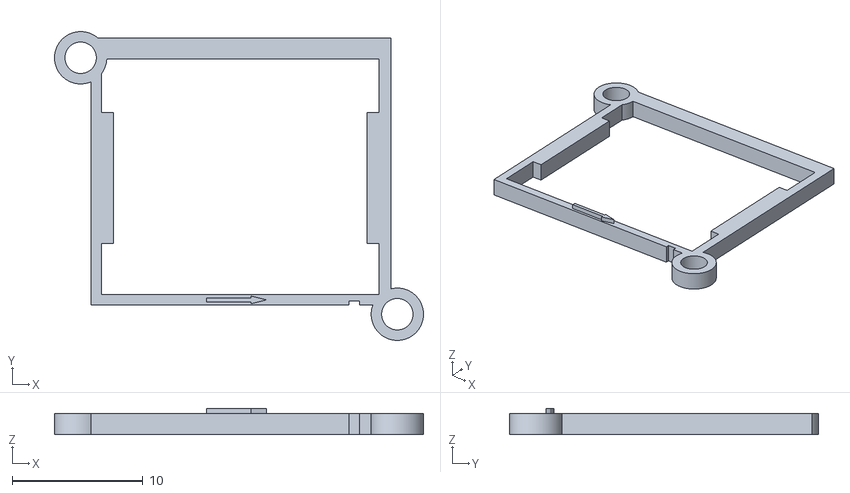
[picture p89: CAD file, 2026-10-06]
deliverables/经济型工厂代焊版/打印文件/GY模块压框.stl
28.2 x 23.6 x 2.00
