guiwushengzhe-prog/gun-mouse/experiments/30g-onepiece-test-shell/generated/frame.step

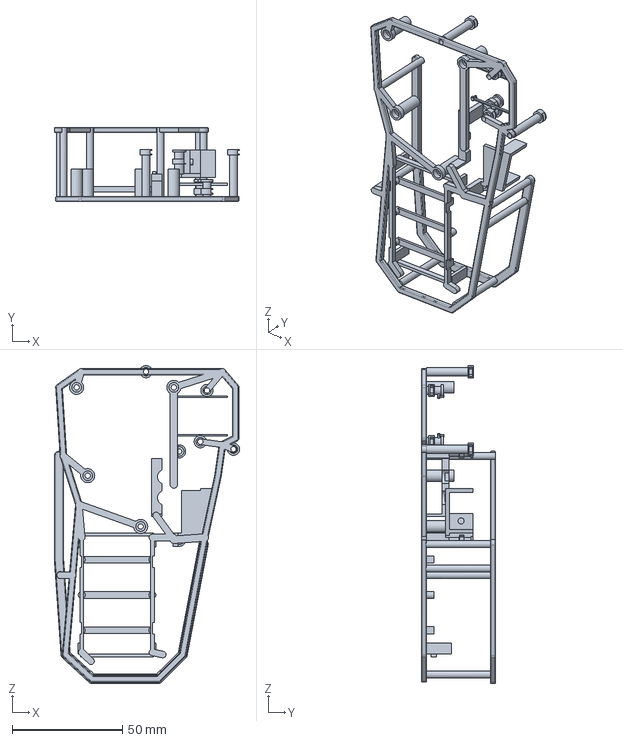
[picture p90: CAD file, 2026-10-07]
experiments/30g-onepiece-test-shell/generated/frame.step
83.9 x 33.6 x 144.0 mm
