guiwushengzhe-prog/gun-mouse/experiments/30g-onepiece-test-shell/generated/supermini_clamp.step

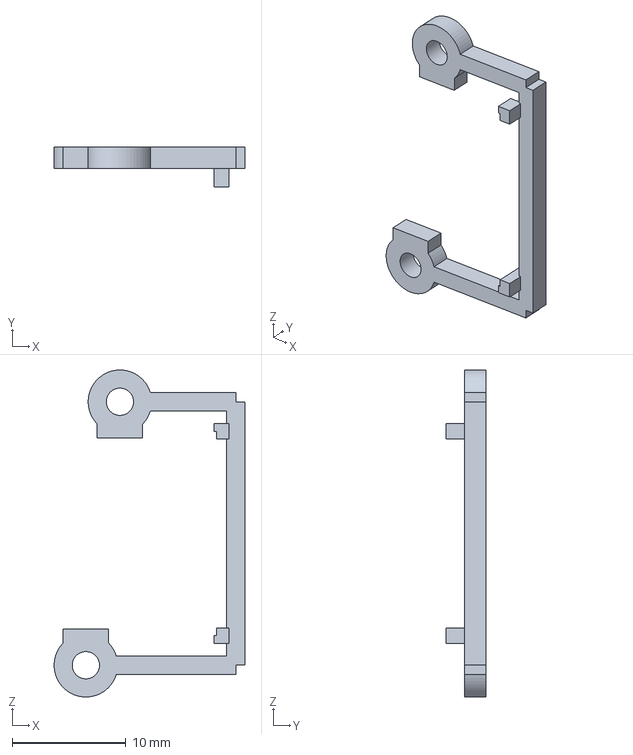
[picture p91: CAD file, 2026-10-07]
experiments/30g-onepiece-test-shell/generated/supermini_clamp.step
16.8 x 3.50 x 28.8 mm
