guiwushengzhe-prog/gun-mouse/experiments/30g-onepiece-test-shell/generated/imu_clamp.step

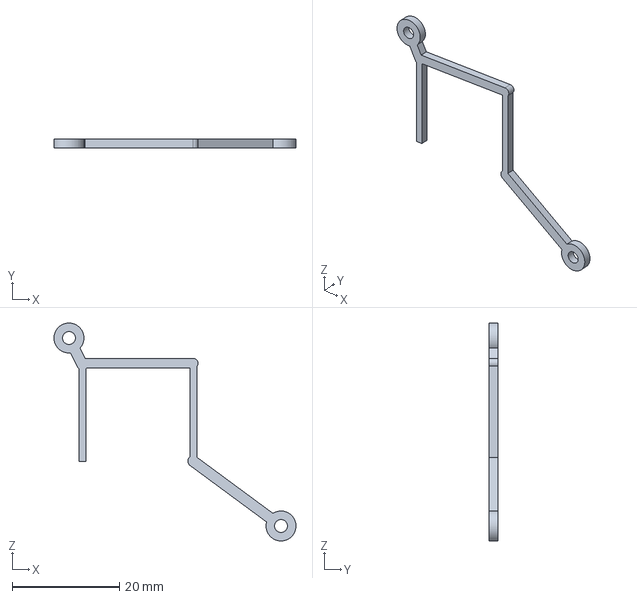
[picture p92: CAD file, 2026-10-07]
experiments/30g-onepiece-test-shell/generated/imu_clamp.step
45.2 x 1.60 x 40.7 mm
