guiwushengzhe-prog/gun-mouse/(list of files, cad)

Other CAD files:
deliverables/经济型改版/打印文件/左半壳-经济型.step
release/2026-10-18-最终版/装配查看/第二代完整装配.obj
shell/stl/第二代完整装配.stl
shell/快速结构预览/stl/第二代完整装配.stl
shell/最终装配版/pcb/gunmouse-final.obj
shell/最终装配版/stl/独立摇杆支座_装配坐标.stl
shell/长方条支座方案/stl/长方条支座_仅供预览.stl
shell/长方条正式预览/pcb/preview-rectangular-mount.obj
deliverables/pcb-shell-v1/打印文件/STEP/右键帽.step
release/2026-10-18-最终版/三维打印/主体底座.step
shell/stl/trigger.stl
shell/快速结构预览/pcb/preview-local-mount.obj
shell/快速结构预览/stl/主体底座_预览.stl
shell/最终装配版/stl/第二代完整装配.stl
shell/长方条支座方案/step/engineering_mount.step
shell/长方条支座方案/stl/第二代完整装配.stl
shell/长方条正式预览/step/engineering_mount.step
deliverables/pcb-shell-v1/打印文件/STEP/扳机.step
deliverables/evt-a/打印文件/扳机-EVT-A.step
deliverables/经济型单板自焊版/打印文件/扳机设定片-经济型-0.8mm.step
experiments/30g-onepiece-test-shell/sources/packing-protection/gunmouse-imu_clamp-bore-1-guard.step
deliverables/evt-a/打印文件/右半壳-EVT-A.step
deliverables/pcb-shell-v1/打印文件/STEP/左半壳.step
deliverables/经济型单板自焊版/打印文件/扳机-经济型.step
deliverables/经济型工厂代焊版/打印文件/右半壳-经济型.step
deliverables/evt-a/打印文件/扳机设定片-0.8mm.step
deliverables/经济型单板自焊版/打印文件/扳机设定片-经济型-1.0mm.step
deliverables/经济型工厂代焊版/打印文件/扳机设定片-经济型-1.0mm.step
experiments/evt1-light-shell/generated/imu_cradle.step
deliverables/evt-a/打印文件/扳机设定片-1.2mm.step
deliverables/经济型单板自焊版/打印文件/扳机设定片-经济型-1.2mm.step
experiments/30g-onepiece-test-shell/sources/packing-protection/gunmouse-pcb_clamp_H1-bore-1-guard.step
experiments/evt1-light-shell/generated/shell_right.step
deliverables/经济型单板自焊版/打印文件/GY模块压框.step
deliverables/经济型工厂代焊版/打印文件/左半壳-经济型.step
experiments/30g-onepiece-test-shell/sources/packing-protection/gunmouse-supermini_clamp-bore-1-guard.step
experiments/evt1-light-shell/generated/right_cap.step
experiments/30g-onepiece-test-shell/generated/trigger_holder.step
deliverables/design-precheck/局部打印候选/右半壳-摇杆支撑候选.stl
deliverables/evt-a/打印文件/右半壳-EVT-A.stl
deliverables/evt-a/打印文件/右键帽-EVT-A.stl
deliverables/evt-a/打印文件/左半壳-EVT-A.stl
deliverables/evt-a/打印文件/扳机-EVT-A.stl
deliverables/evt-a/打印文件/扳机设定片-0.8mm.stl
deliverables/evt-a/打印文件/扳机设定片-1.0mm.stl
deliverables/evt-a/打印文件/扳机设定片-1.2mm.stl
deliverables/pcb-shell-v1/打印文件/STL/右半壳.stl
deliverables/pcb-shell-v1/打印文件/STL/右键帽.stl
deliverables/pcb-shell-v1/打印文件/STL/左半壳.stl
deliverables/pcb-shell-v1/打印文件/STL/扳机.stl
deliverables/pcb-shell-v1/打印文件/STL/摇杆帽.stl
deliverables/经济型单板自焊版/打印文件/右半壳-单板自焊.stl
deliverables/经济型单板自焊版/打印文件/左半壳-单板自焊.stl
deliverables/经济型单板自焊版/打印文件/扳机-经济型.stl
deliverables/经济型单板自焊版/打印文件/扳机开关支架-SS01GL.stl
deliverables/经济型单板自焊版/打印文件/扳机设定片-经济型-1.0mm.stl
deliverables/经济型工厂代焊版/打印文件/右半壳-经济型.stl
deliverables/经济型工厂代焊版/打印文件/左半壳-经济型.stl
deliverables/经济型工厂代焊版/打印文件/扳机-经济型.stl
deliverables/经济型工厂代焊版/打印文件/扳机设定片-经济型-0.8mm.stl
deliverables/经济型工厂代焊版/打印文件/扳机设定片-经济型-1.2mm.stl
deliverables/经济型改版/打印文件/左半壳-经济型.stl
experiments/evt1-light-shell/generated/joystick_cap.stl
experiments/evt1-light-shell/generated/right_cap.stl
experiments/evt1-light-shell/generated/switch_holder.stl
experiments/evt1-light-shell/generated/touch_cover.stl
release/2026-10-18-最终版/三维打印/主体底座.stl
release/2026-10-18-最终版/三维打印/摇杆支座.stl
shell/stl/engineering_mount.stl
shell/stl/imu_cradle.stl
shell/快速结构预览/step/engineering_mount.step
shell/快速结构预览/step/独立摇杆支座.step
shell/快速结构预览/第二代完整装配.obj
shell/最终装配版/第二代完整装配.obj
shell/第二代完整装配.obj
shell/第二版外壳_三色预览.blend
shell/第二版外壳_原版.blend
shell/第二版外壳_器件标注预览.blend
shell/长方条支座方案/第二代完整装配.obj
shell/长方条正式预览/stl/主体底座_装配坐标.stl
shell/长方条正式预览/stl/独立摇杆支座_装配坐标.stl
shell/长方条正式预览/stl/第二代完整装配.stl
shell/长方条正式预览/第二代完整装配.obj
