guiwushengzhe-prog/gun-mouse/docs/Astra审核提示词-制造与装配.md

# 交给 Astra 的集中审核任务

工作目录：`F:\项目\枪型飞鼠\.worktrees\pcb-shell-finish`，分支 `codex/pcb-shell-finish`。先记录当前提交编号。请只读审核，不直接修改文件、不下单、不改原 AI 工作区。保持既定功能：右手单手蓝牙体感鼠标，触摸扳机只控制体感许可，机械扳机为左键、独立右键、摇杆转向并按下为中键。**不要添加插 USB 自动暂停、拔掉恢复鼠标的规则。**

我们已做过一轮实质预审、修正装配说明、核对引脚与原厂资料、编译检查交互参考核心，并生成两处局部结构候选。请先阅读 `docs/设计预审与优化决策-V1.md` 与 `evidence/design-review-v1/设计计算.json`，只对关键推理做独立抽查，主要精力用在以下四个尚未定下的设计决策。

正式基线：`pcb/gun-mouse-v1/` 与 `deliverables/pcb-shell-v1/`。候选改件：`deliverables/design-precheck/局部打印候选/`；它们没有替换原六件打印包。配置只校正文字说明，正式 PCB 网络、器件位置、走线和原打印几何保持原样。自动布线试验板的六处漏接不属于正式板，也不需要补；不要把试验板当待交付电路。

## 请集中判断这四项

1. **按钮怎样吸收公差最容易生产和装配？**扳机按当前保证参数无法用固定硬触点同时覆盖最晚动作与最早动作个体；右键也有类似问题。请核实准确开关规格、实际安装基准与是否把动作后最小保证行程正确使用，然后比较可换驱动尖端、小螺钉调节、柔顺传力等方案。我们的初选是保留壳体硬限位、由工厂按真实总成设置触点并固定；扳机动作后压入 0.95±0.1 毫米只是候选目标。请选择具体结构，说明调节范围、力的路径、保持力/疲劳、复位与必须实测的参数，能否减少用户调整。不要只加 0.1 毫米，也不要只改右键的名义行程就叫解决全公差。
2. **电源与充电怎样做最少改动而可靠？**开发板厂家允许 3.3V 排针供电，不直接判禁用；但板载稳压输出与主板电源仍相连，开发板自身 USB 会引入第二来源，关 SW3 并不隔离主板输出。两路检测分压在关机后仍接电池/USB；约 360mA 充电加系统负载还要满足输入预算、实际电池规格和散热。比较保留现架构并局部改善、输入检测隔离、降低充电电流、换带输入限流/负载优先/温度检测的充电管理芯片，明确哪项首样必须做、哪项小批量再做。不能靠停用鼠标规避电源设计，也不能假定某个电流或续航已经实测。
3. **USB、地参考、散热铜和天线如何共同布局？**原正式 D+ 约 149.85 毫米、D−约 155.26 毫米，其中负线两过孔、存在长段不成对，原板无覆铜。请按实际两层布局比较“保留底口下载，重新成对走线和连续地参考”与“底口仅充电，工厂装壳前拔出开发板单板烧录”；后者会增加现场拆壳更新的负担。我们偏好保留底口下载，不默认四层。需要板厂叠层参数才能冻结阻抗线宽。天线参数区域有 C5/C6 和线路，但尚未确认真实馈点与净空；不要机械删电容。GPIO14 触摸可保留，下一版考虑约 510 欧姆串阻、低电容静电保护及整机抗扰；不默认重新加 TTP223 模块。
4. **摇杆的长期供货和维修是否值得改变结构？**RKJXV1224005 原厂已标新设计非推荐品，并非停产。首样已有尺寸和封装可保留；请比较长期可买的替代型号、直接焊主板与独立摇杆组件的总成本、受力和装配步骤。明确更换型号会改哪些焊盘、板形、支架、帽子，不能只说模块化就更好，也不承诺只重打支架就能换全部型号。

## 已完成的部分与无需反复做的工作

- 48 个器件的装配责任已逐项核对；SW3 实际为 7 个顶层无孔贴片焊盘，不是此前误判的直插开关。纯插件 64 个焊接位置，加 USB1 的 4 个通孔固定位置，共 68 个；工厂范围仍需询价，不把报价当功能验收。
- 用户少焊接的具体交付要求已写在 `docs/工厂装配与交付要求-V1.md`：完整焊接、分板去毛刺、正确极性电池、成品线束、电极预装、烧录与首件检查责任。
- 摇杆背部支撑柱与触摸端接避让腔已有实体/打印文件和局部检查，未证明真实打印高度与寿命；不需要重新画整个外形。电池和弹簧供应商参数、实际打印公差要实测，不能由模型补造。
- USB 检测应读模拟电压、摇杆中心与两端校准、S3 触摸读数上升、触摸与按键独立等已整理在 `docs/固件接口与交互契约-V1.md`。参考核心不是完整可烧录固件；不在本次替我们编写整套固件。
- 不重做安装、界面/接口调试或已通过的规则检查；软件零错误不代替电气、机构与实物判断。

## 希望你交付什么

对四项分别给出：对我们现判断的同意/修正及证据、最推荐方案、具体修改位置、是否重新制板/打印、哪些人工步骤减少、增加哪些零件和费用。价格有来源才给数值，否则待询价；将问题分为下单前必改、首件实测、以后批量优化。

请选出一条从现设计到可装配产品的最小改动路线。若有更省力、更可靠的替代，明确提出并比较，不迁就我们现方案；也不要为量产理想方案让首样无谓增加成本。结论先作为具体方案讨论，实施时仍在独立分支和工作树完成，保留原 AI 工作区。

所需文件按上述索引读取；原厂来源已在预审报告就近列出。需要精确规格时阅读厂家原文，不以购物照片推测尺寸、不将候选器件写成已采购。
