guiwushengzhe-prog/gun-mouse/experiments/30g-onepiece-test-shell/printing.md

# 打印文件与重量口径

送印文件为 [generated/onepiece-print.stl](generated/onepiece-print.stl)。它由各独立打印件和可剪连接桥构成一个连通实体。零件在骨架侧边停车，打印后剪断桥，按装配说明组装。连接桥全部计入模型体积和估重。

`generated/assembly-original.step` 保存每个零件的原始装配坐标。独立零件的 STEP 同样处于装配坐标；一体打印 STEP/STL 则已旋转、平移。`generated/print-pack.json` 逐件记录原位到打印位置及其逆变换，不能把停车后的 STL 直接作为原位零件使用。

## 30 g 免单计重

本次要求是送印件低于 30 g，目标约 29 g 并包含可剪连接桥。全部打印件的清单、CAD 体积、STL 体积和检查后的连通数以 `generated/print-pack.json` 为准。

| 内容 | 本次结果 |
| --- | ---: |
| 打印零件 | 13 件 |
| 全部零件净体积 | 20.745733 cm³ |
| 可剪桥增加的体积 | 0.309865 cm³ |
| 一体模型净体积 | **21.055598 cm³** |
| 1.35 g/cm³ 下估重 | **28.425057 g** |
| 30 g 对应的最高密度 | 1.424799 g/cm³（要低于 30 g，密度需低于此值） |
| 模型占用尺寸 | **212.13×147.95×33.85 mm** |
| CAD / STL 连通实体数 | 1 / 1 |
| STL 边界 / 非流形 / 退化 | 0 / 0 / 0 |
| STL 与 CAD 体积相对差 | 0.00590% |

计算关系：估重 g = 模型体积 mm³ × 树脂密度 g/cm³ ÷ 1000。当前配置的 1.35 g/cm³ 是估算输入，不能替代打印商材料参数或打印后的实称。模型未包含切片生成的工艺支撑；下单前核对免单是按模型净体积、实际打印件还是含支撑计重。

点件时核对：主骨架、控制压桥、扳机侧门、扳机、触摸面盖、右键帽、摇杆帽、SuperMini 压框、GY 独立托座、GY 压框、GL13 开关夹座、H1 压片、H4 压片各一件。H4 压片有削平的一侧，以原位 STEP 区分，装到 C_RAIL 电容旁的 H4；H2、H3 的压片已合入控制压桥。

## 打印与分离

- 使用商家支持的树脂工艺。骨架和活动件的姿态已经分别记录，但最终支撑方案由切片和首件实际情况确认。
- 支撑接触点避开扳机导轨、螺母防转槽、压板接触面、右键导向与帽沿止挡、摇杆轴孔及限位内圈。
- 固化与清理后，先剪连接桥中部，再修平残根。不要用扭掰方式将细梁或薄面盖直接从连接桥撕开。
- 清孔、修根后检查裂纹，再空装螺钉、螺母和活动件。出现发白、缺口或裂纹时记录位置，调整局部结构。
- 固定件的机螺钉配 M2 螺母。薄连接桥是一次性停车连接，不承担整机装配后的保持。
- 触摸面盖与 H4 压片的连接桥直径为 0.5 mm，其余为 0.9 mm。H4 顶盖较薄，剪桥时托住压片，先剪中段再用细锉清根，保留顶面、螺母入口及削平面。触摸盖的桥只接窄边，两大面用于触摸或胶接，避免把支撑和胶面残根留在其上。

## 可复现文件

模型和停车过程分别执行。先生成并验收独立原位零件，再调用 `pack_parts(parts, out_dir, ...)`。打印包装含所有传入零件，不复用旧 STL 的隐含旋转。

打包函数支持显式的原位连接点 `connection_points`、功能面保护实体 `protected_regions` 以及每件旋转 `rotations`。自动选择的连接点需由最终模型复核后才用于制造。导出检查包含有效 CAD 实体、单连通实体、STL 水密与连通、网格与 CAD 体积差；这些检查不替代树脂实物配合。

本次的 13 个连接点均为显式审核点；配置为 [packing-plan.json](packing-plan.json)，保护实体与局部审核记录位于 `sources/packing-protection/`。完整命令见 [README](README.md#生成与复核)。原位 STEP 的 SHA、保护 STEP 的 SHA 和配置 SHA 均记录在打印报告中，更新几何后必须重新打包。骨架参考姿态绕 X +90°，小件按各自旋转停放；连接桥低点导致的整体归零位移也计入逐件变换。
