guiwushengzhe-prog/gun-mouse/docs/工厂装配与交付要求-V1.md

# 枪型飞鼠 V1：工厂装配与交付要求

编写日期：2026-10-06。用途：采购、工厂询价及首件装配分工，不是已下单、已获得工厂承诺或可量产的证明。

适用正式设计：`pcb/gun-mouse-v1/`、`config/pcb-shell-v1.json`、`deliverables/pcb-shell-v1/`。自动布线试验工程不用于采购、焊接或产品交付。本文件不改变电路、器件位置和外壳模型。

本轮预审发现按钮全公差与 USB 布局尚需修改；本文件先供范围询价，制造放行前须采用解决这些条件的新定稿，不能把报价确认当成设计验收。已核实结论及剩余方案见 `docs/设计预审与优化决策-V1.md`。

目标是让用户到手后插上已预制线束、装入机构件并拧螺丝；板上焊接、分板、端子压接、电极端接尽量提前完成。哪些步骤由嘉立创、线束供应商或独立装配方承接，要在询价回复中明确，不把全部项目自动归入普通贴片订单。

## 一、板上 48 个器件的装配责任

核查依据是当前配置、实际物料清单、坐标文件及原生 PCB（印制电路板）文件的封装焊盘。三份清单位号一致，无重复与遗漏：物料清单为 24 组、共 48 个器件，主板 46 个、扳机小板 2 个；48 个器件均从顶面安装。

| 位号 | 数量 | 型号或数值 / 立创编号 | 板与装配要求 |
| --- | ---: | --- | --- |
| C1、C2、C3、C4、C6 | 5 | 10μF / C19702 | 主板；工厂贴片 |
| C5、C7、C8、C9、C10、C11、C12、C13、C14、C15 | 10 | 100nF / C1525 | 主板；工厂贴片 |
| D1 | 1 | B5819W SL / C8598 | 主板；工厂贴片，按坐标和封装核对极性 |
| J1、J2 | 2 | XY-PM254-1-22P-Z-8.5 / C53200741 | 主板；22P 直插排母，共 44 个通孔位置由工厂焊接；两排平行、垂直、完全就位 |
| J3、J4、J5 | 3 | S2B-PH-SM4-TB(LF)(SN) / C295747 | 主板；工厂贴片，包括每个座的信号与固定焊盘；插口方向按坐标 |
| J6 | 1 | 同上 / C295747 | 扳机小板；工厂贴片，包括固定焊盘 |
| LED1 | 1 | KT-0603R / C2286 | 主板；工厂贴片，核对极性 |
| Q1 | 1 | AO3401A / C15127 | 主板；工厂贴片 |
| R1、R2 | 2 | 5.1kΩ / C25905 | 主板；工厂贴片 |
| R3、R14 | 2 | 3.3kΩ / C25890 | 主板；工厂贴片 |
| R4 | 1 | 1kΩ / C11702 | 主板；工厂贴片 |
| R5、R8、R9 | 3 | 100kΩ / C25741 | 主板；工厂贴片 |
| R6、R7 | 2 | 1MΩ / C26083 | 主板；工厂贴片 |
| R10、R11 | 2 | 4.7kΩ / C25900 | 主板；工厂贴片 |
| R12、R15 | 2 | 10kΩ / C25744 | 主板；工厂贴片 |
| R13 | 1 | 2.2kΩ / C25879 | 主板；工厂贴片 |
| SW1 | 1 | RKJXV1224005 / C146170 | 主板；工厂插装并焊好全部 14 个焊接位置，包含金属支撑脚；不能只焊信号脚 |
| SW2 | 1 | D2FC-F-7N(20M) / C5157566 | 主板；工厂插装并焊好 3 个位置；高度与朝向按封装 |
| SW3 | 1 | MSK12C02-HB / C431541 | 主板；工厂贴片，3 个电气焊盘与 4 个外壳固定焊盘全部焊好，拨柄与底部开关槽匹配 |
| SW4 | 1 | SS-01GL13 / C3822088 | 扳机小板；工厂插装并焊好 3 个位置，包括未连线的脚；杠杆型号、朝向和就位高度不可擅换 |
| U1 | 1 | LSM6DSV16XTR / C5267406 | 主板；工厂贴片，核对方向与全部引脚；不要交给用户手焊 |
| U2 | 1 | TP4056-42-ESOP8 / C16581 | 主板；工厂贴片，包括底部散热焊盘 |
| U3 | 1 | RT9080-33GJ5 / C841192 | 主板；工厂贴片，须为本版 3.3V 型号 |
| U4 | 1 | USBLC6-2SC6 / C7519 | 主板；工厂贴片 |
| USB1 | 1 | TYPE-C-31-M-12 / C165948 | 主板；12 个顶层贴片焊盘和 4 个有铜槽孔固定脚均由工厂完成，不能只回流焊信号脚 |

其中 J3～J6 在原物料清单属于同一行，表中按主板和小板职责分开，所以表为 25 行、总量仍为 48。贴片类共 42 个；纯通孔器件共 5 个（J1、J2、SW1、SW2、SW4）；USB1 是 1 个混合封装。

纯通孔器件有 64 个焊接位置，USB1 另有 4 个通孔固定脚，共 68 个需要通孔焊接的封装位置。这个数是范围核对，不是工厂最终计费焊点数。坐标文件把 USB1 标为非贴片，不应因此漏掉它的 12 个贴片焊盘；SW3 标为贴片，封装名虽含 `TH`，实际 7 个焊盘全在顶层且无钻孔，不能按 3 脚插件另加到 64 点里。

## 二、给制板与装配方的询价要求

1. 使用同一版的制板压缩包、物料清单和坐标文件；回复主板、扳机小板的实际焊接套数。电路板为两层、1.6 毫米、1oz（每平方英尺一盎司铜），当前正式版保持原无覆铜走线。
2. 文件含主板与扳机小板两款不同电路，确认拼板款数、异形外轮廓、邮票孔、工艺边、光学定位点和装配夹持方式。若需工程加工艺边，先给出修改稿；保持两块成品板的安装孔、槽口和配合板边，不可为了上机擅改成品尺寸。[嘉立创制造工艺要求](https://www.jlc.com/portal/1/serviceGuide)按板形或电路等差异计算拼板款数，并说明邮票孔分板会留下齿状边缘。
3. 按上表逐项回复“可供料并焊接 / 客供料可焊接 / 缺料 / 无法承接”，尤其单独回答 J1、J2、SW1、SW2、SW3、SW4、USB1。未选入焊接订单的器件不能按已采购或已焊接计算；官方下单说明也区分已选择的贴装和插件范围。[嘉立创贴片下单教程](https://m.jlc.com/portal/q7i19326.html)
4. 询价焊接后分板、邮票孔残余毛刺处理、清除加工粉尘和按套包装。扳机小板需要直接插入壳内卡槽，分板方法不能压弯板、划伤元件或焊点，板边不得有妨碍入槽的残余连接桥。去毛刺后的允许残余量尚需首样与卡槽配合确定，不虚构未验证公差。
5. 分板处理完后，再确认元件没有损伤、板没有翘曲，按一块主板加一块小板为一套包装；保护摇杆轴、微动杠杆和插座，不能在运输中持续顶压摇杆。Alps 原厂要求使用时焊接全部金属支撑脚，并提醒轴持续受力的包装可能影响性能。[Alps 原厂产品说明](https://tech.alpsalpine.com/e/products/detail/RKJXV1224005/)
6. 工厂的外观或焊点检查不能代替蓝牙、体感、触摸、充电和整机装配验证。若能承接烧录和功能检查，单独报工装、调试、逐台加工费用，以及客户需提供的程序和操作文件；不要把这些费用当成贴片费已包含。

嘉立创官方列有分板出货、清洁和额外包装等个性化服务，但其分板介绍不足以确认本版邮票孔处理、去毛刺、电极预装和整机装配都可承接。未列出的项目需专门询价；价格和可承接范围以本次订单回复为准。[嘉立创个性化服务说明](https://www.jlc.com/portal/q7i40512.html)

## 三、板外组件与预装责任

| 组件 | 交付要求 | 优先承接方 / 用户到手操作 |
| --- | --- | --- |
| YD-ESP32-S3 N16R8 开发板 | 两排 1×22 排针已焊好，确认本版高度、针长、针序和天线朝向；不在贴片物料清单 48 个器件内 | 首样使用用户已有件；采购或装配方确认。用户只插入 J1/J2，或由装配方先插好 |
| 电池及线束 | 3.7V、约 700mAh、带保护板；J3 的 1 脚为正、2 脚为负。交付匹配 PH2.0 的已压接插头与实测极性标签，不能仅按线色判断。含保护板、线头与固定层后适合电池仓 | 电池供应商交付成品，装配方固定和插接；用户不剪线、不改端子极性 |
| 扳机小板连接线 | PH2.0 2P 双头成品线，J4 的 TRIG/GND 与 J6 的 D_NO/D_COM 相连；这一对只连接常开机械触点，同向、反向均可。10 厘米只是首样备选，最终长度按走线测量 | 线束供应商交付，两头按用途标注；用户插 J4/J6 |
| 触摸电极线 | PH2.0 单头线接 J5，仅需一个触摸信号导体；J5 两脚均为 TOUCH（触摸信号），不是触摸与地。闲置线端绝缘，不连微动金属杠杆、地或电池 | 线束供应商或装配方预制铜箔和可靠端接；用户只插 J5 |
| 扳机、铜箔与面盖组件 | 优先交付铜箔已安装、端接已固定、面盖已粘好的组件。铜箔有效面下的铜箔和胶总厚度不能超过当前约 0.15 毫米余量；普通焊点或叠层裸线不能硬塞在面盖下。端接位置尽量放上沿导线槽，是否放得下仍需样件确认 | 装配方做首件后固定工艺，无法承接时单独询价；当前不承诺已有标准成品可买 |
| 触摸线活动段 | 导线沿既有线槽走，扳机全行程不绷紧、不进滑道、不被壳缝或螺柱夹住；端接拉力由绝缘护套固定承担，不能靠铜箔粘胶受力。现约 5 毫米余量为首样起点，线径、总长和固定位置需首件确定 | 首件由装配方确认后预装，用户避免自行剪裁和夹裸线 |
| 压缩弹簧 | 外径 4、线径 0.3、自由长 15 毫米为首样参考；现工作长度约 13.1/9.0 毫米，须供应商提供两位置载荷、材料、圈数、刚度及并圈高度（压实后的高度），确认最短工位未压实，首件再核对回弹和手感 | 采购确定规格的成品，由装配方或用户放入；批量不采用逐根剪短调节 |
| 6 个打印件 | 左半壳、右半壳、扳机、触摸面盖、右键帽、摇杆帽；成套交付，清除支撑和影响配合的残留，保留薄壁触摸盖；不因视觉模型无干涉就保证首印成功 | 打印方完成打印与必要后处理，装配方首件试装；用户不默认扩孔和打磨配合面 |
| 7 颗合壳螺丝 | M2×20 盘头自攻螺丝，与当前孔及螺柱匹配；首件确定拧紧方式，批量包装附备用件 | 用户安装或装配方合壳；不擅换为需要热熔螺母的新结构 |

电池仓当前宽 31 毫米、深 8.4 毫米；8×31×52.5 毫米只是几何占位上限。电池宽度若等于 31 毫米，名义侧向间隙为零，不能作为保证可装的采购规格；需为实物、打印误差及线头留余量。接近 8 毫米厚的电池不能再加 1～2 毫米泡棉。铜箔端接若无法进入现有导线槽，或任何预制件改变高度、接口方向和活动余量，需要反馈并局部改设计；预装服务本身不能解决尺寸冲突。

摇杆背部止推支撑与触摸端接局部避让正在作为候选单独评估，见 `docs/设计预审与优化决策-V1.md`。本说明中的现有尺寸仍是正式基线，不据此宣称候选件已经首件合格，也不自动替换原打印包。

## 四、烧录、校准和出货检查的交付请求

以下是要求承接方报价并确认的产品服务，尚未形成已经验证的逐台工艺。没有对应可用固件、测试工具和首件标准时，不能要求工厂凭硬件文件保证功能。

- 烧录资料：给出最终程序文件、版本与校验值、对应硬件版本、写入位置、工具及操作步骤。确认底部 USB1 实际可下载；若新开发板首次下载需要 BOOT/RESET（启动/复位）按键操作，应在合壳前由装配方完成，并确认后续维护方法。
- 校准资料：首件确定惯性芯片坐标映射、静止零偏处理、摇杆中心与死区、触摸基线与阈值策略；列出哪些参数逐台保存、哪些由固件自动处理。不得把某一台裸板触摸阈值复制为所有已装壳产品的合格标准。
- 合壳前检查：核对 48 个器件、焊点和机械固定；插入开发板；验证电源开关、USB 通信与下载、惯性芯片读取、摇杆双轴及按下、右键和机械扳机触点。将具体测试电压、电流和判定门限交给电气及固件首件验证后填写，不凭猜测承诺数值。
- 合壳后检查：用目标固件确认蓝牙鼠标配对；轻触扳机仅开放体感位移，继续按压触发左键，释放机械按压但保持接触时左键释放且体感继续，完全离开时体感停止；实体按键和摇杆不受触摸关闭影响，重新触摸不集中发送旧位移。再检查摇杆连续摆动与中键、右键、扳机回弹、线束未夹紧和充电口插拔。
- 电源检查：首件确认充电、电池供电、插拔 USB、低电量及系统负载下的供电与温升，确定可复用的方法。插拔 USB 不自动停用/恢复鼠标，不以这种规则绕过输入电流与散热设计；使用开发板自身 USB 的单板服务操作要先将开发板从主板排母拔出。
- 出货记录：硬件版本、程序版本、器件替换清单、烧录结果、校准方式/结果、板级及合壳后功能结果；未通过项目单列，返修后重查相关功能。若仅承接焊接，应明确写“板级焊接交付”，不能标成“整机已可使用”。

## 五、缺料与以后小批量的处理原则

首样按现有正式设计采购，不把所有器件都重新选一次。已有、可直接减轻用户工作的确定项先落实：完整工厂焊接、成品端子线、正确极性的插接电池、分板与去毛刺询价、触摸组件预装询价和逐项责任表。

缺料时要求返回原位号、原编号、候选编号、数据手册及库存/交期，经过电气、封装和机械核对后再批准。排母不能仅凭 2.54 毫米针距与 8.5 毫米高度替换；不同触点结构、壳体外形、针长和配合公差都会影响开发板及外壳。SS-01GL、SS-01GL13 不能仅因同系列就视作同一杠杆结构。GY-601N1 飞线备份属于需要手焊并重新固定模块的调试方案，不能替代缺 U1 的完整工厂交付。

RKJXV1224005 当前原厂状态为“新设计不推荐”，厂家说明该类产品仍面向既有设计供应，并非已停产。首样可沿用以保留当前封装和外壳；批量前必须确认可持续供货与替代器件。替代摇杆可能需要修改焊盘、轴高、摇杆帽、安装结构甚至局部主板，不能承诺只换一个打印支架即可。[Alps 原厂供应状态](https://tech.alpsalpine.com/e/products/detail/RKJXV1224005/)

之后的批量优化应比较整机装配用时、需手工加工的步骤、供应周期、返修更换难度和总成本。直接焊主板与独立摇杆小板、插座开发板与直接贴装模组等方案先做具体成本和受力比较，再决定是否重新制板或打印。当前不自动增加功能按键或零件，也不把“免焊”说成“免装配、无需校准、一次打印必定成功”。
