guiwushengzhe-prog/gun-mouse/shell/最终装配版/工作记录.md

# 最终装配版工作记录

## 2026-10-18

用户授权落实前轮整体重排建议并交付可打印最终版。保留摇杆、按键及电池的使用方向；八颗小元件按每行一颗、交错两组孔位集中到安装带下方。使用共用布局模块同步主板和装配外形。

局部支座固定点增加主体柱，改用第二颗M2×20。两处横向螺丝同一承压深度，普通M2螺母侧插；模块两个原生孔仍用M2×10。两柱共同承托，避免该点只夹住主板。支座内腔恢复规则形状，孔旁外壁和螺母入口加制造余量。扳机、触摸接线孔移出支座投影，导线同步移动。

初次尝试把全部受影响网络从上部重排时，摇杆与主控密集排针区的网格路由发生拥塞。改为保留已核对的上部扇出，只重排下部；分界铜线从实际铜层接入，避免在密集交叉处强加过孔。三处接地跨层连接补齐后，规则检查0错误、0未连接。后续清理了分界处无用途的短铜线。只保留既有外部封装库未配置提示，不降低铜间距或屏蔽规则。

检查中发现触摸线下移后与右键地线的横向通道接近，调整为先绕开该通道，再进入背侧走线层。最终导线、壳体、五金及焊点空间重新核对；主板制造钻孔逐个核对。旧预览、旧制造包及用户未提交的封装/场景文件保留。

完整装配仅供查看。可上传打印文件单独放在新交付目录，毫米、1:1、大平面朝下，两件独立单体，不把电子件或五金合入打印模型。首选材料尼龙PA12，制造说明与静态证据边界随文件交付。

## 2026-10-18：摇杆支座无焊点区域补平

用户指出支座底部仍有凹槽、凸台和细条，但下方没有焊盘。对照最终布局，八颗小元件已移走，旧版2.03毫米深的共用底部凹槽不再承担避让作用。本次取消该凹槽，将原螺柱周围补成同一连续平面；摇杆小板五处已焊短脚的3毫米净空及全部实际螺丝孔保留。支座外包络、螺丝位置和主板不变。

更新后支座体积3008.569立方毫米，增加约425.85立方毫米材料。补平区域缺料体积为零；原132处主板正反面焊点包络、五处摇杆短脚、螺母入口、十处工具通道和导线空间复核通过。两件打印网格仍各为封闭单体。重新导出打印件、完整装配、配套截图及交付压缩包；主板制造文件未改。以上仍为静态模型检查，未进行实物试装或承载验证。

## 2026-10-18：主板切换嘉立创原生维护

用户要求这次主板和后续设计统一使用嘉立创软件，本次用于优惠券下单，并明确无需继续询问，改好后直接交付。使用本机嘉立创EDA专业版4.1.66，以当前最终板作一次迁移基准，后续唯一编辑源为“pcb/嘉立创最终版/枪型飞鼠最终版.eprj3”及其同目录板文件。旧软件源文件和旧制造文件移入交付目录的“迁移前对照”，保留历史比较用途。新增项目维护约定，旧打包脚本遇到原生工程时停止，防止旧制造文件覆盖当前交付。

通过官方命令行后台会话创建原生工程，使用软件自带导入接口迁入完整主板，在软件内恢复原有0.25毫米铜间距、0.5毫米铜到板边间距及原有过孔规则，再用原生计算器重建双面铺铜。未关闭设计规则或忽略未连接。主板仍为26个器件实例、83个焊盘及固定孔、18个过孔、14个网络。

迁移工具未完整带入芯板厚度。物理层叠配置接口没有返回可用的配置，因此读取本机新建双层板的实际模板作依据。该4.1.66版本原生物理层厚度记录使用毫英寸，与在线新版文档说明不同；按本机模板补齐芯板后，总层叠1.6000476毫米、双面铜厚约0.035毫米。公开修改文档源码接口不会可靠保留全部物理层叠，最终改为关闭会话后只修改原生主板的芯板厚度字段，再由嘉立创重新打开、铺铜和检查。

编辑器整理原有交叠短铜线时发现摇杆纵轴的一段连续竖线缺失。保留两端现有走线，从软件读回端点，用原生走线接口恢复7.62毫米的连续线段，重新铺铜后严格检查无错误、无未连接。该修复不移动任何焊盘、孔或元件。

最终逐项比对83处孔位和网络；软件焊盘坐标读回的最大轴向舍入差0.00126毫米。原生制造输出的89个金属化孔、12个非金属孔及6个槽孔与原配套文件一致，坐标及孔径最大数值差0.000002毫米，板框中心线一致。打印件和现有结构装配位置未改；旧装配视图的铜层仅用于结构查看，当前制造以嘉立创重新铺铜的结果为准。

本机文件保存接口曾返回成功而磁盘没有产物，故改为从嘉立创返回文件字节，再在本机写入并校验实际文件。最终打板包保留七个制造层和两份总钻孔表，共九个文件；软件另附的过孔钻孔表与总金属化钻孔表重复，不重复提交。提供文件夹原生工程、官方工程备份及配套压缩包，仍未进行实物装配或通电验证。

## 2026-10-18：从空白嘉立创板重新设计并完成交付

用户上传前轮包后，平台提示“-27（非EDA设计文件）”。用户澄清真正目的为用嘉立创将原最终版重新做一遍，并指定完成后由用户自己到平台确认优惠券。前轮整板迁入嘉立创的方案不满足本次目的，不能将原生重新导出或通过软件检查表述为平台已经认可。

本轮用本机专业版4.1.66公开接口创建独立单文件工程与空白主板，依照已冻结的最终版机械孔位和电气网络建立83个原生焊盘及固定孔。没有导入旧整板、旧走线、过孔或覆铜。仅复用封装库的临时样本最终已移除；当前主板使用独立原生焊盘，没有关联器件实例或配套原理图。这一点已写入工程和交付说明，后续按焊盘与网络维护。

文件夹工程及库器件关联接口在本机有空文档、路径和读取等待问题，最终采用正常落盘且可重开的单文件`.eprj2`。不再反复调用曾卡住的自动布线命令；直接根据新板实际焊盘和净空计算新路径，再由嘉立创接口逐项创建。补地线时发现摇杆信号扇出围住地焊盘，局部重排纵轴信号后地线连通；双面地铜由嘉立创计算。最终保存走线835段、过孔32个，保存重开后检查0错误、0未连接。

制造核对保持原52×82毫米板框，71个金属化焊孔、12个非金属化孔逐一匹配，包含原6个槽孔。数值坐标或孔径最大差0.00126毫米，属于毫英寸读回舍入。14个网络与55个连接引脚逐一匹配。新增32个过孔随本次布线生成，制造总孔数115；官方附带过孔专用表是总金属化钻孔表子集，不重复计数。物理叠层1.6000476毫米、双面铜厚约35微米。两件打印文件校验值不变。

新增打包脚本先验证原生读回、保存重开、官方工程备份、机械孔位、网络和打印件校验值，再更新交付。保存重开存在约0.00000126毫米的浮点舍入；官方工程备份另保留已删除铜区的历史缓存，只比较仍关联有效铺铜区的缓存。上传包保持嘉立创导出原包字节，未再剥离或重压缩制造内容。旧整板迁移交付归档，当前编辑源改为“pcb/嘉立创最终复绘/枪型飞鼠最终原生复绘.eprj2”。交付文件和完整包均已更新；平台优惠资格由用户验证，未进行实物试装或通电。

## 2026-10-19：用户确认已下单并要求推送

用户说明之前的最终版模型与本次打板文件均已下单，并要求推送。再次核对两个STL、上传打印压缩包、上传打板压缩包及配套原生工程，与交付提交5e1fb45中的文件字节一致。新增已下单记录，写明相对路径、文件大小和SHA256（文件内容校验值），后续设计修改另建交付版本，保留这次下单文件用于到货试装追溯。

用户之前提到网页“不支持GTL”，后续截图确认是三维打印上传入口；该页面应使用两件外壳STL。格式排查时只额外读取原生主板并生成默认导出的临时记录，没有替换正式制板包或修改设计；排查会话已关闭。用户确认的是已下单状态，优惠券是否使用成功未作推断。
