guiwushengzhe-prog/gun-mouse/release/2026-10-18-最终版/下单与装配说明.md

# 枪型飞鼠最终版：下单与装配

本套文件将八颗小元件移出摇杆安装带，并为摇杆支座增加第二根直通主体的支柱。主板、孔位、铜线、焊点、导线及两件壳体使用配套布局。

主板已在嘉立创专业版中从空白板重新绘制焊盘、网络和走线，由嘉立创重新铺铜、检查并导出制板文件。后续统一在嘉立创中维护。原整板迁移方案曾被平台提示“非EDA设计文件”，该方案已归入“电路板/迁移前对照/旧整板迁移版”，仅供历史比较。

摇杆支座底部已取消元件移走后多余的约2毫米深大凹槽，补成连续平面。仅保留摇杆小板已焊短脚的3毫米避让及实际螺丝孔；对应主板和固定孔位沿用原最终版。

## 上传打印

只上传“三维打印”目录中的两个独立文件，均为毫米单位、1:1比例，各打印一件：

- 主体底座.stl
- 摇杆支座.stl

“枪型飞鼠_最终版_上传打印.zip”只包含这两个STL（打印模型文件）。如果平台只接受单件模型，就分别上传两个STL。模型已按大平面朝下摆放，打印服务可根据其工艺调整摆放和支撑。工程实体文件同目录保留，坐标用于装配。

我的首选是尼龙PA12（聚酰胺12），原色或不影响配合尺寸的表面处理。它适合支座、壳体等结构用途；本次文件以它作为优先下单材料。依据：[嘉立创PA12材料说明](https://jlc3dp.com/help/article/pa12-hp-nylon)。打印服务仍需按其设备处理支撑、清粉和清孔。

模型采用M2螺丝通孔，不依靠直接打印M2内螺纹；普通M2螺母承担螺纹连接。螺丝通孔以2.4毫米为主，摇杆模块一处采用短槽留装配余量。打印件的制造尺寸误差不能用静态模型消除，收到后应先空穿螺丝、放入螺母再装电子件。不要强行顶着元件或软包电池压装。

## 上传打板

上传“枪型飞鼠_最终版_上传打板.zip”。该包与嘉立创官方导出的原始压缩包字节一致，包含七个板层文件、金属化及非金属化总钻孔表、过孔专用钻孔表和官方说明。过孔专用表是总金属化钻孔表的子集，不是额外32个孔；软件原包完整保留。

原生工程位于“电路板/嘉立创原生重绘/枪型飞鼠最终原生复绘.eprj2”，为单文件工程。另提供“枪型飞鼠_嘉立创原生工程.zip”及同目录官方工程备份“枪型飞鼠_最终原生复绘.epro2”。打开后选择“枪型飞鼠最终主板”；PCB1和初始原理图是软件新建工程的空白占位。

本板按独立原生焊盘及网络重新绘制，没有关联器件实例及配套原理图，后续修改需按焊盘和网络维护。本次没有导入旧整板、旧走线或旧覆铜。优惠券能否使用，按用户要求由用户自行到平台确认；软件原生检查通过不代表平台已经认可优惠资格。

- 双层玻璃纤维树脂基板，板厚1.6毫米。
- 双面铜厚各35微米，按1盎司铜下单。
- 板外形52×82毫米，保持原外形。
- 手焊裸板，不需要工厂贴片或钢网。

这块主板与当前打印件配套。不要混用此前“结构简化版”或“长方条正式预览”的制造包。

## 螺丝与螺母

| 用途 | 螺丝 | 数量 | 螺母 |
| --- | --- | --- | --- |
| 摇杆小板固定到长方条支座 | M2×10 | 2 | 普通M2，2个 |
| 扳机开关 | M2×10 | 2 | 普通M2，2个 |
| 右键开关 | M2×10 | 2 | 普通M2，2个 |
| 长方条、主板与主体上部两柱共用 | M2×20 | 2 | 普通M2，2个 |
| 主体与主板下部两点 | M2×20 | 2 | 普通M2，2个 |
| 合计 | M2×10共6颗，M2×20共4颗 | 10 | 普通M2共10个 |

不需要M2×12，也不要求新增垫片。模型按螺母对边4毫米、厚1.6毫米，圆柱螺丝头直径约4毫米、高2.1毫米、1.5毫米内六角建模。上部两柱的螺母由侧面装入；螺杆超出螺母约0.6毫米。

## 装配顺序

1. 打印件清理完成后，先检查孔和螺母入口，试放五金。保留电池托根部的连续筋和绑带通道。
2. 主板与小模块先完成焊接和检查。主板焊点以最高4毫米、另加0.5毫米空间余量核对；原生摇杆小板的已焊短脚留3毫米净空。
3. 将上部两颗M2螺母从主体柱侧面放入，按键的四颗螺母也先装入相应侧槽。电子件与线束按完整装配图定位。
4. 摇杆小板用两颗M2×10固定到长方条。将长方条、主板、主体的上部两孔对准，两颗M2×20由长方条外侧穿入。两处孔都具有主体柱承托，不再只靠主板作背板。
5. 主体下部两处用M2×20固定，螺母在主板操作面。全部螺丝先松配对位，再均匀轻锁，避免把主板压弯。
6. 扳机和右键分别以两颗M2×10穿过开关固定到主体。导线经过预留空间，不夹在接触面中。
7. 电池放入托架，以原有软绑带轻固定；绑带用于防脱，不勒压软包电芯。合装后再检查拨动开关、摇杆活动和接口插拔。

装配查看目录中的“第二代完整装配.obj”及同名材质文件放在一起打开。完整装配包含主板、元件、导线和五金，只供查看，不能整体打印。

## 核对记录与范围

两件壳体均为有效单实体，独立打印网格封闭；主板焊孔、网络、主体柱、螺母侧入口、十处工具通道、名义摇杆活动空间、USB插头通道和导线空间均有静态核对记录。制造钻孔中心、孔径和槽孔已与实际主板比对。

嘉立创重绘后重新核对全部83个焊盘及固定孔的坐标和网络、115个制造钻孔和板框中心线，其中71个金属化焊孔、12个非金属化孔保持配套布局，32个过孔随新布线生成。制造孔位或孔径与基准的最大数值差为0.00126毫米，来自毫英寸坐标舍入。双面铺铜由嘉立创重建，保存并重新打开后，原生设计规则检查仍为0错误、0未连接。两件打印文件校验值保持不变。原装配模型的铜层仅用于结构查看，当前电路制造以嘉立创重绘结果为准。

本套是我建议可直接上传制造的最终工程文件。已完成文件和模型检查，未进行实物试装、承压及通电；首件仍需按上述步骤试装。下单不等于整机已完成实物验证。
