guiwushengzhe-prog/gun-mouse/release/2026-10-18-结构简化版/下单与装配说明.txt

枪型飞鼠：2026-10-18 结构简化版

本版主板孔位已有调整，请将本目录内的电路板和两个打印件配套使用。
上一版release/2026-10-18仍保留作历史记录，不要将旧板配本版外壳。

一、下单文件
电路板：电路板/枪型飞鼠_结构简化版_上传打板.zip。
双层玻纤裸板，厚1.6毫米，每面铜厚35微米，最大板框52×82毫米；元件自己焊接。
保留制造文件中的非镀孔和槽孔，表面处理与板色在下单页选择。
打印：三维打印/主体底座.stl、三维打印/独立摇杆支座.stl，各1件，单位毫米，1:1。
主体外形43.7×125×16.07毫米；独立支座外形33.95×12.1×9.07毫米。
不要缩放，不要将完整装配模型整体打印；材料收缩、支撑及孔公差由打印方确认。

二、本版结构变化
主体从连续护板、规则直柱与电池托重新构造，去掉历史切削留下的小三角、柱侧月牙及窄台阶。
电池底挡改成连续1.5毫米厚板，根部改连续斜坡；外缘按需要保留圆角。
摇杆独立支座向H3延长，1.3毫米薄连接耳由H3的M2×20螺丝夹紧。
原两颗就近螺丝减为一颗，取消H_JOY_LOCAL_1孔，保留H_JOY_LOCAL_2。
H3螺丝头承压面为装配Y=-18，螺母垫在连接耳上；螺杆超出普通M2螺母0.73毫米。
主体三孔装配坐标X/Z：H3=(-51,-4)、H4=(-27,-38)、H5=(-51,-38)，为矩形三个角。
侧壁两组圆角孔用于穿软绑带固定电池，保留；绑带跨侧梁，不勒紧软电芯。
黄色触摸线改走护板内侧空隙，原长沟槽已去掉。完整装配模型包含本版线的建议路径。

三、紧固件及安装
M2×20螺丝3颗：主体H3/H4/H5，其中H3同时固定摇杆支座。
M2×10螺丝7颗：左弹片按键2、右键2、摇杆小板2、独立支座就近固定1。
普通M2螺母10颗；按键不加垫片，不需要M2×12。
先将摇杆小板固定在独立支座上，排针插入主板，再放好主体并松装H3共用螺丝和螺母。
松装另一颗支座固定螺丝与H4/H5，确认模块、导线和连接耳贴合后轻拧固定，不用螺丝强压纠偏。
左扳机螺杆超出螺母0.60毫米，右键0.70毫米；二者无顶底，槽前壁均1.3毫米。

四、接线与供电
右键为SS-01直压开关，只接公共端和常开端，常闭端不接。
左键为SS-01GL弹片开关，只接公共端和常开端。
低电自动休眠与外部供电识别已取消，电压分压仅保留电量估算。
使用带保护的单节锂电池；开发板充电增强焊桥保持断开。
接电脑前关闭电池开关；充电用已通电的USB墙充，断开墙充前先关闭电池开关。
这是现用开发板的电源路径限制。本包不含固件。

五、检查边界
电路板0电气/几何错误、0未连接；另有22条外部封装库未注册提示，板内封装和制造图层完整。
导出钻孔已逐个核对，含84个镀孔和12个非镀孔；两打印件均单实体闭合网格。
器件/导线/五金与打印件无体积重叠，十处螺丝工具入口及四处按键螺母侧插通道已检查。
上述为名义几何和电路静态检查，不替代实物试装、焊接、通电和承压验证。
