guiwushengzhe-prog/gun-mouse/release/2026-10-18/下单与装配说明.txt

枪型飞鼠：2026-10-18 首件打样交付

一、电路板
上传“电路板/枪型飞鼠_新版电路板_上传打板.zip”。
双层玻纤板，厚1.6毫米，每面铜厚35微米，板框最大尺寸52×82毫米。
仅制作裸板，元件自己焊接；保留文件中的非镀孔与槽孔，不要改成普通圆孔。
表面处理、板色在下单页选择。源文件及规则检查记录放在电路板目录。
检查为0电气/几何错误、0未连接；另有22条外部封装库未注册提示，板内封装完整，不影响本包制造图层。

二、三维打印
分别上传“三维打印/主体底座.stl”和“三维打印/独立摇杆支座.stl”，各1件。
单位为毫米，按1:1打印，不缩放，不合并两件，不把完整装配模型整体打印。
主体底座名义外形43.7×125.0×16.07毫米；摇杆支座约26.7×12.1×9.07毫米。
已核对实体、闭合网格、装配干涉及关键螺丝/螺母通道；没有进行实物承压测试。
打印公差、收缩及支撑处理由打印方按材料确认。装配前清理孔口，螺丝不可强拧挤压电路板和电池。

三、紧固件
M2×20螺丝：3颗，主体与主板三个固定点。
M2×10螺丝：8颗，左侧弹片扳机2颗、右键2颗、摇杆小板2颗、摇杆支座与主板连接2颗。
普通M2螺母：11颗。
左侧弹片扳机不加垫片，开关背面由支座直接承托，螺丝头直接压住开关壳体。
两颗左扳机螺杆在模型中超出螺母0.60毫米，距孔底2.34毫米；右键分别为0.70和0.40毫米。
两侧螺母槽前壁均为1.3毫米，右键孔底封底为1.3毫米。

四、器件与接线
当前右键使用SS-01直压开关，公共端与常开端分别接地、右键信号；常闭端不接。
当前左键使用SS-01GL弹片开关，只接公共端与常开端。
当前摇杆使用弯针模块；主板上的另五个焊孔与四个固定孔仅为以后改直针的备用位。
手焊小件共8颗：3.3千欧电阻1颗、510欧电阻1颗、100千欧电阻2颗、100纳法电容4颗。
电池电压分压用于电量估算；低电自动休眠和外部供电识别已取消。
本包不包含固件，不要把仓库历史固件文件视为此次交付。

五、开发板供电限制
必须使用带保护的单节锂电池；开发板的充电增强焊桥保持断开。
接电脑烧录前关闭电池开关；拔掉电脑连接后再打开电池开关。
充电使用已通电的USB墙充，电池开关打开才能充电；断开墙充前先关闭电池开关。
这是现用开发板共享电池/USB电源路径的限制，载板不能消除它。

六、验证边界
本批文件用于首件打样。电路板规则检查与模型检查不能替代实物尺寸、焊接、通电和承压验证。
