guiwushengzhe-prog/gun-mouse/shell/最终装配版/最终版截图.html

# 最终版装配与独立壳件

当前布局与制造文件配套；模型静态核对通过，尚未完成实物试装。完整装配只供查看；上传打印使用交付包里的两个独立STL文件。

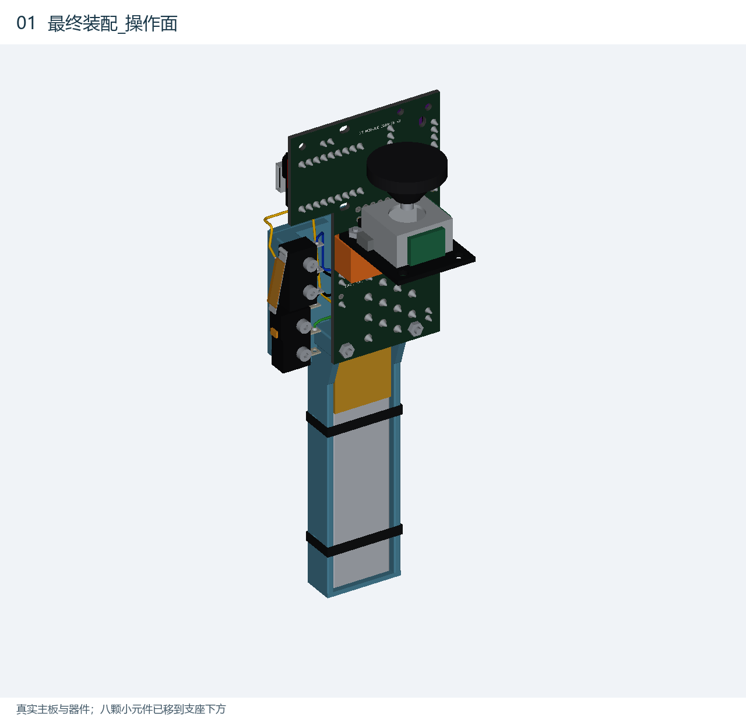
[picture p95: shell/最终装配版/多角度检视/01_最终装配_操作面.png]


01_最终装配_操作面



02_最终装配_元件面

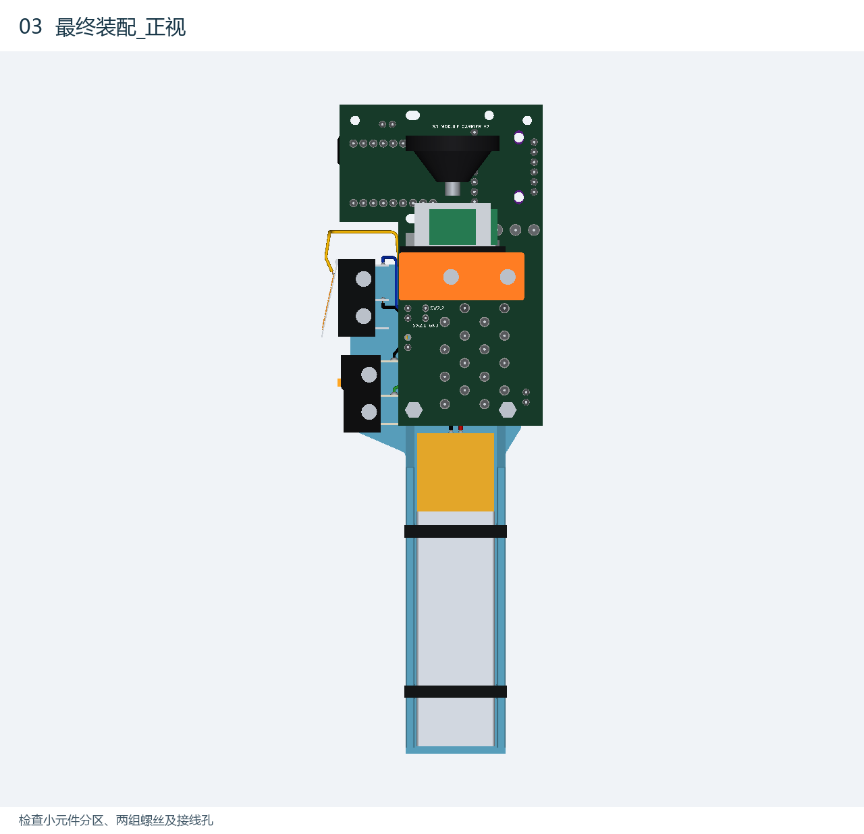
[picture p96: shell/最终装配版/多角度检视/03_最终装配_正视.png]


03_最终装配_正视

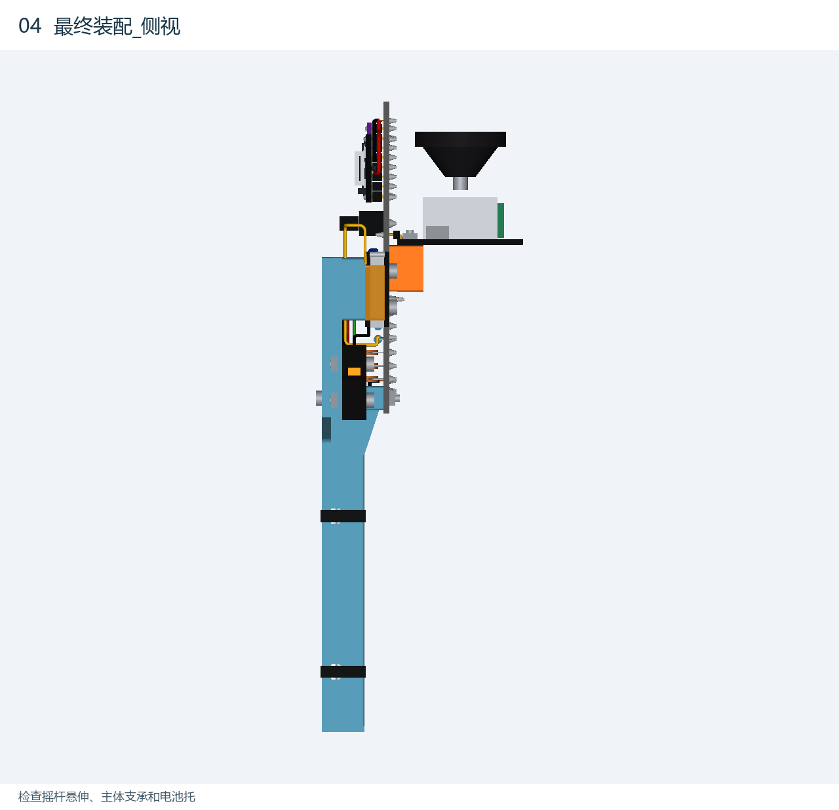
[picture p97: shell/最终装配版/多角度检视/04_最终装配_侧视.png]


04_最终装配_侧视



05_两件壳体与主板



06_主体底座_内侧



07_主体底座_外侧



08_主体底座_正视

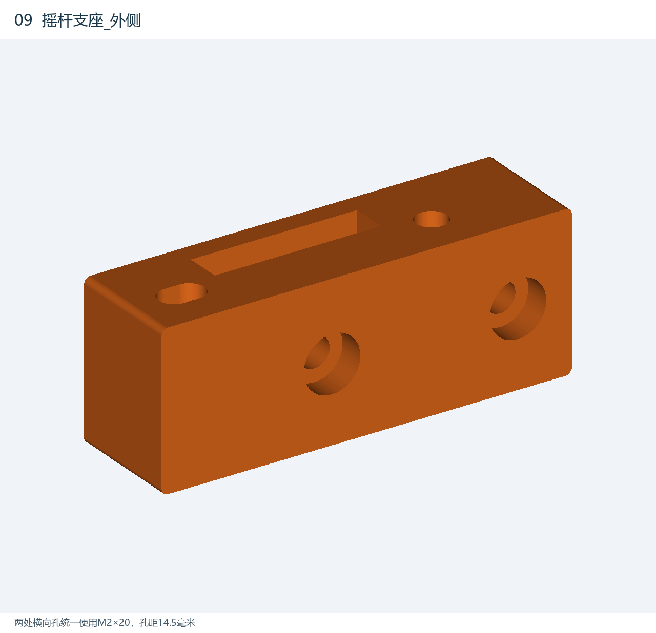
[picture p98: shell/最终装配版/多角度检视/09_摇杆支座_外侧.png]


09_摇杆支座_外侧

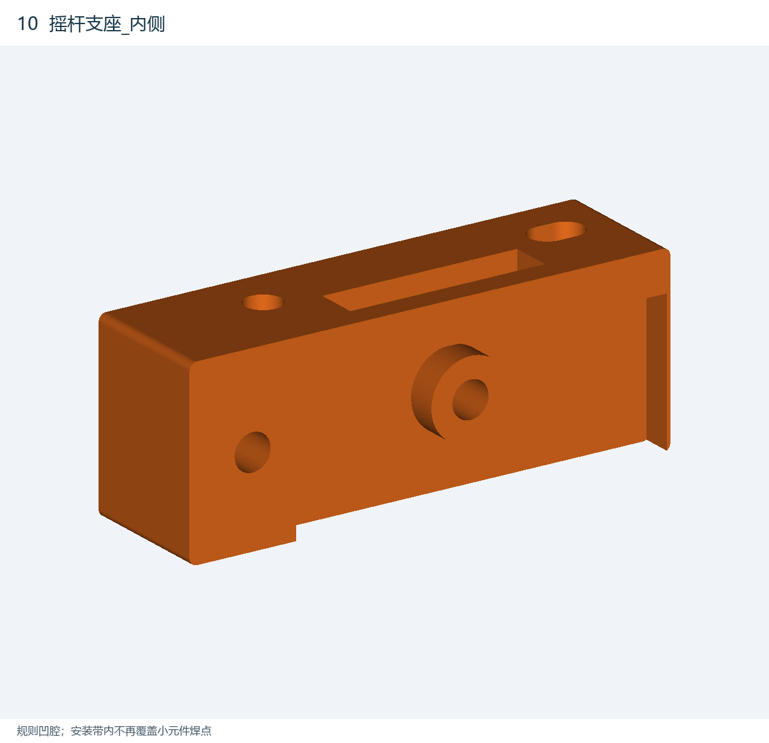
[picture p99: shell/最终装配版/多角度检视/10_摇杆支座_内侧.png]


10_摇杆支座_内侧

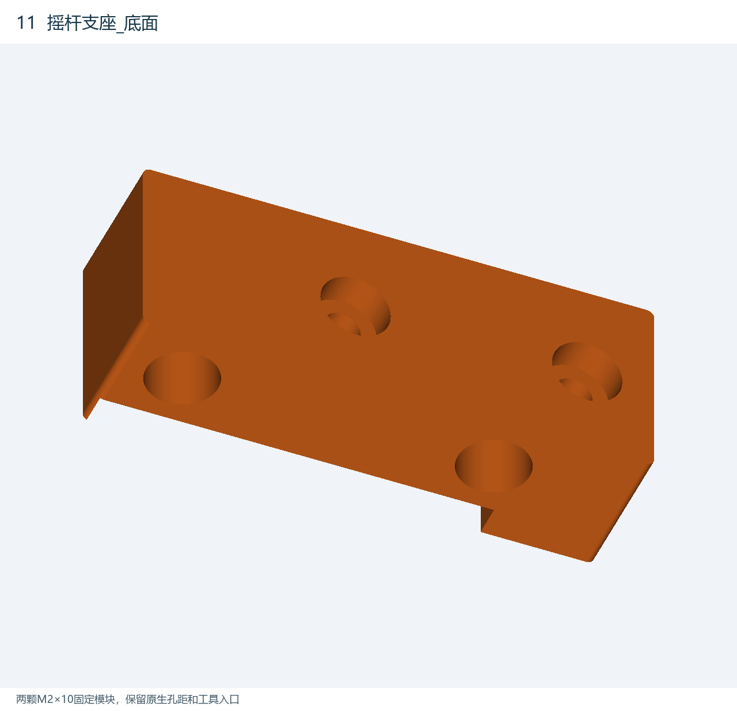
[picture p100: shell/最终装配版/多角度检视/11_摇杆支座_底面.png]


11_摇杆支座_底面

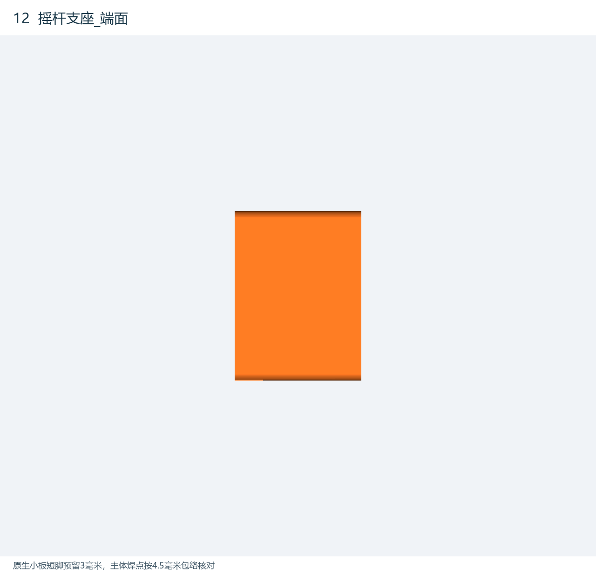
[picture p101: shell/最终装配版/多角度检视/12_摇杆支座_端面.png]


12_摇杆支座_端面
