guiwushengzhe-prog/gun-mouse/deliverables/经济型单板自焊版/GY模块适配说明/GY模块局部装配.png

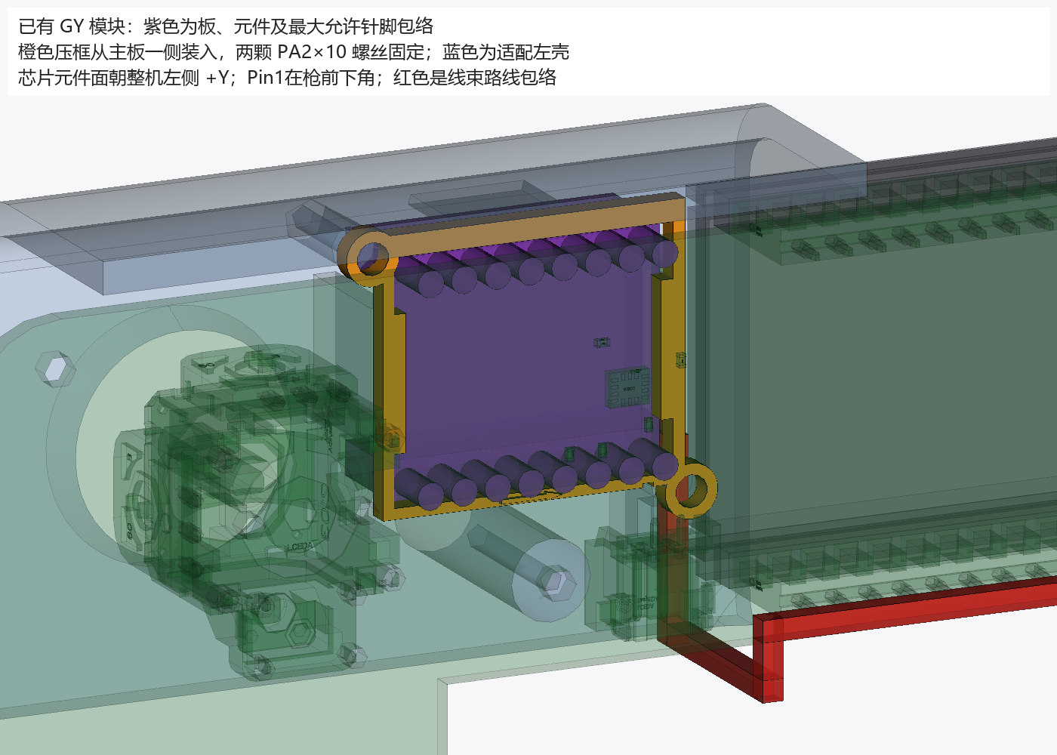
deliverables/经济型单板自焊版/GY模块适配说明/GY模块局部装配.png
