guiwushengzhe-prog/gun-mouse/experiments/30g-onepiece-test-shell/generated/renders/assembly-front.png

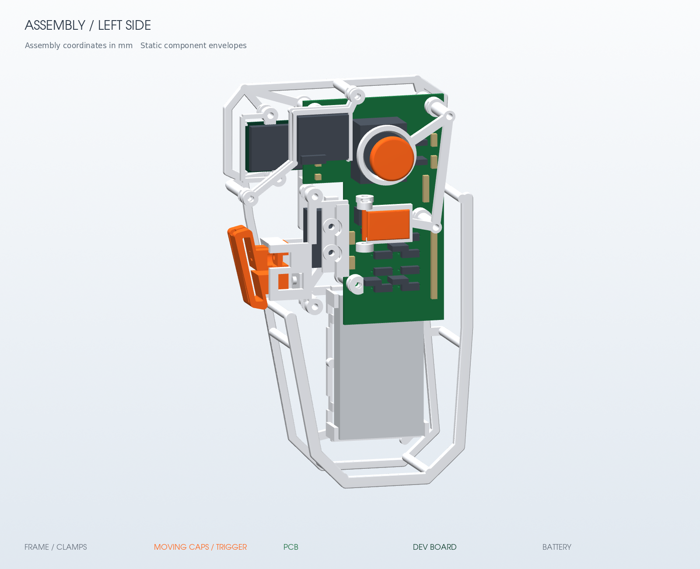
experiments/30g-onepiece-test-shell/generated/renders/assembly-front.png
