guiwushengzhe-prog/gun-mouse/release/2026-10-18-最终版/装配查看/多角度检视/10_摇杆支座_内侧.png

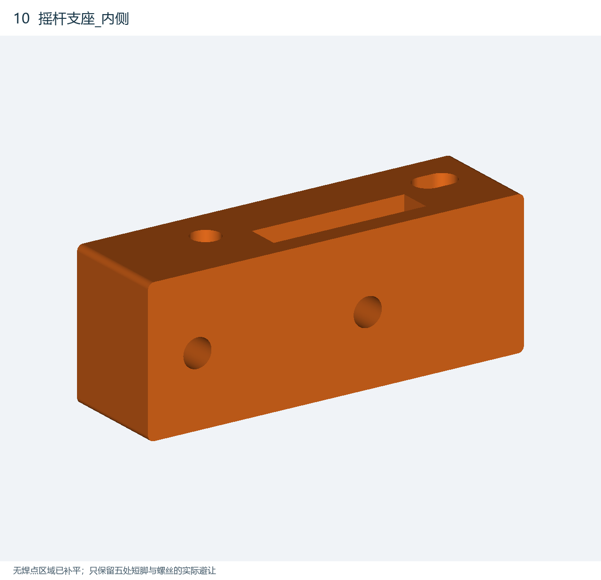
release/2026-10-18-最终版/装配查看/多角度检视/10_摇杆支座_内侧.png
