guiwushengzhe-prog/gun-mouse/release/2026-10-18-最终版/装配查看/多角度检视/最终装配总览.png

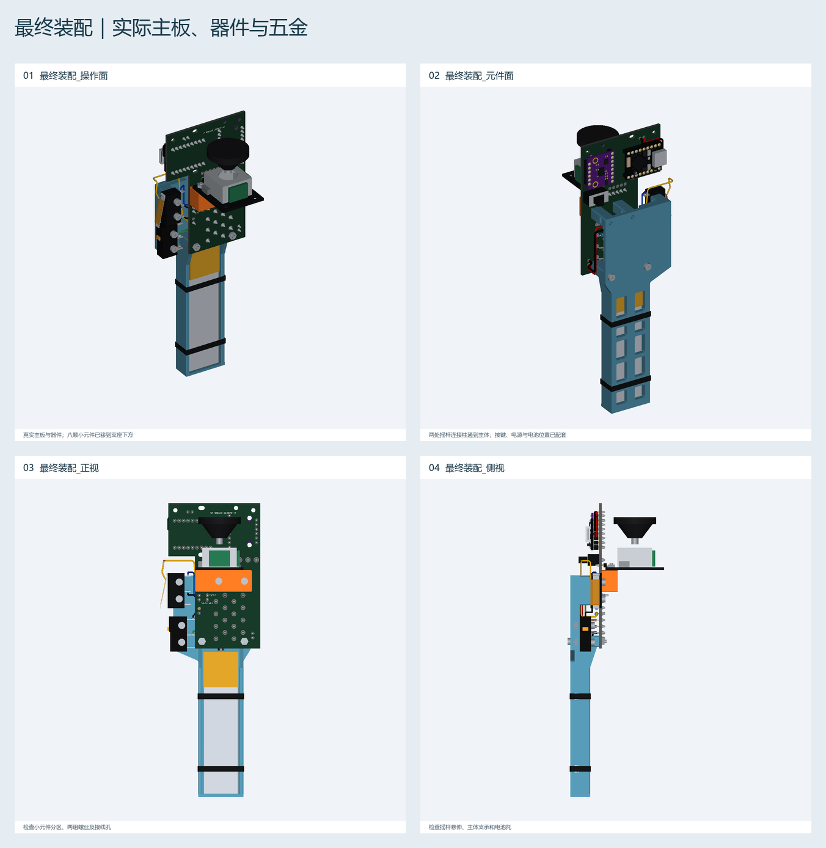
release/2026-10-18-最终版/装配查看/多角度检视/最终装配总览.png
