guiwushengzhe-prog/gun-mouse/shell/renders/gen2-assembly.png

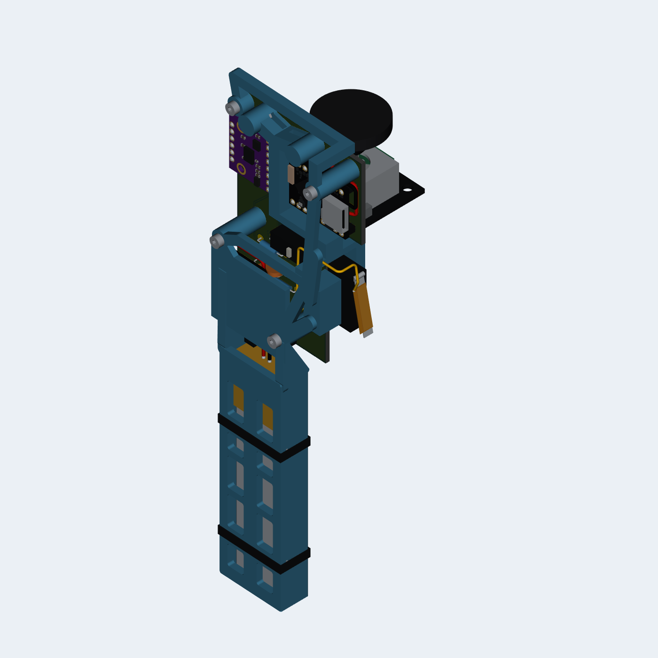
shell/renders/gen2-assembly.png
