guiwushengzhe-prog/gun-mouse/shell/快速结构预览/renders/gen2-assembly.png

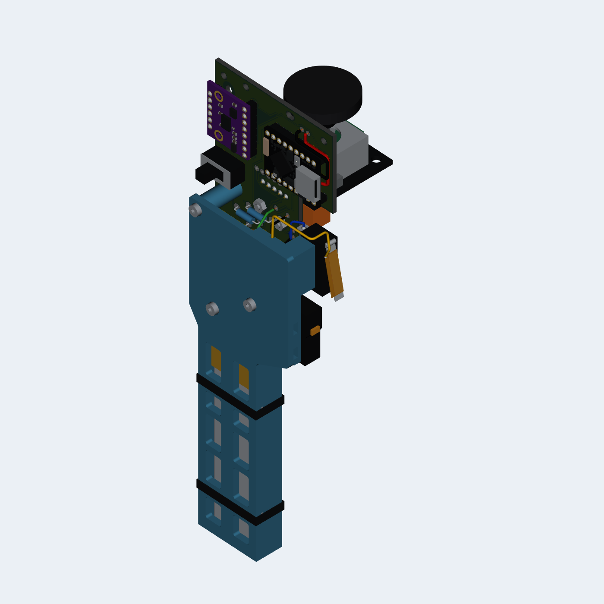
shell/快速结构预览/renders/gen2-assembly.png
