guiwushengzhe-prog/gun-mouse/shell/最终装配版/多角度检视/最终两件外壳.png

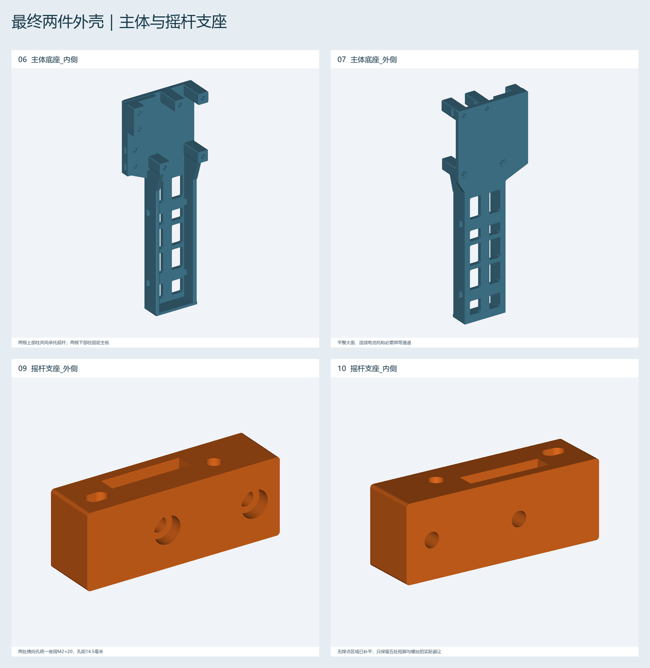
shell/最终装配版/多角度检视/最终两件外壳.png
