guiwushengzhe-prog/gun-mouse/shell/长方条正式预览/多角度检视/06_完整装配_顶部视图.png

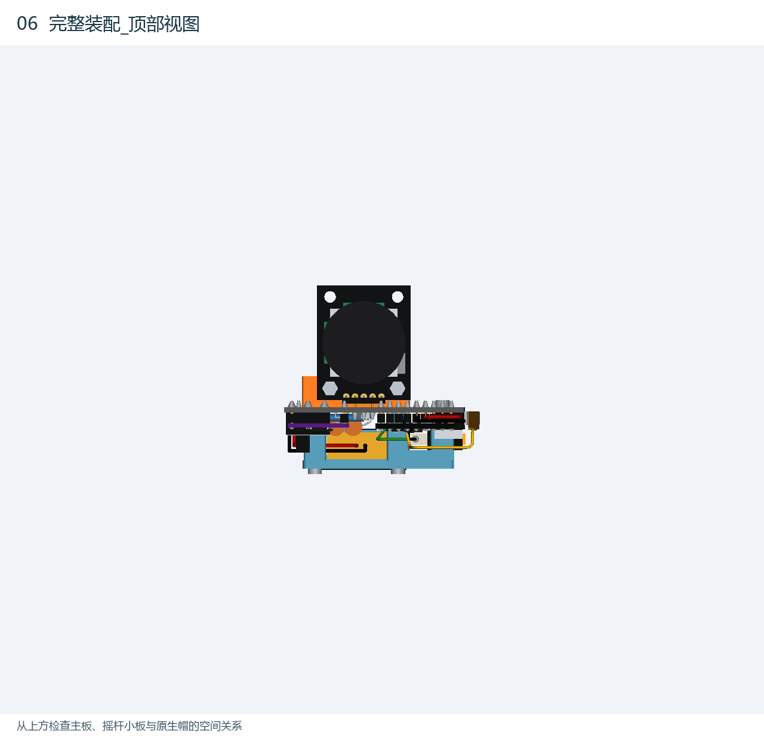
shell/长方条正式预览/多角度检视/06_完整装配_顶部视图.png
