guiwushengzhe-prog/gun-mouse/shell/长方条正式预览/多角度检视/09_上部装配_摇杆与焊点.png

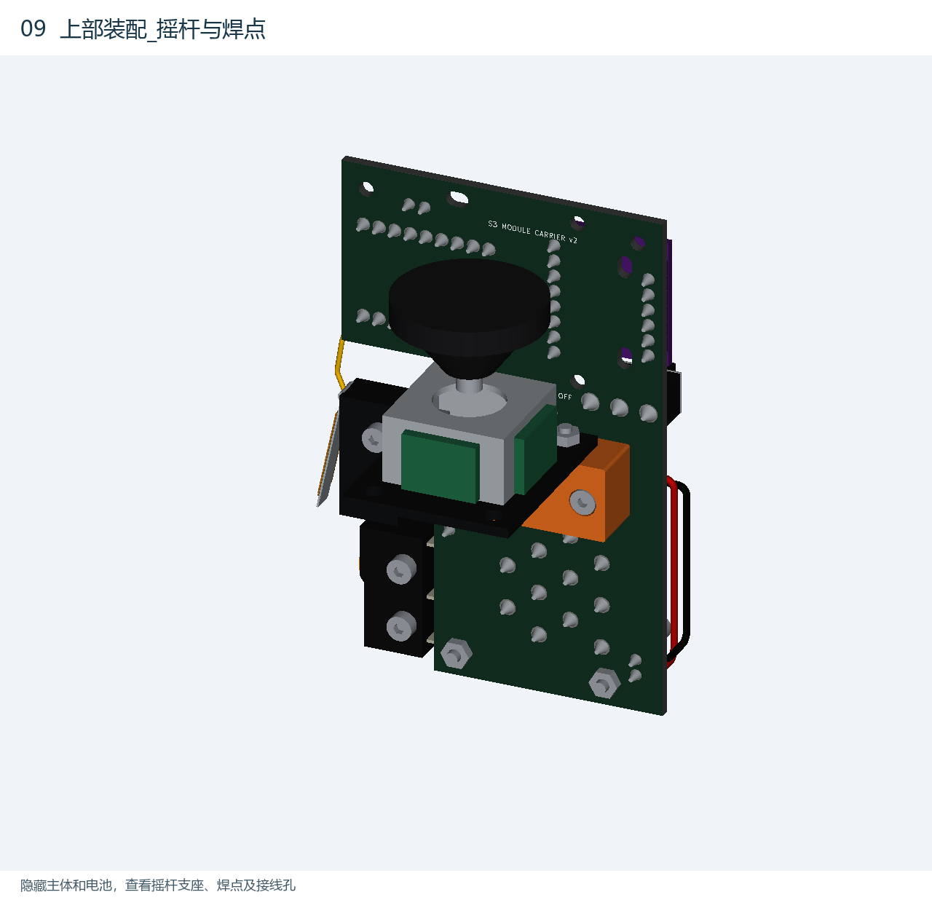
shell/长方条正式预览/多角度检视/09_上部装配_摇杆与焊点.png
