guiwushengzhe-prog/gun-mouse/experiments/30g-onepiece-test-shell/procurement.md

# SuperMini 自焊版采购与下单

先按 `pcb/BOM.csv` 点元件，并对照模块实物尺寸。载板只订裸 PCB，再人工焊接；模块采购与树脂打印分别下单。

## 载板与电气元件

| 项目 | 每套 | 规格与核对点 |
| --- | ---: | --- |
| 手焊载板 | 1 | 52×82 mm 凹口轮廓，2 层 FR4，1.6 mm、1 oz，无铅喷锡或 ENIG；4 个 Ø2.4 安装孔。上传 `pcb/` 生成的 Gerber / drill 文件，参数见 [PCB 制造说明](pcb/PCB-manufacture-notes.md) |
| ESP32-S3 SuperMini | 1 | TENSTAR 双排各 9 引脚、23.5×18 mm，芯片 ESP32-S3FH4R2、4 MB Flash、2 MB QSPI PSRAM。实物需与研究资料的 USB、天线、BAT 和针脚一致 |
| GY-601N1 / LSM6DSV16X 模块 | 1 | 按载板接线表焊 3.3V、GND、SDA、SCL；本轮 CAD 夹距按 PCB 厚 1.2 mm，实物外形、板厚与焊点突出量先测量。其他板厚需调整夹持高度并试配，不强拧弯板 |
| Alps 摇杆 | 1 | `pcb/BOM.csv` 指定 RKJXV1224005；核对引脚、安装方向和轴削边，不使用针脚不同的模块替代 |
| 右键开关 | 1 | `pcb/BOM.csv` 指定 D2FC-F-7N(20M)，1 脚 COM / GND、2 脚 NO / BTN_R；第 3 脚为机械 dummy 脚，留独立空网，不当作 NC |
| 扳机开关 | 1 | **Omron SS-01GL13 焊片版**，不带 `-2`。装在独立打印支架，焊公共端 COM 与常开端 NO 两根线 |
| 直插轴向电阻 | 8 | 3.3kΩ 三枚、510Ω 一枚、100kΩ 四枚（100kΩ 建议 1%）；本体不超过 Ø2.6×6.4 mm，弯脚间距 7.62 mm |
| 100nF 直插陶瓷电容 | 7 | 脚距 2.54 mm，本体宽不超过 6、厚不超过 2、安装高度不超过 7 mm。C_RAIL 焊前成形，本体向 -X 偏至少 0.3 mm，避开 H4 螺母 |
| 外置电池开关 | 1 | 成品带线、两个稳定档的机械 SPST，DC 额定电流不低于 0.5A；含绝缘本体最大 20×10×8 mm，串接 `BAT_RAW -> BAT_SW`。用两根扎带绑在后底梁外侧，避开电池并为导线卸力。载板 BOM 只含 `J_SWITCH` 焊线孔；该外置开关尚未建模，实际固定和线束弯折由首样核定 |
| 1S 锂电池 | 1 | 3.7V、带过充/过放/过流保护、约600–700mAh；含外皮、保护板与线头最大 8×31×52.5 mm。原 603048 可作为尺寸参考，不能按型号名判断可装入或允许充电电流 |
| 细柔性导线 | 按接线图 | 与配置的线束包络一致，焊后绝缘；扳机触摸线预留全行程活动余量 |
| 触摸铜箔与薄胶层 | 1 套 | 装入扳机凹槽和端接避让腔，面盖下使用薄胶层 |
| 薄型软绑带与小扎带 | 按固定点 | 电池用薄软绑带防翻出，只约束移动、不挤压电池；外置 SPST 另用两根小扎带绑在后底梁外侧。SuperMini 与 GY 的防脱由各自板边止挡和螺钉压框承担 |

GPIO 和固件上电流程见 [firmware/README.md](firmware/README.md)。当前载板配置采用参考板的 100 mA 充电档，保持 BOOST 开放；板载充电电路的实际芯片和设定电流仍按选购的 SuperMini 实物与电池规格核对。固件的外部 5V 判断不是充电中或充满检测。

## 机械紧固件

仅使用此前的 **M2×10 和 M2×20 杯头内六角机螺钉**及标准 M2 六角螺母。长度从头下量，不将杯头高度算入 10 / 20 mm。

| 位置 | M2×10 | M2×20 | M2 螺母 |
| --- | ---: | ---: | ---: |
| 主载板四点固定（H2、H3 共用控制压桥） | 0 | 4 | 4 |
| 扳机侧门 | 2 | 0 | 2 |
| SuperMini 压框 | 2 | 0 | 2 |
| GY 模块压框与独立托座 | 2 | 0 | 2 |
| SS-01GL13 打印夹座 | 0 | 2 | 2 |
| 右键帽防脱挡杆 | 0 | 1 | 1 |
| 扳机触点调节与双螺母锁紧 | 1 | 0 | 2 |
| **每套合计** | **7** | **7** | **15** |

杯头按 Ø4.0×2.1 mm、螺母按对边 4.0×厚 1.6 mm 包络复核，到货后测量再试装。所有螺纹连接使用机螺钉和金属螺母；打印件不要求攻 M2 牙。

SS-01GL13 支架另备 M2 薄平垫（内径约 2.2、外径约 5、厚 0.3 mm）：名义每孔每侧两片，共八片，建议购买十几片。另备 0.1 / 0.2 mm 薄垫或绝缘调整片，按实测开关与夹腔的间隙组合填平；两孔同侧垫片厚度保持一致。垫片是金属或独立调整材料，不计入树脂打印重量。

扳手为 1.5 mm 内六角；锁定扳机双螺母另需薄型 4 mm 扳手，厚度不大于 1.8 mm。建议两种螺钉和 M2 螺母各备少量备用件。

复位弹簧沿用首样参考规格：外径 4、线径 0.3、自由长 15 mm。供应商应确认在机构工作长度下的载荷与并圈高度；首件验证回弹后固定同一规格。

## 打印订单

送印 `generated/onepiece-print.stl`，完整打印件和可剪连接桥一起计重。30 g 是送印件门槛，不包含购买的电池、电路板与金属紧固件；材料参数、支撑计重和打印后实称按 [printing.md](printing.md) 核对。
