guiwushengzhe-prog/gun-mouse/experiments/evt1-light-shell/generated/renders-inside/inside-left.png

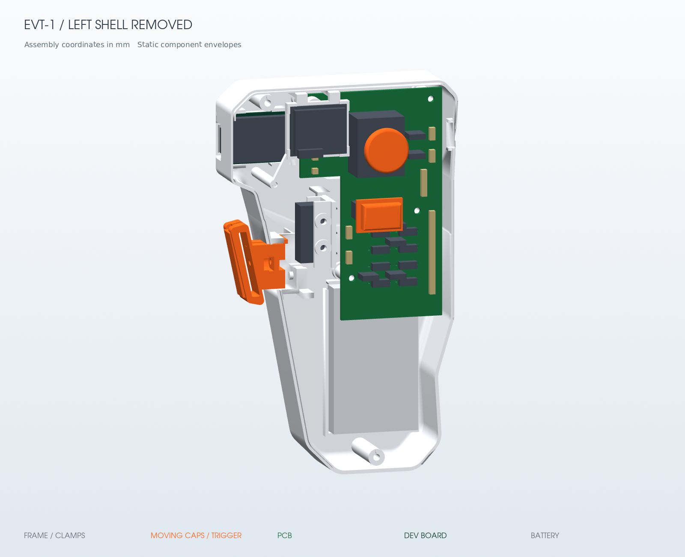
experiments/evt1-light-shell/generated/renders-inside/inside-left.png
