guiwushengzhe-prog/gun-mouse/experiments/evt1-light-shell/generated/renders/outside-front.png

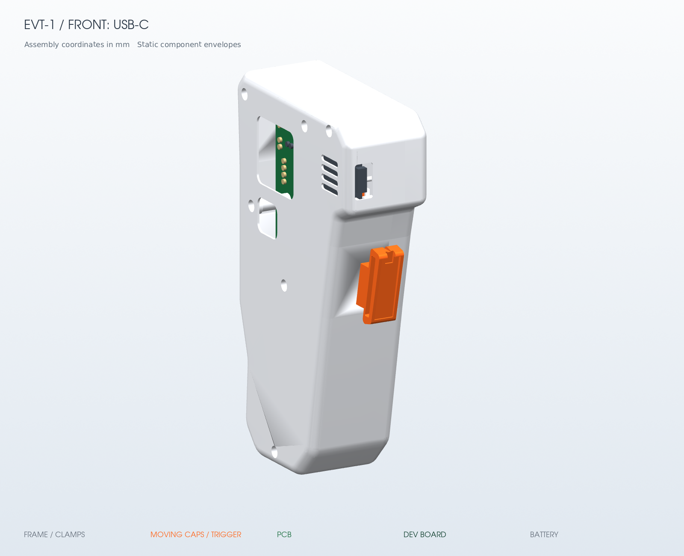
experiments/evt1-light-shell/generated/renders/outside-front.png
