guiwushengzhe-prog/gun-mouse/experiments/evt1-light-shell/generated/renders/outside-right.png

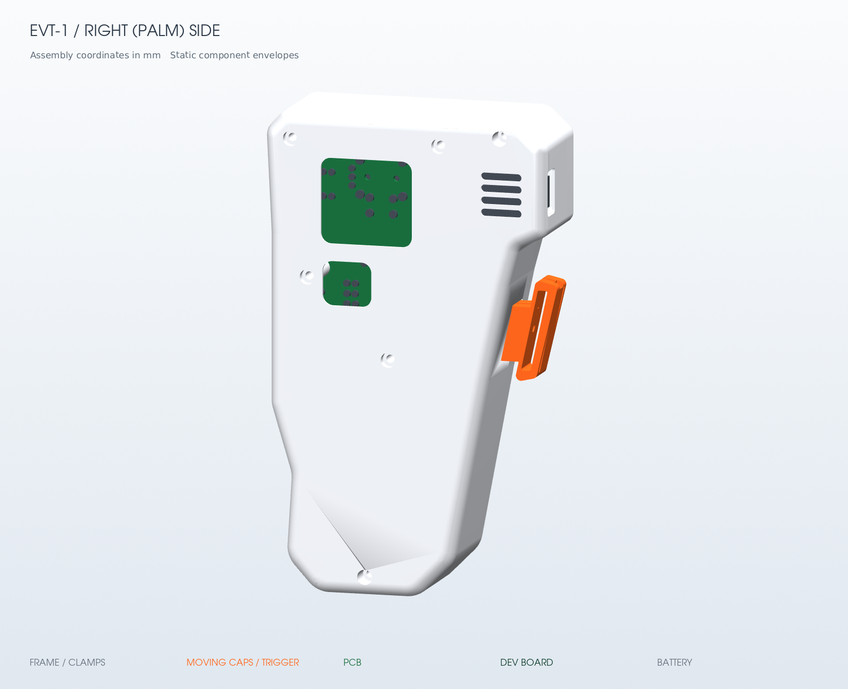
experiments/evt1-light-shell/generated/renders/outside-right.png
