guiwushengzhe-prog/gun-mouse/pcb/carrier-assembly-map-1to1.pdf

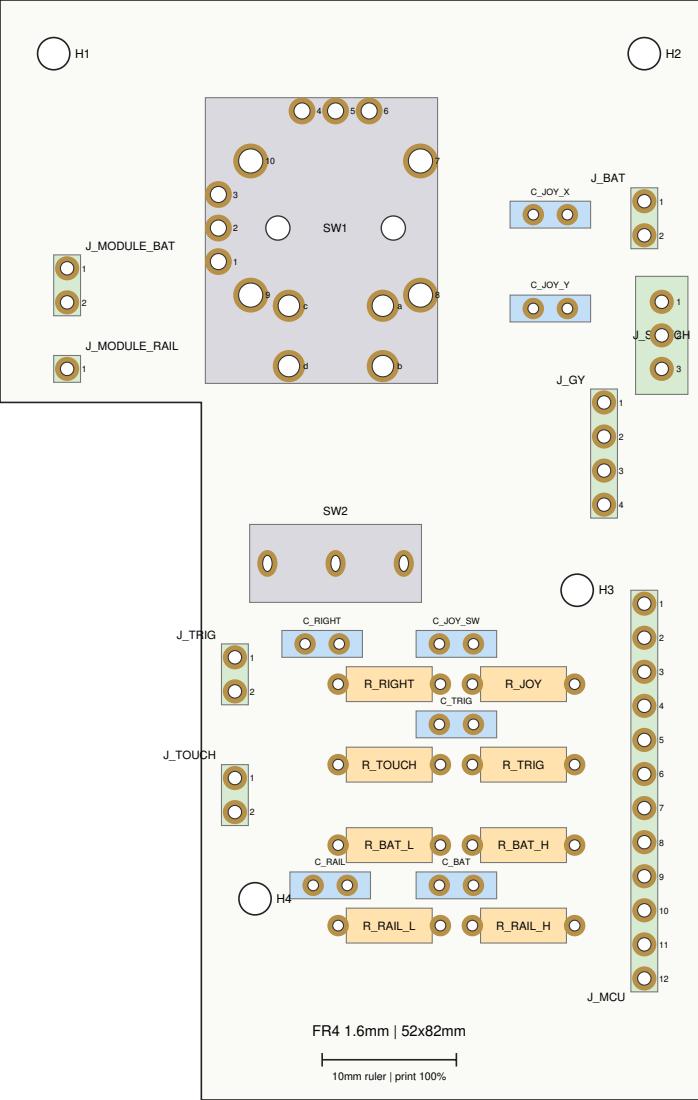
[picture p122: page 1]
J_MCU; J_TRIG; J_TOUCH; J_BAT; J_SWITCH; J_MODULE_BAT; J_MODULE_RAIL; R_RIGHT; R_JOY; R_TOUCH; R_TRIG; R_BAT_L; R_BAT_H; R_RAIL_L; R_RAIL_H; C_JOY_X; C_JOY_Y; C_RIGHT; C_JOY_SW; C_TRIG; C_RAIL; C_BAT; 10mm ruler | print 100%
