guiwushengzhe-prog/gun-mouse/器件资料/参考图纸/ESP32-S3/YD-ESP32-S3-电路图-V1.4.pdf

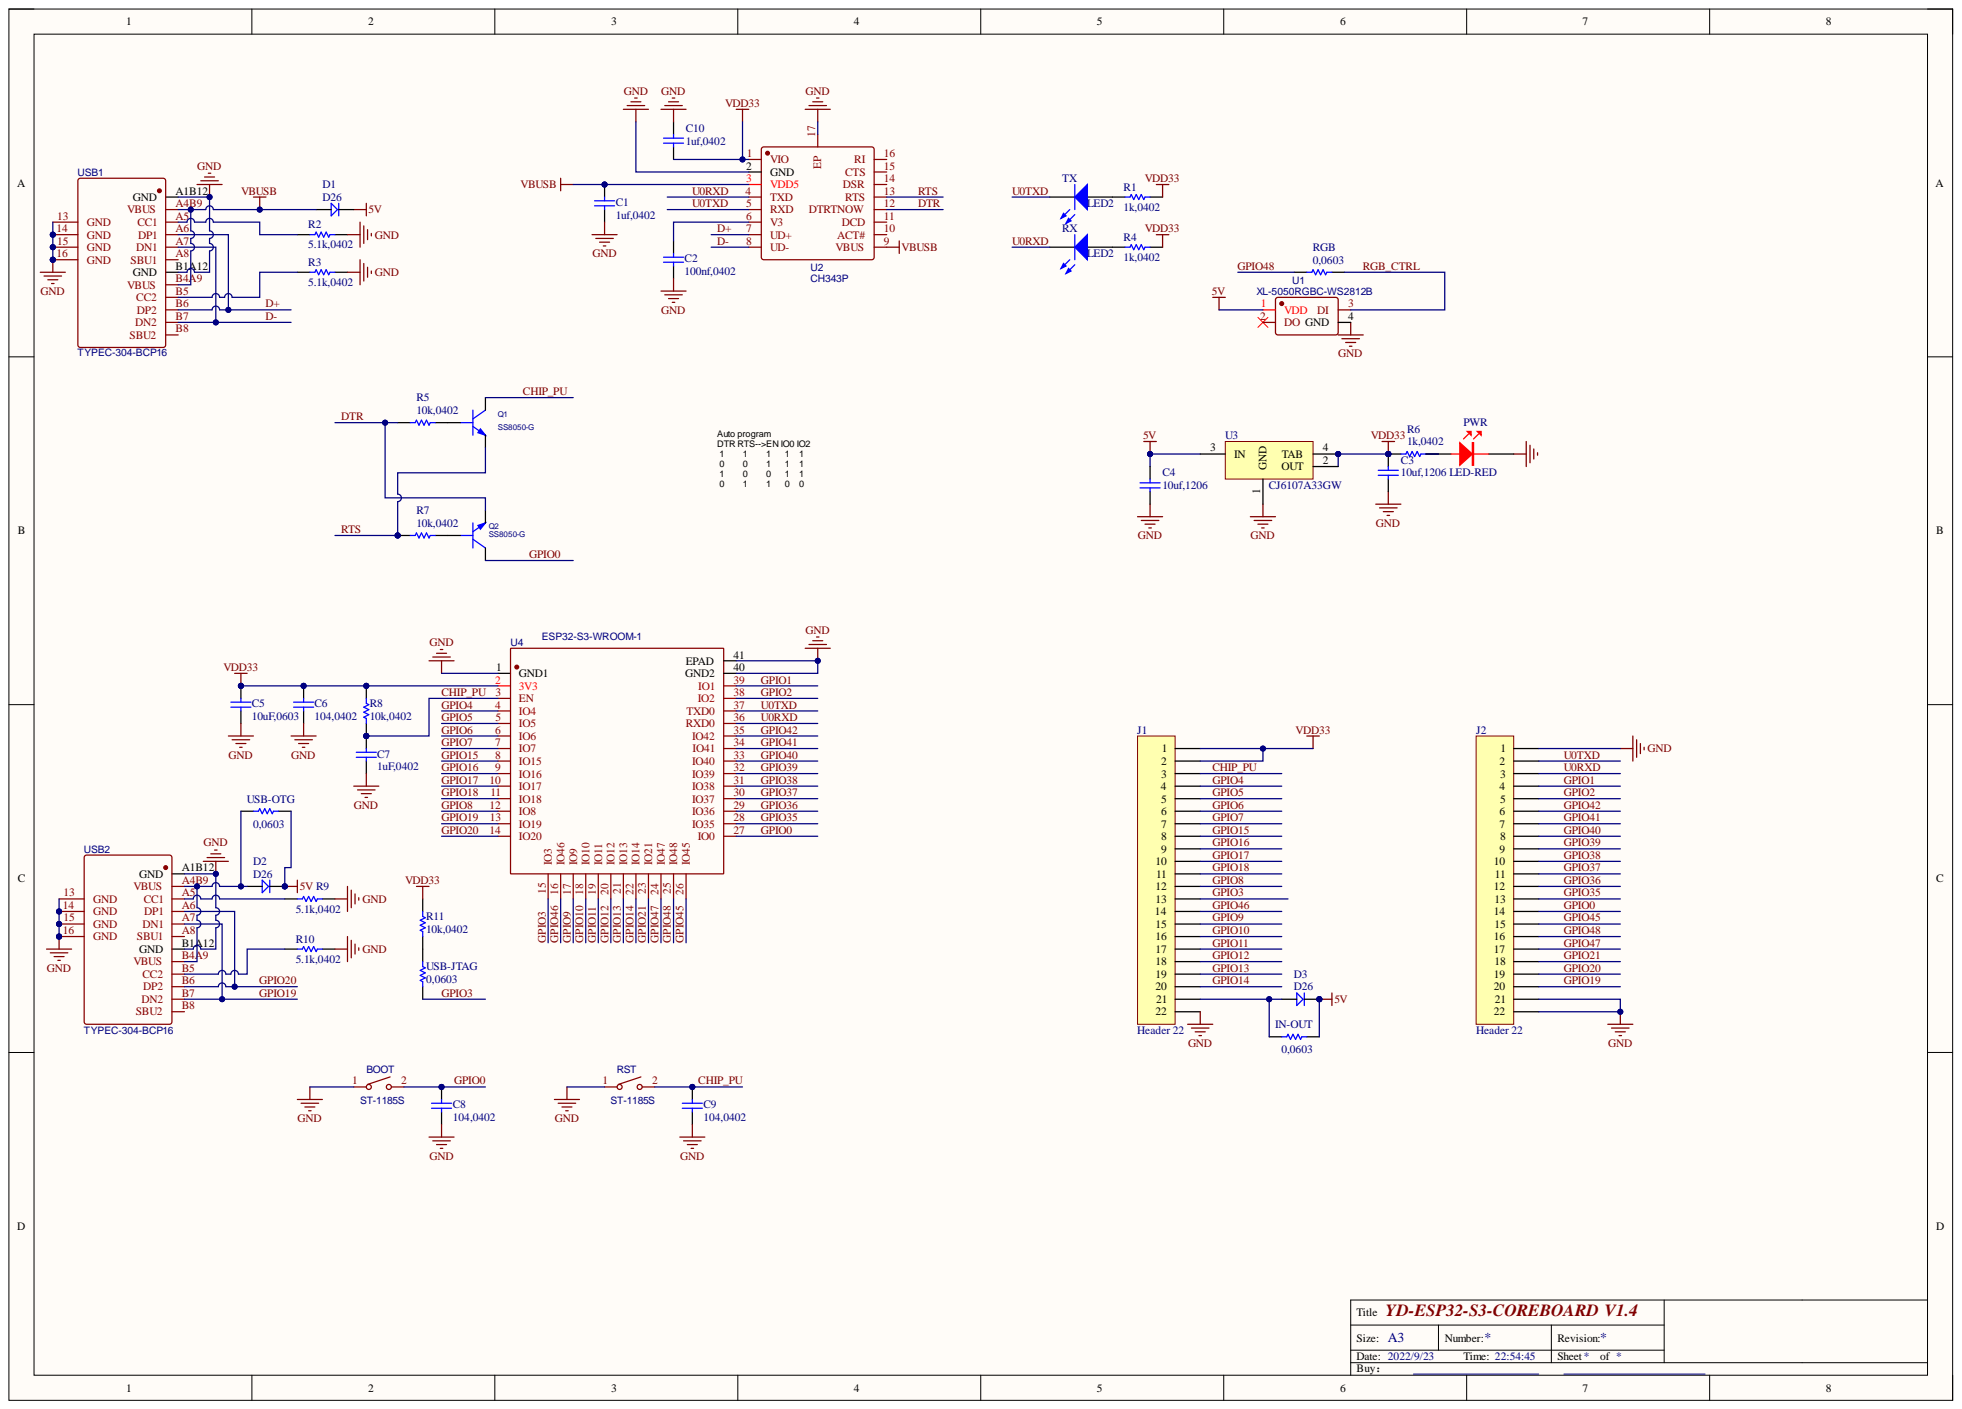
[picture p123: page 1]
