guiwushengzhe-prog/gun-mouse/(list of files, drawings)

Other design files:
config/pcb-parts-geometry.json
config/pcb-shell-v1.json
deliverables/pcb-shell-v1/验证记录/pcb-build-report.json
deliverables/pcb-shell-v1/验证记录/schematic-netlist-handoff-report.json
evidence/formal-validation/pcb-shell-current-export-report.json
