guiwushengzhe-prog/gun-mouse/release/2026-10-18-最终版/电路板/迁移前对照/gunmouse-final.kicad_pcb

## KiCad design release/2026-10-18-最终版/电路板/迁移前对照/gunmouse-final.kicad_pcb (2026-10-18)

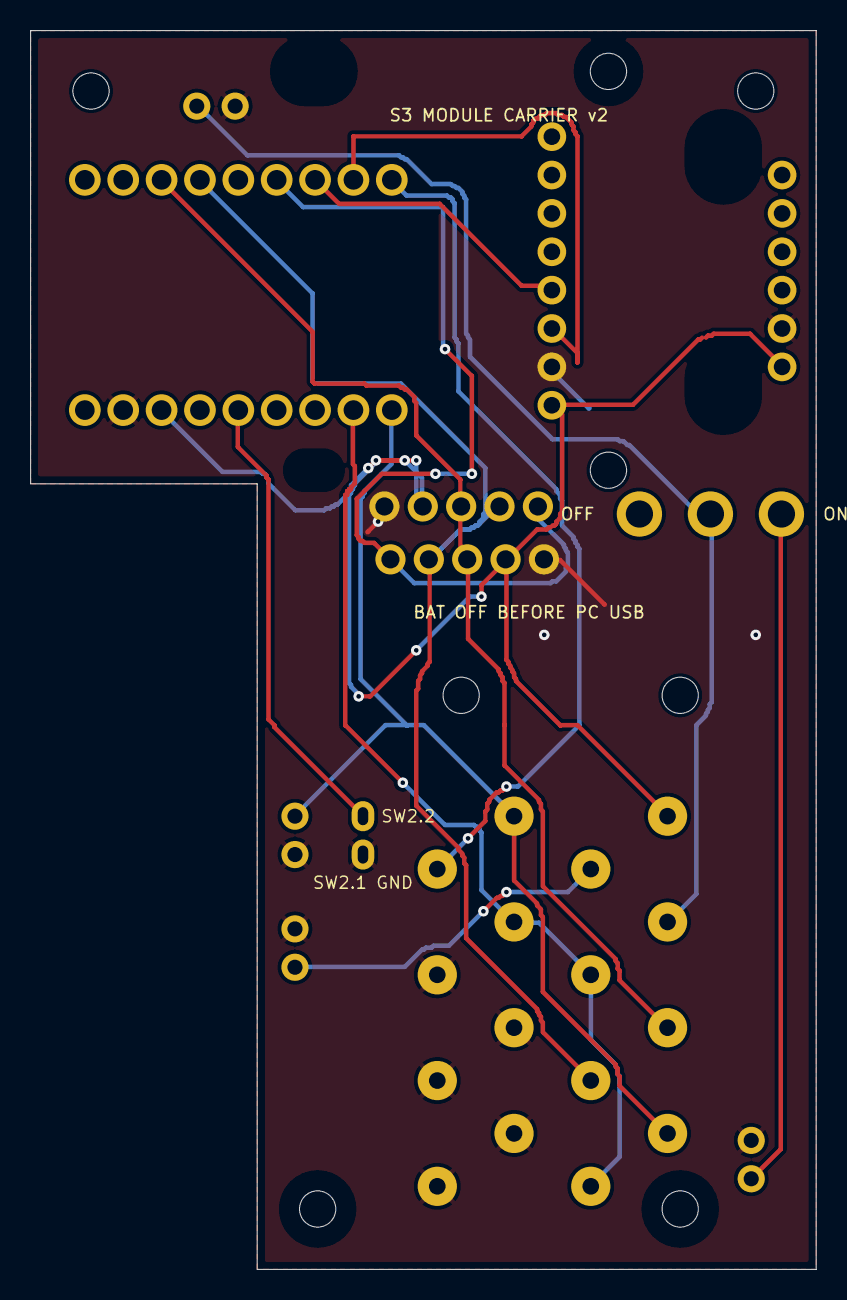
[picture p124: board gunmouse-final.kicad_pcb from above]

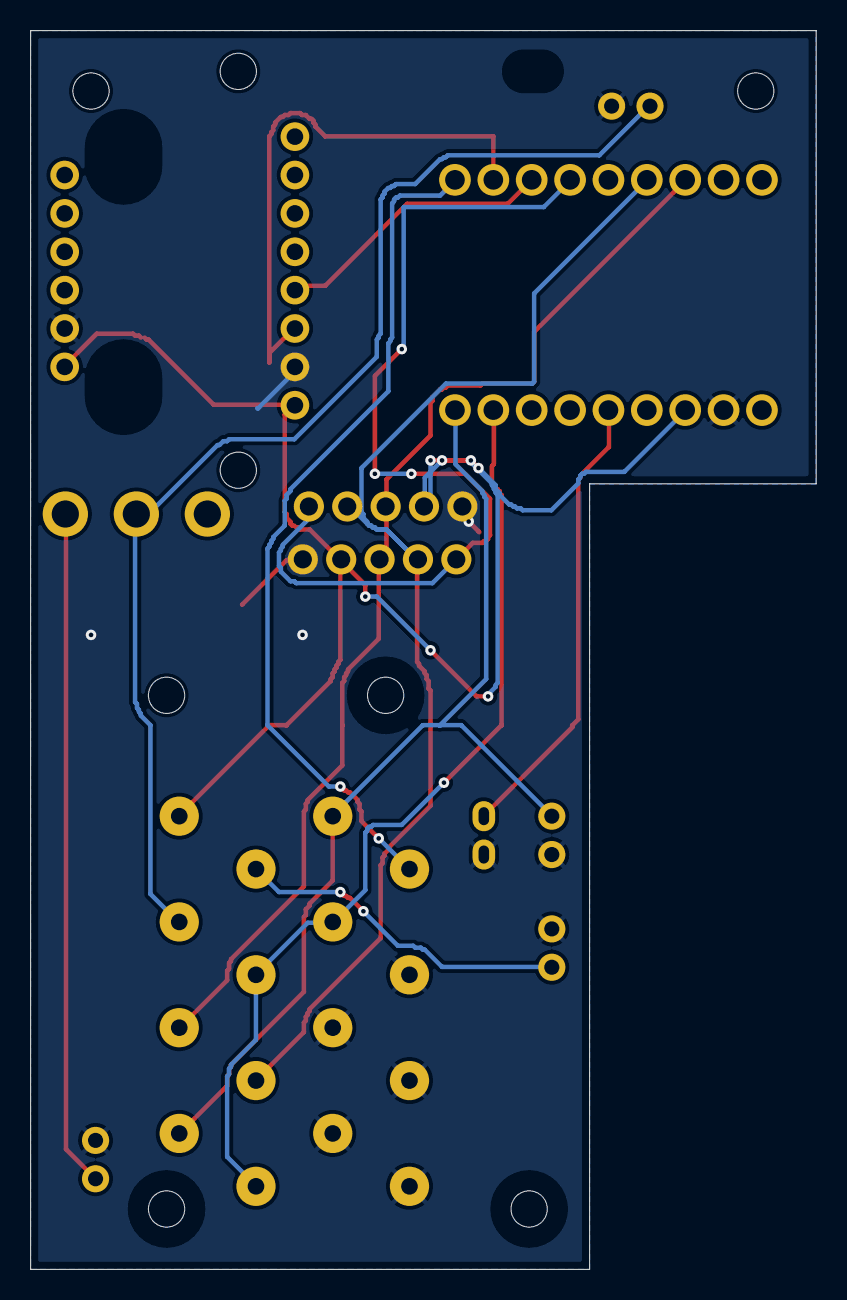
[picture p125: board gunmouse-final.kicad_pcb from below]

Board: 2 copper layers, 52.0 x 82.0 mm, 26 parts (16 on the bottom side), 14 nets.

Parts:
C_BAT: 100n; C_BAT
C_JOY_X: 100n; C_JOY_X
C_JOY_Y: 100n; C_JOY_Y
C_TRIG: 100n; C_TRIG
H1, H2, H3, H4: M2 clearance 2.4 mm; Mount_M2
H_BODY_5: (no value)
H_IMU_1, H_IMU_2: (no value)
H_JOY_LOCAL_2: (no value)
J_BAT: Labelled solder wires; J_BAT
J_GY: GY-601N1-LSM6DSV16X 8+6; J_GY
J_MCU: ESP32-S3 SuperMini 2x9; J_MCU
J_MODULE_BAT: Labelled solder wires; J_MODULE_BAT
J_SWITCH: SS12D10 G5; J_SWITCH
J_TOUCH: Labelled solder wires; J_TOUCH
J_TRIG: Labelled solder wires; J_TRIG
R_BAT_H: 100k; R_BAT_H
R_BAT_L: 100k; R_BAT_L
R_TOUCH: 510; R_TOUCH
R_TRIG: 3.3k; R_TRIG
SW1: HW-504 34x26mm; SW1
SW1_ALT: HW-504直排针备用位; SW1_ALT
SW2: 右键软线接点; SW2

Connections:
3V3: J_GY.1, J_GY.14, J_MCU.12, R_TRIG.1, SW1.2, SW1_ALT.4
BAT_RAW: J_BAT.1, J_SWITCH.1
BAT_SW: J_MODULE_BAT.1, J_SWITCH.2, R_BAT_H.1
BTN_R: J_MCU.14, SW2.2
GND: C_BAT.2, C_JOY_X.2, C_JOY_Y.2, C_TRIG.2, J_BAT.2, J_GY.2, J_GY.13, J_MCU.11, J_MODULE_BAT.2, J_TOUCH.2, J_TRIG.1, R_BAT_L.2, SW1.1, SW1_ALT.5, SW2.1
JOY_SW: J_MCU.6, SW1.5, SW1_ALT.1
JOY_X: C_JOY_X.1, J_MCU.3, SW1.3, SW1_ALT.3
JOY_Y: C_JOY_Y.1, J_MCU.4, SW1.4, SW1_ALT.2
SCL: J_GY.3, J_MCU.8
SDA: J_GY.4, J_MCU.7
TOUCH: J_MCU.9, R_TOUCH.2
TOUCH_ELECTRODE: J_TOUCH.1, R_TOUCH.1
TRIG: C_TRIG.1, J_MCU.18, J_TRIG.2, R_TRIG.2
VBAT_ADC: C_BAT.1, J_MCU.17, R_BAT_H.2, R_BAT_L.1
