guiwushengzhe-prog/gun-mouse/(commit log)

2026-10-04 记录电路板与外壳自动化工具要求
2026-10-04 安装并验证电路板与外壳的程序联动工具
2026-10-04 配置可复用的原生板壳三维查看与自动刷新
2026-10-05 记录触摸扳机方案、器件参数并更新原型效果图
2026-10-05 整理器件原始资料、采用图纸尺寸并确认坐标和触摸原型路线
2026-10-05 制作内部布局、分解与触摸线束原型，省去TTP223
2026-10-05 保存其他AI的PCB与外壳原始成果，作为收尾基线
2026-10-05 收尾PCB与外壳交付，修复原理图及自动化调用并保留验证边界
2026-10-05 验证原生覆铜及布线兼容流程，保留正式设计并记录调用边界
2026-10-05 验证正式PCB程序读写、双面覆铜及外壳装配，保留原方案
2026-10-05 修复原生布线极短线写回并核对制造铜层，补充装配审核提示词
2026-10-05 按原始字节保存验证证据并核对全部校验值
2026-10-05 合并工具修复后补充 Astra 实物与制造审核要求
2026-10-05 完成设计预审与装配优化候选，集中后续审核范围
2026-10-06 工程样 EVT-A：可调扳机触点、硬限位归右半壳与下单文件
    - 扳机触点改为 M2 外六角螺栓头，组装时用 0.8/1.0/1.2 mm 设定片在右半壳上设定余行程
    - 扳机硬限位块整块归右半壳，左半壳让开 0.3 mm；右键背后加 3 根支撑柱；右键帽改为以开关自身到底为终点
    - 下单文件仅改 R3 为 6.8k（充电约 176 mA）、R5 为 10k，Gerber 与正式版逐字节一致
    - 附几何自检、设定示意图、个人下单与组装说明，以及复审结论文档
    - 正式配置与 EDA 工程保持基线不变，改板时再合并 config/evt-a.json 的物料差异
2026-10-06 正式板完整固件与复审意见修正
    - 新增 firmware/gun_mouse：惯性芯片驱动与非阻塞零偏校准、扳机触摸检测、三键去抖与事件队列、摇杆两端归一化、蓝牙鼠标、电量与低电保护、串口设置命令；交互核心移入固件目录并增加分量与首帧标记
    - 偏航按重力竖直方向计算，俯仰用芯片 Z 轴（整机左向），不依赖芯片在板上的 X/Y 朝向
    - 电脑逻辑检查 37 项与原交互核心检查通过；arduino-cli 编译通过，烧录文件在 deliverables/evt-a/固件
    - 右键帽改为帽沿独立限位，到底停在开关外壳顶面之上 0.05 mm，自检确认不压外壳
    - 关机注入电流与充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
2026-10-06 准备经济型部分贴装候选与同型号采购降本说明
2026-10-06 新增便宜扳机开关工厂代焊版并核对电路与外壳
2026-10-06 Reduce unused parts and charge indicator; require economy assembly
2026-10-06 单板经济型：取消扳机小板改自焊开关支架，恢复充电灯，降本换料与市售调节螺钉
    - 新原生工程 gun-mouse-economy-single-v4（由单主板 v2 复制，只改属性）：R12/C7/C8 不装，LED1/R4 恢复，R3 改与 R1/R2 同料 5.1k（约235mA），U4 改 SRV05-4/C7420376；规则检查0项，46器件引脚网络与正式板一致，Gerber 与 v2 逐层一致。
    - 扳机开关 SS-01GL 用户自焊于打印支架，支架进原小板槽，开关位置与工厂版相同；修正原支架出线细桥与焊片窗宽度。
    - 调节触点由难买的 M2 外六角螺栓改为 M2×10 内六角圆柱头螺钉：扳机头槽加深至 X=1.7，导孔加长至 11.8，调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
2026-10-06 支架固定螺钉可用杯头内六角：核对头部间隙并更新采购说明
2026-10-06 统一螺丝为 M2 杯头内六角两种长度；J3～J5 不装改为直接焊线
    - 合壳 PA2×20 → M2×20、GY 压框 PA2×10 → M2×10、开关支架 M2×16 → M2×20，均为杯头内六角；导孔 Ø1.7 不变，打印件不改。新增 check_unified_screws.py：合壳杯头落在沉孔内，压框螺丝头不碰左壳/开发板/主板/摇杆，支架加长段不碰壳体、主板、尾线与扳机全行程。
    - J3/J4/J5（同一扩展料 C295747）不装，电池、扳机开关、触摸线直接焊焊盘，免一种换料费；SW3 对新手焊接困难，保留工厂焊。物料 20 组/每套 37 件，规则检查 0 项。
    - README 写入电池逐线焊接与正负极判定步骤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
2026-10-06 修复嘉立创坐标文件的原生表头格式
2026-10-06 U4 不装：免换料 SRV05-4 国内缺货，按实际报价更新费用
    - U4 设为不装（属性恢复原 USBLC6-2SC6/C7519，便于以后补焊）；板上 1–6、3–4 脚有铜线直连，不影响 USB 充电与下载，失去 USB 口静电保护。规则检查 0 项，物料 19 组/每套 36 件。
    - README 按下单页实际报价更新：元件 41.75、加工 147.2（删 U4 后约 147.08），无 X 光与钢网费；说明插装费含义、SMT 与 PCB 分单计费、LED1 封装提示可确认。
    - build_single_handoff 在机构未改时沿用已提交的机构核对报告，仍逐件校验打印件。
2026-10-06 补充扳机压簧与铜箔采购项，细化扳机装入步骤
2026-10-07 experiment: add one-piece breakaway connector geometry
2026-10-07 experiment: build 30g SuperMini hand-soldered open-frame prototype
2026-10-07 EVT-1 light shell: closed grip, front USB-C, SS-01GL trigger
    New experiments/evt1-light-shell built on the 30 g SuperMini carrier
    (same PCB and firmware):
    - two shell halves (closed 1.0 mm grip, 0.8 mm windowed upper body)
    plus 6 small parts, exported as separate STLs (no sprue tree)
    - SuperMini turned 180 deg into the nose: USB-C reachable from the
    front (the 30 g frame blocks a standard plug); vent slots for the
    charger; BOOST charging procedure in the README
    - trigger contact and holder moved to SS-01GL datums (economy build)
    - battery enclosed in the grip, embedded slide switch, GY cradle that
    also clamps carrier hole H1, right cap without outer lip
    - 9 screws / 10 nuts instead o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
2026-10-07 Thicken EVT-1 touch cover to 1.5 mm; point root README to EVT-1
    - touch_cover: 0.9 mm plate was rejected by the print shop's size check;
    now 1.5 mm normal thickness, grown outward (inner face and trigger
    unchanged), rounded outer edges; regenerated STEP/STL and re-ran the
    full EVT-1 verification (all pass)
    - EVT-1 README: new weights, reference quote, cover note and tape fallback
    - root README: EVT-1 is the current recommended build
    Claude-Session: https://claude.ai/code/session_01Akc74FgvK51LqmTpf9UFLE
2026-10-07 30g 载板：增加嘉立创EDA原生导出的 Gerber
    用嘉立创EDA专业版 v4.1.66 导入 KiCad 载板后原生导出，供嘉立创下单用。
    逐层比对：铜层、阻焊、板框和 90 个钻孔与 KiCad 版一致；6 个非金属化孔
    在铜层上多了与孔径等大的铜盘，钻孔时会被钻掉。EDA 默认字体同字号偏小，
    丝印字号统一放大，实际字高约 0.86 mm（原版 0.8 mm），位置不变。
    同时提交 EDA 工程，并在产物清单里登记新文件、更新制造说明哈希。
2026-10-07 Drop the printed touch cover; copper foil tape goes in the trigger recess
    The 0.9 mm and 1.5 mm touch covers both failed the print shop's size
    check. The cover is removed from the print set; the copper foil tape is
    stuck straight into the trigger's existing 1.05 mm recess and covered
    with clear or polyimide tape. Trigger, shells and other STLs are
    unchanged (byte-identical to the files already uploaded). READMEs
    updated: 7 printed parts, 39.8 cm3.
    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
2026-10-12 只保留最终版：载板 PCB、EVT-1 外壳与 SuperMini 固件
    - pcb/：S3 THT 载板的 Gerber（KiCad 与嘉立创两版）、KiCad/嘉立创工程、BOM、焊线表、装配图、电气复核和元件资料
    - shell/：EVT-1 轻壳 7 个打印件的 STL/STEP，采购、装配、扳机校准与充电说明合并为一份
    - firmware/：SuperMini 固件源码、编译镜像和构建脚本，路径改为读取 pcb/carrier-config.json
    - 删除经济型主板、PCB 与外壳 V1、EVT-A、30 g 开放骨架、概念图、旧脚本和旧资料；需要时从 e2848bd 取回
2026-10-15 第二代：修正摇杆孔位，增加板载电源和开放底座，交付OBJ模型
2026-10-15 增加第二代完整装配STL
2026-10-15 新增第二代外壳三色预览工程
2026-10-15 修正第二代外壳三色预览的板卡位置与配色
2026-10-15 为第二代装配预览标注器件名称和类别颜色
2026-10-16 更新模块直插结构与完整装配预览模型
2026-10-16 调整摇杆朝上姿态及电池中线装配预览
2026-10-16 按摇杆尺寸增加M2无垫片两孔固定座
2026-10-16 纠正摇杆与主板元件的安装面并更新装配模型
2026-10-16 缩短挡手的H2固定柱并调整近板连接
2026-10-16 精简供电监测与按键元件并扩大手焊焊盘
2026-10-16 以开窗框筋与根部加强筋增强电池托架
2026-10-16 完成第二代真实铜层与手焊导线装配模型
2026-10-16 按实物对调扳机端蓝黑导线
2026-10-17 换侧保护支架并采用每行一颗的宽间距手焊布局
2026-10-17 预留摇杆直插焊孔并同步完整装配模型
2026-10-17 用共用穿板孔和背侧深梁加强摇杆支座
2026-10-17 预览独立摇杆支座与侧置原生右键
2026-10-17 摇杆支座就近穿板固定并下移中指右键
2026-10-17 右键改为SS-01直压开关并使用双M2固定
2026-10-17 移除上部框架并重排电源开关和惯性模块固定孔
2026-10-17 封闭旧开关窗口并加固独立摇杆支座预览
2026-10-17 将摇杆支座改为方正托座并找平护板外表面
2026-10-18 规整护板直边和电池托收肩并保留装配避让
2026-10-18 交付已核对打板包和M2十毫米按键适配打印件
2026-10-18 重建规整主体并延长摇杆支座共用固定点同步打板孔位
2026-10-18 新增摇杆内移与整条长方体支座的独立布局预览
2026-10-18 完成长方条正式装配与焊点避让并加入多角度检视及整体重排建议
2026-10-18 完成小元件分区和双主体柱摇杆支座并交付最终打印打板文件
2026-10-18 补平摇杆支座无焊点区域并更新最终打印交付
2026-10-18 将最终主板迁移至嘉立创原生工程并更新配套制板交付
2026-10-18 记录嘉立创优惠券问题与原生重绘交接标准
2026-10-18 在嘉立创空白板重绘最终主板并完成配套制造交付
2026-10-18 记录已下单模型与主板版本并固定制造文件校验值
